leoheck/mangoh-red/datasheet/HTB1M6fvIVXXXXc2XXXXq6xXFXXXB.jpg

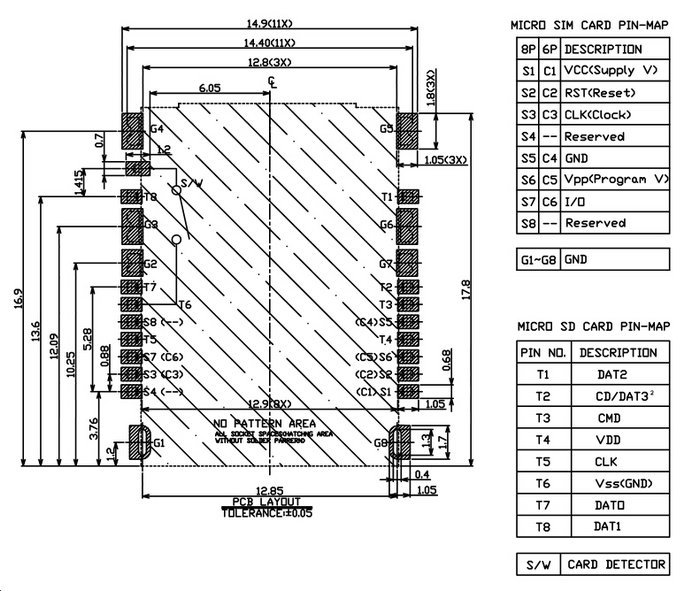
datasheet/HTB1M6fvIVXXXXc2XXXXq6xXFXXXB.jpg
