leoheck/mangoh-red/parts_with_price.csv

Ref | Arena Link | Category | Characteristics | Commodity Class | Created Date | Description | DXDB_LIBNAME | Effective Date | Footprint | Halogen Free | Manufacturer 1 | Manufacturer 1 PN | Manufacturer 2 | Manufacturer 2 PN | Manufacturer 3 | Manufacturer 3 PN | Manufacturer 4 | Manufacturer 4 PN | Manufacturer 5 | Manufacturer 5 PN | Owner | Part Height | Part Status | Rating | Requestor | Revision | RoHS Compliant | Temperature Range | Tolerance | Value | Variant Variable Text | Voltage | Price
ANT1000 | https://agiledev.sierrawireless.local/Agile/object/Parts/3015338 | Antenna |  | ANT - ANTENNAS | 2017-01-31T19:24:40Z | ANTENNA, BLUETOOTH/WLAN/WiFi, 2.4GHz, CERAMIC CHIP, 3.2x1.6x1.1mm | Antenna |  | ANT_3P_0320x0160_W3008C | N/A | TAOGLAS WLA.01 | WLA.01 |  |  |  |  |  |  |  |  |  | 1.1mm | Prototype |  | Ashish Syal | 1 | N/A | -40 +85C |  | WLA.01 |  |  | 0.0
C1000 | https://app.bom.com/a/N5O6P9S9SBU5DYQF?v=files.associations | Capacitor | X7R | PAS - Passives | 2008-08-21T16:59:08-08:00 | CAP, 100nF, 16V, 10%, X7R, CERAMIC, 0402 | Capacitor | 2012-02-01T15:49:25-08:00 | 0402C | N/A | NIC COMPONENTS NMC0402X7R104K16TRPF | NMC0402X7R104K16TRPF | MURATA GRM155R71C104KA88D | GRM155R71C104KA88D | VISHAY VJ0402V104ZXJCW1BC | VJ0402V104ZXJCW1BC |  |  |  |  | Morris Chau | 0.55mm | Production |  | Airlink | 2 | N/A | -55 +125C | 10% | 100nF |  | 16V | 0.0
C1001 | https://app.bom.com/a/VDWEXH0H0J2JWE3S?v=files.associations | Capacitor | X5R | PAS - Passives | 2006-01-26T19:30:31-08:00 | CAP, 470nF, 6.3V, 10%, X5R, CERAMIC, 0402 | Capacitor | 2015-09-02T00:10:34-08:00 | 0402C | N/A | MURATA GRM155R60J474KE19D | GRM155R60J474KE19D | TAIYO YUDEN RM JMK105BJ474KV-F | RM JMK105BJ474KV-F |  |  |  |  |  |  | Morris Chau | 0.55mm | Production |  | Vivutha Men | 1.1 | N/A | -55 +85C | 10% | 470nF |  | 6.3V | 0.0
C1002 | https://app.bom.com/a/N5O6P9S9SBUCLHCA?v=files.associations | Capacitor | C0G | PAS - Passives | 2004-12-21T10:56:53-08:00 | CAP, 10pF, 50V, 5%, C0G, CERAMIC, 0402 | Capacitor | 2012-03-16T13:58:58-08:00 | 0402C | N/A | MURATA GRM1555C1H100JA01D | GRM1555C1H100JA01D | TAIYO YUDEN UMK105CG100JV-F | UMK105CG100JV-F |  |  |  |  |  |  | Morris Chau | 0.55mm | Production |  | Kevin Dotzler | 2 | N/A | -55 +125C | 5% | 10pF | DNI | 50V | 0.0
C1003 | https://app.bom.com/a/N5O6P9S9SBU5DYQF?v=files.associations | Capacitor | X7R | PAS - Passives | 2008-08-21T16:59:08-08:00 | CAP, 100nF, 16V, 10%, X7R, CERAMIC, 0402 | Capacitor | 2012-02-01T15:49:25-08:00 | 0402C | N/A | NIC COMPONENTS NMC0402X7R104K16TRPF | NMC0402X7R104K16TRPF | MURATA GRM155R71C104KA88D | GRM155R71C104KA88D | VISHAY VJ0402V104ZXJCW1BC | VJ0402V104ZXJCW1BC |  |  |  |  | Morris Chau | 0.55mm | Production |  | Airlink | 2 | N/A | -55 +125C | 10% | 100nF |  | 16V | 0.0
C1004 | https://app.bom.com/a/VDWEXH0H0J2JWE3S?v=files.associations | Capacitor | X5R | PAS - Passives | 2006-01-26T19:30:31-08:00 | CAP, 470nF, 6.3V, 10%, X5R, CERAMIC, 0402 | Capacitor | 2015-09-02T00:10:34-08:00 | 0402C | N/A | MURATA GRM155R60J474KE19D | GRM155R60J474KE19D | TAIYO YUDEN RM JMK105BJ474KV-F | RM JMK105BJ474KV-F |  |  |  |  |  |  | Morris Chau | 0.55mm | Production |  | Vivutha Men | 1.1 | N/A | -55 +85C | 10% | 470nF |  | 6.3V | 0.0
C1005 | https://app.bom.com/a/6O7P8SBSBUUI7096?v=files.associations | Capacitor | X5R | PAS - Passives | 2014-03-26T03:32:53-08:00 | CAP, 10uF, 10V, 20%, X5R, CERAMIC, 0603 | Capacitor | 2014-03-26T03:37:12-08:00 | 0603C | N/A | MURATA GRM188R61A106ME69D | GRM188R61A106ME69D |  |  |  |  |  |  |  |  | Morris Chau | 0.95mm | Design |  | Mohamed Ammari | A | N/A | -55 +85C | 20% | 10uF |  | 6.3V | 0.0
C1006 | https://app.bom.com/a/J1K2L5O5O7OCQRFG?v=files.associations | Capacitor | C0G | PAS - Passives | 2011-05-10T11:01:38-08:00 | CAP, 100pF, 50V, 5%, C0G, CERAMIC, 0402 | Capacitor | 2014-04-28T09:22:48-08:00 | 0402C |  | MURATA GRM1555C1H101JA01D | GRM1555C1H101JA01D | TAIYO YUDEN UMK105CG101JV-F | UMK105CG101JV-F |  |  |  |  |  |  | Michael Sorensen | 0.55mm | Production |  | Michael Sorensen | 1 |  | -55 +125C | 5% | 100pF |  | 50V | 0.0
C1007 | https://app.bom.com/a/N5O6P9S9SBU5DYQF?v=files.associations | Capacitor | X7R | PAS - Passives | 2008-08-21T16:59:08-08:00 | CAP, 100nF, 16V, 10%, X7R, CERAMIC, 0402 | Capacitor | 2012-02-01T15:49:25-08:00 | 0402C | N/A | NIC COMPONENTS NMC0402X7R104K16TRPF | NMC0402X7R104K16TRPF | MURATA GRM155R71C104KA88D | GRM155R71C104KA88D | VISHAY VJ0402V104ZXJCW1BC | VJ0402V104ZXJCW1BC |  |  |  |  | Morris Chau | 0.55mm | Production |  | Airlink | 2 | N/A | -55 +125C | 10% | 100nF |  | 16V | 0.0
C1008 | https://app.bom.com/a/HZI0J3M3M55TNBEX?v=files.associations | Capacitor | X5R | PAS - Passives | 2014-03-16T19:32:12-08:00 | CAP, 4.7uF, 6.3V, 20%, X5R, CERAMIC, 0402 | Capacitor | 2014-06-06T08:29:17-08:00 | 0402C | N/A | MURATA GRM155R60J475ME87D | GRM155R60J475ME87D | TAIYO YUDEN JMK105BBJ475MV-F | JMK105BBJ475MV-F |  |  |  |  |  |  | Morris Chau | 0.65mm | Production |  | King Au Yeung | 1 | N/A | -55 +85C | 20% | 4.7uF |  | 6.3V | 0.0
C1009 | https://app.bom.com/a/HZI0J3M3M55TNBEX?v=files.associations | Capacitor | X5R | PAS - Passives | 2014-03-16T19:32:12-08:00 | CAP, 4.7uF, 6.3V, 20%, X5R, CERAMIC, 0402 | Capacitor | 2014-06-06T08:29:17-08:00 | 0402C | N/A | MURATA GRM155R60J475ME87D | GRM155R60J475ME87D | TAIYO YUDEN JMK105BBJ475MV-F | JMK105BBJ475MV-F |  |  |  |  |  |  | Morris Chau | 0.65mm | Production |  | King Au Yeung | 1 | N/A | -55 +85C | 20% | 4.7uF | DNI | 6.3V | 0.0
C1010 | https://app.bom.com/a/UCVDWGZGZI1IUB6T?v=files.associations | Capacitor | X5R | PAS - Passives | 2006-02-03T15:26:24-08:00 | CAP, 2.2uF, 6.3V, 10%, X5R, CERAMIC, 0603 | Capacitor | 2011-12-02T13:52:33-08:00 | 0603C | N/A | TAIYO YUDEN CE JMK107BJ225KA-T | CE JMK107BJ225KA-T | MURATA GRM188R60J225KE19D | GRM188R60J225KE19D |  |  |  |  |  |  | Morris Chau | 0.9mm | Production |  | Mack Tan | 2 | N/A | -55 +85C | 10% | 2.2uF |  | 6.3V | 0.0
C1011 | https://app.bom.com/a/6O7P8SBSBUDMZMOD?v=files.associations | Capacitor | X5R | PAS - Passives | 2009-03-11T13:25:27-08:00 | CAP, 1uF, 10V, 10%, X5R, CERAMIC, 0402 | Capacitor | 2014-03-12T04:39:29-08:00 | 0402C | N/A | MURATA GRM155R61A105KE15D | GRM155R61A105KE15D | TAIYO YUDEN LMK105BJ105KV-F | LMK105BJ105KV-F |  |  |  |  |  |  | Morris Chau | 0.55mm | Production |  | Kristi Eng | 2 | N/A | -55 +85C | 10% | 1uF |  | 10V | 0.0
C1012 | https://app.bom.com/a/N5O6P9S9SBU5DYQF?v=files.associations | Capacitor | X7R | PAS - Passives | 2008-08-21T16:59:08-08:00 | CAP, 100nF, 16V, 10%, X7R, CERAMIC, 0402 | Capacitor | 2012-02-01T15:49:25-08:00 | 0402C | N/A | NIC COMPONENTS NMC0402X7R104K16TRPF | NMC0402X7R104K16TRPF | MURATA GRM155R71C104KA88D | GRM155R71C104KA88D | VISHAY VJ0402V104ZXJCW1BC | VJ0402V104ZXJCW1BC |  |  |  |  | Morris Chau | 0.55mm | Production |  | Airlink | 2 | N/A | -55 +125C | 10% | 100nF |  | 16V | 0.0
C1013 | https://app.bom.com/a/6O7P8SBSBUUI7096?v=files.associations | Capacitor | X5R | PAS - Passives | 2014-03-26T03:32:53-08:00 | CAP, 10uF, 10V, 20%, X5R, CERAMIC, 0603 | Capacitor | 2014-03-26T03:37:12-08:00 | 0603C | N/A | MURATA GRM188R61A106ME69D | GRM188R61A106ME69D |  |  |  |  |  |  |  |  | Morris Chau | 0.95mm | Design |  | Mohamed Ammari | A | N/A | -55 +85C | 20% | 10uF |  | 6.3V | 0.0
C1014 | https://app.bom.com/a/N5O6P9S9SBU5DYQF?v=files.associations | Capacitor | X7R | PAS - Passives | 2008-08-21T16:59:08-08:00 | CAP, 100nF, 16V, 10%, X7R, CERAMIC, 0402 | Capacitor | 2012-02-01T15:49:25-08:00 | 0402C | N/A | NIC COMPONENTS NMC0402X7R104K16TRPF | NMC0402X7R104K16TRPF | MURATA GRM155R71C104KA88D | GRM155R71C104KA88D | VISHAY VJ0402V104ZXJCW1BC | VJ0402V104ZXJCW1BC |  |  |  |  | Morris Chau | 0.55mm | Production |  | Airlink | 2 | N/A | -55 +125C | 10% | 100nF |  | 16V | 0.0
C1015 | https://app.bom.com/a/DVEWFZIZI1I6KLAM?v=files.associations | Capacitor | X7R | PAS - Passives | 2011-05-10T11:00:32-08:00 | CAP, 470pF, 50V, 10%, X7R, CERAMIC, 0402 | Capacitor | 2015-06-16T18:03:21-08:00 | 0402C |  | MURATA GRM155R71H471KA01D | GRM155R71H471KA01D | TAIYO YUDEN UMK105BJ471KV-F | UMK105BJ471KV-F |  |  |  |  |  |  | Michael Sorensen | 0.55mm | Production |  | Michael Sorensen | 1 |  | -55 +125C | 10% | 470pF |  | 50V | 0.0
C1016 | https://app.bom.com/a/6O7P8SBSBUDMZMOD?v=files.associations | Capacitor | X5R | PAS - Passives | 2009-03-11T13:25:27-08:00 | CAP, 1uF, 10V, 10%, X5R, CERAMIC, 0402 | Capacitor | 2014-03-12T04:39:29-08:00 | 0402C | N/A | MURATA GRM155R61A105KE15D | GRM155R61A105KE15D | TAIYO YUDEN LMK105BJ105KV-F | LMK105BJ105KV-F |  |  |  |  |  |  | Morris Chau | 0.55mm | Production |  | Kristi Eng | 2 | N/A | -55 +85C | 10% | 1uF |  | 10V | 0.0
C1017 | https://app.bom.com/a/6O7P8SBSBUUI7096?v=files.associations | Capacitor | X5R | PAS - Passives | 2014-03-26T03:32:53-08:00 | CAP, 10uF, 10V, 20%, X5R, CERAMIC, 0603 | Capacitor | 2014-03-26T03:37:12-08:00 | 0603C | N/A | MURATA GRM188R61A106ME69D | GRM188R61A106ME69D |  |  |  |  |  |  |  |  | Morris Chau | 0.95mm | Design |  | Mohamed Ammari | A | N/A | -55 +85C | 20% | 10uF |  | 6.3V | 0.0
C1018 | https://app.bom.com/a/6O7P8SBSBUDMZMOD?v=files.associations | Capacitor | X5R | PAS - Passives | 2009-03-11T13:25:27-08:00 | CAP, 1uF, 10V, 10%, X5R, CERAMIC, 0402 | Capacitor | 2014-03-12T04:39:29-08:00 | 0402C | N/A | MURATA GRM155R61A105KE15D | GRM155R61A105KE15D | TAIYO YUDEN LMK105BJ105KV-F | LMK105BJ105KV-F |  |  |  |  |  |  | Morris Chau | 0.55mm | Production |  | Kristi Eng | 2 | N/A | -55 +85C | 10% | 1uF |  | 10V | 0.0
C1019 | https://app.bom.com/a/J1K2L5O5O7OCQRFG?v=files.associations | Capacitor | C0G | PAS - Passives | 2011-05-10T11:01:38-08:00 | CAP, 100pF, 50V, 5%, C0G, CERAMIC, 0402 | Capacitor | 2014-04-28T09:22:48-08:00 | 0402C |  | MURATA GRM1555C1H101JA01D | GRM1555C1H101JA01D | TAIYO YUDEN UMK105CG101JV-F | UMK105CG101JV-F |  |  |  |  |  |  | Michael Sorensen | 0.55mm | Production |  | Michael Sorensen | 1 |  | -55 +125C | 5% | 100pF |  | 50V | 0.0
C1020 | https://app.bom.com/a/N5O6P9S9SBU5DYQF?v=files.associations | Capacitor | X7R | PAS - Passives | 2008-08-21T16:59:08-08:00 | CAP, 100nF, 16V, 10%, X7R, CERAMIC, 0402 | Capacitor | 2012-02-01T15:49:25-08:00 | 0402C | N/A | NIC COMPONENTS NMC0402X7R104K16TRPF | NMC0402X7R104K16TRPF | MURATA GRM155R71C104KA88D | GRM155R71C104KA88D | VISHAY VJ0402V104ZXJCW1BC | VJ0402V104ZXJCW1BC |  |  |  |  | Morris Chau | 0.55mm | Production |  | Airlink | 2 | N/A | -55 +125C | 10% | 100nF |  | 16V | 0.0
C1021 | https://app.bom.com/a/6O7P8SBSBUDMZMOD?v=files.associations | Capacitor | X5R | PAS - Passives | 2009-03-11T13:25:27-08:00 | CAP, 1uF, 10V, 10%, X5R, CERAMIC, 0402 | Capacitor | 2014-03-12T04:39:29-08:00 | 0402C | N/A | MURATA GRM155R61A105KE15D | GRM155R61A105KE15D | TAIYO YUDEN LMK105BJ105KV-F | LMK105BJ105KV-F |  |  |  |  |  |  | Morris Chau | 0.55mm | Production |  | Kristi Eng | 2 | N/A | -55 +85C | 10% | 1uF |  | 10V | 0.0
C1022 | https://app.bom.com/a/UCVDWGZGZI1IUB6T?v=files.associations | Capacitor | X5R | PAS - Passives | 2006-02-03T15:26:24-08:00 | CAP, 2.2uF, 6.3V, 10%, X5R, CERAMIC, 0603 | Capacitor | 2011-12-02T13:52:33-08:00 | 0603C | N/A | TAIYO YUDEN CE JMK107BJ225KA-T | CE JMK107BJ225KA-T | MURATA GRM188R60J225KE19D | GRM188R60J225KE19D |  |  |  |  |  |  | Morris Chau | 0.9mm | Production |  | Mack Tan | 2 | N/A | -55 +85C | 10% | 2.2uF |  | 6.3V | 0.0
C1023 | https://app.bom.com/a/UCVDWGZGZI1IUB6T?v=files.associations | Capacitor | X5R | PAS - Passives | 2006-02-03T15:26:24-08:00 | CAP, 2.2uF, 6.3V, 10%, X5R, CERAMIC, 0603 | Capacitor | 2011-12-02T13:52:33-08:00 | 0603C | N/A | TAIYO YUDEN CE JMK107BJ225KA-T | CE JMK107BJ225KA-T | MURATA GRM188R60J225KE19D | GRM188R60J225KE19D |  |  |  |  |  |  | Morris Chau | 0.9mm | Production |  | Mack Tan | 2 | N/A | -55 +85C | 10% | 2.2uF |  | 6.3V | 0.0
C1024 | https://app.bom.com/a/UCVDWGZGZI1IUB6T?v=files.associations | Capacitor | X5R | PAS - Passives | 2006-02-03T15:26:24-08:00 | CAP, 2.2uF, 6.3V, 10%, X5R, CERAMIC, 0603 | Capacitor | 2011-12-02T13:52:33-08:00 | 0603C | N/A | TAIYO YUDEN CE JMK107BJ225KA-T | CE JMK107BJ225KA-T | MURATA GRM188R60J225KE19D | GRM188R60J225KE19D |  |  |  |  |  |  | Morris Chau | 0.9mm | Production |  | Mack Tan | 2 | N/A | -55 +85C | 10% | 2.2uF |  | 6.3V | 0.0
C1025 | https://app.bom.com/a/HZI0J3M3M55TNBEX?v=files.associations | Capacitor | X5R | PAS - Passives | 2014-03-16T19:32:12-08:00 | CAP, 4.7uF, 6.3V, 20%, X5R, CERAMIC, 0402 | Capacitor | 2014-06-06T08:29:17-08:00 | 0402C | N/A | MURATA GRM155R60J475ME87D | GRM155R60J475ME87D | TAIYO YUDEN JMK105BBJ475MV-F | JMK105BBJ475MV-F |  |  |  |  |  |  | Morris Chau | 0.65mm | Production |  | King Au Yeung | 1 | N/A | -55 +85C | 20% | 4.7uF |  | 6.3V | 0.0
C1026 | https://app.bom.com/a/J1K2L5O5O7OCQRFG?v=files.associations | Capacitor | C0G | PAS - Passives | 2011-05-10T11:01:38-08:00 | CAP, 100pF, 50V, 5%, C0G, CERAMIC, 0402 | Capacitor | 2014-04-28T09:22:48-08:00 | 0402C |  | MURATA GRM1555C1H101JA01D | GRM1555C1H101JA01D | TAIYO YUDEN UMK105CG101JV-F | UMK105CG101JV-F |  |  |  |  |  |  | Michael Sorensen | 0.55mm | Production |  | Michael Sorensen | 1 |  | -55 +125C | 5% | 100pF |  | 50V | 0.0
C1027 | https://app.bom.com/a/N5O6P9S9SBUCLHCA?v=files.associations | Capacitor | C0G | PAS - Passives | 2004-12-21T10:56:53-08:00 | CAP, 10pF, 50V, 5%, C0G, CERAMIC, 0402 | Capacitor | 2012-03-16T13:58:58-08:00 | 0402C | N/A | MURATA GRM1555C1H100JA01D | GRM1555C1H100JA01D | TAIYO YUDEN UMK105CG100JV-F | UMK105CG100JV-F |  |  |  |  |  |  | Morris Chau | 0.55mm | Production |  | Kevin Dotzler | 2 | N/A | -55 +125C | 5% | 10pF |  | 50V | 0.0
C1028 | https://app.bom.com/a/N5O6P9S9SBUCLHCA?v=files.associations | Capacitor | C0G | PAS - Passives | 2004-12-21T10:56:53-08:00 | CAP, 10pF, 50V, 5%, C0G, CERAMIC, 0402 | Capacitor | 2012-03-16T13:58:58-08:00 | 0402C | N/A | MURATA GRM1555C1H100JA01D | GRM1555C1H100JA01D | TAIYO YUDEN UMK105CG100JV-F | UMK105CG100JV-F |  |  |  |  |  |  | Morris Chau | 0.55mm | Production |  | Kevin Dotzler | 2 | N/A | -55 +125C | 5% | 10pF |  | 50V | 0.0
C1029 | https://app.bom.com/a/N5O6P9S9SBUCLHCA?v=files.associations | Capacitor | C0G | PAS - Passives | 2004-12-21T10:56:53-08:00 | CAP, 10pF, 50V, 5%, C0G, CERAMIC, 0402 | Capacitor | 2012-03-16T13:58:58-08:00 | 0402C | N/A | MURATA GRM1555C1H100JA01D | GRM1555C1H100JA01D | TAIYO YUDEN UMK105CG100JV-F | UMK105CG100JV-F |  |  |  |  |  |  | Morris Chau | 0.55mm | Production |  | Kevin Dotzler | 2 | N/A | -55 +125C | 5% | 10pF |  | 50V | 0.0
C1030 | https://app.bom.com/a/J1K2L5O5O7OCQRFG?v=files.associations | Capacitor | C0G | PAS - Passives | 2011-05-10T11:01:38-08:00 | CAP, 100pF, 50V, 5%, C0G, CERAMIC, 0402 | Capacitor | 2014-04-28T09:22:48-08:00 | 0402C |  | MURATA GRM1555C1H101JA01D | GRM1555C1H101JA01D | TAIYO YUDEN UMK105CG101JV-F | UMK105CG101JV-F |  |  |  |  |  |  | Michael Sorensen | 0.55mm | Production |  | Michael Sorensen | 1 |  | -55 +125C | 5% | 100pF |  | 50V | 0.0
C1031 | https://app.bom.com/a/N5O6P9S9SBUCLHCA?v=files.associations | Capacitor | C0G | PAS - Passives | 2004-12-21T10:56:53-08:00 | CAP, 10pF, 50V, 5%, C0G, CERAMIC, 0402 | Capacitor | 2012-03-16T13:58:58-08:00 | 0402C | N/A | MURATA GRM1555C1H100JA01D | GRM1555C1H100JA01D | TAIYO YUDEN UMK105CG100JV-F | UMK105CG100JV-F |  |  |  |  |  |  | Morris Chau | 0.55mm | Production |  | Kevin Dotzler | 2 | N/A | -55 +125C | 5% | 10pF |  | 50V | 0.0
C1032 | https://app.bom.com/a/6O7P8SBSBUDMZMOD?v=files.associations | Capacitor | X5R | PAS - Passives | 2009-03-11T13:25:27-08:00 | CAP, 1uF, 10V, 10%, X5R, CERAMIC, 0402 | Capacitor | 2014-03-12T04:39:29-08:00 | 0402C | N/A | MURATA GRM155R61A105KE15D | GRM155R61A105KE15D | TAIYO YUDEN LMK105BJ105KV-F | LMK105BJ105KV-F |  |  |  |  |  |  | Morris Chau | 0.55mm | Production |  | Kristi Eng | 2 | N/A | -55 +85C | 10% | 1uF |  | 10V | 0.0
C1033 | https://app.bom.com/a/J1K2L5O5O7OCQRFG?v=files.associations | Capacitor | C0G | PAS - Passives | 2011-05-10T11:01:38-08:00 | CAP, 100pF, 50V, 5%, C0G, CERAMIC, 0402 | Capacitor | 2014-04-28T09:22:48-08:00 | 0402C |  | MURATA GRM1555C1H101JA01D | GRM1555C1H101JA01D | TAIYO YUDEN UMK105CG101JV-F | UMK105CG101JV-F |  |  |  |  |  |  | Michael Sorensen | 0.55mm | Production |  | Michael Sorensen | 1 |  | -55 +125C | 5% | 100pF |  | 50V | 0.0
C1034 | https://app.bom.com/a/4M5N6Q9Q9SBSJE5I?v=files.associations | Capacitor | C0G | PAS - Passives | 2006-08-30T06:12:56-08:00 | CAP, 1pF, 25V, +/-0.25pF, C0G, CERAMIC, 0201 | Capacitor | 2014-07-24T08:53:06-08:00 | 0201C | N/A | MURATA GRM0335C1E1R0CA01D | GRM0335C1E1R0CA01D | MURATA GRM0335C1E1R0CD01D | GRM0335C1E1R0CD01D | TAIYO YUDEN TMK063CG010CT-F | TMK063CG010CT-F |  |  |  |  | Morris Chau | 0.33mm | Production | Murata & Taiyo Yuden Dual Source SWI P/N | Mark Van Hoorebeke | 3 | N/A | -55 +125C | 0.25pF | 1pF |  | 25V | 0.0
C1035 | https://app.bom.com/a/0I1J2M5M5O7JDY2V?v=files.associations | Capacitor | C0G | PAS - Passives | 2008-06-18T11:38:59-08:00 | CAP, 1.5pF, 25V, +/-0.25pF, C0G, HI-Q, LOW LOSS, 0201 | Capacitor | 2015-08-27T02:32:55-08:00 | 0201C | N/A | MURATA GJM0335C1E1R5CB01 | GJM0335C1E1R5CB01 |  |  |  |  |  |  |  |  | Morris Chau | 0.33mm | Production | HI-Q, LOW LOSS | Mark Van Hoorebeke | 2 | N/A | -55 +125C | 0.25pF | 1.5pF | DNI | 25V | 0.0
C1036 | https://app.bom.com/a/0I1J2M5M5O7JDY2V?v=files.associations | Capacitor | C0G | PAS - Passives | 2008-06-18T11:38:59-08:00 | CAP, 1.5pF, 25V, +/-0.25pF, C0G, HI-Q, LOW LOSS, 0201 | Capacitor | 2015-08-27T02:32:55-08:00 | 0201C | N/A | MURATA GJM0335C1E1R5CB01 | GJM0335C1E1R5CB01 |  |  |  |  |  |  |  |  | Morris Chau | 0.33mm | Production | HI-Q, LOW LOSS | Mark Van Hoorebeke | 2 | N/A | -55 +125C | 0.25pF | 1.5pF | DNI | 25V | 0.0
C1037 | https://app.bom.com/a/N5O6P9S9SBB6FXFJ?v=files.associations | Capacitor | C0G | PAS - Passives | 2012-05-14T17:38:41-08:00 | CAP, 1.8pF, 25V, +/-0.03pF, C0G, HI-Q, LOW LOSS, 0201 | Capacitor | 2013-04-11T14:58:16-08:00 | 0201C | N/A | MURATA GJM0335C1E1R8RB12 | GJM0335C1E1R8RB12 |  |  |  |  |  |  |  |  | Morris Chau | 0.33mm | Production | HI-Q, LOW LOSS, LOW TOLERANCE | Paul Nysen | 1 | N/A | -55 +125C | 0.03pF | 1.8pF | DNI | 25V | 0.0
C1038 | https://app.bom.com/a/N5O6P9S9SBB6FXFJ?v=files.associations | Capacitor | C0G | PAS - Passives | 2012-05-14T17:38:41-08:00 | CAP, 1.8pF, 25V, +/-0.03pF, C0G, HI-Q, LOW LOSS, 0201 | Capacitor | 2013-04-11T14:58:16-08:00 | 0201C | N/A | MURATA GJM0335C1E1R8RB12 | GJM0335C1E1R8RB12 |  |  |  |  |  |  |  |  | Morris Chau | 0.33mm | Production | HI-Q, LOW LOSS, LOW TOLERANCE | Paul Nysen | 1 | N/A | -55 +125C | 0.03pF | 1.8pF | DNI | 25V | 0.0
C1039 | https://app.bom.com/a/0I1J2M5M5O7JDY2V?v=files.associations | Capacitor | C0G | PAS - Passives | 2008-06-18T11:38:59-08:00 | CAP, 1.5pF, 25V, +/-0.25pF, C0G, HI-Q, LOW LOSS, 0201 | Capacitor | 2015-08-27T02:32:55-08:00 | 0201C | N/A | MURATA GJM0335C1E1R5CB01 | GJM0335C1E1R5CB01 |  |  |  |  |  |  |  |  | Morris Chau | 0.33mm | Production | HI-Q, LOW LOSS | Mark Van Hoorebeke | 2 | N/A | -55 +125C | 0.25pF | 1.5pF | DNI | 25V | 0.0
C1045 | https://agiledev.sierrawireless.local/Agile/object/Parts/3001406 | Capacitor | C0G | PAS - PASSIVES | 2006-08-30T13:12:59Z | CAP, 10pF, 5%, 25V, C0G, CERAMIC, 0201 | Capacitor |  | 0201C | Compliant | TAIYO YUDEN TMK063CG100DT-F | TMK063CG100DT-F | MURATA GRM0335C1E100JD01D | GRM0335C1E100JD01D | TAIYO YUDEN TMK063CG100JT-F | TMK063CG100JT-F | MURATA GRM0335C1E100JA01D | GRM0335C1E100JA01D |  |  |  | 0.33mm | Production |  | Terrence Yue | 3 | Compliant | -55 +125C | 5% | 10pF | DNI | 25V | 0.0
C1053 | https://app.bom.com/a/0I1J2M5M5O7JDY2V?v=files.associations | Capacitor | C0G | PAS - Passives | 2008-06-18T11:38:59-08:00 | CAP, 1.5pF, 25V, +/-0.25pF, C0G, HI-Q, LOW LOSS, 0201 | Capacitor | 2015-08-27T02:32:55-08:00 | 0201C | N/A | MURATA GJM0335C1E1R5CB01 | GJM0335C1E1R5CB01 |  |  |  |  |  |  |  |  | Morris Chau | 0.33mm | Production | HI-Q, LOW LOSS | Mark Van Hoorebeke | 2 | N/A | -55 +125C | 0.25pF | 1.5pF | DNI | 25V | 0.0
C1060 | https://app.bom.com/a/9RASBVEVEXGXOJ78?v=files.associations | Capacitor | C0G | PAS - Passives | 2006-08-30T06:13:02-08:00 | CAP, 2.7pF, 25V, +/-0.1pF, C0G, 0201 | Capacitor | 2013-02-25T16:20:36-08:00 | 0201C | N/A | MURATA GRM0335C1E2R7BD01D | GRM0335C1E2R7BD01D | MURATA GRM0335C1E2R7BA01D | GRM0335C1E2R7BA01D |  |  |  |  |  |  | Morris Chau | 0.33mm | Production |  |  | 4 | N/A | -55 +125C | 0.1pF | 2.7pF |  | 25V | 0.0
C1061 | https://app.bom.com/a/O6P7QATATCVC434K?v=files.associations | Capacitor | X7R | PAS - Passives | 2006-08-21T22:05:36-08:00 | CAP, 100pF, 25V, 10%, X7R, CERAMIC, 0201 | Capacitor | 2015-06-02T16:11:15-08:00 | 0201C | N/A | MURATA GRM033R71E101KA01D | GRM033R71E101KA01D | NIC COMPONENTS NMC0201X7R101K25TRPF | NMC0201X7R101K25TRPF | TAIYO YUDEN TMK063BJ101KP-F | TMK063BJ101KP-F |  |  |  |  | Morris Chau | 0.33mm | Production |  | Rachel Wong | 2 | N/A | -55 +125C | 10% | 100pF |  | 25V | 0.0
C1063 | https://app.bom.com/a/0I1J2M5M5O7JDY2V?v=files.associations | Capacitor | C0G | PAS - Passives | 2008-06-18T11:38:59-08:00 | CAP, 1.5pF, 25V, +/-0.25pF, C0G, HI-Q, LOW LOSS, 0201 | Capacitor | 2015-08-27T02:32:55-08:00 | 0201C | N/A | MURATA GJM0335C1E1R5CB01 | GJM0335C1E1R5CB01 |  |  |  |  |  |  |  |  | Morris Chau | 0.33mm | Production | HI-Q, LOW LOSS | Mark Van Hoorebeke | 2 | N/A | -55 +125C | 0.25pF | 1.5pF |  | 25V | 0.0
C1065 | https://app.bom.com/a/0I1J2M5M5O7JDY2V?v=files.associations | Capacitor | C0G | PAS - Passives | 2008-06-18T11:38:59-08:00 | CAP, 1.5pF, 25V, +/-0.25pF, C0G, HI-Q, LOW LOSS, 0201 | Capacitor | 2015-08-27T02:32:55-08:00 | 0201C | N/A | MURATA GJM0335C1E1R5CB01 | GJM0335C1E1R5CB01 |  |  |  |  |  |  |  |  | Morris Chau | 0.33mm | Production | HI-Q, LOW LOSS | Mark Van Hoorebeke | 2 | N/A | -55 +125C | 0.25pF | 1.5pF | DNI | 25V | 0.0
C1087 | https://app.bom.com/a/8Q9RAUDUDWFRL6AX?v=files.associations | Capacitor | C0G | PAS - Passives | 2008-06-18T11:39:03-08:00 | CAP, 2.2pF, 25V, +/-0.25pF, C0G, HI-Q, LOW LOSS, 0201 | Capacitor | 2012-03-01T12:03:00-08:00 | 0201C | N/A | MURATA GJM0335C1E2R2CB01D | GJM0335C1E2R2CB01D |  |  |  |  |  |  |  |  | Morris Chau | 0.33mm | Design | HI-Q, LOW LOSS | Mark Van Hoorebeke | B | N/A | -55 +125C | 0.25pF | 2.2pF |  | 25V | 0.0
C1088 | https://agiledev.sierrawireless.local/Agile/object/Parts/3001406 | Capacitor | C0G | PAS - PASSIVES | 2006-08-30T13:12:59Z | CAP, 10pF, 5%, 25V, C0G, CERAMIC, 0201 | Capacitor |  | 0201C | Compliant | TAIYO YUDEN TMK063CG100DT-F | TMK063CG100DT-F | MURATA GRM0335C1E100JD01D | GRM0335C1E100JD01D | TAIYO YUDEN TMK063CG100JT-F | TMK063CG100JT-F | MURATA GRM0335C1E100JA01D | GRM0335C1E100JA01D |  |  |  | 0.33mm | Production |  | Terrence Yue | 3 | Compliant | -55 +125C | 5% | 10pF |  | 25V | 0.0
C1098 | https://agiledev.sierrawireless.local/Agile/object/Parts/3001406 | Capacitor | C0G | PAS - PASSIVES | 2006-08-30T13:12:59Z | CAP, 10pF, 5%, 25V, C0G, CERAMIC, 0201 | Capacitor |  | 0201C | Compliant | TAIYO YUDEN TMK063CG100DT-F | TMK063CG100DT-F | MURATA GRM0335C1E100JD01D | GRM0335C1E100JD01D | TAIYO YUDEN TMK063CG100JT-F | TMK063CG100JT-F | MURATA GRM0335C1E100JA01D | GRM0335C1E100JA01D |  |  |  | 0.33mm | Production |  | Terrence Yue | 3 | Compliant | -55 +125C | 5% | 10pF | DNI | 25V | 0.0
C1099 | https://agiledev.sierrawireless.local/Agile/object/Parts/3001406 | Capacitor | C0G | PAS - PASSIVES | 2006-08-30T13:12:59Z | CAP, 10pF, 5%, 25V, C0G, CERAMIC, 0201 | Capacitor |  | 0201C | Compliant | TAIYO YUDEN TMK063CG100DT-F | TMK063CG100DT-F | MURATA GRM0335C1E100JD01D | GRM0335C1E100JD01D | TAIYO YUDEN TMK063CG100JT-F | TMK063CG100JT-F | MURATA GRM0335C1E100JA01D | GRM0335C1E100JA01D |  |  |  | 0.33mm | Production |  | Terrence Yue | 3 | Compliant | -55 +125C | 5% | 10pF | DNI | 25V | 0.0
C1100 | https://app.bom.com/a/M4N5O8R8RATAPPC5?v=files.associations | Capacitor | C0G | PAS - Passives | 2006-01-06T11:10:21-08:00 | CAP, 3.9pF, 50V, +/-0.25pF, C0G, CERAMIC, 0402 | Capacitor | 2013-06-12T11:21:27-08:00 | 0402C | N/A | MURATA GRM1555C1H3R9CA01D | GRM1555C1H3R9CA01D |  |  |  |  |  |  |  |  | Morris Chau | 0.55mm | Production |  | Joseph Gottfried | 3 | N/A | -55 +125C | 0.25pF | 3.9pF |  | 50V | 0.0
C203 | https://app.bom.com/a/0I1J2M5M5O7PYUOT?v=files.associations | Capacitor | C0G | PAS - Passives | 2004-12-21T10:56:54-08:00 | CAP, 22pF, 50V, 5%, C0G, CERAMIC, 0402 | Capacitor | 2015-11-04T10:59:46-08:00 | 0402C | N/A | MURATA GRM1555C1H220JA01D | GRM1555C1H220JA01D | TAIYO YUDEN UMK105CG220JV-F | UMK105CG220JV-F |  |  |  |  |  |  | Morris Chau | 0.55mm | Production |  | Kevin Dotzler | 1.2 | N/A | -55 +125C | 5% | 22pF |  | 50V | 0.0
C204 | https://app.bom.com/a/0I1J2M5M5O7PYUOT?v=files.associations | Capacitor | C0G | PAS - Passives | 2004-12-21T10:56:54-08:00 | CAP, 22pF, 50V, 5%, C0G, CERAMIC, 0402 | Capacitor | 2015-11-04T10:59:46-08:00 | 0402C | N/A | MURATA GRM1555C1H220JA01D | GRM1555C1H220JA01D | TAIYO YUDEN UMK105CG220JV-F | UMK105CG220JV-F |  |  |  |  |  |  | Morris Chau | 0.55mm | Production |  | Kevin Dotzler | 1.2 | N/A | -55 +125C | 5% | 22pF |  | 50V | 0.0
C205 | https://app.bom.com/a/0I1J2M5M5O7PYUOT?v=files.associations | Capacitor | C0G | PAS - Passives | 2004-12-21T10:56:54-08:00 | CAP, 22pF, 50V, 5%, C0G, CERAMIC, 0402 | Capacitor | 2015-11-04T10:59:46-08:00 | 0402C | N/A | MURATA GRM1555C1H220JA01D | GRM1555C1H220JA01D | TAIYO YUDEN UMK105CG220JV-F | UMK105CG220JV-F |  |  |  |  |  |  | Morris Chau | 0.55mm | Production |  | Kevin Dotzler | 1.2 | N/A | -55 +125C | 5% | 22pF |  | 50V | 0.0
C210 | https://app.bom.com/a/0I1J2M5M5O7PYUOT?v=files.associations | Capacitor | C0G | PAS - Passives | 2004-12-21T10:56:54-08:00 | CAP, 22pF, 50V, 5%, C0G, CERAMIC, 0402 | Capacitor | 2015-11-04T10:59:46-08:00 | 0402C | N/A | MURATA GRM1555C1H220JA01D | GRM1555C1H220JA01D | TAIYO YUDEN UMK105CG220JV-F | UMK105CG220JV-F |  |  |  |  |  |  | Morris Chau | 0.55mm | Production |  | Kevin Dotzler | 1.2 | N/A | -55 +125C | 5% | 22pF |  | 50V | 0.0
C211 | https://app.bom.com/a/0I1J2M5M5O7PYUOT?v=files.associations | Capacitor | C0G | PAS - Passives | 2004-12-21T10:56:54-08:00 | CAP, 22pF, 50V, 5%, C0G, CERAMIC, 0402 | Capacitor | 2015-11-04T10:59:46-08:00 | 0402C | N/A | MURATA GRM1555C1H220JA01D | GRM1555C1H220JA01D | TAIYO YUDEN UMK105CG220JV-F | UMK105CG220JV-F |  |  |  |  |  |  | Morris Chau | 0.55mm | Production |  | Kevin Dotzler | 1.2 | N/A | -55 +125C | 5% | 22pF |  | 50V | 0.0
C212 | https://app.bom.com/a/0I1J2M5M5O7PYUOT?v=files.associations | Capacitor | C0G | PAS - Passives | 2004-12-21T10:56:54-08:00 | CAP, 22pF, 50V, 5%, C0G, CERAMIC, 0402 | Capacitor | 2015-11-04T10:59:46-08:00 | 0402C | N/A | MURATA GRM1555C1H220JA01D | GRM1555C1H220JA01D | TAIYO YUDEN UMK105CG220JV-F | UMK105CG220JV-F |  |  |  |  |  |  | Morris Chau | 0.55mm | Production |  | Kevin Dotzler | 1.2 | N/A | -55 +125C | 5% | 22pF |  | 50V | 0.0
C213 | https://app.bom.com/a/0I1J2M5M5O7PYUOT?v=files.associations | Capacitor | C0G | PAS - Passives | 2004-12-21T10:56:54-08:00 | CAP, 22pF, 50V, 5%, C0G, CERAMIC, 0402 | Capacitor | 2015-11-04T10:59:46-08:00 | 0402C | N/A | MURATA GRM1555C1H220JA01D | GRM1555C1H220JA01D | TAIYO YUDEN UMK105CG220JV-F | UMK105CG220JV-F |  |  |  |  |  |  | Morris Chau | 0.55mm | Production |  | Kevin Dotzler | 1.2 | N/A | -55 +125C | 5% | 22pF |  | 50V | 0.0
C216 | https://app.bom.com/a/Q8R9SCVCVEXFOKFQ?v=files.associations | Capacitor | C0G | PAS - Passives | 2004-12-21T10:56:53-08:00 | CAP, 12pF, 50V, 5%, C0G, 0402 | Capacitor | 2014-04-16T04:17:45-08:00 | 0402C | N/A | MURATA GRM1555C1H120JA01D | GRM1555C1H120JA01D | PANASONIC ECJ0EC1H120J | ECJ0EC1H120J | ROHM MCH155A120JK | MCH155A120JK | TAIYO YUDEN UMK105CG120JV-F | UMK105CG120JV-F |  |  | Morris Chau | 0.55mm | Production |  | Kevin Dotzler | 2 | N/A | -55 +125C | 5% | 12pF |  | 50V | 0.0
C219 | https://app.bom.com/a/Q8R9SCVCVEXFOKFQ?v=files.associations | Capacitor | C0G | PAS - Passives | 2004-12-21T10:56:53-08:00 | CAP, 12pF, 50V, 5%, C0G, 0402 | Capacitor | 2014-04-16T04:17:45-08:00 | 0402C | N/A | MURATA GRM1555C1H120JA01D | GRM1555C1H120JA01D | PANASONIC ECJ0EC1H120J | ECJ0EC1H120J | ROHM MCH155A120JK | MCH155A120JK | TAIYO YUDEN UMK105CG120JV-F | UMK105CG120JV-F |  |  | Morris Chau | 0.55mm | Production |  | Kevin Dotzler | 2 | N/A | -55 +125C | 5% | 12pF |  | 50V | 0.0
C220 | https://app.bom.com/a/0I1J2M5M5O7PYUOT?v=files.associations | Capacitor | C0G | PAS - Passives | 2004-12-21T10:56:54-08:00 | CAP, 22pF, 50V, 5%, C0G, CERAMIC, 0402 | Capacitor | 2015-11-04T10:59:46-08:00 | 0402C | N/A | MURATA GRM1555C1H220JA01D | GRM1555C1H220JA01D | TAIYO YUDEN UMK105CG220JV-F | UMK105CG220JV-F |  |  |  |  |  |  | Morris Chau | 0.55mm | Production |  | Kevin Dotzler | 1.2 | N/A | -55 +125C | 5% | 22pF |  | 50V | 0.0
C221 | https://app.bom.com/a/0I1J2M5M5O7PYUOT?v=files.associations | Capacitor | C0G | PAS - Passives | 2004-12-21T10:56:54-08:00 | CAP, 22pF, 50V, 5%, C0G, CERAMIC, 0402 | Capacitor | 2015-11-04T10:59:46-08:00 | 0402C | N/A | MURATA GRM1555C1H220JA01D | GRM1555C1H220JA01D | TAIYO YUDEN UMK105CG220JV-F | UMK105CG220JV-F |  |  |  |  |  |  | Morris Chau | 0.55mm | Production |  | Kevin Dotzler | 1.2 | N/A | -55 +125C | 5% | 22pF |  | 50V | 0.0
C222 | https://app.bom.com/a/0I1J2M5M5O7PYUOT?v=files.associations | Capacitor | C0G | PAS - Passives | 2004-12-21T10:56:54-08:00 | CAP, 22pF, 50V, 5%, C0G, CERAMIC, 0402 | Capacitor | 2015-11-04T10:59:46-08:00 | 0402C | N/A | MURATA GRM1555C1H220JA01D | GRM1555C1H220JA01D | TAIYO YUDEN UMK105CG220JV-F | UMK105CG220JV-F |  |  |  |  |  |  | Morris Chau | 0.55mm | Production |  | Kevin Dotzler | 1.2 | N/A | -55 +125C | 5% | 22pF |  | 50V | 0.0
C223 | https://app.bom.com/a/0I1J2M5M5O7PYUOT?v=files.associations | Capacitor | C0G | PAS - Passives | 2004-12-21T10:56:54-08:00 | CAP, 22pF, 50V, 5%, C0G, CERAMIC, 0402 | Capacitor | 2015-11-04T10:59:46-08:00 | 0402C | N/A | MURATA GRM1555C1H220JA01D | GRM1555C1H220JA01D | TAIYO YUDEN UMK105CG220JV-F | UMK105CG220JV-F |  |  |  |  |  |  | Morris Chau | 0.55mm | Production |  | Kevin Dotzler | 1.2 | N/A | -55 +125C | 5% | 22pF |  | 50V | 0.0
C225 | https://app.bom.com/a/0I1J2M5M5O7PYUOT?v=files.associations | Capacitor | C0G | PAS - Passives | 2004-12-21T10:56:54-08:00 | CAP, 22pF, 50V, 5%, C0G, CERAMIC, 0402 | Capacitor | 2015-11-04T10:59:46-08:00 | 0402C | N/A | MURATA GRM1555C1H220JA01D | GRM1555C1H220JA01D | TAIYO YUDEN UMK105CG220JV-F | UMK105CG220JV-F |  |  |  |  |  |  | Morris Chau | 0.55mm | Production |  | Kevin Dotzler | 1.2 | N/A | -55 +125C | 5% | 22pF |  | 50V | 0.0
C226 | https://app.bom.com/a/0I1J2M5M5O7PYUOT?v=files.associations | Capacitor | C0G | PAS - Passives | 2004-12-21T10:56:54-08:00 | CAP, 22pF, 50V, 5%, C0G, CERAMIC, 0402 | Capacitor | 2015-11-04T10:59:46-08:00 | 0402C | N/A | MURATA GRM1555C1H220JA01D | GRM1555C1H220JA01D | TAIYO YUDEN UMK105CG220JV-F | UMK105CG220JV-F |  |  |  |  |  |  | Morris Chau | 0.55mm | Production |  | Kevin Dotzler | 1.2 | N/A | -55 +125C | 5% | 22pF |  | 50V | 0.0
C227 | https://app.bom.com/a/0I1J2M5M5O7PYUOT?v=files.associations | Capacitor | C0G | PAS - Passives | 2004-12-21T10:56:54-08:00 | CAP, 22pF, 50V, 5%, C0G, CERAMIC, 0402 | Capacitor | 2015-11-04T10:59:46-08:00 | 0402C | N/A | MURATA GRM1555C1H220JA01D | GRM1555C1H220JA01D | TAIYO YUDEN UMK105CG220JV-F | UMK105CG220JV-F |  |  |  |  |  |  | Morris Chau | 0.55mm | Production |  | Kevin Dotzler | 1.2 | N/A | -55 +125C | 5% | 22pF |  | 50V | 0.0
C228 | https://app.bom.com/a/0I1J2M5M5O7PYUOT?v=files.associations | Capacitor | C0G | PAS - Passives | 2004-12-21T10:56:54-08:00 | CAP, 22pF, 50V, 5%, C0G, CERAMIC, 0402 | Capacitor | 2015-11-04T10:59:46-08:00 | 0402C | N/A | MURATA GRM1555C1H220JA01D | GRM1555C1H220JA01D | TAIYO YUDEN UMK105CG220JV-F | UMK105CG220JV-F |  |  |  |  |  |  | Morris Chau | 0.55mm | Production |  | Kevin Dotzler | 1.2 | N/A | -55 +125C | 5% | 22pF |  | 50V | 0.0
C229 | https://app.bom.com/a/0I1J2M5M5O7PYUOT?v=files.associations | Capacitor | C0G | PAS - Passives | 2004-12-21T10:56:54-08:00 | CAP, 22pF, 50V, 5%, C0G, CERAMIC, 0402 | Capacitor | 2015-11-04T10:59:46-08:00 | 0402C | N/A | MURATA GRM1555C1H220JA01D | GRM1555C1H220JA01D | TAIYO YUDEN UMK105CG220JV-F | UMK105CG220JV-F |  |  |  |  |  |  | Morris Chau | 0.55mm | Production |  | Kevin Dotzler | 1.2 | N/A | -55 +125C | 5% | 22pF |  | 50V | 0.0
C230 | https://app.bom.com/a/0I1J2M5M5O7PYUOT?v=files.associations | Capacitor | C0G | PAS - Passives | 2004-12-21T10:56:54-08:00 | CAP, 22pF, 50V, 5%, C0G, CERAMIC, 0402 | Capacitor | 2015-11-04T10:59:46-08:00 | 0402C | N/A | MURATA GRM1555C1H220JA01D | GRM1555C1H220JA01D | TAIYO YUDEN UMK105CG220JV-F | UMK105CG220JV-F |  |  |  |  |  |  | Morris Chau | 0.55mm | Production |  | Kevin Dotzler | 1.2 | N/A | -55 +125C | 5% | 22pF |  | 50V | 0.0
C231 | https://app.bom.com/a/0I1J2M5M5O7PYUOT?v=files.associations | Capacitor | C0G | PAS - Passives | 2004-12-21T10:56:54-08:00 | CAP, 22pF, 50V, 5%, C0G, CERAMIC, 0402 | Capacitor | 2015-11-04T10:59:46-08:00 | 0402C | N/A | MURATA GRM1555C1H220JA01D | GRM1555C1H220JA01D | TAIYO YUDEN UMK105CG220JV-F | UMK105CG220JV-F |  |  |  |  |  |  | Morris Chau | 0.55mm | Production |  | Kevin Dotzler | 1.2 | N/A | -55 +125C | 5% | 22pF |  | 50V | 0.0
C250 | https://app.bom.com/a/SATBUEXEXGZHQMF9?v=files.associations | Capacitor | X7R | PAS - Passives | 2004-12-21T10:57:02-08:00 | CAP, 1nF, 50V, 10%, X7R, CERAMIC, 0402 | Capacitor | 2014-04-28T09:22:48-08:00 | 0402C | N/A | MURATA GRM155R71H102KA01D | GRM155R71H102KA01D | TAIYO YUDEN UMK105BJ102KV-F | UMK105BJ102KV-F |  |  |  |  |  |  | Morris Chau | 0.55mm | Production |  | Kevin Dotzler | 4 | N/A | -55 +125C | 10% | 1nF | DNI | 50V | 0.0
C288 | https://app.bom.com/a/N5O6P9S9SBU5DYQF?v=files.associations | Capacitor | X7R | PAS - Passives | 2008-08-21T16:59:08-08:00 | CAP, 100nF, 16V, 10%, X7R, CERAMIC, 0402 | Capacitor | 2012-02-01T15:49:25-08:00 | 0402C | N/A | NIC COMPONENTS NMC0402X7R104K16TRPF | NMC0402X7R104K16TRPF | MURATA GRM155R71C104KA88D | GRM155R71C104KA88D | VISHAY VJ0402V104ZXJCW1BC | VJ0402V104ZXJCW1BC |  |  |  |  | Morris Chau | 0.55mm | Production |  | Airlink | 2 | N/A | -55 +125C | 10% | 100nF |  | 16V | 0.0
C301 | https://app.bom.com/a/UCVDWGZGZI1JSOIV?v=files.associations | Capacitor | C0G | PAS - Passives | 2004-12-21T10:56:54-08:00 | CAP, 15pF, 50V, 5%, C0G, CERAMIC, 0402 | Capacitor | 2012-11-15T17:36:02-08:00 | 0402C | N/A | MURATA GRM1555C1H150JA01D | GRM1555C1H150JA01D | TAIYO YUDEN UMK105CG150JV-F | UMK105CG150JV-F |  |  |  |  |  |  | Morris Chau | 0.55mm | Production |  | Kevin Dotzler | 2 | N/A | -55 +125C | 5% | 15pF |  | 50V | 0.0
C302 | https://app.bom.com/a/4M5N6Q9Q9SSKOOFO?v=files.associations | Capacitor | X5R | PAS - Passives | 2013-02-27T02:12:35-08:00 | CAP, 47uF, 10V, 20%, X5R, CERAMIC, 1206 | Capacitor | 2013-03-04T23:56:40-08:00 | 1206C | N/A | MURATA GRM31CR61A476ME15L | GRM31CR61A476ME15L | TAIYO YUDEN LMK316BJ476ML-T | LMK316BJ476ML-T |  |  |  |  |  |  | Morris Chau | 1.8mm | Production |  | Derek Liu | 1 | N/A | -55 +85C | 20% | 47uF | DNI | 10V | 0.0
C304 | https://app.bom.com/a/6O7P8SBSBUUI7096?v=files.associations | Capacitor | X5R | PAS - Passives | 2014-03-26T03:32:53-08:00 | CAP, 10uF, 10V, 20%, X5R, CERAMIC, 0603 | Capacitor | 2014-03-26T03:37:12-08:00 | 0603C | N/A | MURATA GRM188R61A106ME69D | GRM188R61A106ME69D |  |  |  |  |  |  |  |  | Morris Chau | 0.95mm | Design |  | Mohamed Ammari | A | N/A | -55 +85C | 20% | 10uF |  | 6.3V | 0.0
C305 | https://app.bom.com/a/2K3L4O7O7Q7V9AYD?v=files.associations | Capacitor | X5R | PAS - Passives | 2011-05-10T11:01:11-08:00 | CAP, 100nF, 10V, 10%, X5R, CERAMIC, 0402 | Capacitor | 2013-11-26T22:59:31-08:00 | 0402C |  | MURATA GRM155R61A104KA01D | GRM155R61A104KA01D | TAIYO YUDEN LMK105BJ104KV-F | LMK105BJ104KV-F |  |  |  |  |  |  | Michael Sorensen | 0.55mm | Production |  | Michael Sorensen | 1 |  | -55 +85C | 10% | 100nF |  | 10V | 0.0
C306 | https://app.bom.com/a/HZI0J3M3M55TNBEX?v=files.associations | Capacitor | X5R | PAS - Passives | 2014-03-16T19:32:12-08:00 | CAP, 4.7uF, 6.3V, 20%, X5R, CERAMIC, 0402 | Capacitor | 2014-06-06T08:29:17-08:00 | 0402C | N/A | MURATA GRM155R60J475ME87D | GRM155R60J475ME87D | TAIYO YUDEN JMK105BBJ475MV-F | JMK105BBJ475MV-F |  |  |  |  |  |  | Morris Chau | 0.65mm | Production |  | King Au Yeung | 1 | N/A | -55 +85C | 20% | 4.7uF |  | 6.3V | 0.0
C307 | https://app.bom.com/a/2K3L4O7O7Q7V9AYD?v=files.associations | Capacitor | X5R | PAS - Passives | 2011-05-10T11:01:11-08:00 | CAP, 100nF, 10V, 10%, X5R, CERAMIC, 0402 | Capacitor | 2013-11-26T22:59:31-08:00 | 0402C |  | MURATA GRM155R61A104KA01D | GRM155R61A104KA01D | TAIYO YUDEN LMK105BJ104KV-F | LMK105BJ104KV-F |  |  |  |  |  |  | Michael Sorensen | 0.55mm | Production |  | Michael Sorensen | 1 |  | -55 +85C | 10% | 100nF |  | 10V | 0.0
C308 | https://app.bom.com/a/2K3L4O7O7Q9QNTDO?v=files.associations | Capacitor | X5R | PAS - Passives | 2006-06-23T05:25:15-08:00 | CAP, 4.7uF, 10V, 10%, X5R, CERAMIC, 0603 | Capacitor | 2014-04-29T00:34:09-08:00 | 0603C | N/A | MURATA GRM188R61A475KE15D | GRM188R61A475KE15D | NIC COMPONENTS NMC0603X5R475K10TRPF | NMC0603X5R475K10TRPF | SEMCO (Samsung Electro-Mechanics Co. Ltd) CL10A475KP8NNNC | CL10A475KP8NNNC | TAIYO YUDEN LMK107BJ475KA-T | LMK107BJ475KA-T |  |  | Morris Chau | 0.9mm | Production |  | Ryan Fallini | 3 | N/A | -55 +85C | 10% | 4.7uF |  | 10V | 0.0
C309 | https://app.bom.com/a/4M5N6Q9Q9SSKOOFO?v=files.associations | Capacitor | X5R | PAS - Passives | 2013-02-27T02:12:35-08:00 | CAP, 47uF, 10V, 20%, X5R, CERAMIC, 1206 | Capacitor | 2013-03-04T23:56:40-08:00 | 1206C | N/A | MURATA GRM31CR61A476ME15L | GRM31CR61A476ME15L | TAIYO YUDEN LMK316BJ476ML-T | LMK316BJ476ML-T |  |  |  |  |  |  | Morris Chau | 1.8mm | Production |  | Derek Liu | 1 | N/A | -55 +85C | 20% | 47uF |  | 10V | 0.0
C310 | https://app.bom.com/a/FXGYH1K1K3MXXVOO?v=files.associations | Capacitor | X5R | PAS - Passives | 2008-09-03T15:39:09-08:00 | CAP, 10uF, 6.3V, 20%, X5R, CERAMIC, 0603 | Capacitor | 2014-03-09T18:03:10-08:00 | 0603C | N/A | MURATA GRM188R60J106ME47D | GRM188R60J106ME47D | TAIYO YUDEN JMK107BJ106MA-T | JMK107BJ106MA-T |  |  |  |  |  |  | Morris Chau | 0.9mm | Production |  | Mark Van Hoorebeke | 2 | N/A | -55 +85C | 20% | 10uF |  | 6.3V | 0.0
C311 | https://app.bom.com/a/FXGYH1K1K3MXXVOO?v=files.associations | Capacitor | X5R | PAS - Passives | 2008-09-03T15:39:09-08:00 | CAP, 10uF, 6.3V, 20%, X5R, CERAMIC, 0603 | Capacitor | 2014-03-09T18:03:10-08:00 | 0603C | N/A | MURATA GRM188R60J106ME47D | GRM188R60J106ME47D | TAIYO YUDEN JMK107BJ106MA-T | JMK107BJ106MA-T |  |  |  |  |  |  | Morris Chau | 0.9mm | Production |  | Mark Van Hoorebeke | 2 | N/A | -55 +85C | 20% | 10uF |  | 6.3V | 0.0
C312 | https://app.bom.com/a/0I1J2M5M5O7PYUOT?v=files.associations | Capacitor | C0G | PAS - Passives | 2004-12-21T10:56:54-08:00 | CAP, 22pF, 50V, 5%, C0G, CERAMIC, 0402 | Capacitor | 2013-02-21T21:42:28-08:00 | 0402C | N/A | MURATA GRM1555C1H220JA01D | GRM1555C1H220JA01D | TAIYO YUDEN UMK105CG220JV-F | UMK105CG220JV-F |  |  |  |  |  |  | Morris Chau | 0.55mm | Production |  | Kevin Dotzler | 1.2 | N/A | -55 +125C | 5% | 22pF |  | 50V | 0.0
C318 | https://app.bom.com/a/6O7P8SBSBUUI7096?v=files.associations | Capacitor | X5R | PAS - Passives | 2014-03-26T03:32:53-08:00 | CAP, 10uF, 10V, 20%, X5R, CERAMIC, 0603 | Capacitor | 2014-03-26T03:37:12-08:00 | 0603C | N/A | MURATA GRM188R61A106ME69D | GRM188R61A106ME69D |  |  |  |  |  |  |  |  | Morris Chau | 0.95mm | Design |  | Mohamed Ammari | A | N/A | -55 +85C | 20% | 10uF |  | 6.3V | 0.0
C320 | https://app.bom.com/a/N5O6P9S9SBU5DYQF?v=files.associations | Capacitor | X7R | PAS - Passives | 2008-08-21T16:59:08-08:00 | CAP, 100nF, 16V, 10%, X7R, CERAMIC, 0402 | Capacitor | 2012-02-01T15:49:25-08:00 | 0402C | N/A | NIC COMPONENTS NMC0402X7R104K16TRPF | NMC0402X7R104K16TRPF | MURATA GRM155R71C104KA88D | GRM155R71C104KA88D | VISHAY VJ0402V104ZXJCW1BC | VJ0402V104ZXJCW1BC |  |  |  |  | Morris Chau | 0.55mm | Production |  | Airlink | 2 | N/A | -55 +125C | 10% | 100nF |  | 16V | 0.0
C321 | https://app.bom.com/a/N5O6P9S9SBU5DYQF?v=files.associations | Capacitor | X7R | PAS - Passives | 2008-08-21T16:59:08-08:00 | CAP, 100nF, 16V, 10%, X7R, CERAMIC, 0402 | Capacitor | 2012-02-01T15:49:25-08:00 | 0402C | N/A | NIC COMPONENTS NMC0402X7R104K16TRPF | NMC0402X7R104K16TRPF | MURATA GRM155R71C104KA88D | GRM155R71C104KA88D | VISHAY VJ0402V104ZXJCW1BC | VJ0402V104ZXJCW1BC |  |  |  |  | Morris Chau | 0.55mm | Production |  | Airlink | 2 | N/A | -55 +125C | 10% | 100nF |  | 16V | 0.0
C322 | https://app.bom.com/a/N5O6P9S9SBU5DYQF?v=files.associations | Capacitor | X7R | PAS - Passives | 2008-08-21T16:59:08-08:00 | CAP, 100nF, 16V, 10%, X7R, CERAMIC, 0402 | Capacitor | 2012-02-01T15:49:25-08:00 | 0402C | N/A | NIC COMPONENTS NMC0402X7R104K16TRPF | NMC0402X7R104K16TRPF | MURATA GRM155R71C104KA88D | GRM155R71C104KA88D | VISHAY VJ0402V104ZXJCW1BC | VJ0402V104ZXJCW1BC |  |  |  |  | Morris Chau | 0.55mm | Production |  | Airlink | 2 | N/A | -55 +125C | 10% | 100nF |  | 16V | 0.0
C330 | https://app.bom.com/a/CUDVEYHYH0J1A601?v=files.associations | Capacitor | C0G | PAS - Passives | 2004-12-21T10:56:56-08:00 | CAP, 47pF, 50V, 5%, C0G, CERAMIC, 0402 | Capacitor | 2013-02-21T21:42:28-08:00 | 0402C | N/A | MURATA GRM1555C1H470JA01D | GRM1555C1H470JA01D | TAIYO YUDEN UMK105CG470JV-F | UMK105CG470JV-F | ROHM MCH155A470JK | MCH155A470JK | PANASONIC ECJ0EC1H470J | ECJ0EC1H470J |  |  | Morris Chau | 0.55mm | Production |  | Kevin Dotzler | 1 | N/A | -55 +125C | 5% | 47pF |  | 50V | 0.0
C331 | https://app.bom.com/a/CUDVEYHYH0J1A601?v=files.associations | Capacitor | C0G | PAS - Passives | 2004-12-21T10:56:56-08:00 | CAP, 47pF, 50V, 5%, C0G, CERAMIC, 0402 | Capacitor | 2013-02-21T21:42:28-08:00 | 0402C | N/A | MURATA GRM1555C1H470JA01D | GRM1555C1H470JA01D | TAIYO YUDEN UMK105CG470JV-F | UMK105CG470JV-F | ROHM MCH155A470JK | MCH155A470JK | PANASONIC ECJ0EC1H470J | ECJ0EC1H470J |  |  | Morris Chau | 0.55mm | Production |  | Kevin Dotzler | 1 | N/A | -55 +125C | 5% | 47pF |  | 50V | 0.0
C355 | https://app.bom.com/a/N5O6P9S9SBU5DYQF?v=files.associations | Capacitor | X7R | PAS - Passives | 2008-08-21T16:59:08-08:00 | CAP, 100nF, 16V, 10%, X7R, CERAMIC, 0402 | Capacitor | 2012-02-01T15:49:25-08:00 | 0402C | N/A | NIC COMPONENTS NMC0402X7R104K16TRPF | NMC0402X7R104K16TRPF | MURATA GRM155R71C104KA88D | GRM155R71C104KA88D | VISHAY VJ0402V104ZXJCW1BC | VJ0402V104ZXJCW1BC |  |  |  |  | Morris Chau | 0.55mm | Production |  | Airlink | 2 | N/A | -55 +125C | 10% | 100nF |  | 16V | 0.0
C356 | https://app.bom.com/a/N5O6P9S9SBU5DYQF?v=files.associations | Capacitor | X7R | PAS - Passives | 2008-08-21T16:59:08-08:00 | CAP, 100nF, 16V, 10%, X7R, CERAMIC, 0402 | Capacitor | 2012-02-01T15:49:25-08:00 | 0402C | N/A | NIC COMPONENTS NMC0402X7R104K16TRPF | NMC0402X7R104K16TRPF | MURATA GRM155R71C104KA88D | GRM155R71C104KA88D | VISHAY VJ0402V104ZXJCW1BC | VJ0402V104ZXJCW1BC |  |  |  |  | Morris Chau | 0.55mm | Production |  | Airlink | 2 | N/A | -55 +125C | 10% | 100nF |  | 16V | 0.0
C360 | https://app.bom.com/a/N5O6P9S9SBU5DYQF?v=files.associations | Capacitor | X7R | PAS - Passives | 2008-08-21T16:59:08-08:00 | CAP, 100nF, 16V, 10%, X7R, CERAMIC, 0402 | Capacitor | 2012-02-01T15:49:25-08:00 | 0402C | N/A | NIC COMPONENTS NMC0402X7R104K16TRPF | NMC0402X7R104K16TRPF | MURATA GRM155R71C104KA88D | GRM155R71C104KA88D | VISHAY VJ0402V104ZXJCW1BC | VJ0402V104ZXJCW1BC |  |  |  |  | Morris Chau | 0.55mm | Production |  | Airlink | 2 | N/A | -55 +125C | 10% | 100nF |  | 16V | 0.0
C362 | https://app.bom.com/a/N5O6P9S9SBU5DYQF?v=files.associations | Capacitor | X7R | PAS - Passives | 2008-08-21T16:59:08-08:00 | CAP, 100nF, 16V, 10%, X7R, CERAMIC, 0402 | Capacitor | 2012-02-01T15:49:25-08:00 | 0402C | N/A | NIC COMPONENTS NMC0402X7R104K16TRPF | NMC0402X7R104K16TRPF | MURATA GRM155R71C104KA88D | GRM155R71C104KA88D | VISHAY VJ0402V104ZXJCW1BC | VJ0402V104ZXJCW1BC |  |  |  |  | Morris Chau | 0.55mm | Production |  | Airlink | 2 | N/A | -55 +125C | 10% | 100nF |  | 16V | 0.0
C400 | https://app.bom.com/a/N5O6P9S9SBU5DYQF?v=files.associations | Capacitor | X7R | PAS - Passives | 2008-08-21T16:59:08-08:00 | CAP, 100nF, 16V, 10%, X7R, CERAMIC, 0402 | Capacitor | 2012-02-01T15:49:25-08:00 | 0402C | N/A | NIC COMPONENTS NMC0402X7R104K16TRPF | NMC0402X7R104K16TRPF | MURATA GRM155R71C104KA88D | GRM155R71C104KA88D | VISHAY VJ0402V104ZXJCW1BC | VJ0402V104ZXJCW1BC |  |  |  |  | Morris Chau | 0.55mm | Production |  | Airlink | 2 | N/A | -55 +125C | 10% | 100nF |  | 16V | 0.0
C401 | https://app.bom.com/a/N5O6P9S9SBU5DYQF?v=files.associations | Capacitor | X7R | PAS - Passives | 2008-08-21T16:59:08-08:00 | CAP, 100nF, 16V, 10%, X7R, CERAMIC, 0402 | Capacitor | 2012-02-01T15:49:25-08:00 | 0402C | N/A | NIC COMPONENTS NMC0402X7R104K16TRPF | NMC0402X7R104K16TRPF | MURATA GRM155R71C104KA88D | GRM155R71C104KA88D | VISHAY VJ0402V104ZXJCW1BC | VJ0402V104ZXJCW1BC |  |  |  |  | Morris Chau | 0.55mm | Production |  | Airlink | 2 | N/A | -55 +125C | 10% | 100nF |  | 16V | 0.0
C402 | https://app.bom.com/a/N5O6P9S9SBU5DYQF?v=files.associations | Capacitor | X7R | PAS - Passives | 2008-08-21T16:59:08-08:00 | CAP, 100nF, 16V, 10%, X7R, CERAMIC, 0402 | Capacitor | 2012-02-01T15:49:25-08:00 | 0402C | N/A | NIC COMPONENTS NMC0402X7R104K16TRPF | NMC0402X7R104K16TRPF | MURATA GRM155R71C104KA88D | GRM155R71C104KA88D | VISHAY VJ0402V104ZXJCW1BC | VJ0402V104ZXJCW1BC |  |  |  |  | Morris Chau | 0.55mm | Production |  | Airlink | 2 | N/A | -55 +125C | 10% | 100nF |  | 16V | 0.0
C403 | https://app.bom.com/a/2K3L4O7O7Q7V9AYD?v=files.associations | Capacitor | X5R | PAS - Passives | 2011-05-10T11:01:11-08:00 | CAP, 100nF, 10V, 10%, X5R, CERAMIC, 0402 | Capacitor | 2013-11-26T22:59:31-08:00 | 0402C |  | MURATA GRM155R61A104KA01D | GRM155R61A104KA01D | TAIYO YUDEN LMK105BJ104KV-F | LMK105BJ104KV-F |  |  |  |  |  |  | Michael Sorensen | 0.55mm | Production |  | Michael Sorensen | 1 |  | -55 +85C | 10% | 100nF |  | 10V | 0.0
C404 | https://app.bom.com/a/2K3L4O7O7Q7V9AYD?v=files.associations | Capacitor | X5R | PAS - Passives | 2011-05-10T11:01:11-08:00 | CAP, 100nF, 10V, 10%, X5R, CERAMIC, 0402 | Capacitor | 2013-11-26T22:59:31-08:00 | 0402C |  | MURATA GRM155R61A104KA01D | GRM155R61A104KA01D | TAIYO YUDEN LMK105BJ104KV-F | LMK105BJ104KV-F |  |  |  |  |  |  | Michael Sorensen | 0.55mm | Production |  | Michael Sorensen | 1 |  | -55 +85C | 10% | 100nF |  | 10V | 0.0
C405 | https://app.bom.com/a/N5O6P9S9SBU5DYQF?v=files.associations | Capacitor | X7R | PAS - Passives | 2008-08-21T16:59:08-08:00 | CAP, 100nF, 16V, 10%, X7R, CERAMIC, 0402 | Capacitor | 2012-02-01T15:49:25-08:00 | 0402C | N/A | NIC COMPONENTS NMC0402X7R104K16TRPF | NMC0402X7R104K16TRPF | MURATA GRM155R71C104KA88D | GRM155R71C104KA88D | VISHAY VJ0402V104ZXJCW1BC | VJ0402V104ZXJCW1BC |  |  |  |  | Morris Chau | 0.55mm | Production |  | Airlink | 2 | N/A | -55 +125C | 10% | 100nF |  | 16V | 0.0
C406 | https://app.bom.com/a/N5O6P9S9SBU5DYQF?v=files.associations | Capacitor | X7R | PAS - Passives | 2008-08-21T16:59:08-08:00 | CAP, 100nF, 16V, 10%, X7R, CERAMIC, 0402 | Capacitor | 2012-02-01T15:49:25-08:00 | 0402C | N/A | NIC COMPONENTS NMC0402X7R104K16TRPF | NMC0402X7R104K16TRPF | MURATA GRM155R71C104KA88D | GRM155R71C104KA88D | VISHAY VJ0402V104ZXJCW1BC | VJ0402V104ZXJCW1BC |  |  |  |  | Morris Chau | 0.55mm | Production |  | Airlink | 2 | N/A | -55 +125C | 10% | 100nF |  | 16V | 0.0
C450 | https://app.bom.com/a/2K3L4O7O7Q7V9AYD?v=files.associations | Capacitor | X5R | PAS - Passives | 2011-05-10T11:01:11-08:00 | CAP, 100nF, 10V, 10%, X5R, CERAMIC, 0402 | Capacitor | 2013-11-26T22:59:31-08:00 | 0402C |  | MURATA GRM155R61A104KA01D | GRM155R61A104KA01D | TAIYO YUDEN LMK105BJ104KV-F | LMK105BJ104KV-F |  |  |  |  |  |  | Michael Sorensen | 0.55mm | Production |  | Michael Sorensen | 1 |  | -55 +85C | 10% | 100nF |  | 10V | 0.0
C500 | https://app.bom.com/a/J1K2L5O5O7OCQRFG?v=files.associations | Capacitor | C0G | PAS - Passives | 2011-05-10T11:01:38-08:00 | CAP, 100pF, 50V, 5%, C0G, CERAMIC, 0402 | Capacitor | 2014-04-28T09:22:48-08:00 | 0402C |  | MURATA GRM1555C1H101JA01D | GRM1555C1H101JA01D | TAIYO YUDEN UMK105CG101JV-F | UMK105CG101JV-F |  |  |  |  |  |  | Michael Sorensen | 0.55mm | Production |  | Michael Sorensen | 1 |  | -55 +125C | 5% | 100pF |  | 50V | 0.0
C501 | https://app.bom.com/a/J1K2L5O5O7OCQRFG?v=files.associations | Capacitor | C0G | PAS - Passives | 2011-05-10T11:01:38-08:00 | CAP, 100pF, 50V, 5%, C0G, CERAMIC, 0402 | Capacitor | 2014-04-28T09:22:48-08:00 | 0402C |  | MURATA GRM1555C1H101JA01D | GRM1555C1H101JA01D | TAIYO YUDEN UMK105CG101JV-F | UMK105CG101JV-F |  |  |  |  |  |  | Michael Sorensen | 0.55mm | Production |  | Michael Sorensen | 1 |  | -55 +125C | 5% | 100pF |  | 50V | 0.0
C502 | https://app.bom.com/a/J1K2L5O5O7OCQRFG?v=files.associations | Capacitor | C0G | PAS - Passives | 2011-05-10T11:01:38-08:00 | CAP, 100pF, 50V, 5%, C0G, CERAMIC, 0402 | Capacitor | 2014-04-28T09:22:48-08:00 | 0402C |  | MURATA GRM1555C1H101JA01D | GRM1555C1H101JA01D | TAIYO YUDEN UMK105CG101JV-F | UMK105CG101JV-F |  |  |  |  |  |  | Michael Sorensen | 0.55mm | Production |  | Michael Sorensen | 1 |  | -55 +125C | 5% | 100pF |  | 50V | 0.0
C503 | https://app.bom.com/a/6O7P8SBSBUDMZMOD?v=files.associations | Capacitor | X5R | PAS - Passives | 2009-03-11T13:25:27-08:00 | CAP, 1uF, 10V, 10%, X5R, CERAMIC, 0402 | Capacitor | 2014-03-12T04:39:29-08:00 | 0402C | N/A | MURATA GRM155R61A105KE15D | GRM155R61A105KE15D | TAIYO YUDEN LMK105BJ105KV-F | LMK105BJ105KV-F |  |  |  |  |  |  | Morris Chau | 0.55mm | Production |  | Kristi Eng | 2 | N/A | -55 +85C | 10% | 1uF |  | 10V | 0.0
C504 | https://app.bom.com/a/6O7P8SBSBUDMZMOD?v=files.associations | Capacitor | X5R | PAS - Passives | 2009-03-11T13:25:27-08:00 | CAP, 1uF, 10V, 10%, X5R, CERAMIC, 0402 | Capacitor | 2014-03-12T04:39:29-08:00 | 0402C | N/A | MURATA GRM155R61A105KE15D | GRM155R61A105KE15D | TAIYO YUDEN LMK105BJ105KV-F | LMK105BJ105KV-F |  |  |  |  |  |  | Morris Chau | 0.55mm | Production |  | Kristi Eng | 2 | N/A | -55 +85C | 10% | 1uF |  | 10V | 0.0
C505 | https://app.bom.com/a/J1K2L5O5O7OCQRFG?v=files.associations | Capacitor | C0G | PAS - Passives | 2011-05-10T11:01:38-08:00 | CAP, 100pF, 50V, 5%, C0G, CERAMIC, 0402 | Capacitor | 2014-04-28T09:22:48-08:00 | 0402C |  | MURATA GRM1555C1H101JA01D | GRM1555C1H101JA01D | TAIYO YUDEN UMK105CG101JV-F | UMK105CG101JV-F |  |  |  |  |  |  | Michael Sorensen | 0.55mm | Production |  | Michael Sorensen | 1 |  | -55 +125C | 5% | 100pF |  | 50V | 0.0
C506 | https://app.bom.com/a/J1K2L5O5O7OCQRFG?v=files.associations | Capacitor | C0G | PAS - Passives | 2011-05-10T11:01:38-08:00 | CAP, 100pF, 50V, 5%, C0G, CERAMIC, 0402 | Capacitor | 2014-04-28T09:22:48-08:00 | 0402C |  | MURATA GRM1555C1H101JA01D | GRM1555C1H101JA01D | TAIYO YUDEN UMK105CG101JV-F | UMK105CG101JV-F |  |  |  |  |  |  | Michael Sorensen | 0.55mm | Production |  | Michael Sorensen | 1 |  | -55 +125C | 5% | 100pF |  | 50V | 0.0
C507 | https://app.bom.com/a/0I1J2M5M5O7PYUOT?v=files.associations | Capacitor | C0G | PAS - Passives | 2004-12-21T10:56:54-08:00 | CAP, 22pF, 50V, 5%, C0G, CERAMIC, 0402 | Capacitor | 2013-02-21T21:42:28-08:00 | 0402C | N/A | MURATA GRM1555C1H220JA01D | GRM1555C1H220JA01D | TAIYO YUDEN UMK105CG220JV-F | UMK105CG220JV-F |  |  |  |  |  |  | Morris Chau | 0.55mm | Production |  | Kevin Dotzler | 1.2 | N/A | -55 +125C | 5% | 22pF |  | 50V | 0.0
C508 | https://app.bom.com/a/0I1J2M5M5O7PYUOT?v=files.associations | Capacitor | C0G | PAS - Passives | 2004-12-21T10:56:54-08:00 | CAP, 22pF, 50V, 5%, C0G, CERAMIC, 0402 | Capacitor | 2013-02-21T21:42:28-08:00 | 0402C | N/A | MURATA GRM1555C1H220JA01D | GRM1555C1H220JA01D | TAIYO YUDEN UMK105CG220JV-F | UMK105CG220JV-F |  |  |  |  |  |  | Morris Chau | 0.55mm | Production |  | Kevin Dotzler | 1.2 | N/A | -55 +125C | 5% | 22pF |  | 50V | 0.0
C509 | https://app.bom.com/a/8Q9RAUDUDWFO96UB?v=files.associations | Capacitor | X5R | PAS - Passives | 2009-11-13T15:52:55-08:00 | CAP, 4.7uF, 6.3V, 20%, X5R, 0402 | Capacitor | 2011-11-14T14:48:58-08:00 | 0402C | N/A | PANASONIC ECJ-0EB0J475M | ECJ-0EB0J475M | MURATA GRM155R60J475ME87D | GRM155R60J475ME87D | SAMSUNG CL05A475MQ5NRNC | CL05A475MQ5NRNC |  |  |  |  | Michael Sorensen | 0.65mm | Production |  | Ashish Syal | 2 | N/A | -55 +85C | 20% | 4.7uF |  | 6.3V | 0.0
C510 | https://app.bom.com/a/J1K2L5O5O7OCQRFG?v=files.associations | Capacitor | C0G | PAS - Passives | 2011-05-10T11:01:38-08:00 | CAP, 100pF, 50V, 5%, C0G, CERAMIC, 0402 | Capacitor | 2014-04-28T09:22:48-08:00 | 0402C |  | MURATA GRM1555C1H101JA01D | GRM1555C1H101JA01D | TAIYO YUDEN UMK105CG101JV-F | UMK105CG101JV-F |  |  |  |  |  |  | Michael Sorensen | 0.55mm | Production |  | Michael Sorensen | 1 |  | -55 +125C | 5% | 100pF |  | 50V | 0.0
C511 | https://app.bom.com/a/J1K2L5O5O7OCQRFG?v=files.associations | Capacitor | C0G | PAS - Passives | 2011-05-10T11:01:38-08:00 | CAP, 100pF, 50V, 5%, C0G, CERAMIC, 0402 | Capacitor | 2014-04-28T09:22:48-08:00 | 0402C |  | MURATA GRM1555C1H101JA01D | GRM1555C1H101JA01D | TAIYO YUDEN UMK105CG101JV-F | UMK105CG101JV-F |  |  |  |  |  |  | Michael Sorensen | 0.55mm | Production |  | Michael Sorensen | 1 |  | -55 +125C | 5% | 100pF | MIC_CTIA | 50V | 0.0
C512 | https://app.bom.com/a/8Q9RAUDUDWFO96UB?v=files.associations | Capacitor | X5R | PAS - Passives | 2009-11-13T15:52:55-08:00 | CAP, 4.7uF, 6.3V, 20%, X5R, 0402 | Capacitor | 2011-11-14T14:48:58-08:00 | 0402C | N/A | PANASONIC ECJ-0EB0J475M | ECJ-0EB0J475M | MURATA GRM155R60J475ME87D | GRM155R60J475ME87D | SAMSUNG CL05A475MQ5NRNC | CL05A475MQ5NRNC |  |  |  |  | Michael Sorensen | 0.65mm | Production |  | Ashish Syal | 2 | N/A | -55 +85C | 20% | 4.7uF |  | 6.3V | 0.0
C513 | https://app.bom.com/a/8Q9RAUDUDWFO96UB?v=files.associations | Capacitor | X5R | PAS - Passives | 2009-11-13T15:52:55-08:00 | CAP, 4.7uF, 6.3V, 20%, X5R, 0402 | Capacitor | 2011-11-14T14:48:58-08:00 | 0402C | N/A | PANASONIC ECJ-0EB0J475M | ECJ-0EB0J475M | MURATA GRM155R60J475ME87D | GRM155R60J475ME87D | SAMSUNG CL05A475MQ5NRNC | CL05A475MQ5NRNC |  |  |  |  | Michael Sorensen | 0.65mm | Production |  | Ashish Syal | 2 | N/A | -55 +85C | 20% | 4.7uF |  | 6.3V | 0.0
C514 | https://app.bom.com/a/8Q9RAUDUDWFO96UB?v=files.associations | Capacitor | X5R | PAS - Passives | 2009-11-13T15:52:55-08:00 | CAP, 4.7uF, 6.3V, 20%, X5R, 0402 | Capacitor | 2011-11-14T14:48:58-08:00 | 0402C | N/A | PANASONIC ECJ-0EB0J475M | ECJ-0EB0J475M | MURATA GRM155R60J475ME87D | GRM155R60J475ME87D | SAMSUNG CL05A475MQ5NRNC | CL05A475MQ5NRNC |  |  |  |  | Michael Sorensen | 0.65mm | Production |  | Ashish Syal | 2 | N/A | -55 +85C | 20% | 4.7uF |  | 6.3V | 0.0
C515 | https://app.bom.com/a/UCVDWGZGZI1IUB6T?v=files.associations | Capacitor | X5R | PAS - Passives | 2006-02-03T15:26:24-08:00 | CAP, 2.2uF, 6.3V, 10%, X5R, CERAMIC, 0603 | Capacitor | 2011-12-02T13:52:33-08:00 | 0603C | N/A | TAIYO YUDEN CE JMK107BJ225KA-T | CE JMK107BJ225KA-T | MURATA GRM188R60J225KE19D | GRM188R60J225KE19D |  |  |  |  |  |  | Morris Chau | 0.9mm | Production |  | Mack Tan | 2 | N/A | -55 +85C | 10% | 2.2uF |  | 6.3V | 0.0
C516 | https://app.bom.com/a/J1K2L5O5O7OCQRFG?v=files.associations | Capacitor | C0G | PAS - Passives | 2011-05-10T11:01:38-08:00 | CAP, 100pF, 50V, 5%, C0G, CERAMIC, 0402 | Capacitor | 2014-04-28T09:22:48-08:00 | 0402C |  | MURATA GRM1555C1H101JA01D | GRM1555C1H101JA01D | TAIYO YUDEN UMK105CG101JV-F | UMK105CG101JV-F |  |  |  |  |  |  | Michael Sorensen | 0.55mm | Production |  | Michael Sorensen | 1 |  | -55 +125C | 5% | 100pF | MIC_OMTP | 50V | 0.0
C517 | https://app.bom.com/a/N5O6P9S9SBU5DYQF?v=files.associations | Capacitor | X7R | PAS - Passives | 2008-08-21T16:59:08-08:00 | CAP, 100nF, 16V, 10%, X7R, CERAMIC, 0402 | Capacitor | 2012-02-01T15:49:25-08:00 | 0402C | N/A | NIC COMPONENTS NMC0402X7R104K16TRPF | NMC0402X7R104K16TRPF | MURATA GRM155R71C104KA88D | GRM155R71C104KA88D | VISHAY VJ0402V104ZXJCW1BC | VJ0402V104ZXJCW1BC |  |  |  |  | Morris Chau | 0.55mm | Production |  | Airlink | 2 | N/A | -55 +125C | 10% | 100nF |  | 16V | 0.0
C518 | https://app.bom.com/a/N5O6P9S9SBU5DYQF?v=files.associations | Capacitor | X7R | PAS - Passives | 2008-08-21T16:59:08-08:00 | CAP, 100nF, 16V, 10%, X7R, CERAMIC, 0402 | Capacitor | 2012-02-01T15:49:25-08:00 | 0402C | N/A | NIC COMPONENTS NMC0402X7R104K16TRPF | NMC0402X7R104K16TRPF | MURATA GRM155R71C104KA88D | GRM155R71C104KA88D | VISHAY VJ0402V104ZXJCW1BC | VJ0402V104ZXJCW1BC |  |  |  |  | Morris Chau | 0.55mm | Production |  | Airlink | 2 | N/A | -55 +125C | 10% | 100nF |  | 16V | 0.0
C519 | https://app.bom.com/a/8Q9RAUDUDWFO96UB?v=files.associations | Capacitor | X5R | PAS - Passives | 2009-11-13T15:52:55-08:00 | CAP, 4.7uF, 6.3V, 20%, X5R, 0402 | Capacitor | 2011-11-14T14:48:58-08:00 | 0402C | N/A | PANASONIC ECJ-0EB0J475M | ECJ-0EB0J475M | MURATA GRM155R60J475ME87D | GRM155R60J475ME87D | SAMSUNG CL05A475MQ5NRNC | CL05A475MQ5NRNC |  |  |  |  | Michael Sorensen | 0.65mm | Production |  | Ashish Syal | 2 | N/A | -55 +85C | 20% | 4.7uF |  | 6.3V | 0.0
C520 | https://app.bom.com/a/N5O6P9S9SBU5DYQF?v=files.associations | Capacitor | X7R | PAS - Passives | 2008-08-21T16:59:08-08:00 | CAP, 100nF, 16V, 10%, X7R, CERAMIC, 0402 | Capacitor | 2012-02-01T15:49:25-08:00 | 0402C | N/A | NIC COMPONENTS NMC0402X7R104K16TRPF | NMC0402X7R104K16TRPF | MURATA GRM155R71C104KA88D | GRM155R71C104KA88D | VISHAY VJ0402V104ZXJCW1BC | VJ0402V104ZXJCW1BC |  |  |  |  | Morris Chau | 0.55mm | Production |  | Airlink | 2 | N/A | -55 +125C | 10% | 100nF |  | 16V | 0.0
C600 | https://app.bom.com/a/6O7P8SBSBUDMZMOD?v=files.associations | Capacitor | X5R | PAS - Passives | 2009-03-11T13:25:27-08:00 | CAP, 1uF, 10V, 10%, X5R, CERAMIC, 0402 | Capacitor | 2014-03-12T04:39:29-08:00 | 0402C | N/A | MURATA GRM155R61A105KE15D | GRM155R61A105KE15D | TAIYO YUDEN LMK105BJ105KV-F | LMK105BJ105KV-F |  |  |  |  |  |  | Morris Chau | 0.55mm | Production |  | Kristi Eng | 2 | N/A | -55 +85C | 10% | 1uF |  | 10V | 0.0
C601 | https://app.bom.com/a/N5O6P9S9SBU5DYQF?v=files.associations | Capacitor | X7R | PAS - Passives | 2008-08-21T16:59:08-08:00 | CAP, 100nF, 16V, 10%, X7R, CERAMIC, 0402 | Capacitor | 2012-02-01T15:49:25-08:00 | 0402C | N/A | NIC COMPONENTS NMC0402X7R104K16TRPF | NMC0402X7R104K16TRPF | MURATA GRM155R71C104KA88D | GRM155R71C104KA88D | VISHAY VJ0402V104ZXJCW1BC | VJ0402V104ZXJCW1BC |  |  |  |  | Morris Chau | 0.55mm | Production |  | Airlink | 2 | N/A | -55 +125C | 10% | 100nF |  | 16V | 0.0
C602 | https://app.bom.com/a/6O7P8SBSBUDMZMOD?v=files.associations | Capacitor | X5R | PAS - Passives | 2009-03-11T13:25:27-08:00 | CAP, 1uF, 10V, 10%, X5R, CERAMIC, 0402 | Capacitor | 2014-03-12T04:39:29-08:00 | 0402C | N/A | MURATA GRM155R61A105KE15D | GRM155R61A105KE15D | TAIYO YUDEN LMK105BJ105KV-F | LMK105BJ105KV-F |  |  |  |  |  |  | Morris Chau | 0.55mm | Production |  | Kristi Eng | 2 | N/A | -55 +85C | 10% | 1uF |  | 10V | 0.0
C604 | https://app.bom.com/a/N5O6P9S9SBU5DYQF?v=files.associations | Capacitor | X7R | PAS - Passives | 2008-08-21T16:59:08-08:00 | CAP, 100nF, 16V, 10%, X7R, CERAMIC, 0402 | Capacitor | 2012-02-01T15:49:25-08:00 | 0402C | N/A | NIC COMPONENTS NMC0402X7R104K16TRPF | NMC0402X7R104K16TRPF | MURATA GRM155R71C104KA88D | GRM155R71C104KA88D | VISHAY VJ0402V104ZXJCW1BC | VJ0402V104ZXJCW1BC |  |  |  |  | Morris Chau | 0.55mm | Production |  | Airlink | 2 | N/A | -55 +125C | 10% | 100nF |  | 16V | 0.0
C605 | https://app.bom.com/a/2K3L4O7O7Q9QNTDO?v=files.associations | Capacitor | X5R | PAS - Passives | 2006-06-23T05:25:15-08:00 | CAP, 4.7uF, 10V, 10%, X5R, CERAMIC, 0603 | Capacitor | 2014-04-29T00:34:09-08:00 | 0603C | N/A | MURATA GRM188R61A475KE15D | GRM188R61A475KE15D | NIC COMPONENTS NMC0603X5R475K10TRPF | NMC0603X5R475K10TRPF | SEMCO (Samsung Electro-Mechanics Co. Ltd) CL10A475KP8NNNC | CL10A475KP8NNNC | TAIYO YUDEN LMK107BJ475KA-T | LMK107BJ475KA-T |  |  | Morris Chau | 0.9mm | Production |  | Ryan Fallini | 3 | N/A | -55 +85C | 10% | 4.7uF | DNI | 10V | 0.0
C606 | https://app.bom.com/a/SATBUEXEXGZHQMF9?v=files.associations | Capacitor | X7R | PAS - Passives | 2004-12-21T10:57:02-08:00 | CAP, 1nF, 50V, 10%, X7R, CERAMIC, 0402 | Capacitor | 2014-04-28T09:22:48-08:00 | 0402C | N/A | MURATA GRM155R71H102KA01D | GRM155R71H102KA01D | TAIYO YUDEN UMK105BJ102KV-F | UMK105BJ102KV-F |  |  |  |  |  |  | Morris Chau | 0.55mm | Production |  | Kevin Dotzler | 4 | N/A | -55 +125C | 10% | 1nF | DNI | 50V | 0.0
C610 | https://app.bom.com/a/N5O6P9S9SBU5DYQF?v=files.associations | Capacitor | X7R | PAS - Passives | 2008-08-21T16:59:08-08:00 | CAP, 100nF, 16V, 10%, X7R, CERAMIC, 0402 | Capacitor | 2012-02-01T15:49:25-08:00 | 0402C | N/A | NIC COMPONENTS NMC0402X7R104K16TRPF | NMC0402X7R104K16TRPF | MURATA GRM155R71C104KA88D | GRM155R71C104KA88D | VISHAY VJ0402V104ZXJCW1BC | VJ0402V104ZXJCW1BC |  |  |  |  | Morris Chau | 0.55mm | Production |  | Airlink | 2 | N/A | -55 +125C | 10% | 100nF |  | 16V | 0.0
C624 | https://app.bom.com/a/N5O6P9S9SBU5DYQF?v=files.associations | Capacitor | X7R | PAS - Passives | 2008-08-21T16:59:08-08:00 | CAP, 100nF, 16V, 10%, X7R, CERAMIC, 0402 | Capacitor | 2012-02-01T15:49:25-08:00 | 0402C | N/A | NIC COMPONENTS NMC0402X7R104K16TRPF | NMC0402X7R104K16TRPF | MURATA GRM155R71C104KA88D | GRM155R71C104KA88D | VISHAY VJ0402V104ZXJCW1BC | VJ0402V104ZXJCW1BC |  |  |  |  | Morris Chau | 0.55mm | Production |  | Airlink | 2 | N/A | -55 +125C | 10% | 100nF |  | 16V | 0.0
C700 | https://app.bom.com/a/N5O6P9S9SBU5DYQF?v=files.associations https://agiledev.sierrawireless.local/Agile/object/Parts/3800100 | Capacitor Oscillator | X7R | PAS - Passives C&O - Crystals & Oscillators | 2008-08-21T16:59:08-08:00 2016-03-17T08:14:52Z | CAP, 100nF, 16V, 10%, X7R, CERAMIC, 0402 OSC, 26MHz, 50ppm, CMOS, 15pF, 3.2x2.5x1mm | Capacitor Oscillator | 2012-02-01T15:49:25-08:00 | 0402C XTAL_4P_0320x0250 | N/A N/A | NIC COMPONENTS NMC0402X7R104K16TRPF NDK NZ3225SA-26MHz | NMC0402X7R104K16TRPF NZ3225SA-26MHz | MURATA GRM155R71C104KA88D | GRM155R71C104KA88D | VISHAY VJ0402V104ZXJCW1BC | VJ0402V104ZXJCW1BC |  |  |  |  | Morris Chau Davy Chan | 0.55mm 1mm | Production Prototype |  | Airlink Marco Tozzini | 2 1 | N/A N/A | -55 +125C -10 +60C | 10% 50ppm | 100nF 26MEGHz |  | 16V | 0.0
C701 | https://app.bom.com/a/N5O6P9S9SBU5DYQF?v=files.associations | Capacitor | X7R | PAS - Passives | 2008-08-21T16:59:08-08:00 | CAP, 100nF, 16V, 10%, X7R, CERAMIC, 0402 | Capacitor | 2012-02-01T15:49:25-08:00 | 0402C | N/A | NIC COMPONENTS NMC0402X7R104K16TRPF | NMC0402X7R104K16TRPF | MURATA GRM155R71C104KA88D | GRM155R71C104KA88D | VISHAY VJ0402V104ZXJCW1BC | VJ0402V104ZXJCW1BC |  |  |  |  | Morris Chau | 0.55mm | Production |  | Airlink | 2 | N/A | -55 +125C | 10% | 100nF |  | 16V | 0.0
C702 | https://app.bom.com/a/N5O6P9S9SBU5DYQF?v=files.associations | Capacitor | X7R | PAS - Passives | 2008-08-21T16:59:08-08:00 | CAP, 100nF, 16V, 10%, X7R, CERAMIC, 0402 | Capacitor | 2012-02-01T15:49:25-08:00 | 0402C | N/A | NIC COMPONENTS NMC0402X7R104K16TRPF | NMC0402X7R104K16TRPF | MURATA GRM155R71C104KA88D | GRM155R71C104KA88D | VISHAY VJ0402V104ZXJCW1BC | VJ0402V104ZXJCW1BC |  |  |  |  | Morris Chau | 0.55mm | Production |  | Airlink | 2 | N/A | -55 +125C | 10% | 100nF | DNI | 16V | 0.0
C703 | https://app.bom.com/a/1J2K3N6N6P6U89YK?v=files.associations | Capacitor | X5R | PAS - Passives | 2011-05-10T11:00:10-08:00 | CAP, 4.7uF, 6.3V, 20%, X5R, CERAMIC, 0402 | Capacitor | 2014-07-16T11:50:57-08:00 | 0402C |  | MURATA GRM155R60J475ME47D | GRM155R60J475ME47D | SEMCO (Samsung Electro-Mechanics Co. Ltd) CL05A475MQ5NRNC | CL05A475MQ5NRNC |  |  |  |  |  |  | Morris Chau | 0.55mm | Production |  | Michael Sorensen | 1 |  | -55 +85C | 20% | 4.7uF |  | 6.3V | 0.0
C704 | https://app.bom.com/a/N5O6P9S9SBU5DYQF?v=files.associations | Capacitor | X7R | PAS - Passives | 2008-08-21T16:59:08-08:00 | CAP, 100nF, 16V, 10%, X7R, CERAMIC, 0402 | Capacitor | 2012-02-01T15:49:25-08:00 | 0402C | N/A | NIC COMPONENTS NMC0402X7R104K16TRPF | NMC0402X7R104K16TRPF | MURATA GRM155R71C104KA88D | GRM155R71C104KA88D | VISHAY VJ0402V104ZXJCW1BC | VJ0402V104ZXJCW1BC |  |  |  |  | Morris Chau | 0.55mm | Production |  | Airlink | 2 | N/A | -55 +125C | 10% | 100nF |  | 16V | 0.0
C705 | https://app.bom.com/a/N5O6P9S9SBU5DYQF?v=files.associations | Capacitor | X7R | PAS - Passives | 2008-08-21T16:59:08-08:00 | CAP, 100nF, 16V, 10%, X7R, CERAMIC, 0402 | Capacitor | 2012-02-01T15:49:25-08:00 | 0402C | N/A | NIC COMPONENTS NMC0402X7R104K16TRPF | NMC0402X7R104K16TRPF | MURATA GRM155R71C104KA88D | GRM155R71C104KA88D | VISHAY VJ0402V104ZXJCW1BC | VJ0402V104ZXJCW1BC |  |  |  |  | Morris Chau | 0.55mm | Production |  | Airlink | 2 | N/A | -55 +125C | 10% | 100nF |  | 16V | 0.0
C706 | https://app.bom.com/a/1J2K3N6N6P6U89YK?v=files.associations | Capacitor | X5R | PAS - Passives | 2011-05-10T11:00:10-08:00 | CAP, 4.7uF, 6.3V, 20%, X5R, CERAMIC, 0402 | Capacitor | 2014-07-16T11:50:57-08:00 | 0402C |  | MURATA GRM155R60J475ME47D | GRM155R60J475ME47D | SEMCO (Samsung Electro-Mechanics Co. Ltd) CL05A475MQ5NRNC | CL05A475MQ5NRNC |  |  |  |  |  |  | Morris Chau | 0.55mm | Production |  | Michael Sorensen | 1 |  | -55 +85C | 20% | 4.7uF |  | 6.3V | 0.0
C707 | https://app.bom.com/a/1J2K3N6N6P6U89YK?v=files.associations | Capacitor | X5R | PAS - Passives | 2011-05-10T11:00:10-08:00 | CAP, 4.7uF, 6.3V, 20%, X5R, CERAMIC, 0402 | Capacitor | 2014-07-16T11:50:57-08:00 | 0402C |  | MURATA GRM155R60J475ME47D | GRM155R60J475ME47D | SEMCO (Samsung Electro-Mechanics Co. Ltd) CL05A475MQ5NRNC | CL05A475MQ5NRNC |  |  |  |  |  |  | Morris Chau | 0.55mm | Production |  | Michael Sorensen | 1 |  | -55 +85C | 20% | 4.7uF |  | 6.3V | 0.0
C708 | https://app.bom.com/a/1J2K3N6N6P6U89YK?v=files.associations | Capacitor | X5R | PAS - Passives | 2011-05-10T11:00:10-08:00 | CAP, 4.7uF, 6.3V, 20%, X5R, CERAMIC, 0402 | Capacitor | 2014-07-16T11:50:57-08:00 | 0402C |  | MURATA GRM155R60J475ME47D | GRM155R60J475ME47D | SEMCO (Samsung Electro-Mechanics Co. Ltd) CL05A475MQ5NRNC | CL05A475MQ5NRNC |  |  |  |  |  |  | Morris Chau | 0.55mm | Production |  | Michael Sorensen | 1 |  | -55 +85C | 20% | 4.7uF |  | 6.3V | 0.0
C709 | https://app.bom.com/a/N5O6P9S9SBU5DYQF?v=files.associations | Capacitor | X7R | PAS - Passives | 2008-08-21T16:59:08-08:00 | CAP, 100nF, 16V, 10%, X7R, CERAMIC, 0402 | Capacitor | 2012-02-01T15:49:25-08:00 | 0402C | N/A | NIC COMPONENTS NMC0402X7R104K16TRPF | NMC0402X7R104K16TRPF | MURATA GRM155R71C104KA88D | GRM155R71C104KA88D | VISHAY VJ0402V104ZXJCW1BC | VJ0402V104ZXJCW1BC |  |  |  |  | Morris Chau | 0.55mm | Production |  | Airlink | 2 | N/A | -55 +125C | 10% | 100nF |  | 16V | 0.0
C710 | https://app.bom.com/a/6O7P8SBSBUDMZMOD?v=files.associations | Capacitor | X5R | PAS - Passives | 2009-03-11T13:25:27-08:00 | CAP, 1uF, 10V, 10%, X5R, CERAMIC, 0402 | Capacitor | 2014-08-19T23:15:58-08:00 | 0402C | N/A | MURATA GRM155R61A105KE15D | GRM155R61A105KE15D | TAIYO YUDEN LMK105BJ105KV-F | LMK105BJ105KV-F |  |  |  |  |  |  | Morris Chau | 0.55mm | Production |  | Kristi Eng | 2 | N/A | -55 +85C | 10% | 1uF |  | 10V | 0.0
C715 | https://app.bom.com/a/2K3L4O7O7Q7V9AYD?v=files.associations | Capacitor | X5R | PAS - Passives | 2011-05-10T11:01:11-08:00 | CAP, 100nF, 10V, 10%, X5R, CERAMIC, 0402 | Capacitor | 2013-11-26T22:59:31-08:00 | 0402C |  | MURATA GRM155R61A104KA01D | GRM155R61A104KA01D | TAIYO YUDEN LMK105BJ104KV-F | LMK105BJ104KV-F |  |  |  |  |  |  | Michael Sorensen | 0.55mm | Production |  | Michael Sorensen | 1 |  | -55 +85C | 10% | 100nF |  | 10V | 0.0
C720 | https://app.bom.com/a/2K3L4O7O7Q7V9AYD?v=files.associations | Capacitor | X5R | PAS - Passives | 2011-05-10T11:01:11-08:00 | CAP, 100nF, 10V, 10%, X5R, CERAMIC, 0402 | Capacitor | 2013-11-26T22:59:31-08:00 | 0402C |  | MURATA GRM155R61A104KA01D | GRM155R61A104KA01D | TAIYO YUDEN LMK105BJ104KV-F | LMK105BJ104KV-F |  |  |  |  |  |  | Michael Sorensen | 0.55mm | Production |  | Michael Sorensen | 1 |  | -55 +85C | 10% | 100nF |  | 10V | 0.0
C721 | https://app.bom.com/a/2K3L4O7O7Q7V9AYD?v=files.associations | Capacitor | X5R | PAS - Passives | 2011-05-10T11:01:11-08:00 | CAP, 100nF, 10V, 10%, X5R, CERAMIC, 0402 | Capacitor | 2013-11-26T22:59:31-08:00 | 0402C |  | MURATA GRM155R61A104KA01D | GRM155R61A104KA01D | TAIYO YUDEN LMK105BJ104KV-F | LMK105BJ104KV-F |  |  |  |  |  |  | Michael Sorensen | 0.55mm | Production |  | Michael Sorensen | 1 |  | -55 +85C | 10% | 100nF | DNI | 10V | 0.0
C722 | https://app.bom.com/a/2K3L4O7O7Q7V9AYD?v=files.associations | Capacitor | X5R | PAS - Passives | 2011-05-10T11:01:11-08:00 | CAP, 100nF, 10V, 10%, X5R, CERAMIC, 0402 | Capacitor | 2013-11-26T22:59:31-08:00 | 0402C |  | MURATA GRM155R61A104KA01D | GRM155R61A104KA01D | TAIYO YUDEN LMK105BJ104KV-F | LMK105BJ104KV-F |  |  |  |  |  |  | Michael Sorensen | 0.55mm | Production |  | Michael Sorensen | 1 |  | -55 +85C | 10% | 100nF |  | 10V | 0.0
C723 | https://app.bom.com/a/2K3L4O7O7Q7V9AYD?v=files.associations | Capacitor | X5R | PAS - Passives | 2011-05-10T11:01:11-08:00 | CAP, 100nF, 10V, 10%, X5R, CERAMIC, 0402 | Capacitor | 2013-11-26T22:59:31-08:00 | 0402C |  | MURATA GRM155R61A104KA01D | GRM155R61A104KA01D | TAIYO YUDEN LMK105BJ104KV-F | LMK105BJ104KV-F |  |  |  |  |  |  | Michael Sorensen | 0.55mm | Production |  | Michael Sorensen | 1 |  | -55 +85C | 10% | 100nF | DNI | 10V | 0.0
C725 | https://app.bom.com/a/2K3L4O7O7Q7V9AYD?v=files.associations | Capacitor | X5R | PAS - Passives | 2011-05-10T11:01:11-08:00 | CAP, 100nF, 10V, 10%, X5R, CERAMIC, 0402 | Capacitor | 2013-11-26T22:59:31-08:00 | 0402C |  | MURATA GRM155R61A104KA01D | GRM155R61A104KA01D | TAIYO YUDEN LMK105BJ104KV-F | LMK105BJ104KV-F |  |  |  |  |  |  | Michael Sorensen | 0.55mm | Production |  | Michael Sorensen | 1 |  | -55 +85C | 10% | 100nF |  | 10V | 0.0
C788 | https://app.bom.com/a/1J2K3N6N6P6U89YK?v=files.associations | Capacitor | X5R | PAS - Passives | 2011-05-10T11:00:10-08:00 | CAP, 4.7uF, 6.3V, 20%, X5R, CERAMIC, 0402 | Capacitor | 2014-07-16T11:50:57-08:00 | 0402C |  | MURATA GRM155R60J475ME47D | GRM155R60J475ME47D | SEMCO (Samsung Electro-Mechanics Co. Ltd) CL05A475MQ5NRNC | CL05A475MQ5NRNC |  |  |  |  |  |  | Morris Chau | 0.55mm | Production |  | Michael Sorensen | 1 |  | -55 +85C | 20% | 4.7uF |  | 6.3V | 0.0
C800 | https://app.bom.com/a/YGZH0K3K3MMB0923?v=files.associations | Capacitor | X5R | PAS - Passives | 2014-01-20T23:04:39-08:00 | CAP, 22uF, 10V, 20%, X5R, CERAMIC, 0805 | Capacitor | 2015-06-01T09:44:04-08:00 | 0805C | N/A | MURATA GRM219R61A226MEA0D | GRM219R61A226MEA0D | TDK C2012X5R1A226MT0J0E | C2012X5R1A226MT0J0E |  |  |  |  |  |  | Morris Chau | 1mm | Production | 1A | Youngman Kim | 1 | N/A | -55 +85C | 20% | 22uF |  | 10V | 0.0
C801 | https://app.bom.com/a/EWFXG0J0J22ZOY4W?v=files.associations | Capacitor | X7R | PAS - Passives | 2012-03-06T15:42:48-08:00 | CAP, 220nF, 50V, 20%, X7R, CERAMIC, 0603 | Capacitor | 2012-03-06T15:47:11-08:00 | 0603C | N/A | MURATA GCM188R71H224MA64D | GCM188R71H224MA64D | TAIYO YUDEN UMK107B7224MA-TR | UMK107B7224MA-TR |  |  |  |  |  |  | Michael Sorensen | 0.8mm | Design |  | Robert Hardesty | A | N/A | -55 +125C | 20% | 220nF |  | 50V | 0.0
C802 | https://app.bom.com/a/6O7P8SBSBUDMZMOD?v=files.associations | Capacitor | X5R | PAS - Passives | 2009-03-11T13:25:27-08:00 | CAP, 1uF, 10V, 10%, X5R, CERAMIC, 0402 | Capacitor | 2014-03-12T04:39:29-08:00 | 0402C | N/A | MURATA GRM155R61A105KE15D | GRM155R61A105KE15D | TAIYO YUDEN LMK105BJ105KV-F | LMK105BJ105KV-F |  |  |  |  |  |  | Morris Chau | 0.55mm | Production |  | Kristi Eng | 2 | N/A | -55 +85C | 10% | 1uF |  | 10V | 0.0
C803 | https://app.bom.com/a/6O7P8SBSBUUI7096?v=files.associations | Capacitor | X5R | PAS - Passives | 2014-03-26T03:32:53-08:00 | CAP, 10uF, 10V, 20%, X5R, CERAMIC, 0603 | Capacitor | 2014-03-26T03:37:12-08:00 | 0603C | N/A | MURATA GRM188R61A106ME69D | GRM188R61A106ME69D |  |  |  |  |  |  |  |  | Morris Chau | 0.95mm | Design |  | Mohamed Ammari | A | N/A | -55 +85C | 20% | 10uF |  | 6.3V | 0.0
C804 | https://app.bom.com/a/6O7P8SBSBUDMZMOD?v=files.associations | Capacitor | X5R | PAS - Passives | 2009-03-11T13:25:27-08:00 | CAP, 1uF, 10V, 10%, X5R, CERAMIC, 0402 | Capacitor | 2014-03-12T04:39:29-08:00 | 0402C | N/A | MURATA GRM155R61A105KE15D | GRM155R61A105KE15D | TAIYO YUDEN LMK105BJ105KV-F | LMK105BJ105KV-F |  |  |  |  |  |  | Morris Chau | 0.55mm | Production |  | Kristi Eng | 2 | N/A | -55 +85C | 10% | 1uF |  | 10V | 0.0
C805 | https://app.bom.com/a/L3M4N7Q7Q9SBB34T?v=files.associations | Capacitor | X5R | PAS - Passives | 2003-10-24T15:32:31-08:00 | CAP, 10uF, 10V, 20%, X5R, CERAMIC, 0805 | Capacitor | 2012-01-13T16:18:46-08:00 | 0805C | N/A | TAIYO YUDEN LMK212C106MG | LMK212C106MG | MURATA GRM21BR61A106KE19L | GRM21BR61A106KE19L | TAIYO YUDEN LMK212BJ106KG-T | LMK212BJ106KG-T | TAIYO YUDEN LMK212BJ106KD-T | LMK212BJ106KD-T |  |  | Morris Chau | 1.35mm | Production |  | Michael Sorensen | 4 | N/A | -55 +85C | 20% | 10uF |  | 10V | 0.0
C806 | https://app.bom.com/a/P7Q8RBUBUDWENJB3?v=files.associations | Capacitor | X7R | PAS - Passives | 2004-12-21T10:57:06-08:00 | CAP, 47nF, 10V, 10%, X7R, CERAMIC, 0402 | Capacitor | 2011-12-02T13:52:33-08:00 | 0402C | N/A | MURATA GRM155R71A473KA01D | GRM155R71A473KA01D | TAIYO YUDEN LMK105BJ473KV-F | LMK105BJ473KV-F |  |  |  |  |  |  | Morris Chau | 0.55mm | Production |  | Kevin Dotzler | 2 | N/A | -55 +125C | 10% | 47nF |  | 10V | 0.0
C807 | https://app.bom.com/a/EWFXG0J0J22ZOY4W?v=files.associations | Capacitor | X7R | PAS - Passives | 2012-03-06T15:42:48-08:00 | CAP, 220nF, 50V, 20%, X7R, CERAMIC, 0603 | Capacitor | 2012-03-06T15:47:11-08:00 | 0603C | N/A | MURATA GCM188R71H224MA64D | GCM188R71H224MA64D | TAIYO YUDEN UMK107B7224MA-TR | UMK107B7224MA-TR |  |  |  |  |  |  | Michael Sorensen | 0.8mm | Design |  | Robert Hardesty | A | N/A | -55 +125C | 20% | 220nF |  | 50V | 0.0
C808 | https://app.bom.com/a/6O7P8SBSBUUI7096?v=files.associations | Capacitor | X5R | PAS - Passives | 2014-03-26T03:32:53-08:00 | CAP, 10uF, 10V, 20%, X5R, CERAMIC, 0603 | Capacitor | 2014-03-26T03:37:12-08:00 | 0603C | N/A | MURATA GRM188R61A106ME69D | GRM188R61A106ME69D |  |  |  |  |  |  |  |  | Morris Chau | 0.95mm | Design |  | Mohamed Ammari | A | N/A | -55 +85C | 20% | 10uF |  | 6.3V | 0.0
C809 | https://app.bom.com/a/EWFXG0J0J22ZOY4W?v=files.associations | Capacitor | X7R | PAS - Passives | 2012-03-06T15:42:48-08:00 | CAP, 220nF, 50V, 20%, X7R, CERAMIC, 0603 | Capacitor | 2012-03-06T15:47:11-08:00 | 0603C | N/A | MURATA GCM188R71H224MA64D | GCM188R71H224MA64D | TAIYO YUDEN UMK107B7224MA-TR | UMK107B7224MA-TR |  |  |  |  |  |  | Michael Sorensen | 0.8mm | Design |  | Robert Hardesty | A | N/A | -55 +125C | 20% | 220nF |  | 50V | 0.0
C810 | https://app.bom.com/a/2K3L4O7O7Q9QNTDO?v=files.associations | Capacitor | X5R | PAS - Passives | 2006-06-23T05:25:15-08:00 | CAP, 4.7uF, 10V, 10%, X5R, CERAMIC, 0603 | Capacitor | 2014-04-29T00:34:09-08:00 | 0603C | N/A | MURATA GRM188R61A475KE15D | GRM188R61A475KE15D | NIC COMPONENTS NMC0603X5R475K10TRPF | NMC0603X5R475K10TRPF | SEMCO (Samsung Electro-Mechanics Co. Ltd) CL10A475KP8NNNC | CL10A475KP8NNNC | TAIYO YUDEN LMK107BJ475KA-T | LMK107BJ475KA-T |  |  | Morris Chau | 0.9mm | Production |  | Ryan Fallini | 3 | N/A | -55 +85C | 10% | 4.7uF |  | 10V | 0.0
C811 | https://app.bom.com/a/N5O6P9S9SBU5DYQF?v=files.associations | Capacitor | X7R | PAS - Passives | 2008-08-21T16:59:08-08:00 | CAP, 100nF, 16V, 10%, X7R, CERAMIC, 0402 | Capacitor | 2012-02-01T15:49:25-08:00 | 0402C | N/A | NIC COMPONENTS NMC0402X7R104K16TRPF | NMC0402X7R104K16TRPF | MURATA GRM155R71C104KA88D | GRM155R71C104KA88D | VISHAY VJ0402V104ZXJCW1BC | VJ0402V104ZXJCW1BC |  |  |  |  | Morris Chau | 0.55mm | Production |  | Airlink | 2 | N/A | -55 +125C | 10% | 100nF |  | 16V | 0.0
C812 | https://app.bom.com/a/4M5N6Q9Q9SSKOOFO?v=files.associations | Capacitor | X5R | PAS - Passives | 2013-02-27T02:12:35-08:00 | CAP, 47uF, 10V, 20%, X5R, CERAMIC, 1206 | Capacitor | 2013-03-04T23:56:40-08:00 | 1206C | N/A | MURATA GRM31CR61A476ME15L | GRM31CR61A476ME15L | TAIYO YUDEN LMK316BJ476ML-T | LMK316BJ476ML-T |  |  |  |  |  |  | Morris Chau | 1.8mm | Production |  | Derek Liu | 1 | N/A | -55 +85C | 20% | 47uF |  | 10V | 0.0
C818 | https://app.bom.com/a/6O7P8SBSBUUI7096?v=files.associations | Capacitor | X5R | PAS - Passives | 2014-03-26T03:32:53-08:00 | CAP, 10uF, 10V, 20%, X5R, CERAMIC, 0603 | Capacitor | 2014-03-26T03:37:12-08:00 | 0603C | N/A | MURATA GRM188R61A106ME69D | GRM188R61A106ME69D |  |  |  |  |  |  |  |  | Morris Chau | 0.95mm | Design |  | Mohamed Ammari | A | N/A | -55 +85C | 20% | 10uF | DNI | 6.3V | 0.0
C900 | https://app.bom.com/a/N5O6P9S9SBU5DYQF?v=files.associations | Capacitor | X7R | PAS - Passives | 2008-08-21T16:59:08-08:00 | CAP, 100nF, 16V, 10%, X7R, CERAMIC, 0402 | Capacitor | 2012-02-01T15:49:25-08:00 | 0402C | N/A | NIC COMPONENTS NMC0402X7R104K16TRPF | NMC0402X7R104K16TRPF | MURATA GRM155R71C104KA88D | GRM155R71C104KA88D | VISHAY VJ0402V104ZXJCW1BC | VJ0402V104ZXJCW1BC |  |  |  |  | Morris Chau | 0.55mm | Production |  | Airlink | 2 | N/A | -55 +125C | 10% | 100nF |  | 16V | 0.0
C901 | https://app.bom.com/a/N5O6P9S9SBU5DYQF?v=files.associations | Capacitor | X7R | PAS - Passives | 2008-08-21T16:59:08-08:00 | CAP, 100nF, 16V, 10%, X7R, CERAMIC, 0402 | Capacitor | 2012-02-01T15:49:25-08:00 | 0402C | N/A | NIC COMPONENTS NMC0402X7R104K16TRPF | NMC0402X7R104K16TRPF | MURATA GRM155R71C104KA88D | GRM155R71C104KA88D | VISHAY VJ0402V104ZXJCW1BC | VJ0402V104ZXJCW1BC |  |  |  |  | Morris Chau | 0.55mm | Production |  | Airlink | 2 | N/A | -55 +125C | 10% | 100nF |  | 16V | 0.0
C902 | https://app.bom.com/a/N5O6P9S9SBU5DYQF?v=files.associations | Capacitor | X7R | PAS - Passives | 2008-08-21T16:59:08-08:00 | CAP, 100nF, 16V, 10%, X7R, CERAMIC, 0402 | Capacitor | 2012-02-01T15:49:25-08:00 | 0402C | N/A | NIC COMPONENTS NMC0402X7R104K16TRPF | NMC0402X7R104K16TRPF | MURATA GRM155R71C104KA88D | GRM155R71C104KA88D | VISHAY VJ0402V104ZXJCW1BC | VJ0402V104ZXJCW1BC |  |  |  |  | Morris Chau | 0.55mm | Production |  | Airlink | 2 | N/A | -55 +125C | 10% | 100nF |  | 16V | 0.0
C903 | https://app.bom.com/a/6O7P8SBSBUUI7096?v=files.associations | Capacitor | X5R | PAS - Passives | 2014-03-26T03:32:53-08:00 | CAP, 10uF, 10V, 20%, X5R, CERAMIC, 0603 | Capacitor | 2014-03-26T03:37:12-08:00 | 0603C | N/A | MURATA GRM188R61A106ME69D | GRM188R61A106ME69D |  |  |  |  |  |  |  |  | Morris Chau | 0.95mm | Design |  | Mohamed Ammari | A | N/A | -55 +85C | 20% | 10uF |  | 6.3V | 0.0
C904 | https://app.bom.com/a/N5O6P9S9SBU5DYQF?v=files.associations | Capacitor | X7R | PAS - Passives | 2008-08-21T16:59:08-08:00 | CAP, 100nF, 16V, 10%, X7R, CERAMIC, 0402 | Capacitor | 2012-02-01T15:49:25-08:00 | 0402C | N/A | NIC COMPONENTS NMC0402X7R104K16TRPF | NMC0402X7R104K16TRPF | MURATA GRM155R71C104KA88D | GRM155R71C104KA88D | VISHAY VJ0402V104ZXJCW1BC | VJ0402V104ZXJCW1BC |  |  |  |  | Morris Chau | 0.55mm | Production |  | Airlink | 2 | N/A | -55 +125C | 10% | 100nF |  | 16V | 0.0
C905 | https://app.bom.com/a/2K3L4O7O7Q7V9AYD?v=files.associations | Capacitor | X5R | PAS - Passives | 2011-05-10T11:01:11-08:00 | CAP, 100nF, 10V, 10%, X5R, CERAMIC, 0402 | Capacitor | 2013-11-26T22:59:31-08:00 | 0402C |  | MURATA GRM155R61A104KA01D | GRM155R61A104KA01D | TAIYO YUDEN LMK105BJ104KV-F | LMK105BJ104KV-F |  |  |  |  |  |  | Michael Sorensen | 0.55mm | Production |  | Michael Sorensen | 1 |  | -55 +85C | 10% | 100nF | DNI | 10V | 0.0
C906 | https://app.bom.com/a/M4N5O8R8RARFTUIV?v=files.associations | Capacitor | X5R | PAS - Passives | 2011-05-10T11:00:44-08:00 | CAP, 10uF, 10V, 10%, X5R, CERAMIC, 0805 | Capacitor | 2013-02-20T15:53:29-08:00 | 0805C |  | MURATA GRM21BR61A106KE19L | GRM21BR61A106KE19L | TAIYO YUDEN LMK212BJ106KG-T | LMK212BJ106KG-T |  |  |  |  |  |  | Michael Sorensen | 1.35mm | Production |  | Michael Sorensen | 1 |  | -55 +85C | 10% | 10uF |  | 10V | 0.0
C907 | https://app.bom.com/a/2K3L4O7O7Q7V9AYD?v=files.associations | Capacitor | X5R | PAS - Passives | 2011-05-10T11:01:11-08:00 | CAP, 100nF, 10V, 10%, X5R, CERAMIC, 0402 | Capacitor | 2013-11-26T22:59:31-08:00 | 0402C |  | MURATA GRM155R61A104KA01D | GRM155R61A104KA01D | TAIYO YUDEN LMK105BJ104KV-F | LMK105BJ104KV-F |  |  |  |  |  |  | Michael Sorensen | 0.55mm | Production |  | Michael Sorensen | 1 |  | -55 +85C | 10% | 100nF | DNI | 10V | 0.0
C908 | https://app.bom.com/a/4M5N6Q9Q9SSKOOFO?v=files.associations | Capacitor | X5R | PAS - Passives | 2013-02-27T02:12:35-08:00 | CAP, 47uF, 10V, 20%, X5R, CERAMIC, 1206 | Capacitor | 2013-03-04T23:56:40-08:00 | 1206C | N/A | MURATA GRM31CR61A476ME15L | GRM31CR61A476ME15L | TAIYO YUDEN LMK316BJ476ML-T | LMK316BJ476ML-T |  |  |  |  |  |  | Morris Chau | 1.8mm | Production |  | Derek Liu | 1 | N/A | -55 +85C | 20% | 47uF |  | 10V | 0.0
C909 | https://app.bom.com/a/P7Q8RBUBUDWENJB3?v=files.associations | Capacitor | X7R | PAS - Passives | 2004-12-21T10:57:06-08:00 | CAP, 47nF, 10V, 10%, X7R, CERAMIC, 0402 | Capacitor | 2011-12-02T13:52:33-08:00 | 0402C | N/A | MURATA GRM155R71A473KA01D | GRM155R71A473KA01D | TAIYO YUDEN LMK105BJ473KV-F | LMK105BJ473KV-F |  |  |  |  |  |  | Morris Chau | 0.55mm | Production |  | Kevin Dotzler | 2 | N/A | -55 +125C | 10% | 47nF | DNI | 10V | 0.0
C910 | https://app.bom.com/a/2K3L4O7O7Q7V9AYD?v=files.associations | Capacitor | X5R | PAS - Passives | 2011-05-10T11:01:11-08:00 | CAP, 100nF, 10V, 10%, X5R, CERAMIC, 0402 | Capacitor | 2013-11-26T22:59:31-08:00 | 0402C |  | MURATA GRM155R61A104KA01D | GRM155R61A104KA01D | TAIYO YUDEN LMK105BJ104KV-F | LMK105BJ104KV-F |  |  |  |  |  |  | Michael Sorensen | 0.55mm | Production |  | Michael Sorensen | 1 |  | -55 +85C | 10% | 100nF |  | 10V | 0.0
C911 | https://app.bom.com/a/FXGYH1K1K3K8MNBT?v=files.associations | Capacitor | X7R | PAS - Passives | 2011-05-10T11:01:33-08:00 | CAP, 10nF, 25V, 10%, X7R, CERAMIC, 0402 | Capacitor | 2013-12-09T20:53:11-08:00 | 0402C |  | MURATA GRM155R71E103KA01D | GRM155R71E103KA01D | TAIYO YUDEN TMK105BJ103KV-F | TMK105BJ103KV-F |  |  |  |  |  |  | Michael Sorensen | 0.55mm | Production |  | Michael Sorensen | 1 |  | -55 +125C | 10% | 10nF | DNI | 25V | 0.0
C912 | https://app.bom.com/a/4M5N6Q9Q9SSKOOFO?v=files.associations | Capacitor | X5R | PAS - Passives | 2013-02-27T02:12:35-08:00 | CAP, 47uF, 10V, 20%, X5R, CERAMIC, 1206 | Capacitor | 2013-03-04T23:56:40-08:00 | 1206C | N/A | MURATA GRM31CR61A476ME15L | GRM31CR61A476ME15L | TAIYO YUDEN LMK316BJ476ML-T | LMK316BJ476ML-T |  |  |  |  |  |  | Morris Chau | 1.8mm | Production |  | Derek Liu | 1 | N/A | -55 +85C | 20% | 47uF |  | 10V | 0.0
C913 | https://app.bom.com/a/2K3L4O7O7Q7V9AYD?v=files.associations | Capacitor | X5R | PAS - Passives | 2011-05-10T11:01:11-08:00 | CAP, 100nF, 10V, 10%, X5R, CERAMIC, 0402 | Capacitor | 2013-11-26T22:59:31-08:00 | 0402C |  | MURATA GRM155R61A104KA01D | GRM155R61A104KA01D | TAIYO YUDEN LMK105BJ104KV-F | LMK105BJ104KV-F |  |  |  |  |  |  | Michael Sorensen | 0.55mm | Production |  | Michael Sorensen | 1 |  | -55 +85C | 10% | 100nF |  | 10V | 0.0
C914 | https://app.bom.com/a/2K3L4O7O7Q7V9AYD?v=files.associations | Capacitor | X5R | PAS - Passives | 2011-05-10T11:01:11-08:00 | CAP, 100nF, 10V, 10%, X5R, CERAMIC, 0402 | Capacitor | 2013-11-26T22:59:31-08:00 | 0402C |  | MURATA GRM155R61A104KA01D | GRM155R61A104KA01D | TAIYO YUDEN LMK105BJ104KV-F | LMK105BJ104KV-F |  |  |  |  |  |  | Michael Sorensen | 0.55mm | Production |  | Michael Sorensen | 1 |  | -55 +85C | 10% | 100nF |  | 10V | 0.0
C915 | https://app.bom.com/a/2K3L4O7O7Q7V9AYD?v=files.associations | Capacitor | X5R | PAS - Passives | 2011-05-10T11:01:11-08:00 | CAP, 100nF, 10V, 10%, X5R, CERAMIC, 0402 | Capacitor | 2013-11-26T22:59:31-08:00 | 0402C |  | MURATA GRM155R61A104KA01D | GRM155R61A104KA01D | TAIYO YUDEN LMK105BJ104KV-F | LMK105BJ104KV-F |  |  |  |  |  |  | Michael Sorensen | 0.55mm | Production |  | Michael Sorensen | 1 |  | -55 +85C | 10% | 100nF | DNI | 10V | 0.0
C916 | https://app.bom.com/a/2K3L4O7O7Q7V9AYD?v=files.associations | Capacitor | X5R | PAS - Passives | 2011-05-10T11:01:11-08:00 | CAP, 100nF, 10V, 10%, X5R, CERAMIC, 0402 | Capacitor | 2013-11-26T22:59:31-08:00 | 0402C |  | MURATA GRM155R61A104KA01D | GRM155R61A104KA01D | TAIYO YUDEN LMK105BJ104KV-F | LMK105BJ104KV-F |  |  |  |  |  |  | Michael Sorensen | 0.55mm | Production |  | Michael Sorensen | 1 |  | -55 +85C | 10% | 100nF | DNI | 10V | 0.0
C917 | https://app.bom.com/a/2K3L4O7O7Q7V9AYD?v=files.associations | Capacitor | X5R | PAS - Passives | 2011-05-10T11:01:11-08:00 | CAP, 100nF, 10V, 10%, X5R, CERAMIC, 0402 | Capacitor | 2013-11-26T22:59:31-08:00 | 0402C |  | MURATA GRM155R61A104KA01D | GRM155R61A104KA01D | TAIYO YUDEN LMK105BJ104KV-F | LMK105BJ104KV-F |  |  |  |  |  |  | Michael Sorensen | 0.55mm | Production |  | Michael Sorensen | 1 |  | -55 +85C | 10% | 100nF | DNI | 10V | 0.0
C918 | https://app.bom.com/a/2K3L4O7O7Q7V9AYD?v=files.associations | Capacitor | X5R | PAS - Passives | 2011-05-10T11:01:11-08:00 | CAP, 100nF, 10V, 10%, X5R, CERAMIC, 0402 | Capacitor | 2013-11-26T22:59:31-08:00 | 0402C |  | MURATA GRM155R61A104KA01D | GRM155R61A104KA01D | TAIYO YUDEN LMK105BJ104KV-F | LMK105BJ104KV-F |  |  |  |  |  |  | Michael Sorensen | 0.55mm | Production |  | Michael Sorensen | 1 |  | -55 +85C | 10% | 100nF | DNI | 10V | 0.0
C919 | https://app.bom.com/a/2K3L4O7O7Q7V9AYD?v=files.associations | Capacitor | X5R | PAS - Passives | 2011-05-10T11:01:11-08:00 | CAP, 100nF, 10V, 10%, X5R, CERAMIC, 0402 | Capacitor | 2013-11-26T22:59:31-08:00 | 0402C |  | MURATA GRM155R61A104KA01D | GRM155R61A104KA01D | TAIYO YUDEN LMK105BJ104KV-F | LMK105BJ104KV-F |  |  |  |  |  |  | Michael Sorensen | 0.55mm | Production |  | Michael Sorensen | 1 |  | -55 +85C | 10% | 100nF | DNI | 10V | 0.0
C920 | https://app.bom.com/a/4M5N6Q9Q9SSKOOFO?v=files.associations | Capacitor | X5R | PAS - Passives | 2013-02-27T02:12:35-08:00 | CAP, 47uF, 10V, 20%, X5R, CERAMIC, 1206 | Capacitor | 2013-03-04T23:56:40-08:00 | 1206C | N/A | MURATA GRM31CR61A476ME15L | GRM31CR61A476ME15L | TAIYO YUDEN LMK316BJ476ML-T | LMK316BJ476ML-T |  |  |  |  |  |  | Morris Chau | 1.8mm | Production |  | Derek Liu | 1 | N/A | -55 +85C | 20% | 47uF |  | 10V | 0.0
C921 | https://app.bom.com/a/2K3L4O7O7Q7V9AYD?v=files.associations | Capacitor | X5R | PAS - Passives | 2011-05-10T11:01:11-08:00 | CAP, 100nF, 10V, 10%, X5R, CERAMIC, 0402 | Capacitor | 2013-11-26T22:59:31-08:00 | 0402C |  | MURATA GRM155R61A104KA01D | GRM155R61A104KA01D | TAIYO YUDEN LMK105BJ104KV-F | LMK105BJ104KV-F |  |  |  |  |  |  | Michael Sorensen | 0.55mm | Production |  | Michael Sorensen | 1 |  | -55 +85C | 10% | 100nF |  | 10V | 0.0
C922 | https://app.bom.com/a/CUDVEYHYH00WWKIT?v=files.associations | Capacitor | TANTALUM | PAS - Passives | 2012-03-22T12:32:16-08:00 | CAP, 1.5mF, 6.3V, 20%, TANTALUM, 7.2x6.3x2mm | Capacitor | 2013-04-17T08:27:49-08:00 | CAP_2P_0720x0630_POL_NIB | N/A | VISHAY 592D158X06R3R2T20H | 592D158X06R3R2T20H | AVX (KYOCERA) F720J158MMC | F720J158MMC |  |  |  |  |  |  | Morris Chau | 2mm | Production |  | Edison Li | 2 | N/A | -55 +85C | 20% | 1.5mF |  | 6.3V | 0.0
C924 | https://app.bom.com/a/R9SATDWDWFPQ5RBU?v=files.associations | Capacitor | X5R | PAS - Passives | 2011-10-31T17:27:40-08:00 | CAP, 22uF, 6.3V, 20%, X5R, CERAMIC, 0603 | Capacitor | 2012-11-19T09:07:33-08:00 | 0603C_WIDE_BODY | N/A | MURATA GRM188R60J226MEA0D | GRM188R60J226MEA0D | TDK C1608X5R0J226MT | C1608X5R0J226MT |  |  |  |  |  |  | Chris Ivanciuc | 1mm | Production |  | Markus Myers | 2 | N/A | -55 +85C | 20% | 22uF |  | 6.3V | 0.0
C925 | https://app.bom.com/a/FXGYH1K1K3M4D93C?v=files.associations | Capacitor | C0G | PAS - Passives | 2004-12-21T10:56:56-08:00 | CAP, 56pF, 50V, 5%, C0G, CERAMIC, 0402 | Capacitor | 2014-07-03T08:45:38-08:00 | 0402C | N/A | MURATA GRM1555C1H560JA01D | GRM1555C1H560JA01D | TAIYO YUDEN UMK105CG560JV-F | UMK105CG560JV-F |  |  |  |  |  |  | Morris Chau | 0.55mm | Production |  | Kevin Dotzler | 1.1 | N/A | -55 +125C | 5% | 56pF |  | 50V | 0.0
C926 | https://app.bom.com/a/R9SATDWDWFPQ5RBU?v=files.associations | Capacitor | X5R | PAS - Passives | 2011-10-31T17:27:40-08:00 | CAP, 22uF, 6.3V, 20%, X5R, CERAMIC, 0603 | Capacitor | 2012-11-19T09:07:33-08:00 | 0603C_WIDE_BODY | N/A | MURATA GRM188R60J226MEA0D | GRM188R60J226MEA0D | TDK C1608X5R0J226MT | C1608X5R0J226MT |  |  |  |  |  |  | Chris Ivanciuc | 1mm | Production |  | Markus Myers | 2 | N/A | -55 +85C | 20% | 22uF |  | 6.3V | 0.0
C927 | https://app.bom.com/a/R9SATDWDWFPQ5RBU?v=files.associations | Capacitor | X5R | PAS - Passives | 2011-10-31T17:27:40-08:00 | CAP, 22uF, 6.3V, 20%, X5R, CERAMIC, 0603 | Capacitor | 2012-11-19T09:07:33-08:00 | 0603C_WIDE_BODY | N/A | MURATA GRM188R60J226MEA0D | GRM188R60J226MEA0D | TDK C1608X5R0J226MT | C1608X5R0J226MT |  |  |  |  |  |  | Chris Ivanciuc | 1mm | Production |  | Markus Myers | 2 | N/A | -55 +85C | 20% | 22uF |  | 6.3V | 0.0
C928 | https://app.bom.com/a/R9SATDWDWFPQ5RBU?v=files.associations | Capacitor | X5R | PAS - Passives | 2011-10-31T17:27:40-08:00 | CAP, 22uF, 6.3V, 20%, X5R, CERAMIC, 0603 | Capacitor | 2012-11-19T09:07:33-08:00 | 0603C_WIDE_BODY | N/A | MURATA GRM188R60J226MEA0D | GRM188R60J226MEA0D | TDK C1608X5R0J226MT | C1608X5R0J226MT |  |  |  |  |  |  | Chris Ivanciuc | 1mm | Production |  | Markus Myers | 2 | N/A | -55 +85C | 20% | 22uF |  | 6.3V | 0.0
C929 | https://app.bom.com/a/2K3L4O7O7Q7V9AYD?v=files.associations | Capacitor | X5R | PAS - Passives | 2011-05-10T11:01:11-08:00 | CAP, 100nF, 10V, 10%, X5R, CERAMIC, 0402 | Capacitor | 2013-11-26T22:59:31-08:00 | 0402C |  | MURATA GRM155R61A104KA01D | GRM155R61A104KA01D | TAIYO YUDEN LMK105BJ104KV-F | LMK105BJ104KV-F |  |  |  |  |  |  | Michael Sorensen | 0.55mm | Production |  | Michael Sorensen | 1 |  | -55 +85C | 10% | 100nF |  | 10V | 0.0
C930 | https://app.bom.com/a/2K3L4O7O7Q7V9AYD?v=files.associations | Capacitor | X5R | PAS - Passives | 2011-05-10T11:01:11-08:00 | CAP, 100nF, 10V, 10%, X5R, CERAMIC, 0402 | Capacitor | 2013-11-26T22:59:31-08:00 | 0402C |  | MURATA GRM155R61A104KA01D | GRM155R61A104KA01D | TAIYO YUDEN LMK105BJ104KV-F | LMK105BJ104KV-F |  |  |  |  |  |  | Michael Sorensen | 0.55mm | Production |  | Michael Sorensen | 1 |  | -55 +85C | 10% | 100nF |  | 10V | 0.0
C931 | https://app.bom.com/a/2K3L4O7O7Q7V9AYD?v=files.associations | Capacitor | X5R | PAS - Passives | 2011-05-10T11:01:11-08:00 | CAP, 100nF, 10V, 10%, X5R, CERAMIC, 0402 | Capacitor | 2013-11-26T22:59:31-08:00 | 0402C |  | MURATA GRM155R61A104KA01D | GRM155R61A104KA01D | TAIYO YUDEN LMK105BJ104KV-F | LMK105BJ104KV-F |  |  |  |  |  |  | Michael Sorensen | 0.55mm | Production |  | Michael Sorensen | 1 |  | -55 +85C | 10% | 100nF |  | 10V | 0.0
C932 | https://app.bom.com/a/2K3L4O7O7Q7V9AYD?v=files.associations | Capacitor | X5R | PAS - Passives | 2011-05-10T11:01:11-08:00 | CAP, 100nF, 10V, 10%, X5R, CERAMIC, 0402 | Capacitor | 2013-11-26T22:59:31-08:00 | 0402C |  | MURATA GRM155R61A104KA01D | GRM155R61A104KA01D | TAIYO YUDEN LMK105BJ104KV-F | LMK105BJ104KV-F |  |  |  |  |  |  | Michael Sorensen | 0.55mm | Production |  | Michael Sorensen | 1 |  | -55 +85C | 10% | 100nF |  | 10V | 0.0
C933 | https://app.bom.com/a/2K3L4O7O7Q7V9AYD?v=files.associations | Capacitor | X5R | PAS - Passives | 2011-05-10T11:01:11-08:00 | CAP, 100nF, 10V, 10%, X5R, CERAMIC, 0402 | Capacitor | 2013-11-26T22:59:31-08:00 | 0402C |  | MURATA GRM155R61A104KA01D | GRM155R61A104KA01D | TAIYO YUDEN LMK105BJ104KV-F | LMK105BJ104KV-F |  |  |  |  |  |  | Michael Sorensen | 0.55mm | Production |  | Michael Sorensen | 1 |  | -55 +85C | 10% | 100nF |  | 10V | 0.0
C940 | https://app.bom.com/a/N5O6P9S9SBU5DYQF?v=files.associations | Capacitor | X7R | PAS - Passives | 2008-08-21T16:59:08-08:00 | CAP, 100nF, 16V, 10%, X7R, CERAMIC, 0402 | Capacitor | 2012-02-01T15:49:25-08:00 | 0402C | N/A | NIC COMPONENTS NMC0402X7R104K16TRPF | NMC0402X7R104K16TRPF | MURATA GRM155R71C104KA88D | GRM155R71C104KA88D | VISHAY VJ0402V104ZXJCW1BC | VJ0402V104ZXJCW1BC |  |  |  |  | Morris Chau | 0.55mm | Production |  | Airlink | 2 | N/A | -55 +125C | 10% | 100nF |  | 16V | 0.0
C941 | https://app.bom.com/a/N5O6P9S9SBU5DYQF?v=files.associations | Capacitor | X7R | PAS - Passives | 2008-08-21T16:59:08-08:00 | CAP, 100nF, 16V, 10%, X7R, CERAMIC, 0402 | Capacitor | 2012-02-01T15:49:25-08:00 | 0402C | N/A | NIC COMPONENTS NMC0402X7R104K16TRPF | NMC0402X7R104K16TRPF | MURATA GRM155R71C104KA88D | GRM155R71C104KA88D | VISHAY VJ0402V104ZXJCW1BC | VJ0402V104ZXJCW1BC |  |  |  |  | Morris Chau | 0.55mm | Production |  | Airlink | 2 | N/A | -55 +125C | 10% | 100nF |  | 16V | 0.0
C943 | https://app.bom.com/a/6O7P8SBSBUDMZMOD?v=files.associations | Capacitor | X5R | PAS - Passives | 2009-03-11T13:25:27-08:00 | CAP, 1uF, 10V, 10%, X5R, CERAMIC, 0402 | Capacitor | 2014-03-12T04:39:29-08:00 | 0402C | N/A | MURATA GRM155R61A105KE15D | GRM155R61A105KE15D | TAIYO YUDEN LMK105BJ105KV-F | LMK105BJ105KV-F |  |  |  |  |  |  | Morris Chau | 0.55mm | Production |  | Kristi Eng | 2 | N/A | -55 +85C | 10% | 1uF |  | 10V | 0.0
C945 | https://app.bom.com/a/6O7P8SBSBUDMZMOD?v=files.associations | Capacitor | X5R | PAS - Passives | 2009-03-11T13:25:27-08:00 | CAP, 1uF, 10V, 10%, X5R, CERAMIC, 0402 | Capacitor | 2014-03-12T04:39:29-08:00 | 0402C | N/A | MURATA GRM155R61A105KE15D | GRM155R61A105KE15D | TAIYO YUDEN LMK105BJ105KV-F | LMK105BJ105KV-F |  |  |  |  |  |  | Morris Chau | 0.55mm | Production |  | Kristi Eng | 2 | N/A | -55 +85C | 10% | 1uF |  | 10V | 0.0
C950 | https://app.bom.com/a/N5O6P9S9SBU5DYQF?v=files.associations | Capacitor | X7R | PAS - Passives | 2008-08-21T16:59:08-08:00 | CAP, 100nF, 16V, 10%, X7R, CERAMIC, 0402 | Capacitor | 2012-02-01T15:49:25-08:00 | 0402C | N/A | NIC COMPONENTS NMC0402X7R104K16TRPF | NMC0402X7R104K16TRPF | MURATA GRM155R71C104KA88D | GRM155R71C104KA88D | VISHAY VJ0402V104ZXJCW1BC | VJ0402V104ZXJCW1BC |  |  |  |  | Morris Chau | 0.55mm | Production |  | Airlink | 2 | N/A | -55 +125C | 10% | 100nF |  | 16V | 0.0
C951 | https://app.bom.com/a/N5O6P9S9SBU5DYQF?v=files.associations | Capacitor | X7R | PAS - Passives | 2008-08-21T16:59:08-08:00 | CAP, 100nF, 16V, 10%, X7R, CERAMIC, 0402 | Capacitor | 2012-02-01T15:49:25-08:00 | 0402C | N/A | NIC COMPONENTS NMC0402X7R104K16TRPF | NMC0402X7R104K16TRPF | MURATA GRM155R71C104KA88D | GRM155R71C104KA88D | VISHAY VJ0402V104ZXJCW1BC | VJ0402V104ZXJCW1BC |  |  |  |  | Morris Chau | 0.55mm | Production |  | Airlink | 2 | N/A | -55 +125C | 10% | 100nF |  | 16V | 0.0
C952 | https://app.bom.com/a/M4N5O8R8RARFTUIV?v=files.associations | Capacitor | X5R | PAS - Passives | 2011-05-10T11:00:44-08:00 | CAP, 10uF, 10V, 10%, X5R, CERAMIC, 0805 | Capacitor | 2013-02-20T15:53:29-08:00 | 0805C |  | MURATA GRM21BR61A106KE19L | GRM21BR61A106KE19L | TAIYO YUDEN LMK212BJ106KG-T | LMK212BJ106KG-T |  |  |  |  |  |  | Michael Sorensen | 1.35mm | Production |  | Michael Sorensen | 1 |  | -55 +85C | 10% | 10uF |  | 10V | 0.0
C953 | https://app.bom.com/a/N5O6P9S9SBU5DYQF?v=files.associations | Capacitor | X7R | PAS - Passives | 2008-08-21T16:59:08-08:00 | CAP, 100nF, 16V, 10%, X7R, CERAMIC, 0402 | Capacitor | 2012-02-01T15:49:25-08:00 | 0402C | N/A | NIC COMPONENTS NMC0402X7R104K16TRPF | NMC0402X7R104K16TRPF | MURATA GRM155R71C104KA88D | GRM155R71C104KA88D | VISHAY VJ0402V104ZXJCW1BC | VJ0402V104ZXJCW1BC |  |  |  |  | Morris Chau | 0.55mm | Production |  | Airlink | 2 | N/A | -55 +125C | 10% | 100nF |  | 16V | 0.0
C954 | https://app.bom.com/a/N5O6P9S9SBU5DYQF?v=files.associations | Capacitor | X7R | PAS - Passives | 2008-08-21T16:59:08-08:00 | CAP, 100nF, 16V, 10%, X7R, CERAMIC, 0402 | Capacitor | 2012-02-01T15:49:25-08:00 | 0402C | N/A | NIC COMPONENTS NMC0402X7R104K16TRPF | NMC0402X7R104K16TRPF | MURATA GRM155R71C104KA88D | GRM155R71C104KA88D | VISHAY VJ0402V104ZXJCW1BC | VJ0402V104ZXJCW1BC |  |  |  |  | Morris Chau | 0.55mm | Production |  | Airlink | 2 | N/A | -55 +125C | 10% | 100nF |  | 16V | 0.0
C955 | https://app.bom.com/a/M4N5O8R8RARFTUIV?v=files.associations | Capacitor | X5R | PAS - Passives | 2011-05-10T11:00:44-08:00 | CAP, 10uF, 10V, 10%, X5R, CERAMIC, 0805 | Capacitor | 2013-02-20T15:53:29-08:00 | 0805C |  | MURATA GRM21BR61A106KE19L | GRM21BR61A106KE19L | TAIYO YUDEN LMK212BJ106KG-T | LMK212BJ106KG-T |  |  |  |  |  |  | Michael Sorensen | 1.35mm | Production |  | Michael Sorensen | 1 |  | -55 +85C | 10% | 10uF |  | 10V | 0.0
CN1000 | https://app.bom.com/a/WEXFYI1I1K3L04ON?v=files.associations | Connector |  | EM - Electro Mechanical | 2004-09-20T20:05:36-08:00 | CONN, 3 PIN, RF, ULTRA MINIATURE, STRAIGHT, 0-6GHz, U.FL, 3x3.1x1.45mm | Connector | 2014-04-28T09:22:48-08:00 | CONN_3P_0300x0310_RF_HIROSE | N/A | HIROSE U.FL-R-SMT(10) | U.FL-R-SMT(10) | HIROSE U.FL-R-SMT-1(80) | U.FL-R-SMT-1(80) | HIROSE U.FL-R-SMT-1(10) | U.FL-R-SMT-1(10) | IPEX 20279-001E-03 | 20279-001E-03 | IPEX 20279-001E-01 | 20279-001E-01 | Rex Lee | 1.45mm | Production |  | Patrik Lilja | 4 | N/A | -40 +90C |  |  |  |  | 0.0
CN301 | https://app.bom.com/a/WEXFYI1I1K3L04ON?v=files.associations | Connector |  | EM - Electro Mechanical | 2004-09-20T20:05:36-08:00 | CONN, 3 PIN, RF, ULTRA MINIATURE, STRAIGHT, 0-6GHz, U.FL, 3x3.1x1.45mm | Connector | 2014-04-28T09:22:48-08:00 | CONN_3P_0300x0310_RF_HIROSE | N/A | HIROSE U.FL-R-SMT(10) | U.FL-R-SMT(10) | HIROSE U.FL-R-SMT-1(80) | U.FL-R-SMT-1(80) | HIROSE U.FL-R-SMT-1(10) | U.FL-R-SMT-1(10) | IPEX 20279-001E-03 | 20279-001E-03 | IPEX 20279-001E-01 | 20279-001E-01 | Rex Lee | 1.45mm | Production |  | Patrik Lilja | 4 | N/A | -40 +90C |  |  |  |  | 0.0
CN302 | https://app.bom.com/a/WEXFYI1I1K3L04ON?v=files.associations | Connector |  | EM - Electro Mechanical | 2004-09-20T20:05:36-08:00 | CONN, 3 PIN, RF, ULTRA MINIATURE, STRAIGHT, 0-6GHz, U.FL, 3x3.1x1.45mm | Connector | 2014-04-28T09:22:48-08:00 | CONN_3P_0300x0310_RF_HIROSE | N/A | HIROSE U.FL-R-SMT(10) | U.FL-R-SMT(10) | HIROSE U.FL-R-SMT-1(80) | U.FL-R-SMT-1(80) | HIROSE U.FL-R-SMT-1(10) | U.FL-R-SMT-1(10) | IPEX 20279-001E-03 | 20279-001E-03 | IPEX 20279-001E-01 | 20279-001E-01 | Rex Lee | 1.45mm | Production |  | Patrik Lilja | 4 | N/A | -40 +90C |  |  |  |  | 0.0
CN303 | https://app.bom.com/a/WEXFYI1I1K3L04ON?v=files.associations | Connector |  | EM - Electro Mechanical | 2004-09-20T20:05:36-08:00 | CONN, 3 PIN, RF, ULTRA MINIATURE, STRAIGHT, 0-6GHz, U.FL, 3x3.1x1.45mm | Connector | 2014-04-28T09:22:48-08:00 | CONN_3P_0300x0310_RF_HIROSE | N/A | HIROSE U.FL-R-SMT(10) | U.FL-R-SMT(10) | HIROSE U.FL-R-SMT-1(80) | U.FL-R-SMT-1(80) | HIROSE U.FL-R-SMT-1(10) | U.FL-R-SMT-1(10) | IPEX 20279-001E-03 | 20279-001E-03 | IPEX 20279-001E-01 | 20279-001E-01 | Rex Lee | 1.45mm | Production |  | Patrik Lilja | 4 | N/A | -40 +90C |  |  |  |  | 0.0
CN304 | https://app.bom.com/a/TBUCVFYFYH0FAY4V?v=files.associations | Connector |  | EM - Electro Mechanical | 2007-08-16T11:34:49-08:00 | CONN, USB, TYPE A, RECEPTACLE, RIGHT ANGLE, THRU, 14.5x14x7.7mm | Connector | 2015-07-14T23:32:01-08:00 | CONN_4P_1450x1400_USB_2GND_RA_THRU | N/A | FCI 87520-5012BPSLF | 87520-5012BPSLF |  |  |  |  |  |  |  |  | Michael Sorensen | 7.25mm | Production |  | Kristi Eng | 1.0 | N/A |  |  |  |  |  | 0.0
CN305 | https://app.bom.com/a/O6P7QATATCV3LACA?v=files.associations | Connector | TYPE A/B | EM - Electro Mechanical | 2010-01-04T16:06:20-08:00 | CONN, USB, MICRO, TYPE A/B, RECEPTACLE, RIGHT ANGLE, REVERSE (TOP MOUNT), THRU/SMT, 7.5x5.6x2.8mm | Connector | 2013-01-21T17:27:08-08:00 | CONN_5P_0750x0560_USB_5GND_HRS_ZX62RD | N/A | HIROSE ZX62RD-AB-5P8 | ZX62RD-AB-5P8 |  |  |  |  |  |  |  |  | Rex Lee | 2.8mm | Production |  | Warren Chen | 1 | N/A | -30 +85C |  |  |  |  | 0.0
CN306 | https://agiledev.sierrawireless.local/Agile/object/Parts/3015145 | Connector |  | EMC - CABLE / CONNECTOR / SWITCH | 2016-12-20T18:35:03Z | CONN, 38 PIN, EVERCLEAR ENHANCED, HIGH SPEED, SMT-RA, 18.2x11.5x5.48mm | Connector |  | CONN_38P_1820x1150_0080CC_EVERCLEAR | N/A | AMPHENOL FS1-R38-20A2-00 | FS1-R38-20A2-00 |  |  |  |  |  |  |  |  |  | 5.48mm | Prototype |  | Marco Tozzini | 1 | N/A | -55 +105C |  | FS1-R38-20A2-00 |  | 120VAC | 0.0
CN307 | https://agiledev.sierrawireless.local/Agile/object/Parts/3015034 | Connector |  | EM - Electro Mechanical | 2016-09-14T00:37:38Z | CONN, 26 PIN, HEADER, DUAL ROW, MALE, THRU, 2.54MM PITCH, 33x4.83x11.56mm | Connector |  | CONN_26P_3300x0483_0254CC_HEADER_THRU | N/A | AMPHENOL 67997-226HLF | 67997-226HLF |  |  |  |  |  |  |  |  |  | 11.56mm | Prototype |  | Marco Tozzini | 1 | N/A | -65 +125C |  | 67997-226HLF |  | 1500V | 0.0
CN310 | https://app.bom.com/a/WEXFYI1I1KJ2B058?v=files.associations | Connector |  | EM - Electro Mechanical | 2015-03-24T09:07:45-08:00 | CONN, 6 PIN, HEADER, DUAL ROW, MALE, THRU, 2.54mm PITCH, 7.62x5.08x8.38mm | Connector | 2015-10-23T11:09:21-08:00 | CONN_6P_0760x0510_HEADER_THRU_0254CC | N/A | SAMTEC TSW-103-07-G-D | TSW-103-07-G-D |  |  |  |  |  |  |  |  | Carson Turnbull | 8.38mm | Production | 4.3A | Marco Tozzini | 1 | N/A | -55 +125C |  | TSW-103-07-G-D |  | 400V | 0.0
CN312 | https://app.bom.com/a/WEXFYI1I1KJ2B058?v=files.associations | Connector |  | EM - Electro Mechanical | 2015-03-24T09:07:45-08:00 | CONN, 6 PIN, HEADER, DUAL ROW, MALE, THRU, 2.54mm PITCH, 7.62x5.08x8.38mm | Connector | 2015-10-23T11:09:21-08:00 | CONN_6P_0760x0510_HEADER_THRU_0254CC | N/A | SAMTEC TSW-103-07-G-D | TSW-103-07-G-D |  |  |  |  |  |  |  |  | Carson Turnbull | 8.38mm | Production | 4.3A | Marco Tozzini | 1 | N/A | -55 +125C |  | TSW-103-07-G-D |  | 400V | 0.0
CN400 | https://app.bom.com/a/K2L3M6P6P88TKRKK?v=files.associations | Connector |  | EM - Electro Mechanical | 2014-12-23T09:08:01-08:00 | CONN, 10-PIN, HEADER, DUAL ROW, FEMALE, SMT, 1.27mm PITCH, 6.73x3.05x4.57mm | Connector | 2014-12-24T11:35:01-08:00 | CONN_10P_0673x0305_0127CC_SMT | N/A | SAMTEC SFMC-105-02-L-D-TR | SFMC-105-02-L-D-TR |  |  |  |  |  |  |  |  | Carson Turnbull | 4.57mm | Design | 2.9A | Marco Tozzini | 1 | N/A | -55 +125C |  | SFMC-105-02-L-D-TR | DNI |  | 0.0
CN401 | https://app.bom.com/a/K2L3M6P6P88TKRKK?v=files.associations | Connector |  | EM - Electro Mechanical | 2014-12-23T09:08:01-08:00 | CONN, 10-PIN, HEADER, DUAL ROW, FEMALE, SMT, 1.27mm PITCH, 6.73x3.05x4.57mm | Connector | 2014-12-24T11:35:01-08:00 | CONN_10P_0673x0305_0127CC_SMT | N/A | SAMTEC SFMC-105-02-L-D-TR | SFMC-105-02-L-D-TR |  |  |  |  |  |  |  |  | Carson Turnbull | 4.57mm | Design | 2.9A | Marco Tozzini | 1 | N/A | -55 +125C |  | SFMC-105-02-L-D-TR | DNI |  | 0.0
CN500 | https://app.bom.com/a/UCVDWGZGZII7SP5S?v=files.associations | Connector | 3.5MM | EM - Electro Mechanical | 2014-01-29T18:38:14-08:00 | CONN, 6 PIN, 3.5MM AUDIO JACK, SWITCH, RIGHT ANGLE, SMT/THRU HOLE, 14.8x6.4x4.35mm | Connector | 2014-08-15T09:07:57-08:00 | CONN_6P_1480x0640_AUDIO_JACK_DUAL | N/A | ACON AJR2Q-6K2011 | AJR2Q-6K2011 |  |  |  |  |  |  |  |  | Kenny Wong | 4.35mm | Production | 1A | Youngman Kim | 1 | N/A | -25 +70C |  | 3.5MM AUDIO JACK |  |  | 0.0
CN600 | https://app.bom.com/a/5N6O7RARATTF48A3?v=files.associations | Connector |  | EM - Electro Mechanical | 2014-10-06T09:19:56-08:00 | CONN, 25-PIN, MICROSD/SIM COMBO, SWITCH, 17.8x12.9x1.28mm | Connector | 2014-10-06T17:17:57-08:00 | CONN_25P_1780x1290_0088CC_MICROSDSIM | N/A | MOLEX 104168-1620 | 104168-1620 |  |  |  |  |  |  |  |  | Carson Turnbull | 1.28mm | Design | 0.5A | Marco Tozzini | 1 | N/A | -40 +85C |  |  |  | 10V | 0.0
CN801 | https://app.bom.com/a/O6P7QATATCV3LACA?v=files.associations | Connector | TYPE A/B | EM - Electro Mechanical | 2010-01-04T16:06:20-08:00 | CONN, USB, MICRO, TYPE A/B, RECEPTACLE, RIGHT ANGLE, REVERSE (TOP MOUNT), THRU/SMT, 7.5x5.6x2.8mm | Connector | 2013-01-21T17:27:08-08:00 | CONN_5P_0750x0560_USB_5GND_HRS_ZX62RD | N/A | HIROSE ZX62RD-AB-5P8 | ZX62RD-AB-5P8 |  |  |  |  |  |  |  |  | Rex Lee | 2.8mm | Production |  | Warren Chen | 1 | N/A | -30 +85C |  |  |  |  | 0.0
CN802 | https://app.bom.com/a/M4N5O8R8RA9SYJWV?v=files.associations | Connector |  | EM - Electro Mechanical | 2015-03-31T13:14:57-08:00 | CONN, 2 PIN, HEADER, SHROUDED, MALE, THRU, 2mm PITCH, 5.9x4.5x6mm | Connector | 2015-03-31T13:42:24-08:00 | CONN_2P_0590x0450_0200CC_THRU_HEADER | N/A | JST B2B-PH-K-S | B2B-PH-K-S |  |  |  |  |  |  |  |  | Carson Turnbull | 6mm | Design | 2A | Marco Tozzini | 1 | N/A | -25 +85C |  | B2B-PH-K-S |  | 100V | 0.0
CN804 | https://app.bom.com/a/9RASBVEVEXGZZSSE?v=files.associations | Connector | 2.54MM PITCH | EM - Electro Mechanical | 2003-10-24T15:30:07-08:00 | CONN, 3 PIN, VERTICAL HEADER, POST TERMINAL STRIP, SINGLE ROW, 2.54MM PITCH, THRU, 7.62x2.54x10.7mm | Connector | 2012-02-08T11:33:45-08:00 | CONN_3P_0762x0254_VERTICAL_HEADER_SINGLE_ROW_THRU_SAMTEC_TSW | N/A | SAMTEC TSW-103-14-T-S | TSW-103-14-T-S |  |  |  |  |  |  |  |  | Rex Lee | 10.7mm | Production |  | Honda Ng | 2 | N/A | -65 +125C |  | POST TERMINAL STRIP |  |  | 0.0
D200 | https://app.bom.com/a/I0J1K4N4N66W3SE5?v=files.associations | Diode | GREEN | DIS - Discretes | 2013-06-06T02:29:42-08:00 | LED, GREEN, RIGHT ANGLE, SMT, 2V, 25mA, 3x2x1mm | Diode | 2014-05-06T18:58:39-08:00 | LED_3P_0300x0200_RA | N/A | EVERLIGHT ELECTRONICS 12-21SYGC/S530-E2/TR8 | 12-21SYGC/S530-E2/TR8 |  |  |  |  |  |  |  |  | Brian Ng | 1mm | Production | 25mA | Tony Li | 1 | N/A | -40 +85C |  | LED GREEN |  | 2V | 0.0
D301 | https://app.bom.com/a/DVEWFZIZI1KSUFSD?v=files.associations | Diode | ESD | PAS - Passives | 2010-02-23T11:56:19-08:00 | DIO, ESD SUPPRESSOR, POLYMER, 30V, 0.05pF, LOW CAPACITANCE, 0402 | Diode | 2014-03-12T09:04:32-08:00 | 0402E | N/A | COOPER BUSSMANN 0402ESDA-MLP1 | 0402ESDA-MLP1 |  |  |  |  |  |  |  |  | Morris Chau | 0.45mm | Production | 15kV | Patrik Lilja | 2 | N/A | -55 +125C |  | 0.05pF | DNI | 30V | 0.0
D302 | https://app.bom.com/a/DVEWFZIZI1KSUFSD?v=files.associations | Diode | ESD | PAS - Passives | 2010-02-23T11:56:19-08:00 | DIO, ESD SUPPRESSOR, POLYMER, 30V, 0.05pF, LOW CAPACITANCE, 0402 | Diode | 2014-03-12T09:04:32-08:00 | 0402E | N/A | COOPER BUSSMANN 0402ESDA-MLP1 | 0402ESDA-MLP1 |  |  |  |  |  |  |  |  | Morris Chau | 0.45mm | Production | 15kV | Patrik Lilja | 2 | N/A | -55 +125C |  | 0.05pF | DNI | 30V | 0.0
D303 | https://app.bom.com/a/DVEWFZIZI1KSUFSD?v=files.associations | Diode | ESD | PAS - Passives | 2010-02-23T11:56:19-08:00 | DIO, ESD SUPPRESSOR, POLYMER, 30V, 0.05pF, LOW CAPACITANCE, 0402 | Diode | 2014-03-12T09:04:32-08:00 | 0402E | N/A | COOPER BUSSMANN 0402ESDA-MLP1 | 0402ESDA-MLP1 |  |  |  |  |  |  |  |  | Morris Chau | 0.45mm | Production | 15kV | Patrik Lilja | 2 | N/A | -55 +125C |  | 0.05pF | DNI | 30V | 0.0
D305 | https://app.bom.com/a/BTCUDXGXGZZUMI6K?v=files.associations | Diode |  | DIS - Discretes | 2012-07-11T15:11:40-08:00 | DIO, ESD PROTECTION, 4-LINES, USB-HS/USB OTG, DFN-6, 1.45x1x0.6mm | Diode | 2013-11-26T22:59:31-08:00 | DFN_6P_0145x0100_0050CC | N/A | TEXAS INSTRUMENTS TPD4S012DRYR | TPD4S012DRYR |  |  |  |  |  |  |  |  | Morris Chau | 0.6mm | Production |  | Franck Delcroix | 1 | N/A | -40 +85C |  |  |  |  | 0.0
D400 | https://app.bom.com/a/DVEWFZIZI1KSUFSD?v=files.associations | Diode | ESD | PAS - Passives | 2010-02-23T11:56:19-08:00 | DIO, ESD SUPPRESSOR, POLYMER, 30V, 0.05pF, LOW CAPACITANCE, 0402 | Diode | 2014-03-12T09:04:32-08:00 | 0402E | N/A | COOPER BUSSMANN 0402ESDA-MLP1 | 0402ESDA-MLP1 |  |  |  |  |  |  |  |  | Morris Chau | 0.45mm | Production | 15kV | Patrik Lilja | 2 | N/A | -55 +125C |  | 0.05pF | DNI | 30V | 0.0
D401 | https://app.bom.com/a/I0J1K4N4N66W3SE5?v=files.associations | Diode | GREEN | DIS - Discretes | 2013-06-06T02:29:42-08:00 | LED, GREEN, RIGHT ANGLE, SMT, 2V, 25mA, 3x2x1mm | Diode | 2014-05-06T18:58:39-08:00 | LED_3P_0300x0200_RA | N/A | EVERLIGHT ELECTRONICS 12-21SYGC/S530-E2/TR8 | 12-21SYGC/S530-E2/TR8 |  |  |  |  |  |  |  |  | Brian Ng | 1mm | Production | 25mA | Tony Li | 1 | N/A | -40 +85C |  | LED GREEN |  | 2V | 0.0
D402 | https://app.bom.com/a/I0J1K4N4N66W3SE5?v=files.associations | Diode | GREEN | DIS - Discretes | 2013-06-06T02:29:42-08:00 | LED, GREEN, RIGHT ANGLE, SMT, 2V, 25mA, 3x2x1mm | Diode | 2014-05-06T18:58:39-08:00 | LED_3P_0300x0200_RA | N/A | EVERLIGHT ELECTRONICS 12-21SYGC/S530-E2/TR8 | 12-21SYGC/S530-E2/TR8 |  |  |  |  |  |  |  |  | Brian Ng | 1mm | Production | 25mA | Tony Li | 1 | N/A | -40 +85C |  | LED GREEN |  | 2V | 0.0
D410 | https://app.bom.com/a/FXGYH1K1K3M446W1?v=files.associations | Diode | GREEN | DIS - Discretes | 2005-04-12T13:10:32-08:00 | LED, GREEN, TOP FIRE, SMT, 2.2V, 20mA, 0603 | Diode | 2013-11-27T08:58:20-08:00 | 0603D | N/A | ROHM SML-310MTT86 | SML-310MTT86 |  |  |  |  |  |  |  |  | Brian Ng | 0.9mm | Production | 20mA | Ryan Fallini | 4 | N/A | -30 +85C |  | LED GREEN |  | 2.2V | 0.0
D600 | https://app.bom.com/a/5N6O7RARATCOBWLT?v=files.associations | Diode | ESD | PAS - Passives | 2008-07-22T14:27:20-08:00 | DIO, ESD PROTECTION, 3 LINES, 8/15kV, 0.5pF, DFN-6, 1.45x1x0.65mm | Diode | 2014-04-28T09:22:48-08:00 | DFN_6P_0145x0100_0050CC | N/A | SEMTECH RClamp0503N.TCT | RClamp0503N.TCT |  |  |  |  |  |  |  |  | Morris Chau | 0.65mm | Production |  | Vivutha Men | 5 | N/A | -55 +125C |  | 0.5pF |  | 15kV | 0.0
D601 | https://app.bom.com/a/CUDVEYHYH00VNJ7H?v=files.associations | Diode | ESD | DIS - Discretes | 2012-07-11T15:11:41-08:00 | DIO, ESD PROTECTION, 6 LINES, HIGH-SPEED DATA INTERFACES, QFN-8, 1.5x1.5x0.6mm | Diode | 2013-11-28T00:48:02-08:00 | QFN_8P_0150x0150_0050CC | N/A | TEXAS INSTRUMENTS TPD6E004RSER | TPD6E004RSER |  |  |  |  |  |  |  |  | Morris Chau | 0.6mm | Production |  | Franck Delcroix | 1 | N/A | -40 +85C |  | 1.6pF |  |  | 0.0
D800 | https://app.bom.com/a/BTCUDXGXGZZUMI6K?v=files.associations | Diode |  | DIS - Discretes | 2012-07-11T15:11:40-08:00 | DIO, ESD PROTECTION, 4-LINES, USB-HS/USB OTG, DFN-6, 1.45x1x0.6mm | Diode | 2013-11-26T22:59:31-08:00 | DFN_6P_0145x0100_0050CC | N/A | TEXAS INSTRUMENTS TPD4S012DRYR | TPD4S012DRYR |  |  |  |  |  |  |  |  | Morris Chau | 0.6mm | Production |  | Franck Delcroix | 1 | N/A | -40 +85C |  |  |  |  | 0.0
D801 | https://app.bom.com/a/FXGYH1K1K3M446W1?v=files.associations | Diode | GREEN | DIS - Discretes | 2005-04-12T13:10:32-08:00 | LED, GREEN, TOP FIRE, SMT, 2.2V, 20mA, 0603 | Diode | 2013-11-27T08:58:20-08:00 | 0603D | N/A | ROHM SML-310MTT86 | SML-310MTT86 |  |  |  |  |  |  |  |  | Brian Ng | 0.9mm | Production | 20mA | Ryan Fallini | 4 | N/A | -30 +85C |  | LED GREEN | DNI | 2.2V | 0.0
D803 | https://agiledev.sierrawireless.local/Agile/object/Parts/3600208 | Diode |  | DIS - Discretes | 2016-04-14T22:30:33Z | DIO, LED, GREEN, DIFFUSED, 0603, 1.7x0.8x0.68mm | Diode |  | 0603D | N/A | OSRAM LG L29K-F2J1-24-Z | LG L29K-F2J1-24-Z |  |  |  |  |  |  |  |  |  | 0.68mm | Prototype |  | Raymond Li | 1 | N/A | -40 +100C |  | LG L29K-F2J1-24-Z |  | 12V | 0.0
FIL1000 |  | RF Filter |  | RFS - SWITCH / FILTER / ISOLATOR / DUPLEXER |  | FILTER, BALUN, CHIP, 2450MHz, +/-50MHz, 2W, 50 UNBALANCED/50 BALANCED, 1.6x0.8x0.7mm | RF_Filter |  | FIL_6P_0160x0080_0050CC_MURATA | N/A | ADVANCED CERAMIC X CORP BL1608-05A2450TB | BL1608-05A2450TB | WALSIN TECHNOLOGY RFBLN1608050AM8T62 | RFBLN1608050AM8T62 |  |  |  |  |  |  | Carson Turnbull | 0.7mm | Prototype |  | Ashish Syal | 1 | N/A | -40 +85C | 50MHz | 2450MHz |  |  | 0.0
J301 | https://app.bom.com/a/0I1J2M5M5O7JVHSE?v=files.associations | Misc Electrical |  | EM - Electro Mechanical | 2008-05-21T15:18:41-08:00 | CONN, 1 PIN, SPRING CLIP, 4.95x1.1x4mm | Misc_Electrical | 2015-04-09T13:44:05-08:00 | CONN_1P_0490x0110_SPRING_CLIP | N/A | ITT INTERCONNECT SOLUTIONS CU-120220-0206 | CU-120220-0206 | MCR01MZPJ301 | MCR01MZPJ301 |  |  |  |  |  |  | Michael Sorensen | 4mm | Production |  | Kent Crandall | 2 | N/A |  |  |  | DNI |  | 0.0
J302 | https://app.bom.com/a/0I1J2M5M5O7JVHSE?v=files.associations | Misc Electrical |  | EM - Electro Mechanical | 2008-05-21T15:18:41-08:00 | CONN, 1 PIN, SPRING CLIP, 4.95x1.1x4mm | Misc_Electrical | 2015-04-09T13:44:05-08:00 | CONN_1P_0490x0110_SPRING_CLIP | N/A | ITT INTERCONNECT SOLUTIONS CU-120220-0206 | CU-120220-0206 |  |  |  |  |  |  |  |  | Michael Sorensen | 4mm | Production |  | Kent Crandall | 2 | N/A |  |  |  | DNI |  | 0.0
L1000 | https://app.bom.com/a/1J2K3N6N6PV2KWR8?v=files.associations | RF Filter Inductor |  | RFS - SWITCH / FILTER / ISOLATOR / DUPLEXER PAS - Passives | 2012-01-30T17:37:21-08:00 | FILTER, BALUN, CHIP, 2450MHz, +/-50MHz, 2W, 50 UNBALANCED/50 BALANCED, 1.6x0.8x0.7mm IND, 2.2uH, 30%, 1.1A, DCR=0.11 OHM, MULTILAYER, 2.5x2x1mm | RF_Filter Inductor | 2012-09-13T10:31:14-08:00 | FIL_6P_0160x0080_0050CC_MURATA IND_2P_0250x0200_0190CC_GENERIC | N/A N/A | ADVANCED CERAMIC X CORP BL1608-05A2450TB FDK MIPSZ2520D2R2 | BL1608-05A2450TB MIPSZ2520D2R2 | WALSIN TECHNOLOGY RFBLN1608050AM8T62 | RFBLN1608050AM8T62 |  |  |  |  |  |  | Carson Turnbull Chris Ivanciuc | 0.7mm 1mm | Prototype Production | 1.1A | Ashish Syal Sajeev Alakkatt | 1 1 | N/A N/A | -40 +85C -40 +85C | 50MHz 30% | 2450MHz 2.2uH |  |  | 0.0
L1001 | https://agiledev.sierrawireless.local/Agile/object/Parts/3300143 | Inductor |  | PAS - Passives | 2012-01-04T01:15:16Z | IND, 1.2nH, +/-0.1nH, 280mA, 0201 | Inductor | 2012-08-03T15:32:37-08:00 | 0201L | N/A | MURATA LQP03TN1N2B02D | LQP03TN1N2B02D | MURATA LQP03TN1N2B00D | LQP03TN1N2B00D |  |  |  |  |  |  | Morris Chau | 0.35mm | Production | 280mA | Edison Li | 2 | N/A | -40 +85C | 0.1nH | 1.2nH |  |  | 0.0
L1002 | https://agiledev.sierrawireless.local/Agile/object/Parts/3300143 | Inductor |  | PAS - Passives | 2012-01-04T01:15:16Z | IND, 1.2nH, +/-0.1nH, 280mA, 0201 | Inductor | 2012-08-03T15:32:37-08:00 | 0201L | N/A | MURATA LQP03TN1N2B02D | LQP03TN1N2B02D | MURATA LQP03TN1N2B00D | LQP03TN1N2B00D |  |  |  |  |  |  | Morris Chau | 0.35mm | Production | 280mA | Edison Li | 2 | N/A | -40 +85C | 0.1nH | 1.2nH |  |  | 0.0
L1026 | https://agiledev.sierrawireless.local/Agile/object/Parts/3016096 | Inductor | Murata & TDK Dual Source SWI P/N | PAS - PASSIVES | 2017-03-15T07:01:12Z | IND, 1.2nH, +/-0.1nH, 280mA, 0201 | Inductor |  | 0201L | N/A | MURATA LQP03TN1N2B02D | LQP03TN1N2B02D | MURATA LQP03TN1N2B00D | LQP03TN1N2B00D | TDK MLG0603P1N2BT000 | MLG0603P1N2BT000 |  |  |  |  |  | 0.35mm | Prototype |  | Grant Chen | 1 | N/A | -40 +85C | 0.1nH | 1.2nH |  |  | 0.0
L1087 | https://app.bom.com/a/0I1J2M5M5OOJ4LJO?v=files.associations | Inductor | Murata Single Source SWI P/N | PAS - Passives | 2012-08-10T13:43:59-08:00 | IND, 2.4nH, +/-0.2nH, 440mA, 0201 | Inductor | 2015-03-17T09:10:18-08:00 | 0201L | N/A | MURATA LQP03TN2N4C02D | LQP03TN2N4C02D |  |  |  |  |  |  |  |  | Morris Chau | 0.35mm | Production | 440mA | Mark Van Hoorebeke | 1 | N/A | -40 +85C | 0.2nH | 2.4nH |  |  | 0.0
L300 | https://app.bom.com/a/L3M4N7Q7Q9SAPWCH?v=files.associations | Inductor |  | PAS - Passives | 2004-09-16T15:57:35-08:00 | IND, 47nH, 5%, 200mA, 0402 | Inductor | 2013-05-16T08:55:35-08:00 | 0402L | N/A | MURATA LQG15HN47NJ02D | LQG15HN47NJ02D | TAIYO YUDEN LG HK 1005 47NJ-T | LG HK 1005 47NJ-T |  |  |  |  |  |  | Morris Chau | 0.55mm | Production | 200mA | Paul Li | 1.0 | N/A | -55 +125C | 5% | 47nH |  |  | 0.0
L500 | https://app.bom.com/a/ASBTCWFWFYH2NE81?v=files.associations | Inductor | 600 OHM | PAS - Passives | 2010-12-09T11:25:14-08:00 | FERRITE BEAD, 600 OHM@100MHz, 25%, 420mA, DCR=0.34 OHM, 0402 | Inductor | 2013-10-29T02:27:03-08:00 | 0402L |  | MURATA |  | TAIYO YUDEN BK1005HS601-T | BK1005HS601-T |  |  |  |  |  |  | Morris Chau | 0.55mm | Production | 420mA | Franck Delcroix | 1 |  | -55 +125C | 25% | 0H |  |  | 0.0
L501 | https://app.bom.com/a/ASBTCWFWFYH2NE81?v=files.associations | Inductor | 600 OHM | PAS - Passives | 2010-12-09T11:25:14-08:00 | FERRITE BEAD, 600 OHM@100MHz, 25%, 420mA, DCR=0.34 OHM, 0402 | Inductor | 2013-10-29T02:27:03-08:00 | 0402L |  | MURATA |  | TAIYO YUDEN BK1005HS601-T | BK1005HS601-T |  |  |  |  |  |  | Morris Chau | 0.55mm | Production | 420mA | Franck Delcroix | 1 |  | -55 +125C | 25% | 0H |  |  | 0.0
L502 | https://app.bom.com/a/FXGYH1K1K3M4JQ6H?v=files.associations | Inductor |  | PAS - Passives | 2004-09-16T15:57:32-08:00 | IND, 22nH, 5%, 200mA, 0402 | Inductor | 2011-12-02T13:52:33-08:00 | 0402L | N/A | TAIYO YUDEN LG HK 1005 22NJ-T | LG HK 1005 22NJ-T | MURATA LQG15HN22NJ02D | LQG15HN22NJ02D |  |  |  |  |  |  | Morris Chau | 0.55mm | Production | 200mA | Vivutha Men | 2 | N/A | -55 +125C | 5% | 22nH |  |  | 0.0
L503 | https://app.bom.com/a/FXGYH1K1K3M4JQ6H?v=files.associations | Inductor |  | PAS - Passives | 2004-09-16T15:57:32-08:00 | IND, 22nH, 5%, 200mA, 0402 | Inductor | 2011-12-02T13:52:33-08:00 | 0402L | N/A | TAIYO YUDEN LG HK 1005 22NJ-T | LG HK 1005 22NJ-T | MURATA LQG15HN22NJ02D | LQG15HN22NJ02D |  |  |  |  |  |  | Morris Chau | 0.55mm | Production | 200mA | Vivutha Men | 2 | N/A | -55 +125C | 5% | 22nH |  |  | 0.0
L504 | https://app.bom.com/a/ASBTCWFWFYH2NE81?v=files.associations | Inductor | 600 OHM | PAS - Passives | 2010-12-09T11:25:14-08:00 | FERRITE BEAD, 600 OHM@100MHz, 25%, 420mA, DCR=0.34 OHM, 0402 | Inductor | 2013-10-29T02:27:03-08:00 | 0402L |  | MURATA |  | TAIYO YUDEN BK1005HS601-T | BK1005HS601-T |  |  |  |  |  |  | Morris Chau | 0.55mm | Production | 420mA | Franck Delcroix | 1 |  | -55 +125C | 25% | 0H | MIC_OMTP |  | 0.0
L505 | https://app.bom.com/a/ASBTCWFWFYH2NE81?v=files.associations | Inductor | 600 OHM | PAS - Passives | 2010-12-09T11:25:14-08:00 | FERRITE BEAD, 600 OHM@100MHz, 25%, 420mA, DCR=0.34 OHM, 0402 | Inductor | 2013-10-29T02:27:03-08:00 | 0402L |  | MURATA |  | TAIYO YUDEN BK1005HS601-T | BK1005HS601-T |  |  |  |  |  |  | Morris Chau | 0.55mm | Production | 420mA | Franck Delcroix | 1 |  | -55 +125C | 25% | 0H | MIC_CTIA |  | 0.0
L506 | https://app.bom.com/a/ASBTCWFWFYH2NE81?v=files.associations | Inductor | 600 OHM | PAS - Passives | 2010-12-09T11:25:14-08:00 | FERRITE BEAD, 600 OHM@100MHz, 25%, 420mA, DCR=0.34 OHM, 0402 | Inductor | 2013-10-29T02:27:03-08:00 | 0402L |  | MURATA |  | TAIYO YUDEN BK1005HS601-T | BK1005HS601-T |  |  |  |  |  |  | Morris Chau | 0.55mm | Production | 420mA | Franck Delcroix | 1 |  | -55 +125C | 25% | 0H | MIC_OMTP |  | 0.0
L507 | https://app.bom.com/a/ASBTCWFWFYH2NE81?v=files.associations | Inductor | 600 OHM | PAS - Passives | 2010-12-09T11:25:14-08:00 | FERRITE BEAD, 600 OHM@100MHz, 25%, 420mA, DCR=0.34 OHM, 0402 | Inductor | 2013-10-29T02:27:03-08:00 | 0402L |  | MURATA |  | TAIYO YUDEN BK1005HS601-T | BK1005HS601-T |  |  |  |  |  |  | Morris Chau | 0.55mm | Production | 420mA | Franck Delcroix | 1 |  | -55 +125C | 25% | 0H | MIC_CTIA |  | 0.0
L508 | https://app.bom.com/a/2K3L4O7O7Q9R1EM6?v=files.associations | Inductor | 220 OHM | PAS - Passives | 2004-11-23T12:09:02-08:00 | FERRITE BEAD, 220 OHM@100MHz, 2A, DCR=0.05 OHM, 0603 | Inductor | 2011-12-02T13:52:33-08:00 | 0603L | N/A | TDK MPZ1608S221AT | MPZ1608S221AT |  |  |  |  |  |  |  |  | Morris Chau | 0.95mm | Production | 2A | Marcellin Akpa | 2 | N/A | -55 +125C |  | 0H |  |  | 0.0
L800 | https://app.bom.com/a/6O7P8SBSBUDURJP5?v=files.associations | Inductor | 90 OHM | PAS - Passives | 2006-06-29T13:08:11-08:00 | CHOKE, COMMON MODE, 90 OHM@100MHz, 25%, 100mA, 1x1.25x0.67mm | Inductor | 2014-03-03T23:43:52-08:00 | IND_4P_0100x0125_0055CC | N/A | PANASONIC EXC24CG900U | EXC24CG900U | TDK MCZ1210AH900T | MCZ1210AH900T | TDK TCM1210G-900-2P-T200 | TCM1210G-900-2P-T200 | TDK TCM1210-900-2P-T000 | TCM1210-900-2P-T000 |  |  | Morris Chau | 0.67mm | Production | 100mA | Ryan Fallini | 2 | N/A | -20 +85C | 25% | 0H |  |  | 0.0
L801 | https://app.bom.com/a/R9SATDWDWFF0IEHF?v=files.associations | Inductor |  | PAS - Passives | 2014-10-20T13:49:59-08:00 | IND, 3.3 uH, 20%, 6.6A, DCR=26mOHM, 4x4x3.1mm | Inductor | 2014-10-20T15:50:31-08:00 | IND_2P_0400x0400_0237CC_COILCRAFT | N/A | COILCRAFT XAL4030-332MEB | XAL4030-332MEB |  |  |  |  |  |  |  |  | Carson Turnbull | 3.1mm | Design | 6.6A | Marco Tozzini | 1 | N/A | -40 +125C | 20% | 3.3uH |  |  | 0.0
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
