leoheck/mangoh-red/mangoh-red.csv

Source: | /home/lheck/OLD_FILES/lheck/Downloads/mangoh-red-new/mangoh-red.sch
Date: | sáb 18 mai 2019 20:58:08 -03
Tool: | Eeschema 5.1.2-f72e74a~84~ubuntu19.04.1
Generator: | /usr/share/kicad/plugins/bom_csv_grouped_by_value.py
Component Count: | 561
Individual Components:
Item | Qty | Reference(s) | Value | LibPart | Footprint | Datasheet | DNI | I_LIM_MAX | MPN | Price | Tolerance | URL
 |  | ANT1000 | WLA.01 | MangOH-Red-Extra:WLA.01 | MangOH-Red:WLA.01 |  |  |  | WLA.01 | 13.35 |  | https://www.digikey.com/product-detail/en/taoglas-limited/WLA.01/931-1077-1-ND/2332742
 |  | C203 | 22p | Device:C | Capacitor_SMD:C_0402_1005Metric | ~ |  |  | GRM1555C1H220JA01D | 0.1 |  | https://www.digikey.com/product-detail/en/murata-electronics-north-america/GRM1555C1H220JA01D/490-5868-1-ND/3175200
 |  | C204 | 22p | Device:C | Capacitor_SMD:C_0402_1005Metric | ~ |  |  | GRM1555C1H220JA01D | 0.1 |  | https://www.digikey.com/product-detail/en/murata-electronics-north-america/GRM1555C1H220JA01D/490-5868-1-ND/3175200
 |  | C205 | 22p | Device:C | Capacitor_SMD:C_0402_1005Metric | ~ |  |  | GRM1555C1H220JA01D | 0.1 |  | https://www.digikey.com/product-detail/en/murata-electronics-north-america/GRM1555C1H220JA01D/490-5868-1-ND/3175200
 |  | C210 | 22p | Device:C | Capacitor_SMD:C_0402_1005Metric | ~ |  |  | GRM1555C1H220JA01D | 0.1 |  | https://www.digikey.com/product-detail/en/murata-electronics-north-america/GRM1555C1H220JA01D/490-5868-1-ND/3175200
 |  | C211 | 22p | Device:C | Capacitor_SMD:C_0402_1005Metric | ~ |  |  | GRM1555C1H220JA01D | 0.1 |  | https://www.digikey.com/product-detail/en/murata-electronics-north-america/GRM1555C1H220JA01D/490-5868-1-ND/3175200
 |  | C212 | 22p | Device:C | Capacitor_SMD:C_0402_1005Metric | ~ |  |  | GRM1555C1H220JA01D | 0.1 |  | https://www.digikey.com/product-detail/en/murata-electronics-north-america/GRM1555C1H220JA01D/490-5868-1-ND/3175200
 |  | C213 | 22p | Device:C | Capacitor_SMD:C_0402_1005Metric | ~ |  |  | GRM1555C1H220JA01D | 0.1 |  | https://www.digikey.com/product-detail/en/murata-electronics-north-america/GRM1555C1H220JA01D/490-5868-1-ND/3175200
 |  | C216 | 12p | Device:C | Capacitor_SMD:C_0402_1005Metric | ~ |  |  | GRM1555C1H120JA01D | 0.1 |  | https://www.digikey.com/product-detail/en/murata-electronics-north-america/GRM1555C1H120JA01D/490-5924-1-ND/3721281
 |  | C219 | 12p | Device:C | Capacitor_SMD:C_0402_1005Metric | ~ |  |  | GRM1555C1H120JA01D | 0.1 |  | https://www.digikey.com/product-detail/en/murata-electronics-north-america/GRM1555C1H120JA01D/490-5924-1-ND/3721281
 |  | C220 | 22p | Device:C | Capacitor_SMD:C_0402_1005Metric | ~ |  |  | GRM1555C1H220JA01D | 0.1 |  | https://www.digikey.com/product-detail/en/murata-electronics-north-america/GRM1555C1H220JA01D/490-5868-1-ND/3175200
 |  | C221 | 22p | Device:C | Capacitor_SMD:C_0402_1005Metric | ~ |  |  | GRM1555C1H220JA01D | 0.1 |  | https://www.digikey.com/product-detail/en/murata-electronics-north-america/GRM1555C1H220JA01D/490-5868-1-ND/3175200
 |  | C222 | 22p | Device:C | Capacitor_SMD:C_0402_1005Metric | ~ |  |  | GRM1555C1H220JA01D | 0.1 |  | https://www.digikey.com/product-detail/en/murata-electronics-north-america/GRM1555C1H220JA01D/490-5868-1-ND/3175200
 |  | C223 | 22p | Device:C | Capacitor_SMD:C_0402_1005Metric | ~ |  |  | GRM1555C1H220JA01D | 0.1 |  | https://www.digikey.com/product-detail/en/murata-electronics-north-america/GRM1555C1H220JA01D/490-5868-1-ND/3175200
 |  | C225 | 22p | Device:C | Capacitor_SMD:C_0402_1005Metric | ~ |  |  | GRM1555C1H220JA01D | 0.1 |  | https://www.digikey.com/product-detail/en/murata-electronics-north-america/GRM1555C1H220JA01D/490-5868-1-ND/3175200
 |  | C226 | 22p | Device:C | Capacitor_SMD:C_0402_1005Metric | ~ |  |  | GRM1555C1H220JA01D | 0.1 |  | https://www.digikey.com/product-detail/en/murata-electronics-north-america/GRM1555C1H220JA01D/490-5868-1-ND/3175200
 |  | C227 | 22p | Device:C | Capacitor_SMD:C_0402_1005Metric | ~ |  |  | GRM1555C1H220JA01D | 0.1 |  | https://www.digikey.com/product-detail/en/murata-electronics-north-america/GRM1555C1H220JA01D/490-5868-1-ND/3175200
 |  | C228 | 22p | Device:C | Capacitor_SMD:C_0402_1005Metric | ~ |  |  | GRM1555C1H220JA01D | 0.1 |  | https://www.digikey.com/product-detail/en/murata-electronics-north-america/GRM1555C1H220JA01D/490-5868-1-ND/3175200
 |  | C229 | 22p | Device:C | Capacitor_SMD:C_0402_1005Metric | ~ |  |  | GRM1555C1H220JA01D | 0.1 |  | https://www.digikey.com/product-detail/en/murata-electronics-north-america/GRM1555C1H220JA01D/490-5868-1-ND/3175200
 |  | C230 | 22p | Device:C | Capacitor_SMD:C_0402_1005Metric | ~ |  |  | GRM1555C1H220JA01D | 0.1 |  | https://www.digikey.com/product-detail/en/murata-electronics-north-america/GRM1555C1H220JA01D/490-5868-1-ND/3175200
 |  | C231 | 22p | Device:C | Capacitor_SMD:C_0402_1005Metric | ~ |  |  | GRM1555C1H220JA01D | 0.1 |  | https://www.digikey.com/product-detail/en/murata-electronics-north-america/GRM1555C1H220JA01D/490-5868-1-ND/3175200
 |  | C250 | 1n | Device:C | Capacitor_SMD:C_0402_1005Metric | ~ |  |  | GRM155R71H102KA01D | 0.1 |  | https://www.digikey.com/product-detail/en/murata-electronics-north-america/GRM155R71H102KA01D/490-1303-1-ND/587936
 |  | C288 | 100n | Device:C | Capacitor_SMD:C_0402_1005Metric | ~ |  |  | NMC0402X7R104K16TRPF | 0.1 |  | https://www.digikey.com/product-detail/en/murata-electronics-north-america/GRM155R71C104KA88D/490-3261-1-ND/702802
 |  | C301 | 15p | Device:C | Capacitor_SMD:C_0402_1005Metric | ~ |  |  | GRM1555C1H150JA01D | 0.1 |  | https://www.digikey.com/product-detail/en/murata-electronics-north-america/GRM1555C1H150JA01D/490-5888-1-ND/3315234
 |  | C302 | 47u | Device:C | Capacitor_SMD:C_1206_3216Metric | ~ | DNI |  | GRM31CR61A476ME15L | 0.84 |  | https://www.digikey.com/product-detail/en/murata-electronics-north-america/GRM31CR61A476ME15L/490-5528-1-ND/2334924
 |  | C304 | 1u | Device:C | Capacitor_SMD:C_0603_1608Metric | ~ |  |  | GRM188R61A106ME69D | 0.21 |  | https://www.digikey.com/product-detail/en/murata-electronics-north-america/GRM188R61A106ME69D/490-10475-1-ND/5026393
 |  | C305 | 100n | Device:C | Capacitor_SMD:C_0402_1005Metric | ~ |  |  | GRM155R61A104KA01D | 0.1 |  | https://www.digikey.com/product-detail/en/murata-electronics-north-america/GRM155R61A104KA01D/490-1318-1-ND/587923
 |  | C306 | 4.7u | Device:C | Capacitor_SMD:C_0402_1005Metric | ~ |  |  | GRM155R60J475ME87D | 0.15 |  | https://www.digikey.com/product-detail/en/murata-electronics-north-america/GRM155R60J475ME87D/490-5408-1-ND/2175215
 |  | C307 | 100n | Device:C | Capacitor_SMD:C_0402_1005Metric | ~ |  |  | GRM155R61A104KA01D | 0.1 |  | https://www.digikey.com/product-detail/en/murata-electronics-north-america/GRM155R61A104KA01D/490-1318-1-ND/587923
 |  | C308 | 4.7u | Device:C | Capacitor_SMD:C_0603_1608Metric | ~ |  |  | GRM188R61A475KE15D | 0.16 |  | https://www.digikey.com/product-detail/en/murata-electronics-north-america/GRM188R61A475KE15D/490-10477-1-ND/5026395
 |  | C309 | 47u | Device:C | Capacitor_SMD:C_1206_3216Metric | ~ |  |  | GRM31CR61A476ME15L | 0.84 |  | https://www.digikey.com/product-detail/en/murata-electronics-north-america/GRM31CR61A476ME15L/490-5528-1-ND/2334924
 |  | C310 | 10u | Device:C | Capacitor_SMD:C_0603_1608Metric | ~ |  |  | GRM188R60J106ME47D | 0.38 |  | https://www.digikey.com/product-detail/en/murata-electronics-north-america/GRM188R60J106ME47D/490-3896-1-ND/965938
 |  | C311 | 10u | Device:C | Capacitor_SMD:C_0603_1608Metric | ~ |  |  | GRM188R60J106ME47D | 0.38 |  | https://www.digikey.com/product-detail/en/murata-electronics-north-america/GRM188R60J106ME47D/490-3896-1-ND/965938
 |  | C312 | 22p | Device:C | Capacitor_SMD:C_0402_1005Metric | ~ |  |  | GRM1555C1H220JA01D | 0.1 |  | https://www.digikey.com/product-detail/en/murata-electronics-north-america/GRM1555C1H220JA01D/490-5868-1-ND/3175200
 |  | C318 | 10u | Device:C | Capacitor_SMD:C_0603_1608Metric | ~ |  |  | GRM188R61A106ME69D | 0.21 |  | https://www.digikey.com/product-detail/en/murata-electronics-north-america/GRM188R61A106ME69D/490-10475-1-ND/5026393
 |  | C320 | 100n | Device:C | Capacitor_SMD:C_0402_1005Metric | ~ |  |  | NMC0402X7R104K16TRPF | 0.1 |  | https://www.digikey.com/product-detail/en/murata-electronics-north-america/GRM155R71C104KA88D/490-3261-1-ND/702802
 |  | C321 | 100n | Device:C | Capacitor_SMD:C_0402_1005Metric | ~ |  |  | NMC0402X7R104K16TRPF | 0.1 |  | https://www.digikey.com/product-detail/en/murata-electronics-north-america/GRM155R71C104KA88D/490-3261-1-ND/702802
 |  | C322 | 100n | Device:C | Capacitor_SMD:C_0402_1005Metric | ~ |  |  | NMC0402X7R104K16TRPF | 0.1 |  | https://www.digikey.com/product-detail/en/murata-electronics-north-america/GRM155R71C104KA88D/490-3261-1-ND/702802
 |  | C330 | 47p | Device:C | Capacitor_SMD:C_0402_1005Metric | ~ |  |  | GRM1555C1H470JA01D | 0.1 |  | https://www.digikey.com/product-detail/en/murata-electronics-north-america/GRM1555C1H470JA01D/490-5942-1-ND/3721299
 |  | C331 | 47p | Device:C | Capacitor_SMD:C_0402_1005Metric | ~ |  |  | GRM1555C1H470JA01D | 0.1 |  | https://www.digikey.com/product-detail/en/murata-electronics-north-america/GRM1555C1H470JA01D/490-5942-1-ND/3721299
 |  | C355 | 100n | Device:C | Capacitor_SMD:C_0402_1005Metric | ~ |  |  | NMC0402X7R104K16TRPF | 0.1 |  | https://www.digikey.com/product-detail/en/murata-electronics-north-america/GRM155R71C104KA88D/490-3261-1-ND/702802
 |  | C356 | 100n | Device:C | Capacitor_SMD:C_0402_1005Metric | ~ |  |  | NMC0402X7R104K16TRPF | 0.1 |  | https://www.digikey.com/product-detail/en/murata-electronics-north-america/GRM155R71C104KA88D/490-3261-1-ND/702802
 |  | C360 | 100n | Device:C | Capacitor_SMD:C_0402_1005Metric | ~ |  |  | NMC0402X7R104K16TRPF | 0.1 |  | https://www.digikey.com/product-detail/en/murata-electronics-north-america/GRM155R71C104KA88D/490-3261-1-ND/702802
 |  | C362 | 100n | Device:C | Capacitor_SMD:C_0402_1005Metric | ~ |  |  | NMC0402X7R104K16TRPF | 0.1 |  | https://www.digikey.com/product-detail/en/murata-electronics-north-america/GRM155R71C104KA88D/490-3261-1-ND/702802
 |  | C400 | 100n | Device:C | Capacitor_SMD:C_0402_1005Metric | ~ |  |  | NMC0402X7R104K16TRPF | 0.1 |  | https://www.digikey.com/product-detail/en/murata-electronics-north-america/GRM155R71C104KA88D/490-3261-1-ND/702802
 |  | C401 | 100n | Device:C | Capacitor_SMD:C_0402_1005Metric | ~ |  |  | NMC0402X7R104K16TRPF | 0.1 |  | https://www.digikey.com/product-detail/en/murata-electronics-north-america/GRM155R71C104KA88D/490-3261-1-ND/702802
 |  | C402 | 100n | Device:C | Capacitor_SMD:C_0402_1005Metric | ~ |  |  | NMC0402X7R104K16TRPF | 0.1 |  | https://www.digikey.com/product-detail/en/murata-electronics-north-america/GRM155R71C104KA88D/490-3261-1-ND/702802
 |  | C403 | 100n | Device:C | Capacitor_SMD:C_0402_1005Metric | ~ |  |  | GRM155R61A104KA01D | 0.1 |  | https://www.digikey.com/product-detail/en/murata-electronics-north-america/GRM155R61A104KA01D/490-1318-1-ND/587923
 |  | C404 | 100n | Device:C | Capacitor_SMD:C_0402_1005Metric | ~ |  |  | GRM155R61A104KA01D | 0.1 |  | https://www.digikey.com/product-detail/en/murata-electronics-north-america/GRM155R61A104KA01D/490-1318-1-ND/587923
 |  | C405 | 100n | Device:C | Capacitor_SMD:C_0402_1005Metric | ~ |  |  | NMC0402X7R104K16TRPF | 0.1 |  | https://www.digikey.com/product-detail/en/murata-electronics-north-america/GRM155R71C104KA88D/490-3261-1-ND/702802
 |  | C406 | 100n | Device:C | Capacitor_SMD:C_0402_1005Metric | ~ |  |  | NMC0402X7R104K16TRPF | 0.1 |  | https://www.digikey.com/product-detail/en/murata-electronics-north-america/GRM155R71C104KA88D/490-3261-1-ND/702802
 |  | C450 | 100n | Device:C | Capacitor_SMD:C_0402_1005Metric | ~ |  |  | GRM155R61A104KA01D | 0.1 |  | https://www.digikey.com/product-detail/en/murata-electronics-north-america/GRM155R61A104KA01D/490-1318-1-ND/587923
 |  | C500 | 100p | Device:C | Capacitor_SMD:C_0402_1005Metric | ~ |  |  | GRM1555C1H101JA01D | 0.1 |  | https://www.digikey.com/product-detail/en/murata-electronics-north-america/GRM1555C1H101JA01D/490-5922-1-ND/3721279
 |  | C501 | 100p | Device:C | Capacitor_SMD:C_0402_1005Metric | ~ |  |  | GRM1555C1H101JA01D | 0.1 |  | https://www.digikey.com/product-detail/en/murata-electronics-north-america/GRM1555C1H101JA01D/490-5922-1-ND/3721279
 |  | C502 | 100p | Device:C | Capacitor_SMD:C_0402_1005Metric | ~ |  |  | GRM1555C1H101JA01D | 0.1 |  | https://www.digikey.com/product-detail/en/murata-electronics-north-america/GRM1555C1H101JA01D/490-5922-1-ND/3721279
 |  | C503 | 1u | Device:C | Capacitor_SMD:C_0402_1005Metric | ~ |  |  | GRM155R61A105KE15D | 0.11 |  | https://www.digikey.com/product-detail/en/murata-electronics-north-america/GRM155R61A105KE15D/490-3890-1-ND/965932
 |  | C504 | 1u | Device:C | Capacitor_SMD:C_0402_1005Metric | ~ |  |  | GRM155R61A105KE15D | 0.11 |  | https://www.digikey.com/product-detail/en/murata-electronics-north-america/GRM155R61A105KE15D/490-3890-1-ND/965932
 |  | C505 | 100p | Device:C | Capacitor_SMD:C_0402_1005Metric | ~ |  |  | GRM1555C1H101JA01D | 0.1 |  | https://www.digikey.com/product-detail/en/murata-electronics-north-america/GRM1555C1H101JA01D/490-5922-1-ND/3721279
 |  | C506 | 100p | Device:C | Capacitor_SMD:C_0402_1005Metric | ~ |  |  | GRM1555C1H101JA01D | 0.1 |  | https://www.digikey.com/product-detail/en/murata-electronics-north-america/GRM1555C1H101JA01D/490-5922-1-ND/3721279
 |  | C507 | 22p | Device:C | Capacitor_SMD:C_0402_1005Metric | ~ |  |  | GRM1555C1H220JA01D | 0.1 |  | https://www.digikey.com/product-detail/en/murata-electronics-north-america/GRM1555C1H220JA01D/490-5868-1-ND/3175200
 |  | C508 | 22p | Device:C | Capacitor_SMD:C_0402_1005Metric | ~ |  |  | GRM1555C1H220JA01D | 0.1 |  | https://www.digikey.com/product-detail/en/murata-electronics-north-america/GRM1555C1H220JA01D/490-5868-1-ND/3175200
 |  | C509 | 4.7u | Device:C | Capacitor_SMD:C_0402_1005Metric | ~ |  |  | ECJ-0EB0J475M | 0.26 |  | https://www.digikey.com/product-detail/en/panasonic-electronic-components/ECJ-0EB0J475M/PCC2475CT-ND/1833127
 |  | C510 | 100p | Device:C | Capacitor_SMD:C_0402_1005Metric | ~ |  |  | GRM1555C1H101JA01D | 0.1 |  | https://www.digikey.com/product-detail/en/murata-electronics-north-america/GRM1555C1H101JA01D/490-5922-1-ND/3721279
 |  | C511 | 100p | Device:C | Capacitor_SMD:C_0402_1005Metric | ~ |  |  | GRM1555C1H101JA01D | 0.1 |  | https://www.digikey.com/product-detail/en/murata-electronics-north-america/GRM1555C1H101JA01D/490-5922-1-ND/3721279
 |  | C512 | 4.7u | Device:C | Capacitor_SMD:C_0402_1005Metric | ~ |  |  | ECJ-0EB0J475M | 0.26 |  | https://www.digikey.com/product-detail/en/panasonic-electronic-components/ECJ-0EB0J475M/PCC2475CT-ND/1833127
 |  | C513 | 4.7u | Device:C | Capacitor_SMD:C_0402_1005Metric | ~ |  |  | ECJ-0EB0J475M | 0.26 |  | https://www.digikey.com/product-detail/en/panasonic-electronic-components/ECJ-0EB0J475M/PCC2475CT-ND/1833127
 |  | C514 | 4.7u | Device:C | Capacitor_SMD:C_0402_1005Metric | ~ |  |  | ECJ-0EB0J475M | 0.26 |  | https://www.digikey.com/product-detail/en/panasonic-electronic-components/ECJ-0EB0J475M/PCC2475CT-ND/1833127
 |  | C515 | 2.2u | Device:C | Capacitor_SMD:C_0603_1608Metric | ~ |  |  | CE JMK107BJ225KA-T | 0.14 |  | https://www.digikey.com/product-detail/en/taiyo-yuden/JMK107BJ225KA-T/587-1254-1-ND/931031
 |  | C516 | 100p | Device:C | Capacitor_SMD:C_0402_1005Metric | ~ |  |  | GRM1555C1H101JA01D | 0.1 |  | https://www.digikey.com/product-detail/en/murata-electronics-north-america/GRM1555C1H101JA01D/490-5922-1-ND/3721279
 |  | C517 | 100n | Device:C | Capacitor_SMD:C_0402_1005Metric | ~ |  |  | NMC0402X7R104K16TRPF | 0.1 |  | https://www.digikey.com/product-detail/en/murata-electronics-north-america/GRM155R71C104KA88D/490-3261-1-ND/702802
 |  | C518 | 100n | Device:C | Capacitor_SMD:C_0402_1005Metric | ~ |  |  | NMC0402X7R104K16TRPF | 0.1 |  | https://www.digikey.com/product-detail/en/murata-electronics-north-america/GRM155R71C104KA88D/490-3261-1-ND/702802
 |  | C519 | 4.7u | Device:C | Capacitor_SMD:C_0402_1005Metric | ~ |  |  | ECJ-0EB0J475M | 0.26 |  | https://www.digikey.com/product-detail/en/panasonic-electronic-components/ECJ-0EB0J475M/PCC2475CT-ND/1833127
 |  | C520 | 100n | Device:C | Capacitor_SMD:C_0402_1005Metric | ~ |  |  | NMC0402X7R104K16TRPF | 0.1 |  | https://www.digikey.com/product-detail/en/murata-electronics-north-america/GRM155R71C104KA88D/490-3261-1-ND/702802
 |  | C600 | 1u | Device:C | Capacitor_SMD:C_0402_1005Metric | ~ |  |  | GRM155R61A105KE15D | 0.11 |  | https://www.digikey.com/product-detail/en/murata-electronics-north-america/GRM155R61A105KE15D/490-3890-1-ND/965932
 |  | C601 | 1u | Device:C | Capacitor_SMD:C_0402_1005Metric | ~ |  |  | NMC0402X7R104K16TRPF | 0.1 |  | https://www.digikey.com/product-detail/en/murata-electronics-north-america/GRM155R71C104KA88D/490-3261-1-ND/702802
 |  | C602 | 1u | Device:C | Capacitor_SMD:C_0402_1005Metric | ~ |  |  | GRM155R61A105KE15D | 0.11 |  | https://www.digikey.com/product-detail/en/murata-electronics-north-america/GRM155R61A105KE15D/490-3890-1-ND/965932
 |  | C604 | 100n | Device:C | Capacitor_SMD:C_0402_1005Metric | ~ |  |  | NMC0402X7R104K16TRPF | 0.1 |  | https://www.digikey.com/product-detail/en/murata-electronics-north-america/GRM155R71C104KA88D/490-3261-1-ND/702802
 |  | C605 | 4.7u | Device:C | Capacitor_SMD:C_0603_1608Metric | ~ |  |  | GRM188R61A475KE15D | 0.16 |  | https://www.digikey.com/product-detail/en/murata-electronics-north-america/GRM188R61A475KE15D/490-10477-1-ND/5026395
 |  | C606 | 1n | Device:C | Capacitor_SMD:C_0402_1005Metric | ~ |  |  | GRM155R71H102KA01D | 0.1 |  | https://www.digikey.com/product-detail/en/murata-electronics-north-america/GRM155R71H102KA01D/490-1303-1-ND/587936
 |  | C610 | 100n | Device:C | Capacitor_SMD:C_0402_1005Metric | ~ |  |  | NMC0402X7R104K16TRPF | 0.1 |  | https://www.digikey.com/product-detail/en/murata-electronics-north-america/GRM155R71C104KA88D/490-3261-1-ND/702802
 |  | C624 | 100n | Device:C | Capacitor_SMD:C_0402_1005Metric | ~ |  |  | NMC0402X7R104K16TRPF | 0.1 |  | https://www.digikey.com/product-detail/en/murata-electronics-north-america/GRM155R71C104KA88D/490-3261-1-ND/702802
 |  | C700 | 100n | Device:C | Capacitor_SMD:C_0402_1005Metric | ~ |  |  | NMC0402X7R104K16TRPF | 0.1 |  | https://www.digikey.com/product-detail/en/murata-electronics-north-america/GRM155R71C104KA88D/490-3261-1-ND/702802
 |  | C701 | 100n | Device:C | Capacitor_SMD:C_0402_1005Metric | ~ |  |  | NMC0402X7R104K16TRPF | 0.1 |  | https://www.digikey.com/product-detail/en/murata-electronics-north-america/GRM155R71C104KA88D/490-3261-1-ND/702802
 |  | C702 | 100n | Device:C | Capacitor_SMD:C_0402_1005Metric | ~ | DNI |  | NMC0402X7R104K16TRPF | 0.1 |  | https://www.digikey.com/product-detail/en/murata-electronics-north-america/GRM155R71C104KA88D/490-3261-1-ND/702802
 |  | C703 | 4.7u | Device:C | Capacitor_SMD:C_0402_1005Metric | ~ |  |  | GRM155R60J475ME47D | 0.15 |  | https://www.digikey.com/product-detail/en/murata-electronics-north-america/GRM155R60J475ME47D/490-5915-1-ND/3719860
 |  | C704 | 100n | Device:C | Capacitor_SMD:C_0402_1005Metric | ~ |  |  | NMC0402X7R104K16TRPF | 0.1 |  | https://www.digikey.com/product-detail/en/murata-electronics-north-america/GRM155R71C104KA88D/490-3261-1-ND/702802
 |  | C705 | 100n | Device:C | Capacitor_SMD:C_0402_1005Metric | ~ |  |  | NMC0402X7R104K16TRPF | 0.1 |  | https://www.digikey.com/product-detail/en/murata-electronics-north-america/GRM155R71C104KA88D/490-3261-1-ND/702802
 |  | C706 | 4.7u | Device:C | Capacitor_SMD:C_0402_1005Metric | ~ |  |  | GRM155R60J475ME47D | 0.15 |  | https://www.digikey.com/product-detail/en/murata-electronics-north-america/GRM155R60J475ME47D/490-5915-1-ND/3719860
 |  | C707 | 4.7u | Device:C | Capacitor_SMD:C_0402_1005Metric | ~ |  |  | GRM155R60J475ME47D | 0.15 |  | https://www.digikey.com/product-detail/en/murata-electronics-north-america/GRM155R60J475ME47D/490-5915-1-ND/3719860
 |  | C708 | 4.7u | Device:C | Capacitor_SMD:C_0402_1005Metric | ~ |  |  | GRM155R60J475ME47D | 0.15 |  | https://www.digikey.com/product-detail/en/murata-electronics-north-america/GRM155R60J475ME47D/490-5915-1-ND/3719860
 |  | C709 | 4.7u | Device:C | Capacitor_SMD:C_0402_1005Metric | ~ |  |  | NMC0402X7R104K16TRPF | 0.1 |  | https://www.digikey.com/product-detail/en/murata-electronics-north-america/GRM155R71C104KA88D/490-3261-1-ND/702802
 |  | C710 | 1u | Device:C | Capacitor_SMD:C_0402_1005Metric | ~ |  |  | GRM155R61A105KE15D | 0.11 |  | https://www.digikey.com/product-detail/en/murata-electronics-north-america/GRM155R61A105KE15D/490-3890-1-ND/965932
 |  | C715 | 100n | Device:C | Capacitor_SMD:C_0402_1005Metric | ~ |  |  | GRM155R61A104KA01D | 0.1 |  | https://www.digikey.com/product-detail/en/murata-electronics-north-america/GRM155R61A104KA01D/490-1318-1-ND/587923
 |  | C720 | 100n | Device:C | Capacitor_SMD:C_0402_1005Metric | ~ | DNI |  | GRM155R61A104KA01D | 0.1 |  | https://www.digikey.com/product-detail/en/murata-electronics-north-america/GRM155R61A104KA01D/490-1318-1-ND/587923
 |  | C721 | 100n | Device:C | Capacitor_SMD:C_0402_1005Metric | ~ | DNI |  | GRM155R61A104KA01D | 0.1 |  | https://www.digikey.com/product-detail/en/murata-electronics-north-america/GRM155R61A104KA01D/490-1318-1-ND/587923
 |  | C722 | 100n | Device:C | Capacitor_SMD:C_0402_1005Metric | ~ |  |  | GRM155R61A104KA01D | 0.1 |  | https://www.digikey.com/product-detail/en/murata-electronics-north-america/GRM155R61A104KA01D/490-1318-1-ND/587923
 |  | C723 | 100n | Device:C | Capacitor_SMD:C_0402_1005Metric | ~ | DNI |  | GRM155R61A104KA01D | 0.1 |  | https://www.digikey.com/product-detail/en/murata-electronics-north-america/GRM155R61A104KA01D/490-1318-1-ND/587923
 |  | C725 | 100n | Device:C | Capacitor_SMD:C_0402_1005Metric | ~ |  |  | GRM155R61A104KA01D | 0.1 |  | https://www.digikey.com/product-detail/en/murata-electronics-north-america/GRM155R61A104KA01D/490-1318-1-ND/587923
 |  | C788 | 4.7u | Device:C | Capacitor_SMD:C_0402_1005Metric | ~ |  |  | GRM155R60J475ME47D | 0.15 |  | https://www.digikey.com/product-detail/en/murata-electronics-north-america/GRM155R60J475ME47D/490-5915-1-ND/3719860
 |  | C800 | 22u | Device:C | Capacitor_SMD:C_0805_2012Metric | ~ |  |  | GRM219R61A226MEA0D | 0.42 |  | https://www.digikey.com/product-detail/en/murata-electronics-north-america/GRM219R61A226MEA0D/490-9951-1-ND/5026414
 |  | C801 | 220n | Device:C | Capacitor_SMD:C_0603_1608Metric | ~ |  |  | GCM188R71H224MA64D | 0.23 |  | https://www.mouser.com/ProductDetail/Murata-Electronics/GCM188R71H224MA64D
 |  | C802 | 1u | Device:C | Capacitor_SMD:C_0402_1005Metric | ~ |  |  | GRM155R61A105KE15D | 0.11 |  | https://www.digikey.com/product-detail/en/murata-electronics-north-america/GRM155R61A105KE15D/490-3890-1-ND/965932
 |  | C803 | 10u | Device:C | Capacitor_SMD:C_0603_1608Metric | ~ |  |  | GRM188R61A106ME69D | 0.21 |  | https://www.digikey.com/product-detail/en/murata-electronics-north-america/GRM188R61A106ME69D/490-10475-1-ND/5026393
 |  | C804 | 1u | Device:C | Capacitor_SMD:C_0402_1005Metric | ~ |  |  | GRM155R61A105KE15D | 0.11 |  | https://www.digikey.com/product-detail/en/murata-electronics-north-america/GRM155R61A105KE15D/490-3890-1-ND/965932
 |  | C805 | 10u | Device:C | Capacitor_SMD:C_0805_2012Metric | ~ |  |  | LMK212C106MG | 0.044 |  | https://www.digikey.com/products/en?keywords=LMK212C106MG
 |  | C806 | 47n | Device:C | Capacitor_SMD:C_0402_1005Metric | ~ |  |  | GRM155R71A473KA01D | 0.10 |  | https://www.digikey.com/product-detail/en/murata-electronics-north-america/GRM155R71A473KA01D/490-1316-1-ND/587933
 |  | C807 | 220n | Device:C | Capacitor_SMD:C_0603_1608Metric | ~ |  |  | GCM188R71H224MA64D | 0.23 |  | https://www.mouser.com/ProductDetail/Murata-Electronics/GCM188R71H224MA64D
 |  | C808 | 10u | Device:C | Capacitor_SMD:C_0603_1608Metric | ~ |  |  | GRM188R61A106ME69D | 0.21 |  | https://www.digikey.com/product-detail/en/murata-electronics-north-america/GRM188R61A106ME69D/490-10475-1-ND/5026393
 |  | C809 | 220n | Device:C | Capacitor_SMD:C_0603_1608Metric | ~ |  |  | GCM188R71H224MA64D | 0.23 |  | https://www.mouser.com/ProductDetail/Murata-Electronics/GCM188R71H224MA64D
 |  | C810 | 4.7u | Device:C | Capacitor_SMD:C_0603_1608Metric | ~ |  |  | GRM188R61A475KE15D | 0.16 |  | https://www.digikey.com/product-detail/en/murata-electronics-north-america/GRM188R61A475KE15D/490-10477-1-ND/5026395
 |  | C811 | 10u | Device:C | Capacitor_SMD:C_0402_1005Metric | ~ |  |  | NMC0402X7R104K16TRPF | 0.1 |  | https://www.digikey.com/product-detail/en/murata-electronics-north-america/GRM155R71C104KA88D/490-3261-1-ND/702802
 |  | C812 | 10u | Device:C | Capacitor_SMD:C_1206_3216Metric | ~ | DNI |  | GRM31CR61A476ME15L | 0.84 |  | https://www.digikey.com/product-detail/en/murata-electronics-north-america/GRM31CR61A476ME15L/490-5528-1-ND/2334924
 |  | C818 | 10u | Device:C | Capacitor_SMD:C_0603_1608Metric | ~ | DNI |  | GRM188R61A106ME69D | 0.21 |  | https://www.digikey.com/product-detail/en/murata-electronics-north-america/GRM188R61A106ME69D/490-10475-1-ND/5026393
 |  | C900 | 100n | Device:C | Capacitor_SMD:C_0402_1005Metric | ~ |  |  | NMC0402X7R104K16TRPF | 0.1 |  | https://www.digikey.com/product-detail/en/murata-electronics-north-america/GRM155R71C104KA88D/490-3261-1-ND/702802
 |  | C901 | 100n | Device:C | Capacitor_SMD:C_0402_1005Metric | ~ |  |  | NMC0402X7R104K16TRPF | 0.1 |  | https://www.digikey.com/product-detail/en/murata-electronics-north-america/GRM155R71C104KA88D/490-3261-1-ND/702802
 |  | C902 | 100n | Device:C | Capacitor_SMD:C_0402_1005Metric | ~ |  |  | NMC0402X7R104K16TRPF | 0.1 |  | https://www.digikey.com/product-detail/en/murata-electronics-north-america/GRM155R71C104KA88D/490-3261-1-ND/702802
 |  | C903 | 10u | Device:C | Capacitor_SMD:C_0603_1608Metric | ~ |  |  | GRM188R61A106ME69D | 0.21 |  | https://www.digikey.com/product-detail/en/murata-electronics-north-america/GRM188R61A106ME69D/490-10475-1-ND/5026393
 |  | C904 | 100n | Device:C | Capacitor_SMD:C_0402_1005Metric | ~ |  |  | NMC0402X7R104K16TRPF | 0.1 |  | https://www.digikey.com/product-detail/en/murata-electronics-north-america/GRM155R71C104KA88D/490-3261-1-ND/702802
 |  | C905 | 100n | Device:C | Capacitor_SMD:C_0402_1005Metric | ~ | DNI |  | GRM155R61A104KA01D | 0.1 |  | https://www.digikey.com/product-detail/en/murata-electronics-north-america/GRM155R61A104KA01D/490-1318-1-ND/587923
 |  | C906 | 10u | Device:C | Capacitor_SMD:C_0805_2012Metric | ~ |  |  | GRM21BR61A106KE19L | 0.27 |  | https://www.digikey.com/product-detail/en/murata-electronics-north-america/GRM21BR61A106KE19L/490-1709-1-ND/587432
 |  | C907 | 100n | Device:C | Capacitor_SMD:C_0402_1005Metric | ~ | DNI |  | GRM155R61A104KA01D | 0.1 |  | https://www.digikey.com/product-detail/en/murata-electronics-north-america/GRM155R61A104KA01D/490-1318-1-ND/587923
 |  | C908 | 47u | Device:C | Capacitor_SMD:C_1206_3216Metric | ~ |  |  | GRM31CR61A476ME15L | 0.84 |  | https://www.digikey.com/product-detail/en/murata-electronics-north-america/GRM31CR61A476ME15L/490-5528-1-ND/2334924
 |  | C909 | 47n | Device:C | Capacitor_SMD:C_0402_1005Metric | ~ |  |  | GRM155R71A473KA01D | 0.10 |  | https://www.digikey.com/product-detail/en/murata-electronics-north-america/GRM155R71A473KA01D/490-1316-1-ND/587933
 |  | C910 | 100n | Device:C | Capacitor_SMD:C_0402_1005Metric | ~ |  |  | GRM155R61A104KA01D | 0.1 |  | https://www.digikey.com/product-detail/en/murata-electronics-north-america/GRM155R61A104KA01D/490-1318-1-ND/587923
 |  | C911 | 10n | Device:C | Capacitor_SMD:C_0402_1005Metric | ~ | DNI |  | GRM155R71E103KA01D | 0.10 |  | https://www.digikey.com/product-detail/en/murata-electronics-north-america/GRM155R71E103KA01D/490-1312-1-ND/587934
 |  | C912 | 47u | Device:C | Capacitor_SMD:C_1206_3216Metric | ~ |  |  | GRM31CR61A476ME15L | 0.84 |  | https://www.digikey.com/product-detail/en/murata-electronics-north-america/GRM31CR61A476ME15L/490-5528-1-ND/2334924
 |  | C913 | 100n | Device:C | Capacitor_SMD:C_0402_1005Metric | ~ |  |  | GRM155R61A104KA01D | 0.1 |  | https://www.digikey.com/product-detail/en/murata-electronics-north-america/GRM155R61A104KA01D/490-1318-1-ND/587923
 |  | C914 | 100n | Device:C | Capacitor_SMD:C_0402_1005Metric | ~ |  |  | GRM155R61A104KA01D | 0.1 |  | https://www.digikey.com/product-detail/en/murata-electronics-north-america/GRM155R61A104KA01D/490-1318-1-ND/587923
 |  | C915 | 100n | Device:C | Capacitor_SMD:C_0402_1005Metric | ~ | DNI |  | GRM155R61A104KA01D | 0.1 |  | https://www.digikey.com/product-detail/en/murata-electronics-north-america/GRM155R61A104KA01D/490-1318-1-ND/587923
 |  | C916 | 100n | Device:C | Capacitor_SMD:C_0402_1005Metric | ~ | DNI |  | GRM155R61A104KA01D | 0.1 |  | https://www.digikey.com/product-detail/en/murata-electronics-north-america/GRM155R61A104KA01D/490-1318-1-ND/587923
 |  | C917 | 100n | Device:C | Capacitor_SMD:C_0402_1005Metric | ~ | DNI |  | GRM155R61A104KA01D | 0.1 |  | https://www.digikey.com/product-detail/en/murata-electronics-north-america/GRM155R61A104KA01D/490-1318-1-ND/587923
 |  | C918 | 100n | Device:C | Capacitor_SMD:C_0402_1005Metric | ~ | DNI |  | GRM155R61A104KA01D | 0.1 |  | https://www.digikey.com/product-detail/en/murata-electronics-north-america/GRM155R61A104KA01D/490-1318-1-ND/587923
 |  | C919 | 100n | Device:C | Capacitor_SMD:C_0402_1005Metric | ~ | DNI |  | GRM155R61A104KA01D | 0.1 |  | https://www.digikey.com/product-detail/en/murata-electronics-north-america/GRM155R61A104KA01D/490-1318-1-ND/587923
 |  | C920 | 47u | Device:C | Capacitor_SMD:C_1206_3216Metric | ~ |  |  | GRM31CR61A476ME15L | 0.84 |  | https://www.digikey.com/product-detail/en/murata-electronics-north-america/GRM31CR61A476ME15L/490-5528-1-ND/2334924
 |  | C921 | 100n | Device:C | Capacitor_SMD:C_0402_1005Metric | ~ |  |  | GRM155R61A104KA01D | 0.1 |  | https://www.digikey.com/product-detail/en/murata-electronics-north-america/GRM155R61A104KA01D/490-1318-1-ND/587923
 |  | C922 | 1.5m | Device:C | MangOH-Red:CAP_2P_0720x0630_POL_NIB | ~ |  |  | 592D158X06R3R2T20H | 5.92 |  | https://www.digikey.com/product-detail/en/vishay-sprague/592D158X06R3R2T20H/718-1386-1-ND/1788618
 |  | C924 | 22u | Device:C | Capacitor_SMD:C_0603_1608Metric | ~ |  |  | GRM188R60J226MEA0D | 0.26 |  | https://www.digikey.com/product-detail/en/murata-electronics-north-america/GRM188R60J226MEA0D/490-7611-1-ND/4280544
 |  | C925 | 56p | Device:C | Capacitor_SMD:C_0402_1005Metric | ~ |  |  | GRM1555C1H560JA01D | 0.10 |  | https://www.digikey.com/product-detail/en/murata-electronics-north-america/GRM1555C1H560JA01D/490-1288-1-ND/587890
 |  | C926 | 22u | Device:C | Capacitor_SMD:C_0603_1608Metric | ~ |  |  | GRM188R60J226MEA0D | 0.26 |  | https://www.digikey.com/product-detail/en/murata-electronics-north-america/GRM188R60J226MEA0D/490-7611-1-ND/4280544
 |  | C927 | 22u | Device:C | Capacitor_SMD:C_0603_1608Metric | ~ |  |  | GRM188R60J226MEA0D | 0.26 |  | https://www.digikey.com/product-detail/en/murata-electronics-north-america/GRM188R60J226MEA0D/490-7611-1-ND/4280544
 |  | C928 | 22u | Device:C | Capacitor_SMD:C_0603_1608Metric | ~ |  |  | GRM188R60J226MEA0D | 0.26 |  | https://www.digikey.com/product-detail/en/murata-electronics-north-america/GRM188R60J226MEA0D/490-7611-1-ND/4280544
 |  | C929 | 100n | Device:C | Capacitor_SMD:C_0402_1005Metric | ~ |  |  | GRM155R61A104KA01D | 0.1 |  | https://www.digikey.com/product-detail/en/murata-electronics-north-america/GRM155R61A104KA01D/490-1318-1-ND/587923
 |  | C930 | 100n | Device:C | Capacitor_SMD:C_0402_1005Metric | ~ |  |  | GRM155R61A104KA01D | 0.1 |  | https://www.digikey.com/product-detail/en/murata-electronics-north-america/GRM155R61A104KA01D/490-1318-1-ND/587923
 |  | C931 | 100n | Device:C | Capacitor_SMD:C_0402_1005Metric | ~ |  |  | GRM155R61A104KA01D | 0.1 |  | https://www.digikey.com/product-detail/en/murata-electronics-north-america/GRM155R61A104KA01D/490-1318-1-ND/587923
 |  | C932 | 100n | Device:C | Capacitor_SMD:C_0402_1005Metric | ~ |  |  | GRM155R61A104KA01D | 0.1 |  | https://www.digikey.com/product-detail/en/murata-electronics-north-america/GRM155R61A104KA01D/490-1318-1-ND/587923
 |  | C933 | 100n | Device:C | Capacitor_SMD:C_0402_1005Metric | ~ |  |  | GRM155R61A104KA01D | 0.1 |  | https://www.digikey.com/product-detail/en/murata-electronics-north-america/GRM155R61A104KA01D/490-1318-1-ND/587923
 |  | C940 | 100n | Device:C | Capacitor_SMD:C_0402_1005Metric | ~ |  |  | NMC0402X7R104K16TRPF | 0.1 |  | https://www.digikey.com/product-detail/en/murata-electronics-north-america/GRM155R71C104KA88D/490-3261-1-ND/702802
 |  | C941 | 100n | Device:C | Capacitor_SMD:C_0402_1005Metric | ~ |  |  | NMC0402X7R104K16TRPF | 0.1 |  | https://www.digikey.com/product-detail/en/murata-electronics-north-america/GRM155R71C104KA88D/490-3261-1-ND/702802
 |  | C943 | 1u | Device:C | Capacitor_SMD:C_0402_1005Metric | ~ |  |  | GRM155R61A105KE15D | 0.11 |  | https://www.digikey.com/product-detail/en/murata-electronics-north-america/GRM155R61A105KE15D/490-3890-1-ND/965932
 |  | C945 | 1u | Device:C | Capacitor_SMD:C_0402_1005Metric | ~ |  |  | GRM155R61A105KE15D | 0.11 |  | https://www.digikey.com/product-detail/en/murata-electronics-north-america/GRM155R61A105KE15D/490-3890-1-ND/965932
 |  | C950 | 100n | Device:C | Capacitor_SMD:C_0402_1005Metric | ~ |  |  | NMC0402X7R104K16TRPF | 0.1 |  | https://www.digikey.com/product-detail/en/murata-electronics-north-america/GRM155R71C104KA88D/490-3261-1-ND/702802
 |  | C951 | 100n | Device:C | Capacitor_SMD:C_0402_1005Metric | ~ |  |  | NMC0402X7R104K16TRPF | 0.1 |  | https://www.digikey.com/product-detail/en/murata-electronics-north-america/GRM155R71C104KA88D/490-3261-1-ND/702802
 |  | C952 | 10u | Device:C | Capacitor_SMD:C_0805_2012Metric | ~ |  |  | GRM21BR61A106KE19L | 0.27 |  | https://www.digikey.com/product-detail/en/murata-electronics-north-america/GRM21BR61A106KE19L/490-1709-1-ND/587432
 |  | C953 | 100n | Device:C | Capacitor_SMD:C_0402_1005Metric | ~ |  |  | NMC0402X7R104K16TRPF | 0.1 |  | https://www.digikey.com/product-detail/en/murata-electronics-north-america/GRM155R71C104KA88D/490-3261-1-ND/702802
 |  | C954 | 100n | Device:C | Capacitor_SMD:C_0402_1005Metric | ~ |  |  | NMC0402X7R104K16TRPF | 0.1 |  | https://www.digikey.com/product-detail/en/murata-electronics-north-america/GRM155R71C104KA88D/490-3261-1-ND/702802
 |  | C955 | 10u | Device:C | Capacitor_SMD:C_0805_2012Metric | ~ |  |  | GRM21BR61A106KE19L | 0.27 |  | https://www.digikey.com/product-detail/en/murata-electronics-north-america/GRM21BR61A106KE19L/490-1709-1-ND/587432
 |  | C1000 | 100n | Device:C | Capacitor_SMD:C_0402_1005Metric | ~ |  |  | NMC0402X7R104K16TRPF | 0.1 |  | https://www.digikey.com/product-detail/en/murata-electronics-north-america/GRM155R71C104KA88D/490-3261-1-ND/702802
 |  | C1001 | 470n | Device:C | Capacitor_SMD:C_0402_1005Metric | ~ |  |  | GRM155R60J474KE19D | 0.13 |  | https://www.digikey.com/product-detail/en/murata-electronics-north-america/GRM155R60J474KE19D/490-3266-1-ND/702807
 |  | C1002 | 10p | Device:C | Capacitor_SMD:C_0402_1005Metric | ~ | DNI |  | GRM1555C1H100JA01D | 0.1 |  | https://www.digikey.com/product-detail/en/murata-electronics-north-america/GRM1555C1H100JA01D/490-5921-1-ND/3721278
 |  | C1003 | 100n | Device:C | Capacitor_SMD:C_0402_1005Metric | ~ |  |  | NMC0402X7R104K16TRPF | 0.1 |  | https://www.digikey.com/product-detail/en/murata-electronics-north-america/GRM155R71C104KA88D/490-3261-1-ND/702802
 |  | C1004 | 470n | Device:C | Capacitor_SMD:C_0402_1005Metric | ~ |  |  | GRM155R60J474KE19D | 0.13 |  | https://www.digikey.com/product-detail/en/murata-electronics-north-america/GRM155R60J474KE19D/490-3266-1-ND/702807
 |  | C1005 | 10u | Device:C | Capacitor_SMD:C_0603_1608Metric | ~ |  |  | GRM188R61A106ME69D | 0.21 |  | https://www.digikey.com/product-detail/en/murata-electronics-north-america/GRM188R61A106ME69D/490-10475-1-ND/5026393
 |  | C1006 | 100p | Device:C | Capacitor_SMD:C_0402_1005Metric | ~ |  |  | GRM1555C1H101JA01D | 0.1 |  | https://www.digikey.com/product-detail/en/murata-electronics-north-america/GRM1555C1H101JA01D/490-5922-1-ND/3721279
 |  | C1007 | 100n | Device:C | Capacitor_SMD:C_0402_1005Metric | ~ |  |  | NMC0402X7R104K16TRPF | 0.1 |  | https://www.digikey.com/product-detail/en/murata-electronics-north-america/GRM155R71C104KA88D/490-3261-1-ND/702802
 |  | C1008 | 4.7u | Device:C | Capacitor_SMD:C_0402_1005Metric | ~ |  |  | GRM155R60J475ME87D | 0.15 |  | https://www.digikey.com/product-detail/en/murata-electronics-north-america/GRM155R60J475ME87D/490-5408-1-ND/2175215
 |  | C1009 | 4.7u | Device:C | Capacitor_SMD:C_0402_1005Metric | ~ |  |  | GRM155R60J475ME87D | 0.15 |  | https://www.digikey.com/product-detail/en/murata-electronics-north-america/GRM155R60J475ME87D/490-5408-1-ND/2175215
 |  | C1010 | 2.2u | Device:C | Capacitor_SMD:C_0603_1608Metric | ~ |  |  | CE JMK107BJ225KA-T | 0.14 |  | https://www.digikey.com/product-detail/en/taiyo-yuden/JMK107BJ225KA-T/587-1254-1-ND/931031
 |  | C1011 | 1u | Device:C | Capacitor_SMD:C_0402_1005Metric | ~ |  |  | GRM155R61A105KE15D | 0.11 |  | https://www.digikey.com/product-detail/en/murata-electronics-north-america/GRM155R61A105KE15D/490-3890-1-ND/965932
 |  | C1012 | 100n | Device:C | Capacitor_SMD:C_0402_1005Metric | ~ |  |  | NMC0402X7R104K16TRPF | 0.1 |  | https://www.digikey.com/product-detail/en/murata-electronics-north-america/GRM155R71C104KA88D/490-3261-1-ND/702802
 |  | C1013 | 10u | Device:C | Capacitor_SMD:C_0603_1608Metric | ~ |  |  | GRM188R61A106ME69D | 0.21 |  | https://www.digikey.com/product-detail/en/murata-electronics-north-america/GRM188R61A106ME69D/490-10475-1-ND/5026393
 |  | C1014 | 100n | Device:C | Capacitor_SMD:C_0402_1005Metric | ~ |  |  | NMC0402X7R104K16TRPF | 0.1 |  | https://www.digikey.com/product-detail/en/murata-electronics-north-america/GRM155R71C104KA88D/490-3261-1-ND/702802
 |  | C1015 | 470p | Device:C | Capacitor_SMD:C_0402_1005Metric | ~ |  |  | GRM155R71H471KA01D | 0.1 |  | https://www.digikey.com/product-detail/en/murata-electronics-north-america/GRM155R71H471KA01D/490-1300-1-ND/587942
 |  | C1016 | 1u | Device:C | Capacitor_SMD:C_0402_1005Metric | ~ |  |  | GRM155R61A105KE15D | 0.11 |  | https://www.digikey.com/product-detail/en/murata-electronics-north-america/GRM155R61A105KE15D/490-3890-1-ND/965932
 |  | C1017 | 10u | Device:C | Capacitor_SMD:C_0603_1608Metric | ~ |  |  | GRM188R61A106ME69D | 0.21 |  | https://www.digikey.com/product-detail/en/murata-electronics-north-america/GRM188R61A106ME69D/490-10475-1-ND/5026393
 |  | C1018 | 1u | Device:C | Capacitor_SMD:C_0402_1005Metric | ~ |  |  | GRM155R61A105KE15D | 0.11 |  | https://www.digikey.com/product-detail/en/murata-electronics-north-america/GRM155R61A105KE15D/490-3890-1-ND/965932
 |  | C1019 | 100p | Device:C | Capacitor_SMD:C_0402_1005Metric | ~ |  |  | GRM1555C1H101JA01D | 0.1 |  | https://www.digikey.com/product-detail/en/murata-electronics-north-america/GRM1555C1H101JA01D/490-5922-1-ND/3721279
 |  | C1020 | 100n | Device:C | Capacitor_SMD:C_0402_1005Metric | ~ |  |  | NMC0402X7R104K16TRPF | 0.1 |  | https://www.digikey.com/product-detail/en/murata-electronics-north-america/GRM155R71C104KA88D/490-3261-1-ND/702802
 |  | C1021 | 1u | Device:C | Capacitor_SMD:C_0402_1005Metric | ~ |  |  | GRM155R61A105KE15D | 0.11 |  | https://www.digikey.com/product-detail/en/murata-electronics-north-america/GRM155R61A105KE15D/490-3890-1-ND/965932
 |  | C1022 | 2.2u | Device:C | Capacitor_SMD:C_0603_1608Metric | ~ |  |  | CE JMK107BJ225KA-T | 0.14 |  | https://www.digikey.com/product-detail/en/taiyo-yuden/JMK107BJ225KA-T/587-1254-1-ND/931031
 |  | C1023 | 2.2u | Device:C | Capacitor_SMD:C_0603_1608Metric | ~ |  |  | CE JMK107BJ225KA-T | 0.14 |  | https://www.digikey.com/product-detail/en/taiyo-yuden/JMK107BJ225KA-T/587-1254-1-ND/931031
 |  | C1024 | 2.2u | Device:C | Capacitor_SMD:C_0603_1608Metric | ~ |  |  | CE JMK107BJ225KA-T | 0.14 |  | https://www.digikey.com/product-detail/en/taiyo-yuden/JMK107BJ225KA-T/587-1254-1-ND/931031
 |  | C1025 | 4.7u | Device:C | Capacitor_SMD:C_0402_1005Metric | ~ |  |  | GRM155R60J475ME87D | 0.15 |  | https://www.digikey.com/product-detail/en/murata-electronics-north-america/GRM155R60J475ME87D/490-5408-1-ND/2175215
 |  | C1026 | 100p | Device:C | Capacitor_SMD:C_0402_1005Metric | ~ |  |  | GRM1555C1H101JA01D | 0.1 |  | https://www.digikey.com/product-detail/en/murata-electronics-north-america/GRM1555C1H101JA01D/490-5922-1-ND/3721279
 |  | C1027 | 10p | Device:C | Capacitor_SMD:C_0402_1005Metric | ~ |  |  | GRM1555C1H100JA01D | 0.1 |  | https://www.digikey.com/product-detail/en/murata-electronics-north-america/GRM1555C1H100JA01D/490-5921-1-ND/3721278
 |  | C1028 | 10p | Device:C | Capacitor_SMD:C_0402_1005Metric | ~ |  |  | GRM1555C1H100JA01D | 0.1 |  | https://www.digikey.com/product-detail/en/murata-electronics-north-america/GRM1555C1H100JA01D/490-5921-1-ND/3721278
 |  | C1029 | 10p | Device:C | Capacitor_SMD:C_0402_1005Metric | ~ |  |  | GRM1555C1H100JA01D | 0.1 |  | https://www.digikey.com/product-detail/en/murata-electronics-north-america/GRM1555C1H100JA01D/490-5921-1-ND/3721278
 |  | C1030 | 100p | Device:C | Capacitor_SMD:C_0402_1005Metric | ~ |  |  | GRM1555C1H101JA01D | 0.1 |  | https://www.digikey.com/product-detail/en/murata-electronics-north-america/GRM1555C1H101JA01D/490-5922-1-ND/3721279
 |  | C1031 | 10p | Device:C | Capacitor_SMD:C_0402_1005Metric | ~ |  |  | GRM1555C1H100JA01D | 0.1 |  | https://www.digikey.com/product-detail/en/murata-electronics-north-america/GRM1555C1H100JA01D/490-5921-1-ND/3721278
 |  | C1032 | 1u | Device:C | Capacitor_SMD:C_0402_1005Metric | ~ |  |  | GRM155R61A105KE15D | 0.11 |  | https://www.digikey.com/product-detail/en/murata-electronics-north-america/GRM155R61A105KE15D/490-3890-1-ND/965932
 |  | C1033 | 100p | Device:C | Capacitor_SMD:C_0402_1005Metric | ~ |  |  | GRM1555C1H101JA01D | 0.1 |  | https://www.digikey.com/product-detail/en/murata-electronics-north-america/GRM1555C1H101JA01D/490-5922-1-ND/3721279
 |  | C1034 | 1p | Device:C | Capacitor_SMD:C_0201_0603Metric | ~ |  |  | GRM0335C1E1R0CA01D | 0.1 |  | https://www.digikey.com/product-detail/en/murata-electronics-north-america/GRM0335C1E1R0CA01D/490-7749-1-ND/4357964
 |  | C1035 | 1.5p | Device:C | Capacitor_SMD:C_0201_0603Metric | ~ |  |  | GJM0335C1E1R5CB01 | 0.1 |  | https://www.digikey.com/product-detail/en/murata-electronics-north-america/GJM0335C1E1R5CB01D/490-3057-1-ND/702323
 |  | C1036 | 1.5p | Device:C | Capacitor_SMD:C_0201_0603Metric | ~ |  |  | GJM0335C1E1R5CB01 | 0.1 |  | https://www.digikey.com/product-detail/en/murata-electronics-north-america/GJM0335C1E1R5CB01D/490-3057-1-ND/702323
 |  | C1037 | 1.8p | Device:C | Capacitor_SMD:C_0201_0603Metric | ~ |  |  | GJM0335C1E1R8RB12
 |  | C1038 | 1.8p | Device:C | Capacitor_SMD:C_0201_0603Metric | ~ |  |  | GJM0335C1E1R8RB12
 |  | C1039 | 1.5p | Device:C | Capacitor_SMD:C_0201_0603Metric | ~ |  |  | GJM0335C1E1R5CB01 | 0.1 |  | https://www.digikey.com/product-detail/en/murata-electronics-north-america/GJM0335C1E1R5CB01D/490-3057-1-ND/702323
 |  | C1045 | 10p | Device:C | Capacitor_SMD:C_0201_0603Metric | ~ | DNI |  | TMK063CG100DT-F | 0.1 |  | https://www.digikey.com/product-detail/en/taiyo-yuden/TMK063CG100DT-F/587-2302-1-ND/2118270
 |  | C1053 | 1.5p | Device:C | Capacitor_SMD:C_0201_0603Metric | ~ | DNI |  | GJM0335C1E1R5CB01 | 0.1 |  | https://www.digikey.com/product-detail/en/murata-electronics-north-america/GJM0335C1E1R5CB01D/490-3057-1-ND/702323
 |  | C1060 | 2.7p | Device:C | Capacitor_SMD:C_0201_0603Metric | ~ | DNI |  | GRM0335C1E2R7BD01D | - |  | https://www.mouser.com/ProductDetail/Murata-Electronics/GRM0335C1E2R7BD01D
 |  | C1061 | 100p | Device:C | Capacitor_SMD:C_0201_0603Metric | ~ |  |  | GRM033R71E101KA01D | 0.1 |  | https://www.digikey.com/product-detail/en/murata-electronics-north-america/GRM033R71E101KA01D/490-3172-1-ND/702713
 |  | C1063 | 10p | Device:C | Capacitor_SMD:C_0201_0603Metric | ~ |  |  | GJM0335C1E1R5CB01 | 0.1 |  | https://www.digikey.com/product-detail/en/murata-electronics-north-america/GJM0335C1E1R5CB01D/490-3057-1-ND/702323
 |  | C1065 | 1.5p | Device:C | Capacitor_SMD:C_0201_0603Metric | ~ | DNI |  | GJM0335C1E1R5CB01 | 0.1 |  | https://www.digikey.com/product-detail/en/murata-electronics-north-america/GJM0335C1E1R5CB01D/490-3057-1-ND/702323
 |  | C1087 | 2.2p | Device:C | Capacitor_SMD:C_0201_0603Metric | ~ |  |  | GJM0335C1E2R2CB01D | 0.1 |  | https://www.digikey.com/product-detail/en/murata-electronics-north-america/GJM0335C1E2R2CB01D/490-3061-1-ND/702327
 |  | C1088 | 10k | Device:R | Resistor_SMD:R_0402_1005Metric | ~ |  |  | TMK063CG100DT-F | 0.1 | 0% | https://www.digikey.com/product-detail/en/taiyo-yuden/TMK063CG100DT-F/587-2302-1-ND/2118270
 |  | C1098 | 10p | Device:C | Capacitor_SMD:C_0201_0603Metric | ~ |  |  | TMK063CG100DT-F | 0.1 |  | https://www.digikey.com/product-detail/en/taiyo-yuden/TMK063CG100DT-F/587-2302-1-ND/2118270
 |  | C1099 | 10p | Device:C | Capacitor_SMD:C_0201_0603Metric | ~ | DNI |  | TMK063CG100DT-F | 0.1 |  | https://www.digikey.com/product-detail/en/taiyo-yuden/TMK063CG100DT-F/587-2302-1-ND/2118270
 |  | C1100 | 10p | Device:C | Capacitor_SMD:C_0402_1005Metric | ~ |  |  | GRM1555C1H3R9CA01D | 0.1 |  | https://www.digikey.com/product-detail/en/murata-electronics-north-america/GRM1555C1H3R9CA01D/490-5940-1-ND/3721297
 |  | CN301 | uFL | MangOH-Red-Extra:uFL | Connector_Coaxial:U.FL_Hirose_U.FL-R-SMT-1_Vertical |  |  |  | U.FL-R-SMT(10) | 1.31 |  | https://www.digikey.com/product-detail/en/hirose-electric-co-ltd/U.FL-R-SMT-10/H9161CT-ND/2135256
 |  | CN302 | uFL | MangOH-Red-Extra:uFL | Connector_Coaxial:U.FL_Hirose_U.FL-R-SMT-1_Vertical |  |  |  | U.FL-R-SMT(10) | 1.31 |  | https://www.digikey.com/product-detail/en/hirose-electric-co-ltd/U.FL-R-SMT-10/H9161CT-ND/2135256
 |  | CN303 | uFL | MangOH-Red-Extra:uFL | Connector_Coaxial:U.FL_Hirose_U.FL-R-SMT-1_Vertical |  |  |  | U.FL-R-SMT(10) | 1.31 |  | https://www.digikey.com/product-detail/en/hirose-electric-co-ltd/U.FL-R-SMT-10/H9161CT-ND/2135256
 |  | CN304 | USB_A | Connector:USB_A | MangOH-Red:CONN_4P_1450x1400_USB_2GND_RA_THRU | ~ |  |  | 87520-5012BPSLF | - |  | https://www.mouser.com/ProductDetail/Amphenol-FCI/87520-5012BPSLF
 |  | CN305 | USB_B_Micro | Connector:USB_B_Micro | MangOH-Red:CONN_5P_0750x0560_USB_5GND_HRS_ZX62RD | ~ |  |  | ZX62RD-AB-5P8 | 1.02 |  | https://www.digikey.com/product-detail/en/hirose-electric-co-ltd/ZX62RD-AB-5P8-30/H125777CT-ND/8594856
 |  | CN306 | Conn_02x19_Counter_Clockwise | Connector_Generic:Conn_02x19_Counter_Clockwise | MangOH-Red:CONN_38P_1820x1150_0080CC_EVERCLEAR | ~ |  |  | FS1-R38-20A2-00 | 3.0 |  | https://www.digikey.com/product-detail/en/amphenol-icc-commercial-products/FS1-R38-20A2-00/FS1-R38-20A2-00CT-ND/2380307
 |  | CN307 | Conn_02x13_Odd_Even | Connector_Generic:Conn_02x13_Odd_Even | MangOH-Red:CONN_26P_3300x0483_0254CC_HEADER_THRU | ~ |  |  | 67997-226HLF | 1.02 |  | https://www.digikey.com/products/en?keywords=67997-226HLF
 |  | CN310 | Conn_02x03_Odd_Even | Connector_Generic:Conn_02x03_Odd_Even | MangOH-Red:CONN_6P_0760x0510_HEADER_THRU_0254CC | ~ |  |  | TSW-103-07-G-D | 0.65 |  | https://www.digikey.com/product-detail/en/samtec-inc/TSW-103-07-G-D/SAM1028-03-ND/1101274
 |  | CN312 | Conn_02x03_Odd_Even | Connector_Generic:Conn_02x03_Odd_Even | MangOH-Red:CONN_6P_0760x0510_HEADER_THRU_0254CC | ~ |  |  | TSW-103-07-G-D | 0.65 |  | https://www.digikey.com/product-detail/en/samtec-inc/TSW-103-07-G-D/SAM1028-03-ND/1101274
 |  | CN400 | Conn_02x05_Odd_Even | Connector_Generic:Conn_02x05_Odd_Even | MangOH-Red:CONN_10P_0673x0305_0127CC_SMT | ~ | DNI |  | SFMC-105-02-L-D-TR | 1.73 |  | https://www.digikey.com/products/en?keywords=SFMC-105-02-L-D-TR
 |  | CN401 | Conn_02x05_Odd_Even | Connector_Generic:Conn_02x05_Odd_Even | MangOH-Red:CONN_10P_0673x0305_0127CC_SMT | ~ | DNI |  | SFMC-105-02-L-D-TR | 1.73 |  | https://www.digikey.com/products/en?keywords=SFMC-105-02-L-D-TR
 |  | CN500 | JP036-RT3B4AB | MangOH-Red:JP036-RT3B4AB | Connector_Audio:Jack_3.5mm_PJ311_Horizontal |  |  |  | AJR2Q-6K2011
 |  | CN600 | CN600 | MangOH-Red:CN600 | MangOH-Red:CONN_25P_1780x1290_0088CC_MICROSDSIM |  |  |  | 104168-1620 | 3.07 |  | https://www.digikey.com/product-detail/en/molex/1041681620/WM12820CT-ND/5823214
 |  | CN801 | USB_B_Micro | Connector:USB_B_Micro | MangOH-Red:CONN_5P_0750x0560_USB_5GND_HRS_ZX62RD | ~ |  |  | ZX62RD-AB-5P8 | 1.02 |  | https://www.digikey.com/product-detail/en/hirose-electric-co-ltd/ZX62RD-AB-5P8-30/H125777CT-ND/8594856
 |  | CN802 | Conn_01x02 | Connector_Generic:Conn_01x02 | MangOH-Red:CONN_2P_0590x0450_0200CC_THRU_HEADER | ~ |  |  | B2B-PH-K-S | 0.17 |  | https://www.digikey.com/product-detail/en/jst-sales-america-inc/B2B-PH-K-S-LF-SN/455-1704-ND/926611
 |  | CN804 | Conn_01x03 | Connector_Generic:Conn_01x03 | MangOH-Red:CONN_3P_0762x0254_VERTICAL_HEADER_SINGLE_ROW_THRU_SAMTEC_TSW | ~ |  |  | TSW-103-14-T-S | 0.23 |  | https://www.digikey.com/product-detail/en/samtec-inc/TSW-103-14-T-S/SAM1059-03-ND/1102821
 |  | CN1000 | uFL | MangOH-Red-Extra:uFL | Connector_Coaxial:U.FL_Hirose_U.FL-R-SMT-1_Vertical |  |  |  | U.FL-R-SMT(10) | 1.31 |  | https://www.digikey.com/product-detail/en/hirose-electric-co-ltd/U.FL-R-SMT-10/H9161CT-ND/2135256
 |  | D200 | LED_PAD | Device:LED_PAD | MangOH-Red:12-21SYGC_S530-E2_TR8 | ~ |  |  | 12-21SYGC/S530-E2/TR8 | 0.32 |  | https://www.digikey.com/product-detail/en/everlight-electronics-co-ltd/12-21SYGC-S530-E2-TR8/1080-1451-1-ND/5308153
 |  | D301 | 0.05p | Device:D_TVS | LED_SMD:LED_0402_1005Metric | ~ |  |  | 0402ESDA-MLP1 | 0.42 |  | https://www.digikey.com/product-detail/en/eaton-electronics-division/0402ESDA-MLP1/283-2964-1-ND/2138900
 |  | D302 | 0.05p | Device:D_TVS | LED_SMD:LED_0402_1005Metric | ~ |  |  | 0402ESDA-MLP1 | 0.42 |  | https://www.digikey.com/product-detail/en/eaton-electronics-division/0402ESDA-MLP1/283-2964-1-ND/2138900
 |  | D303 | 0.05p | Device:D_TVS | LED_SMD:LED_0402_1005Metric | ~ |  |  | 0402ESDA-MLP1 | 0.42 |  | https://www.digikey.com/product-detail/en/eaton-electronics-division/0402ESDA-MLP1/283-2964-1-ND/2138900
 |  | D305 | TPD4S012DRYR | MangOH-Red:TPD4S012DRYR | MangOH-Red:DFN_6P_0145x0100_0050CC |  |  |  | TPD4S012DRYR | 0.72 |  | https://www.digikey.com/product-detail/en/texas-instruments/TPD4S012DRYR/296-24244-1-ND/2037535
 |  | D400 | D_TVS | Device:D_TVS | LED_SMD:LED_0402_1005Metric | ~ |  |  | 0402ESDA-MLP1 | 0.42 |  | https://www.digikey.com/product-detail/en/eaton-electronics-division/0402ESDA-MLP1/283-2964-1-ND/2138900
 |  | D401 | LED_PAD | Device:LED_PAD | MangOH-Red:12-21SYGC_S530-E2_TR8 | ~ |  |  | 12-21SYGC/S530-E2/TR8 | 0.32 |  | https://www.digikey.com/product-detail/en/everlight-electronics-co-ltd/12-21SYGC-S530-E2-TR8/1080-1451-1-ND/5308153
 |  | D402 | LED_PAD | Device:LED_PAD | MangOH-Red:12-21SYGC_S530-E2_TR8 | ~ |  |  | 12-21SYGC/S530-E2/TR8 | 0.32 |  | https://www.digikey.com/product-detail/en/everlight-electronics-co-ltd/12-21SYGC-S530-E2-TR8/1080-1451-1-ND/5308153
 |  | D410 | LED | Device:LED | LED_SMD:LED_0603_1608Metric | ~ |  |  | SML-310MTT86 | 0.39 |  | https://www.digikey.com/product-detail/en/rohm-semiconductor/SML-310MTT86/511-1299-1-ND/637112
 |  | D600 | RCLAMP0503N | MangOH-Red:RCLAMP0503N | MangOH-Red:DFN_6P_0145x0100_0050CC |  |  |  | RClamp0503N.TCT | 0.95 |  | https://www.digikey.com/product-detail/en/semtech-corporation/RCLAMP0503N.TCT/RCLAMP0503N.TCTCT-ND/5113715
 |  | D601 | TPD6E004RSER | MangOH-Red:TPD6E004RSER | MangOH-Red:QFN_8P_0150x0150_0050CC |  |  |  | TPD6E004RSER | 0.63 |  | https://www.digikey.com/product-detail/en/texas-instruments/TPD6E004RSER/296-23619-1-ND/1913507
 |  | D800 | TPD4S012DRYR | MangOH-Red:TPD4S012DRYR | MangOH-Red:DFN_6P_0145x0100_0050CC |  |  |  | TPD4S012DRYR | 0.72 |  | https://www.digikey.com/product-detail/en/texas-instruments/TPD4S012DRYR/296-24244-1-ND/2037535
 |  | D801 | LED | Device:LED | LED_SMD:LED_0603_1608Metric | ~ | DNI |  | SML-310MTT86 | 0.39 |  | https://www.digikey.com/product-detail/en/rohm-semiconductor/SML-310MTT86/511-1299-1-ND/637112
 |  | D803 | LED | Device:LED | LED_SMD:LED_0603_1608Metric | ~ |  |  | LG L29K-F2J1-24-Z | 0.51 |  | https://www.digikey.com/product-detail/en/osram-opto-semiconductors-inc/LG-L29K-F2J1-24-Z/475-3118-1-ND/4899549
 |  | FIL1000 | BL1608-05A2450TB | MangOH-Red:BL1608-05A2450TB | MangOH-Red:FIL_6P_0160x0080_0050CC_MURATA |  |  | BL1608-05A2450TB | BL1608-05A2450TB | 0.27 |  | https://www.mouser.com/ProductDetail/Walsin/RFBLN1608050AM8T62
 |  | J200 | CF3-Socket | MangOH-Red:CF3-Socket | MangOH-Red:SIERRA_WP_SNAP-IN_BASE |  |  |  | https://www.digikey.com/product-detail/en/sierra-wireless/HL-SNAP-IN-BASE_6000595/1645-1008-1-ND/5843827 | 9.91 |  | https://www.digikey.com/product-detail/en/sierra-wireless/HL-SNAP-IN-BASE_6000595/1645-1008-1-ND/5843827
 |  | J301 | Spring_Clip | Connector:TestPoint |  | ./datasheet/Universal_Contact_4.0mm.pdf | DNI |  | CU-120220-0206
 |  | J302 | Spring_Clip | Connector:TestPoint |  | ./datasheet/Universal_Contact_4.0mm.pdf | DNI |  | CU-120220-0206
 |  | L300 | 47n | Device:L | Inductor_SMD:L_0402_1005Metric | ~ |  |  | LQG15HN47NJ02D | 0.1 |  | https://www.digikey.com/product-detail/en/murata-electronics-north-america/LQG15HN47NJ02D/490-1093-1-ND/584539
 |  | L500 | 0 | Device:L | Inductor_SMD:L_0402_1005Metric | ~ |  |  | BK1005HS601-T | 0.1 |  | https://www.digikey.com/product-detail/en/taiyo-yuden/BK1005HS601-T/587-1846-1-ND/1465316
 |  | L501 | 0 | Device:L | Inductor_SMD:L_0402_1005Metric | ~ |  |  | BK1005HS601-T | 0.1 |  | https://www.digikey.com/product-detail/en/taiyo-yuden/BK1005HS601-T/587-1846-1-ND/1465316
 |  | L502 | 22n | Device:L | Inductor_SMD:L_0402_1005Metric | ~ |  |  | LG HK 1005 22NJ-T | 0.01 |  | https://www.digikey.com/product-detail/en/taiyo-yuden/HK100522NJ-TV/587-3999-2-ND/5034978
 |  | L503 | 22n | Device:L | Inductor_SMD:L_0402_1005Metric | ~ |  |  | LG HK 1005 22NJ-T | 0.01 |  | https://www.digikey.com/product-detail/en/taiyo-yuden/HK100522NJ-TV/587-3999-2-ND/5034978
 |  | L504 | 0 | Device:L | Inductor_SMD:L_0402_1005Metric | ~ |  |  | BK1005HS601-T | 0.1 |  | https://www.digikey.com/product-detail/en/taiyo-yuden/BK1005HS601-T/587-1846-1-ND/1465316
 |  | L505 | 0 | Device:L | Inductor_SMD:L_0402_1005Metric | ~ |  |  | BK1005HS601-T | 0.1 |  | https://www.digikey.com/product-detail/en/taiyo-yuden/BK1005HS601-T/587-1846-1-ND/1465316
 |  | L506 | 0 | Device:L | Inductor_SMD:L_0402_1005Metric | ~ |  |  | BK1005HS601-T | 0.1 |  | https://www.digikey.com/product-detail/en/taiyo-yuden/BK1005HS601-T/587-1846-1-ND/1465316
 |  | L507 | 0 | Device:L | Inductor_SMD:L_0402_1005Metric | ~ |  |  | BK1005HS601-T | 0.1 |  | https://www.digikey.com/product-detail/en/taiyo-yuden/BK1005HS601-T/587-1846-1-ND/1465316
 |  | L508 | 0 | Device:L | Inductor_SMD:L_0603_1608Metric | ~ |  |  | MPZ1608S221AT | 0.1 |  | https://www.digikey.com/product-detail/en/tdk-corporation/MPZ1608S221ATA00/445-1565-1-ND/571895
 |  | L800 | TCM1210-900-2P-T000 | MangOH-Red:TCM1210-900-2P-T000 | MangOH-Red:EXC24C |  |  |  | EXC24CG900U | 0.91 |  | https://www.digikey.com/product-detail/en/panasonic-electronic-components/EXC-24CG900U/P13570CT-ND/1137238
 |  | L801 | 3.3u | Device:L | MangOH-Red:IND_2P_0400x0400_0237CC_COILCRAFT | ~ |  |  | XAL4030-332MEB | 2.01 |  | https://www.mouser.com/ProductDetail/Coilcraft/XAL4030-332MEB
 |  | L802 | 0 | Device:L | Inductor_SMD:L_1812_4532Metric | ~ |  |  | 74279252 | 0.28 |  | https://www.digikey.com/product-detail/en/wurth-electronics-inc/74279252/732-13782-1-ND/10059012
 |  | L900 | 0 | Device:L | Inductor_SMD:L_0603_1608Metric | ~ |  |  | BKP1608HS121-T | 0.1 |  | https://www.digikey.com/product-detail/en/taiyo-yuden/BKP1608HS121-T/587-1923-1-ND/1465393
 |  | L901 | 0 | Device:L | Inductor_SMD:L_0603_1608Metric | ~ |  |  | MPZ1608S221AT | 0.1 |  | https://www.digikey.com/product-detail/en/tdk-corporation/MPZ1608S221ATA00/445-1565-1-ND/571895
 |  | L902 | 0 | Device:L | Inductor_SMD:L_0603_1608Metric | ~ |  |  | BKP1608HS121-T | 0.1 |  | https://www.digikey.com/product-detail/en/taiyo-yuden/BKP1608HS121-T/587-1923-1-ND/1465393
 |  | L903 | 0 | Device:L | Inductor_SMD:L_0603_1608Metric | ~ |  |  | BKP1608HS121-T | 0.1 |  | https://www.digikey.com/product-detail/en/taiyo-yuden/BKP1608HS121-T/587-1923-1-ND/1465393
 |  | L904 | 2.2u | Device:L | Inductor_SMD:L_1812_4532Metric | ~ |  |  | MIPF2016D2R2
 |  | L905 | 2.2u | Device:L | Inductor_SMD:L_1812_4532Metric | ~ |  |  | MIPF2016D2R2
 |  | L906 | 0 | Device:L | Inductor_SMD:L_0603_1608Metric | ~ |  |  | MPZ1608S221AT | 0.1 |  | https://www.digikey.com/product-detail/en/tdk-corporation/MPZ1608S221ATA00/445-1565-1-ND/571895
 |  | L907 | 0 | Device:L | Inductor_SMD:L_0603_1608Metric | ~ |  |  | MPZ1608S221AT | 0.1 |  | https://www.digikey.com/product-detail/en/tdk-corporation/MPZ1608S221ATA00/445-1565-1-ND/571895
 |  | L910 | 0 | Device:L | Inductor_SMD:L_0603_1608Metric | ~ |  |  | MPZ1608S221AT | 0.1 |  | https://www.digikey.com/product-detail/en/tdk-corporation/MPZ1608S221ATA00/445-1565-1-ND/571895
 |  | L911 | 0 | Device:L | Inductor_SMD:L_0805_2012Metric | ~ |  |  | DFE201210S-1R0M=P2 | 0.55 |  | https://www.digikey.com/product-detail/en/murata-electronics-north-america/DFE201210S-1R0M=P2/490-16678-1-ND/7595594
 |  | L912 | 0 | Device:L | Inductor_SMD:L_0603_1608Metric | ~ |  |  | BKP1608HS121-T | 0.1 |  | https://www.digikey.com/product-detail/en/taiyo-yuden/BKP1608HS121-T/587-1923-1-ND/1465393
 |  | L1000 | 2.2u | Device:L | Inductor_SMD:L_0603_1608Metric_Pad1.05x0.95mm_HandSolder | ~ |  |  | MIPSZ2520D2R2
 |  | L1001 | 1.2n | Device:L | Inductor_SMD:L_0201_0603Metric | ~ |  |  | LQP03TN1N2B02D | 0.1 |  | https://www.digikey.com/product-detail/en/murata-electronics-north-america/LQP03TN1N2B02D/490-6716-1-ND/5802364
 |  | L1002 | 1.2n | Device:L | Inductor_SMD:L_0201_0603Metric | ~ |  |  | LQP03TN1N2B02D | 0.1 |  | https://www.digikey.com/product-detail/en/murata-electronics-north-america/LQP03TN1N2B02D/490-6716-1-ND/5802364
 |  | L1026 | 2.2n | Device:L | Inductor_SMD:L_0201_0603Metric | ~ |  |  | LQP03TN1N2B02D | 0.1 |  | https://www.digikey.com/product-detail/en/murata-electronics-north-america/LQP03TN1N2B02D/490-6716-1-ND/5802364
 |  | L1087 | 2.4n | Device:L | Inductor_SMD:L_0201_0603Metric | ~ |  |  | LQP03TN2N4C02D | 0.17 |  | https://www.digikey.com/product-detail/en/murata-electronics-north-america/LQP03TN2N4C02D/490-5555-1-ND/2357654
 |  | MT300 | Round_Standoff_M2 | Connector:TestPoint | MangOH-Red:STANDOFF_0530_0300H_THRU | ~ |  |  | 9774030243 | 0.95 |  | https://www.digikey.com/product-detail/en/wurth-electronics-inc/9774030243R/732-7085-1-ND/5320690
 |  | MT301 | Round_Standoff_M2 | Connector:TestPoint | MangOH-Red:STANDOFF_0530_0300H_THRU | ~ |  |  | 9774030243 | 0.95 |  | https://www.digikey.com/product-detail/en/wurth-electronics-inc/9774030243R/732-7085-1-ND/5320690
 |  | OSC700 | ENE3687A | MangOH-Red:ENE3687A | Crystal:Crystal_SMD_SeikoEpson_FA238V-4Pin_3.2x2.5mm |  |  |  | NZ3225SA-26MHz
 |  | Q312 | NSBC114YDP6T5G | MangOH-Red:NSBC114YDP6T5G | MangOH-Red:SOT963_6P_0100x0080_0035CC |  |  |  | NSBC114YDP6T5G | 0.38 |  | https://www.digikey.com/product-detail/en/on-semiconductor/NSBC114YDP6T5G/NSBC114YDP6T5GOSCT-ND/9087466
 |  | Q400 | NSBC114YDP6T5G | MangOH-Red:NSBC114YDP6T5G | MangOH-Red:SOT963_6P_0100x0080_0035CC |  |  |  | NSBC114YDP6T5G | 0.38 |  | https://www.digikey.com/product-detail/en/on-semiconductor/NSBC114YDP6T5G/NSBC114YDP6T5GOSCT-ND/9087466
 |  | Q405 | NSBC114YDP6T5G | MangOH-Red:NSBC114YDP6T5G | MangOH-Red:SOT963_6P_0100x0080_0035CC |  |  |  | NSBC114YDP6T5G | 0.38 |  | https://www.digikey.com/product-detail/en/on-semiconductor/NSBC114YDP6T5G/NSBC114YDP6T5GOSCT-ND/9087466
 |  | Q600 | PDTC115EM | MangOH-Red:PDTC115EM | MangOH-Red:DFN_3P_0060x0100_0035CC | ./datasheet/PDTC115EM.pdf |  |  | PDTC115EM | 0.033 |  | https://www.digikey.com/product-detail/en/nexperia-usa-inc/PDTC115EM315/1727-3031-1-ND/893342
 |  | R216 | 0 | Device:R | Resistor_SMD:R_0402_1005Metric | ~ |  |  | RK73Z1ETTP | 0.1 |  | https://www.digikey.com/product-detail/en/koa-speer-electronics-inc/RK73Z1ETTP/2019-RK73Z1ETTPCT-ND/9846740
 |  | R217 | 0 | Device:R | Resistor_SMD:R_0402_1005Metric | ~ |  |  | RK73Z1ETTP | 0.1 |  | https://www.digikey.com/product-detail/en/koa-speer-electronics-inc/RK73Z1ETTP/2019-RK73Z1ETTPCT-ND/9846740
 |  | R222 | 280 | Device:R | Resistor_SMD:R_0402_1005Metric | ~ |  |  | RK73B1ETTP821J | 0.1 |  | https://www.digikey.com/product-detail/en/koa-speer-electronics-inc/RK73B1ETTP821J/2019-RK73B1ETTP821JCT-ND/9846073
 |  | R223 | 0 | Device:R | Resistor_SMD:R_0402_1005Metric | ~ |  |  | RK73Z1ETTP | 0.1 |  | https://www.digikey.com/product-detail/en/koa-speer-electronics-inc/RK73Z1ETTP/2019-RK73Z1ETTPCT-ND/9846740
 |  | R224 | 0 | Device:R | Resistor_SMD:R_0402_1005Metric | ~ |  |  | RK73Z1ETTP | 0.1 |  | https://www.digikey.com/product-detail/en/koa-speer-electronics-inc/RK73Z1ETTP/2019-RK73Z1ETTPCT-ND/9846740
 |  | R230 | 0 | Device:R | Resistor_SMD:R_0402_1005Metric | ~ |  |  | RK73Z1ETTP | 0.1 |  | https://www.digikey.com/product-detail/en/koa-speer-electronics-inc/RK73Z1ETTP/2019-RK73Z1ETTPCT-ND/9846740
 |  | R238 | 0 | Device:R | Resistor_SMD:R_0402_1005Metric | ~ |  |  | RK73Z1ETTP | 0.1 |  | https://www.digikey.com/product-detail/en/koa-speer-electronics-inc/RK73Z1ETTP/2019-RK73Z1ETTPCT-ND/9846740
 |  | R251 | 100k | Device:R | Resistor_SMD:R_0402_1005Metric | ~ | DNI |  | MCR01MZPF1003 | 0.1 | 1% | https://www.digikey.com/product-detail/en/rohm-semiconductor/MCR01MZPF1003/RHM100KLCT-ND/628066
 |  | R252 | 0 | Device:R | Resistor_SMD:R_0402_1005Metric | ~ |  |  | RK73Z1ETTP | 0.1 |  | https://www.digikey.com/product-detail/en/koa-speer-electronics-inc/RK73Z1ETTP/2019-RK73Z1ETTPCT-ND/9846740
 |  | R255 | 0 | Device:R | Resistor_SMD:R_0402_1005Metric | ~ | DNI |  | RK73Z1ETTP | 0.1 |  | https://www.digikey.com/product-detail/en/koa-speer-electronics-inc/RK73Z1ETTP/2019-RK73Z1ETTPCT-ND/9846740
 |  | R260 | 0 | Device:R | Resistor_SMD:R_0402_1005Metric | ~ |  |  | RK73Z1ETTP | 0.1 |  | https://www.digikey.com/product-detail/en/koa-speer-electronics-inc/RK73Z1ETTP/2019-RK73Z1ETTPCT-ND/9846740
 |  | R267 | 0 | Device:R | Resistor_SMD:R_0402_1005Metric | ~ |  |  | RK73Z1ETTP | 0.1 |  | https://www.digikey.com/product-detail/en/koa-speer-electronics-inc/RK73Z1ETTP/2019-RK73Z1ETTPCT-ND/9846740
 |  | R278 | 0 | Device:R | Resistor_SMD:R_0402_1005Metric | ~ |  |  | RK73Z1ETTP | 0.1 |  | https://www.digikey.com/product-detail/en/koa-speer-electronics-inc/RK73Z1ETTP/2019-RK73Z1ETTPCT-ND/9846740
 |  | R279 | 0 | Device:R | Resistor_SMD:R_0402_1005Metric | ~ | DNI |  | RK73Z1ETTP | 0.1 |  | https://www.digikey.com/product-detail/en/koa-speer-electronics-inc/RK73Z1ETTP/2019-RK73Z1ETTPCT-ND/9846740
 |  | R286 | 10k | Device:R | Resistor_SMD:R_0402_1005Metric | ~ |  |  | MCR01MZPF1002 | 0.1 | 1% | https://www.digikey.com/product-detail/en/rohm-semiconductor/MCR01MZPF1002/RHM10.0KLCT-ND/628065
 |  | R287 | 100 | Device:R | Resistor_SMD:R_0402_1005Metric | ~ |  |  | RK73B1ETTP101J | 0.1 | 5% | https://www.digikey.com/product-detail/en/koa-speer-electronics-inc/RK73B1ETTP101J/2019-RK73B1ETTP101JCT-ND/9846008
 |  | R291 | 100k | Device:R | Resistor_SMD:R_0402_1005Metric | ~ | DNI |  | MCR01MZPF1003 | 0.1 | 1% | https://www.digikey.com/product-detail/en/rohm-semiconductor/MCR01MZPF1003/RHM100KLCT-ND/628066
 |  | R301 | 10k | Device:R | Resistor_SMD:R_0402_1005Metric | ~ |  |  | MCR01MZPF1002 | 0.1 |  | https://www.digikey.com/product-detail/en/rohm-semiconductor/MCR01MZPF1002/RHM10.0KLCT-ND/628065
 |  | R306 | 10k | Device:R | Resistor_SMD:R_0402_1005Metric | ~ | DNI |  | MCR01MZPF1002 | 0.1 | 1% | https://www.digikey.com/product-detail/en/rohm-semiconductor/MCR01MZPF1002/RHM10.0KLCT-ND/628065
 |  | R307 | 220 | Device:R | Resistor_SMD:R_0402_1005Metric | ~ | DNI |  | RK73H1ETTP2200F | 0.1 | 1% | https://www.digikey.com/product-detail/en/koa-speer-electronics-inc/RK73H1ETTP2200F/2019-RK73H1ETTP2200FCT-ND/9846151
 |  | R309 | 0 | Device:R | Resistor_SMD:R_0402_1005Metric | ~ |  |  | RK73Z1ETTP | 0.1 |  | https://www.digikey.com/product-detail/en/koa-speer-electronics-inc/RK73Z1ETTP/2019-RK73Z1ETTPCT-ND/9846740
 |  | R310 | 22 | Device:R | Resistor_SMD:R_0402_1005Metric | ~ |  |  | RK73H1ETTP22R0F | 0.1 |  | https://www.digikey.com/product-detail/en/koa-speer-electronics-inc/RK73H1ETTP22R0F/2019-RK73H1ETTP22R0FCT-ND/9846216
 |  | R311 | 22 | Device:R | Resistor_SMD:R_0402_1005Metric | ~ |  |  | RK73H1ETTP22R0F | 0.1 |  | https://www.digikey.com/product-detail/en/koa-speer-electronics-inc/RK73H1ETTP22R0F/2019-RK73H1ETTP22R0FCT-ND/9846216
 |  | R312 | 10k | Device:R | Resistor_SMD:R_0402_1005Metric | ~ |  |  | MCR01MZPF1002 | 0.1 |  | https://www.digikey.com/product-detail/en/rohm-semiconductor/MCR01MZPF1002/RHM10.0KLCT-ND/628065
 |  | R313 | 10k | Device:R | Resistor_SMD:R_0402_1005Metric | ~ | DNI |  | MCR01MZPF1002 | 0.1 | 1% | https://www.digikey.com/product-detail/en/rohm-semiconductor/MCR01MZPF1002/RHM10.0KLCT-ND/628065
 |  | R314 | 47k | Device:R | Resistor_SMD:R_0402_1005Metric | ~ |  |  | MCR01MZPJ473 | 0.1 |  | https://www.digikey.com/product-detail/en/rohm-semiconductor/MCR01MZPJ473/RHM47KJCT-ND/628298
 |  | R330 | 27 | Device:R | Resistor_SMD:R_0402_1005Metric | ~ |  |  | RK73H1ETTP27R0F | 0.1 |  | https://www.digikey.com/product-detail/en/koa-speer-electronics-inc/RK73H1ETTP27R0F/2019-RK73H1ETTP27R0FCT-ND/9846577
 |  | R331 | 27 | Device:R | Resistor_SMD:R_0402_1005Metric | ~ |  |  | RK73H1ETTP27R0F | 0.1 |  | https://www.digikey.com/product-detail/en/koa-speer-electronics-inc/RK73H1ETTP27R0F/2019-RK73H1ETTP27R0FCT-ND/9846577
 |  | R340 | 0 | Device:R | Resistor_SMD:R_0402_1005Metric | ~ |  |  | RK73Z1ETTP | 0.1 | 1% | https://www.digikey.com/product-detail/en/koa-speer-electronics-inc/RK73Z1ETTP/2019-RK73Z1ETTPCT-ND/9846740
 |  | R341 | 0 | Device:R | Resistor_SMD:R_0402_1005Metric | ~ | DNI |  | RK73Z1ETTP | 0.1 | 1% | https://www.digikey.com/product-detail/en/koa-speer-electronics-inc/RK73Z1ETTP/2019-RK73Z1ETTPCT-ND/9846740
 |  | R343 | 0 | Device:R | Resistor_SMD:R_0402_1005Metric | ~ |  |  | RK73Z1ETTP | 0.1 |  | https://www.digikey.com/product-detail/en/koa-speer-electronics-inc/RK73Z1ETTP/2019-RK73Z1ETTPCT-ND/9846740
 |  | R344 | 0 | Device:R | Resistor_SMD:R_0402_1005Metric | ~ | DNI |  | RK73Z1ETTP | 0.1 |  | https://www.digikey.com/product-detail/en/koa-speer-electronics-inc/RK73Z1ETTP/2019-RK73Z1ETTPCT-ND/9846740
 |  | R345 | 0 | Device:R | Resistor_SMD:R_0402_1005Metric | ~ |  |  | LG L29K-F2J1-24-Z | 0.51 |  | https://www.digikey.com/product-detail/en/osram-opto-semiconductors-inc/LG-L29K-F2J1-24-Z/475-3118-1-ND/4899549
 |  | R346 | 0 | Device:R | Resistor_SMD:R_0402_1005Metric | ~ |  |  | RK73Z1ETTP | 0.1 |  | https://www.digikey.com/product-detail/en/koa-speer-electronics-inc/RK73Z1ETTP/2019-RK73Z1ETTPCT-ND/9846740
 |  | R347 | 0 | Device:R | Resistor_SMD:R_0402_1005Metric | ~ |  |  | RK73Z1ETTP | 0.1 |  | https://www.digikey.com/product-detail/en/koa-speer-electronics-inc/RK73Z1ETTP/2019-RK73Z1ETTPCT-ND/9846740
 |  | R348 | 0 | Device:R | Resistor_SMD:R_0402_1005Metric | ~ |  |  | RK73Z1ETTP | 0.1 |  | https://www.digikey.com/product-detail/en/koa-speer-electronics-inc/RK73Z1ETTP/2019-RK73Z1ETTPCT-ND/9846740
 |  | R349 | 820k | Device:R | Resistor_SMD:R_0402_1005Metric | ~ |  |  | RK73H1ETTP8203F | 0.1 |  | https://www.digikey.com/product-detail/en/koa-speer-electronics-inc/RK73H1ETTP8203F/2019-RK73H1ETTP8203FCT-ND/9846495
 |  | R350 | 0 | Device:R | Resistor_SMD:R_0402_1005Metric | ~ |  |  | RK73Z1ETTP | 0.1 |  | https://www.digikey.com/product-detail/en/koa-speer-electronics-inc/RK73Z1ETTP/2019-RK73Z1ETTPCT-ND/9846740
 |  | R361 | 820k | Device:R | Resistor_SMD:R_0402_1005Metric | ~ |  |  | RK73H1ETTP8203F | 0.1 |  | https://www.digikey.com/product-detail/en/koa-speer-electronics-inc/RK73H1ETTP8203F/2019-RK73H1ETTP8203FCT-ND/9846495
 |  | R363 | 0 | Device:R | Resistor_SMD:R_0402_1005Metric | ~ |  |  | RK73Z1ETTP | 0.1 |  | https://www.digikey.com/product-detail/en/koa-speer-electronics-inc/RK73Z1ETTP/2019-RK73Z1ETTPCT-ND/9846740
 |  | R365 | 0 | Device:R | Resistor_SMD:R_0402_1005Metric | ~ |  |  | RK73Z1ETTP | 0.1 |  | https://www.digikey.com/product-detail/en/koa-speer-electronics-inc/RK73Z1ETTP/2019-RK73Z1ETTPCT-ND/9846740
 |  | R366 | 0 | Device:R | Resistor_SMD:R_0402_1005Metric | ~ |  |  | RK73Z1ETTP | 0.1 |  | https://www.digikey.com/product-detail/en/koa-speer-electronics-inc/RK73Z1ETTP/2019-RK73Z1ETTPCT-ND/9846740
 |  | R367 | 0 | Device:R | Resistor_SMD:R_0402_1005Metric | ~ | DNI |  | RK73Z1ETTP | 0.1 |  | https://www.digikey.com/product-detail/en/koa-speer-electronics-inc/RK73Z1ETTP/2019-RK73Z1ETTPCT-ND/9846740
 |  | R368 | 0 | Device:R | Resistor_SMD:R_0402_1005Metric | ~ | DNI |  | RK73Z1ETTP | 0.1 |  | https://www.digikey.com/product-detail/en/koa-speer-electronics-inc/RK73Z1ETTP/2019-RK73Z1ETTPCT-ND/9846740
 |  | R369 | 0 | Device:R | Resistor_SMD:R_0402_1005Metric | ~ | DNI |  | RK73Z1ETTP | 0.1 |  | https://www.digikey.com/product-detail/en/koa-speer-electronics-inc/RK73Z1ETTP/2019-RK73Z1ETTPCT-ND/9846740
 |  | R370 | 0 | Device:R | Resistor_SMD:R_0402_1005Metric | ~ |  |  | RK73Z1ETTP | 0.1 |  | https://www.digikey.com/product-detail/en/koa-speer-electronics-inc/RK73Z1ETTP/2019-RK73Z1ETTPCT-ND/9846740
 |  | R371 | 0 | Device:R | Resistor_SMD:R_0402_1005Metric | ~ |  |  | RK73Z1ETTP | 0.1 |  | https://www.digikey.com/product-detail/en/koa-speer-electronics-inc/RK73Z1ETTP/2019-RK73Z1ETTPCT-ND/9846740
 |  | R372 | 10k | Device:R | Resistor_SMD:R_0402_1005Metric | ~ |  |  | MCR01MZPF1002 | 0.1 |  | https://www.digikey.com/product-detail/en/rohm-semiconductor/MCR01MZPF1002/RHM10.0KLCT-ND/628065
 |  | R373 | 0 | Device:R | Resistor_SMD:R_0402_1005Metric | ~ |  |  | RK73Z1ETTP | 0.1 |  | https://www.digikey.com/product-detail/en/koa-speer-electronics-inc/RK73Z1ETTP/2019-RK73Z1ETTPCT-ND/9846740
 |  | R374 | 0 | Device:R | Resistor_SMD:R_0402_1005Metric | ~ |  |  | RK73Z1ETTP | 0.1 |  | https://www.digikey.com/product-detail/en/koa-speer-electronics-inc/RK73Z1ETTP/2019-RK73Z1ETTPCT-ND/9846740
 |  | R375 | 0 | Device:R | Resistor_SMD:R_0402_1005Metric | ~ |  |  | RK73Z1ETTP | 0.1 |  | https://www.digikey.com/product-detail/en/koa-speer-electronics-inc/RK73Z1ETTP/2019-RK73Z1ETTPCT-ND/9846740
 |  | R376 | 10k | Device:R | Resistor_SMD:R_0402_1005Metric | ~ |  |  | MCR01MZPF1002 | 0.1 |  | https://www.digikey.com/product-detail/en/rohm-semiconductor/MCR01MZPF1002/RHM10.0KLCT-ND/628065
 |  | R377 | 10k | Device:R | Resistor_SMD:R_0402_1005Metric | ~ |  |  | MCR01MZPF1002 | 0.1 |  | https://www.digikey.com/product-detail/en/rohm-semiconductor/MCR01MZPF1002/RHM10.0KLCT-ND/628065
 |  | R378 | 820k | Device:R | Resistor_SMD:R_0402_1005Metric | ~ |  |  | RK73H1ETTP8203F | 0.1 | 1% | https://www.digikey.com/product-detail/en/koa-speer-electronics-inc/RK73H1ETTP8203F/2019-RK73H1ETTP8203FCT-ND/9846495
 |  | R379 | 10k | Device:R | Resistor_SMD:R_0402_1005Metric | ~ | DNI |  | MCR01MZPF1002 | 0.1 |  | https://www.digikey.com/product-detail/en/rohm-semiconductor/MCR01MZPF1002/RHM10.0KLCT-ND/628065
 |  | R382 | 0 | Device:R | Resistor_SMD:R_0402_1005Metric | ~ | DNI |  | RK73Z1ETTP | 0.1 |  | https://www.digikey.com/product-detail/en/koa-speer-electronics-inc/RK73Z1ETTP/2019-RK73Z1ETTPCT-ND/9846740
 |  | R388 | 10k | Device:R | Resistor_SMD:R_0402_1005Metric | ~ | DNI |  | MCR01MZPF1002 | 0.1 |  | https://www.digikey.com/product-detail/en/rohm-semiconductor/MCR01MZPF1002/RHM10.0KLCT-ND/628065
 |  | R392 | 0 | Device:R | Resistor_SMD:R_0402_1005Metric | ~ | DNI |  | RK73Z1ETTP | 0.1 |  | https://www.digikey.com/product-detail/en/koa-speer-electronics-inc/RK73Z1ETTP/2019-RK73Z1ETTPCT-ND/9846740
 |  | R400 | 0 | Device:R | Resistor_SMD:R_0402_1005Metric | ~ |  |  | RK73Z1ETTP | 0.1 |  | https://www.digikey.com/product-detail/en/koa-speer-electronics-inc/RK73Z1ETTP/2019-RK73Z1ETTPCT-ND/9846740
 |  | R401 | 47k | Device:R | Resistor_SMD:R_0402_1005Metric | ~ |  |  | MCR01MZPJ473 | 0.1 |  | https://www.digikey.com/product-detail/en/rohm-semiconductor/MCR01MZPJ473/RHM47KJCT-ND/628298
 |  | R402 | 100k | Device:R | Resistor_SMD:R_0402_1005Metric | ~ | DNI |  | RK73B1ETTP104J | 0.1 |  | https://www.digikey.com/product-detail/en/koa-speer-electronics-inc/RK73B1ETTP104J/2019-RK73B1ETTP104JCT-ND/9846007
 |  | R403 | 47k | Device:R | Resistor_SMD:R_0402_1005Metric | ~ | DNI |  | MCR01MZPJ473 | 0.1 |  | https://www.digikey.com/product-detail/en/rohm-semiconductor/MCR01MZPJ473/RHM47KJCT-ND/628298
 |  | R404 | 10k | Device:R | Resistor_SMD:R_0402_1005Metric | ~ |  |  | MCR01MZPF1002 | 0.1 | 1% | https://www.digikey.com/product-detail/en/rohm-semiconductor/MCR01MZPF1002/RHM10.0KLCT-ND/628065
 |  | R405 | 820 | Device:R | Resistor_SMD:R_0402_1005Metric | ~ |  |  | RK73Z1ETTP | 0.1 |  | https://www.digikey.com/product-detail/en/koa-speer-electronics-inc/RK73Z1ETTP/2019-RK73Z1ETTPCT-ND/9846740
 |  | R409 | 330 | Device:R | Resistor_SMD:R_0402_1005Metric | ~ |  |  | RK73H1ETTP3300F | 0.1 | 1% | https://www.digikey.com/product-detail/en/koa-speer-electronics-inc/RK73H1ETTP3300F/2019-RK73H1ETTP3300FCT-ND/9846140
 |  | R410 | 100 | Device:R | Resistor_SMD:R_0402_1005Metric | ~ |  |  | RK73B1ETTP101J | 0.1 |  | https://www.digikey.com/product-detail/en/koa-speer-electronics-inc/RK73B1ETTP101J/2019-RK73B1ETTP101JCT-ND/9846008
 |  | R411 | 10k | Device:R | Resistor_SMD:R_0402_1005Metric | ~ | DNI |  | MCR01MZPF1002 | 0.1 | 1% | https://www.digikey.com/product-detail/en/rohm-semiconductor/MCR01MZPF1002/RHM10.0KLCT-ND/628065
 |  | R413 | 820 | Device:R | Resistor_SMD:R_0402_1005Metric | ~ |  |  | RK73B1ETTP821J | 0.1 |  | https://www.digikey.com/product-detail/en/koa-speer-electronics-inc/RK73B1ETTP821J/2019-RK73B1ETTP821JCT-ND/9846073
 |  | R416 | 0 | Device:R | Resistor_SMD:R_0402_1005Metric | ~ |  |  | RK73Z1ETTP | 0.1 |  | https://www.digikey.com/product-detail/en/koa-speer-electronics-inc/RK73Z1ETTP/2019-RK73Z1ETTPCT-ND/9846740
 |  | R417 | 0 | Device:R | Resistor_SMD:R_0402_1005Metric | ~ |  |  | RK73Z1ETTP | 0.1 |  | https://www.digikey.com/product-detail/en/koa-speer-electronics-inc/RK73Z1ETTP/2019-RK73Z1ETTPCT-ND/9846740
 |  | R418 | 0 | Device:R | Resistor_SMD:R_0402_1005Metric | ~ |  |  | RK73Z1ETTP | 0.1 |  | https://www.digikey.com/product-detail/en/koa-speer-electronics-inc/RK73Z1ETTP/2019-RK73Z1ETTPCT-ND/9846740
 |  | R419 | 4.7k | Device:R | Resistor_SMD:R_0402_1005Metric | ~ |  |  | MCR01MZPF4701 | 0.1 |  | https://www.digikey.com/product-detail/en/yageo/RC0402FR-07330RL/311-330LRCT-ND/729541
 |  | R420 | 4.7k | Device:R | Resistor_SMD:R_0402_1005Metric | ~ |  |  | MCR01MZPF4701 | 0.1 |  | https://www.digikey.com/product-detail/en/yageo/RC0402FR-07330RL/311-330LRCT-ND/729541
 |  | R421 | 4.7k | Device:R | Resistor_SMD:R_0402_1005Metric | ~ |  |  | MCR01MZPF4701 | 0.1 |  | https://www.digikey.com/product-detail/en/yageo/RC0402FR-07330RL/311-330LRCT-ND/729541
 |  | R422 | 10k | Device:R | Resistor_SMD:R_0402_1005Metric | ~ | DNI |  | MCR01MZPJ103 | 0.1 |  | https://www.digikey.com/product-detail/en/rohm-semiconductor/MCR01MZPJ103/RHM10KJCT-ND/628226
 |  | R423 | 4.7k | Device:R | Resistor_SMD:R_0402_1005Metric | ~ |  |  | MCR01MZPF4701 | 0.1 |  | https://www.digikey.com/product-detail/en/yageo/RC0402FR-07330RL/311-330LRCT-ND/729541
 |  | R425 | 10k | Device:R | Resistor_SMD:R_0402_1005Metric | ~ |  |  | MCR01MZPJ103 | 0.1 | 5% | https://www.digikey.com/product-detail/en/rohm-semiconductor/MCR01MZPJ103/RHM10KJCT-ND/628226
 |  | R426 | 0 | Device:R | Resistor_SMD:R_0402_1005Metric | ~ |  |  | RK73Z1ETTP | 0.1 |  | https://www.digikey.com/product-detail/en/koa-speer-electronics-inc/RK73Z1ETTP/2019-RK73Z1ETTPCT-ND/9846740
 |  | R427 | 0 | Device:R | Resistor_SMD:R_0402_1005Metric | ~ |  |  | RK73Z1ETTP | 0.1 |  | https://www.digikey.com/product-detail/en/koa-speer-electronics-inc/RK73Z1ETTP/2019-RK73Z1ETTPCT-ND/9846740
 |  | R428 | 4.7k | Device:R | Resistor_SMD:R_0402_1005Metric | ~ |  |  | MCR01MZPF4701 | 0.1 |  | https://www.digikey.com/product-detail/en/yageo/RC0402FR-07330RL/311-330LRCT-ND/729541
 |  | R429 | 4.7k | Device:R | Resistor_SMD:R_0402_1005Metric | ~ |  |  | MCR01MZPF4701 | 0.1 |  | https://www.digikey.com/product-detail/en/yageo/RC0402FR-07330RL/311-330LRCT-ND/729541
 |  | R430 | 4.7k | Device:R | Resistor_SMD:R_0402_1005Metric | ~ |  |  | MCR01MZPF4701 | 0.1 |  | https://www.digikey.com/product-detail/en/yageo/RC0402FR-07330RL/311-330LRCT-ND/729541
 |  | R431 | 4.7k | Device:R | Resistor_SMD:R_0402_1005Metric | ~ |  |  | MCR01MZPF4701 | 0.1 |  | https://www.digikey.com/product-detail/en/yageo/RC0402FR-07330RL/311-330LRCT-ND/729541
 |  | R432 | 100k | Device:R | Resistor_SMD:R_0402_1005Metric | ~ |  |  | RK73B1ETTP104J | 0.1 |  | https://www.digikey.com/product-detail/en/koa-speer-electronics-inc/RK73B1ETTP104J/2019-RK73B1ETTP104JCT-ND/9846007
 |  | R433 | 10k | Device:R | Resistor_SMD:R_0402_1005Metric | ~ |  |  | MCR01MZPF1002 | 0.1 | 1% | https://www.digikey.com/product-detail/en/rohm-semiconductor/MCR01MZPF1002/RHM10.0KLCT-ND/628065
 |  | R435 | 820 | Device:R | Resistor_SMD:R_0402_1005Metric | ~ |  |  | RK73B1ETTP821J | 0.1 |  | https://www.digikey.com/product-detail/en/koa-speer-electronics-inc/RK73B1ETTP821J/2019-RK73B1ETTP821JCT-ND/9846073
 |  | R436 | 10k | Device:R | Resistor_SMD:R_0402_1005Metric | ~ |  |  | MCR01MZPJ103 | 0.1 |  | https://www.digikey.com/product-detail/en/rohm-semiconductor/MCR01MZPJ103/RHM10KJCT-ND/628226
 |  | R439 | 0 | Device:R | Resistor_SMD:R_0402_1005Metric | ~ | DNI |  | RK73Z1ETTP | 0.1 |  | https://www.digikey.com/product-detail/en/koa-speer-electronics-inc/RK73Z1ETTP/2019-RK73Z1ETTPCT-ND/9846740
 |  | R440 | 0 | Device:R | Resistor_SMD:R_0402_1005Metric | ~ | DNI |  | RK73Z1ETTP | 0.1 |  | https://www.digikey.com/product-detail/en/koa-speer-electronics-inc/RK73Z1ETTP/2019-RK73Z1ETTPCT-ND/9846740
 |  | R441 | 0 | Device:R | Resistor_SMD:R_0402_1005Metric | ~ |  |  | RK73Z1ETTP | 0.1 |  | https://www.digikey.com/product-detail/en/koa-speer-electronics-inc/RK73Z1ETTP/2019-RK73Z1ETTPCT-ND/9846740
 |  | R442 | 0 | Device:R | Resistor_SMD:R_0402_1005Metric | ~ |  |  | RK73Z1ETTP | 0.1 |  | https://www.digikey.com/product-detail/en/koa-speer-electronics-inc/RK73Z1ETTP/2019-RK73Z1ETTPCT-ND/9846740
 |  | R445 | 100 | Device:R | Resistor_SMD:R_0402_1005Metric | ~ | DNI |  | RK73B1ETTP101J | 0.1 | 5% | https://www.digikey.com/product-detail/en/koa-speer-electronics-inc/RK73B1ETTP101J/2019-RK73B1ETTP101JCT-ND/9846008
 |  | R450 | 10k | Device:R | Resistor_SMD:R_0402_1005Metric | ~ |  |  | MCR01MZPJ103 | 0.1 |  | https://www.digikey.com/product-detail/en/rohm-semiconductor/MCR01MZPJ103/RHM10KJCT-ND/628226
 |  | R451 | 10k | Device:R | Resistor_SMD:R_0402_1005Metric | ~ |  |  | MCR01MZPJ103 | 0.1 |  | https://www.digikey.com/product-detail/en/rohm-semiconductor/MCR01MZPJ103/RHM10KJCT-ND/628226
 |  | R455 | 47k | Device:R | Resistor_SMD:R_0402_1005Metric | ~ |  |  | MCR01MZPJ473 | 0.1 |  | https://www.digikey.com/product-detail/en/rohm-semiconductor/MCR01MZPJ473/RHM47KJCT-ND/628298
 |  | R456 | 47k | Device:R | Resistor_SMD:R_0402_1005Metric | ~ | DNI |  | MCR01MZPJ473 | 0.1 |  | https://www.digikey.com/product-detail/en/rohm-semiconductor/MCR01MZPJ473/RHM47KJCT-ND/628298
 |  | R457 | 47k | Device:R | Resistor_SMD:R_0402_1005Metric | ~ |  |  | MCR01MZPJ473 | 0.1 |  | https://www.digikey.com/product-detail/en/rohm-semiconductor/MCR01MZPJ473/RHM47KJCT-ND/628298
 |  | R458 | 330 | Device:R | Resistor_SMD:R_0402_1005Metric | ~ |  |  | RK73H1ETTP3300F | 0.1 | 1% | https://www.digikey.com/product-detail/en/koa-speer-electronics-inc/RK73H1ETTP3300F/2019-RK73H1ETTP3300FCT-ND/9846140
 |  | R459 | 100 | Device:R | Resistor_SMD:R_0402_1005Metric | ~ |  |  | RK73B1ETTP101J | 0.1 | 5% | https://www.digikey.com/product-detail/en/koa-speer-electronics-inc/RK73B1ETTP101J/2019-RK73B1ETTP101JCT-ND/9846008
 |  | R460 | 0 | Device:R | Resistor_SMD:R_0402_1005Metric | ~ | DNI |  | RK73Z1ETTP | 0.1 |  | https://www.digikey.com/product-detail/en/koa-speer-electronics-inc/RK73Z1ETTP/2019-RK73Z1ETTPCT-ND/9846740
 |  | R461 | 0 | Device:R | Resistor_SMD:R_0402_1005Metric | ~ | DNI |  | RK73Z1ETTP | 0.1 |  | https://www.digikey.com/product-detail/en/koa-speer-electronics-inc/RK73Z1ETTP/2019-RK73Z1ETTPCT-ND/9846740
 |  | R462 | 10k | Device:R | Resistor_SMD:R_0402_1005Metric | ~ |  |  | MCR01MZPJ103 | 0.1 |  | https://www.digikey.com/product-detail/en/rohm-semiconductor/MCR01MZPJ103/RHM10KJCT-ND/628226
 |  | R463 | 10k | Device:R | Resistor_SMD:R_0402_1005Metric | ~ |  |  | MCR01MZPJ103 | 0.1 |  | https://www.digikey.com/product-detail/en/rohm-semiconductor/MCR01MZPJ103/RHM10KJCT-ND/628226
 |  | R464 | 0 | Device:R | Resistor_SMD:R_0402_1005Metric | ~ |  |  | RK73Z1ETTP | 0.1 |  | https://www.digikey.com/product-detail/en/koa-speer-electronics-inc/RK73Z1ETTP/2019-RK73Z1ETTPCT-ND/9846740
 |  | R465 | 0 | Device:R | Resistor_SMD:R_0402_1005Metric | ~ |  |  | RK73Z1ETTP | 0.1 |  | https://www.digikey.com/product-detail/en/koa-speer-electronics-inc/RK73Z1ETTP/2019-RK73Z1ETTPCT-ND/9846740
 |  | R466 | 4.7k | Device:R | Resistor_SMD:R_0402_1005Metric | ~ | DNI |  | MCR01MZPF4701 | 0.1 |  | https://www.digikey.com/product-detail/en/yageo/RC0402FR-07330RL/311-330LRCT-ND/729541
 |  | R467 | 0 | Device:R | Resistor_SMD:R_0402_1005Metric | ~ |  |  | RK73Z1ETTP | 0.1 |  | https://www.digikey.com/product-detail/en/koa-speer-electronics-inc/RK73Z1ETTP/2019-RK73Z1ETTPCT-ND/9846740
 |  | R475 | 0 | Device:R | Resistor_SMD:R_0402_1005Metric | ~ | DNI |  | RK73Z1ETTP | 0.1 |  | https://www.digikey.com/product-detail/en/koa-speer-electronics-inc/RK73Z1ETTP/2019-RK73Z1ETTPCT-ND/9846740
 |  | R476 | 47k | Device:R | Resistor_SMD:R_0402_1005Metric | ~ | DNI |  | MCR01MZPJ473 | 0.1 |  | https://www.digikey.com/product-detail/en/rohm-semiconductor/MCR01MZPJ473/RHM47KJCT-ND/628298
 |  | R477 | 820 | Device:R | Resistor_SMD:R_0402_1005Metric | ~ |  |  | RK73B1ETTP821J | 0.1 |  | https://www.digikey.com/product-detail/en/koa-speer-electronics-inc/RK73B1ETTP821J/2019-RK73B1ETTP821JCT-ND/9846073
 |  | R495 | 0 | Device:R | Resistor_SMD:R_0402_1005Metric | ~ |  |  | RK73Z1ETTP | 0.1 |  | https://www.digikey.com/product-detail/en/koa-speer-electronics-inc/RK73Z1ETTP/2019-RK73Z1ETTPCT-ND/9846740
 |  | R500 | 2.2k | Device:R | Resistor_SMD:R_0402_1005Metric | ~ |  |  | RK73H1ETTP2201F | 0.1 | 1% | https://www.digikey.com/product-detail/en/koa-speer-electronics-inc/RK73H1ETTP2201F/2019-RK73H1ETTP2201FCT-ND/9846130
 |  | R501 | 2.2k | Device:R | Resistor_SMD:R_0402_1005Metric | ~ |  |  | RK73Z1ETTP | 0.1 | 1% | https://www.digikey.com/product-detail/en/koa-speer-electronics-inc/RK73Z1ETTP/2019-RK73Z1ETTPCT-ND/9846740
 |  | R504 | 20K | Device:R | Resistor_SMD:R_0402_1005Metric | ~ |  |  | RK73H1ETTP2002F | 0.1 | 1% | https://www.digikey.com/product-detail/en/koa-speer-electronics-inc/RK73H1ETTP2002F/2019-RK73H1ETTP2002FCT-ND/9846206
 |  | R505 | 0 | Device:R | Resistor_SMD:R_0402_1005Metric | ~ |  |  | RK73Z1ETTP | 0.1 |  | https://www.digikey.com/product-detail/en/koa-speer-electronics-inc/RK73Z1ETTP/2019-RK73Z1ETTPCT-ND/9846740
 |  | R506 | 0 | Device:R | Resistor_SMD:R_0402_1005Metric | ~ |  |  | RK73Z1ETTP | 0.1 |  | https://www.digikey.com/product-detail/en/koa-speer-electronics-inc/RK73Z1ETTP/2019-RK73Z1ETTPCT-ND/9846740
 |  | R507 | 0 | Device:R | Resistor_SMD:R_0402_1005Metric | ~ |  |  | RK73Z1ETTP | 0.1 | 5% | https://www.digikey.com/product-detail/en/koa-speer-electronics-inc/RK73Z1ETTP/2019-RK73Z1ETTPCT-ND/9846740
 |  | R508 | 10k | Device:R | Resistor_SMD:R_0402_1005Metric | ~ |  |  | MCR01MZPJ103 | 0.1 |  | https://www.digikey.com/product-detail/en/rohm-semiconductor/MCR01MZPJ103/RHM10KJCT-ND/628226
 |  | R509 | 10k | Device:R | Resistor_SMD:R_0402_1005Metric | ~ |  |  | MCR01MZPJ103 | 0.1 |  | https://www.digikey.com/product-detail/en/rohm-semiconductor/MCR01MZPJ103/RHM10KJCT-ND/628226
 |  | R515 | 0 | Device:R | Resistor_SMD:R_0402_1005Metric | ~ |  |  | RK73Z1ETTP | 0.1 |  | https://www.digikey.com/product-detail/en/koa-speer-electronics-inc/RK73Z1ETTP/2019-RK73Z1ETTPCT-ND/9846740
 |  | R516 | 0 | Device:R | Resistor_SMD:R_0402_1005Metric | ~ |  |  | RK73Z1ETTP | 0.1 |  | https://www.digikey.com/product-detail/en/koa-speer-electronics-inc/RK73Z1ETTP/2019-RK73Z1ETTPCT-ND/9846740
 |  | R520 | 10k | Device:R | Resistor_SMD:R_0402_1005Metric | ~ | DNI |  | MCR01MZPJ103 | 0.1 |  | https://www.digikey.com/product-detail/en/rohm-semiconductor/MCR01MZPJ103/RHM10KJCT-ND/628226
 |  | R600 | 33 | Device:R | Resistor_SMD:R_0402_1005Metric | ~ |  |  | RK73B1ETTP330J | 0.1 | 5% | https://www.digikey.com/product-detail/en/koa-speer-electronics-inc/RK73B1ETTP330J/2019-RK73B1ETTP330JCT-ND/9846009
 |  | R601 | 47k | Device:R | Resistor_SMD:R_0402_1005Metric | ~ |  |  | MCR01MZPJ473 | 0.1 |  | https://www.digikey.com/product-detail/en/rohm-semiconductor/MCR01MZPJ473/RHM47KJCT-ND/628298
 |  | R602 | 47k | Device:R | Resistor_SMD:R_0402_1005Metric | ~ |  |  | MCR01MZPJ473 | 0.1 |  | https://www.digikey.com/product-detail/en/rohm-semiconductor/MCR01MZPJ473/RHM47KJCT-ND/628298
 |  | R603 | 47k | Device:R | Resistor_SMD:R_0402_1005Metric | ~ |  |  | MCR01MZPJ473 | 0.1 |  | https://www.digikey.com/product-detail/en/rohm-semiconductor/MCR01MZPJ473/RHM47KJCT-ND/628298
 |  | R604 | 15k | Device:R | Resistor_SMD:R_0402_1005Metric | ~ |  |  | RK73B1ETTP153J | 0.1 |  | https://www.digikey.com/product-detail/en/koa-speer-electronics-inc/RK73B1ETTP153J/2019-RK73B1ETTP153JCT-ND/9846037
 |  | R606 | 47k | Device:R | Resistor_SMD:R_0402_1005Metric | ~ |  |  | MCR01MZPJ473 | 0.1 |  | https://www.digikey.com/product-detail/en/rohm-semiconductor/MCR01MZPJ473/RHM47KJCT-ND/628298
 |  | R607 | 47k | Device:R | Resistor_SMD:R_0402_1005Metric | ~ |  |  | MCR01MZPJ473 | 0.1 |  | https://www.digikey.com/product-detail/en/rohm-semiconductor/MCR01MZPJ473/RHM47KJCT-ND/628298
 |  | R610 | 0 | Device:R | Resistor_SMD:R_0402_1005Metric | ~ | DNI |  | RK73Z1ETTP | 0.1 |  | https://www.digikey.com/product-detail/en/koa-speer-electronics-inc/RK73Z1ETTP/2019-RK73Z1ETTPCT-ND/9846740
 |  | R611 | 0 | Device:R | Resistor_SMD:R_0402_1005Metric | ~ |  |  | RK73Z1ETTP | 0.1 |  | https://www.digikey.com/product-detail/en/koa-speer-electronics-inc/RK73Z1ETTP/2019-RK73Z1ETTPCT-ND/9846740
 |  | R612 | 0 | Device:R | Resistor_SMD:R_0402_1005Metric | ~ |  |  | RK73Z1ETTP | 0.1 |  | https://www.digikey.com/product-detail/en/koa-speer-electronics-inc/RK73Z1ETTP/2019-RK73Z1ETTPCT-ND/9846740
 |  | R632 | 100k | Device:R | Resistor_SMD:R_0402_1005Metric | ~ |  |  | MCR01MZPF1003 | 0.1 | 1% | https://www.digikey.com/product-detail/en/rohm-semiconductor/MCR01MZPF1003/RHM100KLCT-ND/628066
 |  | R645 | 0 | Device:R | Resistor_SMD:R_0402_1005Metric | ~ |  |  | RK73Z1ETTP | 0.1 |  | https://www.digikey.com/product-detail/en/koa-speer-electronics-inc/RK73Z1ETTP/2019-RK73Z1ETTPCT-ND/9846740
 |  | R671 | 10k | Device:R | Resistor_SMD:R_0402_1005Metric | ~ | DNI |  | MCR01MZPJ103 | 0.1 | 5% | https://www.digikey.com/product-detail/en/rohm-semiconductor/MCR01MZPJ103/RHM10KJCT-ND/628226
 |  | R672 | 10k | Device:R | Resistor_SMD:R_0402_1005Metric | ~ |  |  | MCR01MZPJ103 | 0.1 | 5% | https://www.digikey.com/product-detail/en/rohm-semiconductor/MCR01MZPJ103/RHM10KJCT-ND/628226
 |  | R692 | 10k | Device:R | Resistor_SMD:R_0402_1005Metric | ~ |  |  | MCR01MZPJ103 | 0.1 | 5% | https://www.digikey.com/product-detail/en/rohm-semiconductor/MCR01MZPJ103/RHM10KJCT-ND/628226
 |  | R700 | 10k | Device:R | Resistor_SMD:R_0402_1005Metric | ~ |  |  | MCR01MZPF1002 | 0.1 | 1% | https://www.digikey.com/product-detail/en/rohm-semiconductor/MCR01MZPF1002/RHM10.0KLCT-ND/628065
 |  | R701 | 10k | Device:R | Resistor_SMD:R_0402_1005Metric | ~ |  |  | MCR01MZPF1002 | 0.1 | 1% | https://www.digikey.com/product-detail/en/rohm-semiconductor/MCR01MZPF1002/RHM10.0KLCT-ND/628065
 |  | R702 | 10k | Device:R | Resistor_SMD:R_0402_1005Metric | ~ |  |  | MCR01MZPF1002 | 0.1 | 1% | https://www.digikey.com/product-detail/en/rohm-semiconductor/MCR01MZPF1002/RHM10.0KLCT-ND/628065
 |  | R703 | 10k | Device:R | Resistor_SMD:R_0402_1005Metric | ~ | DNI |  | MCR01MZPF1002 | 0.1 | 1% | https://www.digikey.com/product-detail/en/rohm-semiconductor/MCR01MZPF1002/RHM10.0KLCT-ND/628065
 |  | R704 | 10k | Device:R | Resistor_SMD:R_0402_1005Metric | ~ | DNI |  | MCR01MZPF1002 | 0.1 | 1% | https://www.digikey.com/product-detail/en/rohm-semiconductor/MCR01MZPF1002/RHM10.0KLCT-ND/628065
 |  | R705 | 10k | Device:R | Resistor_SMD:R_0402_1005Metric | ~ |  |  | MCR01MZPF1002 | 0.1 | 1% | https://www.digikey.com/product-detail/en/rohm-semiconductor/MCR01MZPF1002/RHM10.0KLCT-ND/628065
 |  | R706 | 10k | Device:R | Resistor_SMD:R_0402_1005Metric | ~ |  |  | MCR01MZPF1002 | 0.1 | 1% | https://www.digikey.com/product-detail/en/rohm-semiconductor/MCR01MZPF1002/RHM10.0KLCT-ND/628065
 |  | R708 | 10k | Device:R | Resistor_SMD:R_0402_1005Metric | ~ |  |  | MCR01MZPF1002 | 0.1 | 1% | https://www.digikey.com/product-detail/en/rohm-semiconductor/MCR01MZPF1002/RHM10.0KLCT-ND/628065
 |  | R710 | 12k | Device:R | Resistor_SMD:R_0402_1005Metric | ~ |  |  | RK73H1ETTP1202F | 0.1 | 1% | https://www.digikey.com/product-detail/en/koa-speer-electronics-inc/RK73H1ETTP1202F/2019-RK73H1ETTP1202FCT-ND/9846150
 |  | R712 | 10k | Device:R | Resistor_SMD:R_0402_1005Metric | ~ | DNI |  | MCR01MZPF1002 | 0.1 | 1% | https://www.digikey.com/product-detail/en/rohm-semiconductor/MCR01MZPF1002/RHM10.0KLCT-ND/628065
 |  | R713 | 10k | Device:R | Resistor_SMD:R_0402_1005Metric | ~ | DNI |  | MCR01MZPF1002 | 0.1 | 1% | https://www.digikey.com/product-detail/en/rohm-semiconductor/MCR01MZPF1002/RHM10.0KLCT-ND/628065
 |  | R714 | 10k | Device:R | Resistor_SMD:R_0402_1005Metric | ~ |  |  | MCR01MZPF1002 | 0.1 | 1% | https://www.digikey.com/product-detail/en/rohm-semiconductor/MCR01MZPF1002/RHM10.0KLCT-ND/628065
 |  | R715 | 10k | Device:R | Resistor_SMD:R_0402_1005Metric | ~ | DNI |  | MCR01MZPF1002 | 0.1 | 1% | https://www.digikey.com/product-detail/en/rohm-semiconductor/MCR01MZPF1002/RHM10.0KLCT-ND/628065
 |  | R716 | 10k | Device:R | Resistor_SMD:R_0402_1005Metric | ~ |  |  | MCR01MZPF1002 | 0.1 | 1% | https://www.digikey.com/product-detail/en/rohm-semiconductor/MCR01MZPF1002/RHM10.0KLCT-ND/628065
 |  | R717 | 10k | Device:R | Resistor_SMD:R_0402_1005Metric | ~ |  |  | MCR01MZPF1002 | 0.1 | 1% | https://www.digikey.com/product-detail/en/rohm-semiconductor/MCR01MZPF1002/RHM10.0KLCT-ND/628065
 |  | R718 | 10k | Device:R | Resistor_SMD:R_0402_1005Metric | ~ | DNI |  | MCR01MZPF1002 | 0.1 | 1% | https://www.digikey.com/product-detail/en/rohm-semiconductor/MCR01MZPF1002/RHM10.0KLCT-ND/628065
 |  | R722 | 10k | Device:R | Resistor_SMD:R_0402_1005Metric | ~ | DNI |  | MCR01MZPF1002 | 0.1 | 1% | https://www.digikey.com/product-detail/en/rohm-semiconductor/MCR01MZPF1002/RHM10.0KLCT-ND/628065
 |  | R723 | 10K | Device:R | Resistor_SMD:R_0402_1005Metric | ~ |  |  | MCR01MZPF1002 | 0.1 | 1% | https://www.digikey.com/product-detail/en/rohm-semiconductor/MCR01MZPF1002/RHM10.0KLCT-ND/628065
 |  | R724 | 10k | Device:R | Resistor_SMD:R_0402_1005Metric | ~ |  |  | MCR01MZPF1002 | 0.1 |  | https://www.digikey.com/product-detail/en/rohm-semiconductor/MCR01MZPF1002/RHM10.0KLCT-ND/628065
 |  | R725 | 0 | Device:R | Resistor_SMD:R_0402_1005Metric | ~ |  |  | RK73Z1ETTP | 0.1 |  | https://www.digikey.com/product-detail/en/koa-speer-electronics-inc/RK73Z1ETTP/2019-RK73Z1ETTPCT-ND/9846740
 |  | R726 | 10k | Device:R | Resistor_SMD:R_0402_1005Metric | ~ | DNI |  | MCR01MZPF1002 | 0.1 |  | https://www.digikey.com/product-detail/en/rohm-semiconductor/MCR01MZPF1002/RHM10.0KLCT-ND/628065
 |  | R727 | 10k | Device:R | Resistor_SMD:R_0402_1005Metric | ~ | DNI |  | MCR01MZPF1002 | 0.1 |  | https://www.digikey.com/product-detail/en/rohm-semiconductor/MCR01MZPF1002/RHM10.0KLCT-ND/628065
 |  | R731 | 10k | Device:R | Resistor_SMD:R_0402_1005Metric | ~ | DNI |  | MCR01MZPF1002 | 0.1 |  | https://www.digikey.com/product-detail/en/rohm-semiconductor/MCR01MZPF1002/RHM10.0KLCT-ND/628065
 |  | R732 | 0 | Device:R_Small | Resistor_SMD:R_0402_1005Metric | ~ |  |  | RK73Z1ETTP | 0.1 |  | https://www.digikey.com/product-detail/en/koa-speer-electronics-inc/RK73Z1ETTP/2019-RK73Z1ETTPCT-ND/9846740
 |  | R733 | 0 | Device:R_Small | Resistor_SMD:R_0402_1005Metric | ~ |  |  | RK73Z1ETTP | 0.1 |  | https://www.digikey.com/product-detail/en/koa-speer-electronics-inc/RK73Z1ETTP/2019-RK73Z1ETTPCT-ND/9846740
 |  | R735 | 10K | Device:R | Resistor_SMD:R_0402_1005Metric | ~ |  |  | MCR01MZPF1002 | 0.1 |  | https://www.digikey.com/product-detail/en/rohm-semiconductor/MCR01MZPF1002/RHM10.0KLCT-ND/628065
 |  | R736 | 0 | Device:R_Small | Resistor_SMD:R_0402_1005Metric | ~ |  |  | RK73Z1ETTP | 0.1 |  | https://www.digikey.com/product-detail/en/koa-speer-electronics-inc/RK73Z1ETTP/2019-RK73Z1ETTPCT-ND/9846740
 |  | R737 | 0 | Device:R_Small | Resistor_SMD:R_0402_1005Metric | ~ |  |  | RK73Z1ETTP | 0.1 |  | https://www.digikey.com/product-detail/en/koa-speer-electronics-inc/RK73Z1ETTP/2019-RK73Z1ETTPCT-ND/9846740
 |  | R739 | 0 | Device:R | Resistor_SMD:R_0402_1005Metric | ~ |  |  | RK73Z1ETTP | 0.1 |  | https://www.digikey.com/product-detail/en/koa-speer-electronics-inc/RK73Z1ETTP/2019-RK73Z1ETTPCT-ND/9846740
 |  | R740 | 10k | Device:R | Resistor_SMD:R_0402_1005Metric | ~ | DNI |  | RK73Z1ETTP | 0.1 |  | https://www.digikey.com/product-detail/en/koa-speer-electronics-inc/RK73Z1ETTP/2019-RK73Z1ETTPCT-ND/9846740
 |  | R744 | 10k | Device:R | Resistor_SMD:R_0402_1005Metric | ~ | DNI |  | MCR01MZPF1002 | 0.1 | 1% | https://www.digikey.com/product-detail/en/rohm-semiconductor/MCR01MZPF1002/RHM10.0KLCT-ND/628065
 |  | R753 | 0 | Device:R | Resistor_SMD:R_0402_1005Metric | ~ |  |  | RK73Z1ETTP | 0.1 | 1% | https://www.digikey.com/product-detail/en/koa-speer-electronics-inc/RK73Z1ETTP/2019-RK73Z1ETTPCT-ND/9846740
 |  | R754 | 0 | Device:R | Resistor_SMD:R_0402_1005Metric | ~ | DNI |  | RK73Z1ETTP | 0.1 | 1% | https://www.digikey.com/product-detail/en/koa-speer-electronics-inc/RK73Z1ETTP/2019-RK73Z1ETTPCT-ND/9846740
 |  | R755 | 0 | Device:R | Resistor_SMD:R_0402_1005Metric | ~ |  |  | RK73Z1ETTP | 0.1 | 1% | https://www.digikey.com/product-detail/en/koa-speer-electronics-inc/RK73Z1ETTP/2019-RK73Z1ETTPCT-ND/9846740
 |  | R777 | 10k | Device:R | Resistor_SMD:R_0402_1005Metric | ~ | DNI |  | ERA-2AEB103X | 0.45 | 1% | https://www.digikey.com/product-detail/en/panasonic-electronic-components/ERA-2AEB103X/P10KDCCT-ND/1706207
 |  | R778 | 0 | Device:R | Resistor_SMD:R_0402_1005Metric | ~ |  |  | RK73Z1ETTP | 0.1 |  | https://www.digikey.com/product-detail/en/koa-speer-electronics-inc/RK73Z1ETTP/2019-RK73Z1ETTPCT-ND/9846740
 |  | R781 | 10k | Device:R | Resistor_SMD:R_0402_1005Metric | ~ | DNI |  | MCR01MZPF1002 | 0.1 |  | https://www.digikey.com/product-detail/en/rohm-semiconductor/MCR01MZPF1002/RHM10.0KLCT-ND/628065
 |  | R782 | 0 | Device:R | Resistor_SMD:R_0402_1005Metric | ~ | DNI |  | RK73Z1ETTP | 0.1 |  | https://www.digikey.com/product-detail/en/koa-speer-electronics-inc/RK73Z1ETTP/2019-RK73Z1ETTPCT-ND/9846740
 |  | R785 | 0 | Device:R | Resistor_SMD:R_0402_1005Metric | ~ |  |  | RK73Z1ETTP | 0.1 | 1% | https://www.digikey.com/product-detail/en/koa-speer-electronics-inc/RK73Z1ETTP/2019-RK73Z1ETTPCT-ND/9846740
 |  | R786 | 0 | Device:R | Resistor_SMD:R_0402_1005Metric | ~ |  |  | RK73Z1ETTP | 0.1 | 1% | https://www.digikey.com/product-detail/en/koa-speer-electronics-inc/RK73Z1ETTP/2019-RK73Z1ETTPCT-ND/9846740
 |  | R793 | 0 | Device:R_Small | Resistor_SMD:R_0402_1005Metric | ~ |  |  | RK73Z1ETTP | 0.1 |  | https://www.digikey.com/product-detail/en/koa-speer-electronics-inc/RK73Z1ETTP/2019-RK73Z1ETTPCT-ND/9846740
 |  | R794 | 0 | Device:R_Small | Resistor_SMD:R_0402_1005Metric | ~ |  |  | RK73Z1ETTP | 0.1 |  | https://www.digikey.com/product-detail/en/koa-speer-electronics-inc/RK73Z1ETTP/2019-RK73Z1ETTPCT-ND/9846740
 |  | R795 | 0 | Device:R_Small | Resistor_SMD:R_0402_1005Metric | ~ |  |  | RK73Z1ETTP | 0.1 |  | https://www.digikey.com/product-detail/en/koa-speer-electronics-inc/RK73Z1ETTP/2019-RK73Z1ETTPCT-ND/9846740
 |  | R796 | 0 | Device:R_Small | Resistor_SMD:R_0402_1005Metric | ~ |  |  | RK73Z1ETTP | 0.1 |  | https://www.digikey.com/product-detail/en/koa-speer-electronics-inc/RK73Z1ETTP/2019-RK73Z1ETTPCT-ND/9846740
 |  | R798 | 0 | Device:R | Resistor_SMD:R_0402_1005Metric | ~ | DNI |  | RK73Z1ETTP | 0.1 |  | https://www.digikey.com/product-detail/en/koa-speer-electronics-inc/RK73Z1ETTP/2019-RK73Z1ETTPCT-ND/9846740
 |  | R802 | 10k | Device:R | Resistor_SMD:R_0402_1005Metric | ~ |  |  | MCR01MZPF1002 | 0.1 | 1% | https://www.digikey.com/product-detail/en/rohm-semiconductor/MCR01MZPF1002/RHM10.0KLCT-ND/628065
 |  | R803 | 10k | Device:R | Resistor_SMD:R_0402_1005Metric | ~ |  |  | MCR01MZPF1002 | 0.1 | 1% | https://www.digikey.com/product-detail/en/rohm-semiconductor/MCR01MZPF1002/RHM10.0KLCT-ND/628065
 |  | R804 | 10k | Device:R | Resistor_SMD:R_0402_1005Metric | ~ | DNI |  | MCR01MZPF1002 | 0.1 | 1% | https://www.digikey.com/product-detail/en/rohm-semiconductor/MCR01MZPF1002/RHM10.0KLCT-ND/628065
 |  | R805 | 10k | Device:R | Resistor_SMD:R_0402_1005Metric | ~ | DNI |  | MCR01MZPF1002 | 0.1 | 1% | https://www.digikey.com/product-detail/en/rohm-semiconductor/MCR01MZPF1002/RHM10.0KLCT-ND/628065
 |  | R806 | 10k | Device:R | Resistor_SMD:R_0402_1005Metric | ~ |  |  | MCR01MZPF1002 | 0.1 |  | https://www.digikey.com/product-detail/en/rohm-semiconductor/MCR01MZPF1002/RHM10.0KLCT-ND/628065
 |  | R807 | 10k | Device:R | Resistor_SMD:R_0402_1005Metric | ~ | DNI |  | MCR01MZPF1002 | 0.1 | 1% | https://www.digikey.com/product-detail/en/rohm-semiconductor/MCR01MZPF1002/RHM10.0KLCT-ND/628065
 |  | R808 | 10k | Device:R | Resistor_SMD:R_0402_1005Metric | ~ | DNI |  | MCR01MZPF1002 | 0.1 | 1% | https://www.digikey.com/product-detail/en/rohm-semiconductor/MCR01MZPF1002/RHM10.0KLCT-ND/628065
 |  | R809 | 10k | Device:R | Resistor_SMD:R_0402_1005Metric | ~ | DNI |  | MCR01MZPF1002 | 0.1 | 1% | https://www.digikey.com/product-detail/en/rohm-semiconductor/MCR01MZPF1002/RHM10.0KLCT-ND/628065
 |  | R810 | 10k | Device:R | Resistor_SMD:R_0402_1005Metric | ~ | DNI |  | RK73B1ETTP301J | 0.1 | 1% | https://www.digikey.com/product-detail/en/koa-speer-electronics-inc/RK73B1ETTP301J/2019-RK73B1ETTP301JCT-ND/9846047
 |  | R811 | 10k | Device:R | Resistor_SMD:R_0402_1005Metric | ~ | DNI |  | MCR01MZPJ473 | 0.1 | 1% | https://www.digikey.com/product-detail/en/rohm-semiconductor/MCR01MZPJ473/RHM47KJCT-ND/628298
 |  | R812 | 10k | Device:R | Resistor_SMD:R_0402_1005Metric | ~ | DNI |  | MCR01MZPF1002 | 0.1 | 1% | https://www.digikey.com/product-detail/en/rohm-semiconductor/MCR01MZPF1002/RHM10.0KLCT-ND/628065
 |  | R813 | 15k | Device:R | Resistor_SMD:R_0402_1005Metric | ~ | DNI |  | RK73H1ETTP1502F | 0.1 |  | https://www.digikey.com/product-detail/en/koa-speer-electronics-inc/RK73H1ETTP1502F/2019-RK73H1ETTP1502FCT-ND/9846208
 |  | R814 | 150 | Device:R | Resistor_SMD:R_0402_1005Metric | ~ |  | 3.5A | RK73H1ETTP1500F | 0.1 | 1% | https://www.digikey.com/product-detail/en/koa-speer-electronics-inc/RK73H1ETTP1500F/2019-RK73H1ETTP1500FCT-ND/9846134
 |  | R815 | 30.1k | Device:R | Resistor_SMD:R_0402_1005Metric | ~ |  |  | MCR01MZPF3012 | 0.1 | 1% | https://www.digikey.com/product-detail/en/rohm-semiconductor/MCR01MZPF3012/RHM30.1KLCT-ND/628134
 |  | R816 | 5.23k | Device:R | Resistor_SMD:R_0402_1005Metric | ~ |  |  | RK73H1ETTP5231F | 0.1 | 1% | https://www.digikey.com/product-detail/en/koa-speer-electronics-inc/RK73H1ETTP5231F/2019-RK73H1ETTP5231FCT-ND/9846467
 |  | R820 | 0 | Device:R | Resistor_SMD:R_0603_1608Metric | ~ |  |  | MCR03EZPJ000 | 0.1 |  | https://www.digikey.com/product-detail/en/koa-speer-electronics-inc/RK73Z1JTTD/2019-RK73Z1JTTDCT-ND/9847522
 |  | R822 | R | Device:R | Resistor_SMD:R_0402_1005Metric | ~ |  |  | RK73B1ETTP821J | 0.1 |  | https://www.digikey.com/product-detail/en/koa-speer-electronics-inc/RK73B1ETTP821J/2019-RK73B1ETTP821JCT-ND/9846073
 |  | R825 | 0 | Device:R | Resistor_SMD:R_0402_1005Metric | ~ | DNI |  | RK73Z1ETTP | 0.1 |  | https://www.digikey.com/product-detail/en/koa-speer-electronics-inc/RK73Z1ETTP/2019-RK73Z1ETTPCT-ND/9846740
 |  | R826 | 0 | Device:R | Resistor_SMD:R_0603_1608Metric | ~ | DNI |  | MCR03EZPJ000 | 0.1 |  | https://www.digikey.com/product-detail/en/koa-speer-electronics-inc/RK73Z1JTTD/2019-RK73Z1JTTDCT-ND/9847522
 |  | R827 | 0 | Device:R | Resistor_SMD:R_0603_1608Metric | ~ |  |  | MCR03EZPJ000 | 0.1 | 0% | https://www.digikey.com/product-detail/en/koa-speer-electronics-inc/RK73Z1JTTD/2019-RK73Z1JTTDCT-ND/9847522
 |  | R828 | 68m | Device:R | Resistor_SMD:R_0805_2012Metric | ~ |  |  | MCR10EZHFSR068 | 0.71 | 1% | https://www.digikey.com/product-detail/en/rohm-semiconductor/MCR10EZHFSR068/RHM.068NCT-ND/1853062
 |  | R900 | 33k | Device:R | Resistor_SMD:R_0402_1005Metric | ~ |  |  | RK73H1ETTP3302F | 0.1 | 1% | https://www.digikey.com/product-detail/en/koa-speer-electronics-inc/RK73H1ETTP3302F/2019-RK73H1ETTP3302FCT-ND/9846158
 |  | R901 | R | Device:R | Resistor_SMD:R_0402_1005Metric | ~ | DNI |  | MCR01MZPJ513 | 0.1 | 1% | https://www.digikey.com/product-detail/en/koa-speer-electronics-inc/RK73B1ETTP513J/2019-RK73B1ETTP513JCT-ND/9846043
 |  | R902 | 0 | Device:R | Resistor_SMD:R_0402_1005Metric | ~ |  |  | RK73Z1ETTP | 0.1 | 0% | https://www.digikey.com/product-detail/en/koa-speer-electronics-inc/RK73Z1ETTP/2019-RK73Z1ETTPCT-ND/9846740
 |  | R903 | 0 | Device:R | Resistor_SMD:R_0402_1005Metric | ~ |  |  | RK73Z1ETTP | 0.1 | 0% | https://www.digikey.com/product-detail/en/koa-speer-electronics-inc/RK73Z1ETTP/2019-RK73Z1ETTPCT-ND/9846740
 |  | R904 | 10k | Device:R | Resistor_SMD:R_0402_1005Metric | ~ |  |  | MCR01MZPJ103 | 0.1 | 5% | https://www.digikey.com/product-detail/en/rohm-semiconductor/MCR01MZPJ103/RHM10KJCT-ND/628226
 |  | R905 | 220k | Device:R | Resistor_SMD:R_0402_1005Metric | ~ |  |  | RK73H1ETTP2203F | 0.1 | 1% | https://www.digikey.com/product-detail/en/koa-speer-electronics-inc/RK73H1ETTP2203F/2019-RK73H1ETTP2203FCT-ND/9846279
 |  | R906 | 33k | Device:R | Resistor_SMD:R_0402_1005Metric | ~ |  |  | RK73H1ETTP3302F | 0.1 | 1% | https://www.digikey.com/product-detail/en/koa-speer-electronics-inc/RK73H1ETTP3302F/2019-RK73H1ETTP3302FCT-ND/9846158
 |  | R910 | 820k | Device:R | Resistor_SMD:R_0402_1005Metric | ~ |  |  | RK73H1ETTP8203F | 0.1 | 1% | https://www.digikey.com/product-detail/en/koa-speer-electronics-inc/RK73H1ETTP8203F/2019-RK73H1ETTP8203FCT-ND/9846495
 |  | R911 | 360k | Device:R | Resistor_SMD:R_0402_1005Metric | ~ |  |  | RK73H1ETTP3603F | 0.1 | 1% | https://www.digikey.com/product-detail/en/koa-speer-electronics-inc/RK73H1ETTP3603F/2019-RK73H1ETTP3603FCT-ND/9846560
 |  | R912 | 180k | Device:R | Resistor_SMD:R_0402_1005Metric | ~ |  |  | MCR01MZPF1803 | 0.02 | 1% | https://www.digikey.com/products/en?keywords=MCR01MZPF1803
 |  | R913 | 180k | Device:R | Resistor_SMD:R_0402_1005Metric | ~ |  |  | MCR01MZPF1803 | 0.02 | 1% | https://www.digikey.com/products/en?keywords=MCR01MZPF1803
 |  | R940 | 0 | Device:R | Resistor_SMD:R_0402_1005Metric | ~ | DNI |  | RK73Z1ETTP | 0.1 |  | https://www.digikey.com/product-detail/en/koa-speer-electronics-inc/RK73Z1ETTP/2019-RK73Z1ETTPCT-ND/9846740
 |  | R970 | 0 | Device:R | Resistor_SMD:R_0402_1005Metric | ~ | DNI |  | RK73Z1ETTP | 0.1 |  | https://www.digikey.com/product-detail/en/koa-speer-electronics-inc/RK73Z1ETTP/2019-RK73Z1ETTPCT-ND/9846740
 |  | R1000 | 10k | Device:R | Resistor_SMD:R_0402_1005Metric | ~ | DNI |  | MCR01MZPJ103 | 0.1 | 5% | https://www.digikey.com/product-detail/en/rohm-semiconductor/MCR01MZPJ103/RHM10KJCT-ND/628226
 |  | R1001 | 10k | Device:R | Resistor_SMD:R_0402_1005Metric | ~ | DNI |  | MCR01MZPJ103 | 0.1 | 5% | https://www.digikey.com/product-detail/en/rohm-semiconductor/MCR01MZPJ103/RHM10KJCT-ND/628226
 |  | R1002 | 10k | Device:R | Resistor_SMD:R_0402_1005Metric | ~ |  |  | MCR01MZPJ103 | 0.1 | 5% | https://www.digikey.com/product-detail/en/rohm-semiconductor/MCR01MZPJ103/RHM10KJCT-ND/628226
 |  | R1003 | 10k | Device:R | Resistor_SMD:R_0402_1005Metric | ~ |  |  | MCR01MZPJ103 | 0.1 | 5% | https://www.digikey.com/product-detail/en/rohm-semiconductor/MCR01MZPJ103/RHM10KJCT-ND/628226
 |  | R1004 | 10k | Device:R | Resistor_SMD:R_0402_1005Metric | ~ |  |  | MCR01MZPJ103 | 0.1 | 5% | https://www.digikey.com/product-detail/en/rohm-semiconductor/MCR01MZPJ103/RHM10KJCT-ND/628226
 |  | R1005 | 10k | Device:R | Resistor_SMD:R_0402_1005Metric | ~ |  |  | MCR01MZPJ103 | 0.1 | 5% | https://www.digikey.com/product-detail/en/rohm-semiconductor/MCR01MZPJ103/RHM10KJCT-ND/628226
 |  | R1006 | 0 | Device:R | Resistor_SMD:R_0603_1608Metric | ~ |  |  | RK73Z1JTTD | 0.10 |  | https://www.digikey.com/product-detail/en/koa-speer-electronics-inc/RK73Z1JTTD/2019-RK73Z1JTTDCT-ND/9847522
 |  | R1007 | 36 | Device:R | Resistor_SMD:R_0402_1005Metric | ~ |  |  | RK73H1ETTP36R0F | 0.1 | 1% | https://www.digikey.com/product-detail/en/koa-speer-electronics-inc/RK73H1ETTP36R0F/2019-RK73H1ETTP36R0FCT-ND/9846584
 |  | R1030 | 10K | Device:R | Resistor_SMD:R_0402_1005Metric | ~ |  |  | MCR01MZPJ103 | 0.1 | 5% | https://www.digikey.com/product-detail/en/rohm-semiconductor/MCR01MZPJ103/RHM10KJCT-ND/628226
 |  | R1031 | 10K | Device:R | Resistor_SMD:R_0402_1005Metric | ~ |  |  | MCR01MZPJ103 | 0.1 | 1% | https://www.digikey.com/product-detail/en/rohm-semiconductor/MCR01MZPJ103/RHM10KJCT-ND/628226
 |  | R1032 | 10K | Device:R | Resistor_SMD:R_0402_1005Metric | ~ |  |  | MCR01MZPJ103 | 0.1 | 5% | https://www.digikey.com/product-detail/en/rohm-semiconductor/MCR01MZPJ103/RHM10KJCT-ND/628226
 |  | R1033 | 47k | Device:R | Resistor_SMD:R_0402_1005Metric | ~ |  |  | MCR01MZPJ473 | 0.1 |  | https://www.digikey.com/product-detail/en/rohm-semiconductor/MCR01MZPJ473/RHM47KJCT-ND/628298
 |  | R1034 | 47k | Device:R | Resistor_SMD:R_0402_1005Metric | ~ |  |  | MCR01MZPJ473 | 0.1 |  | https://www.digikey.com/product-detail/en/rohm-semiconductor/MCR01MZPJ473/RHM47KJCT-ND/628298
 |  | R1035 | 33 | Device:R | Resistor_SMD:R_0402_1005Metric | ~ |  |  | RK73B1ETTP330J | 0.1 |  | https://www.digikey.com/product-detail/en/koa-speer-electronics-inc/RK73B1ETTP330J/2019-RK73B1ETTP330JCT-ND/9846009
 |  | R1036 | 33 | Device:R | Resistor_SMD:R_0402_1005Metric | ~ |  |  | RK73B1ETTP330J | 0.1 |  | https://www.digikey.com/product-detail/en/koa-speer-electronics-inc/RK73B1ETTP330J/2019-RK73B1ETTP330JCT-ND/9846009
 |  | R1051 | 10k | Device:R | Resistor_SMD:R_0402_1005Metric | ~ |  |  | MCR01MZPJ103 | 0.1 | 5% | https://www.digikey.com/product-detail/en/rohm-semiconductor/MCR01MZPJ103/RHM10KJCT-ND/628226
 |  | R1068 | 0 | Device:R | Resistor_SMD:R_0402_1005Metric | ~ | DNI |  | RK73Z1ETTP | 0.1 |  | https://www.digikey.com/product-detail/en/koa-speer-electronics-inc/RK73Z1ETTP/2019-RK73Z1ETTPCT-ND/9846740
 |  | R1069 | 10K | Device:R | Resistor_SMD:R_0402_1005Metric | ~ | DNI |  | MCR01MZPJ103 | 0.1 | 5% | https://www.digikey.com/product-detail/en/rohm-semiconductor/MCR01MZPJ103/RHM10KJCT-ND/628226
 |  | R1071 | 10k | Device:R | Resistor_SMD:R_0201_0603Metric | ~ |  |  | RK73Z1HTTC | 0.1 | 0% | https://www.digikey.com/product-detail/en/koa-speer-electronics-inc/RK73Z1HTTC/2019-RK73Z1HTTCCT-ND/9845726
 |  | R1077 | 10k | Device:R | Resistor_SMD:R_0402_1005Metric | ~ |  |  | MCR01MZPJ103 | 0.1 | 5% | https://www.digikey.com/product-detail/en/rohm-semiconductor/MCR01MZPJ103/RHM10KJCT-ND/628226
 |  | R1078 | 0 | Device:R | Resistor_SMD:R_0402_1005Metric | ~ | DNI |  | RK73Z1ETTP | 0.1 |  | https://www.digikey.com/product-detail/en/koa-speer-electronics-inc/RK73Z1ETTP/2019-RK73Z1ETTPCT-ND/9846740
 |  | R1079 | 10k | Device:R | Resistor_SMD:R_0402_1005Metric | ~ |  |  | MCR01MZPJ103 | 0.1 | 5% | https://www.digikey.com/product-detail/en/rohm-semiconductor/MCR01MZPJ103/RHM10KJCT-ND/628226
 |  | R1087 | 10k | Device:R | Resistor_SMD:R_0201_0603Metric | ~ |  |  | RK73Z1HTTC | 0.1 | 0% | https://www.digikey.com/product-detail/en/koa-speer-electronics-inc/RK73Z1HTTC/2019-RK73Z1HTTCCT-ND/9845726
 |  | R1091 | 0 | Device:R | Resistor_SMD:R_0402_1005Metric | ~ |  |  | RK73Z1ETTP | 0.1 |  | https://www.digikey.com/product-detail/en/koa-speer-electronics-inc/RK73Z1ETTP/2019-RK73Z1ETTPCT-ND/9846740
 |  | R1092 | 0 | Device:R | Resistor_SMD:R_0402_1005Metric | ~ | DNI |  | RK73Z1ETTP | 0.1 |  | https://www.digikey.com/product-detail/en/koa-speer-electronics-inc/RK73Z1ETTP/2019-RK73Z1ETTPCT-ND/9846740
 |  | R1098 | 2.7p | Device:C | Resistor_SMD:R_0201_0603Metric | ~ |  |  | RK73Z1HTTC | 0.1 |  | https://www.digikey.com/product-detail/en/koa-speer-electronics-inc/RK73Z1HTTC/2019-RK73Z1HTTCCT-ND/9845726
 |  | SW200 | PTS810 | MangOH-Red:PTS810 | Button_Switch_SMD:SW_SPST_PTS810 |  |  |  | PTS810 SJK 250 SMTR LFS | 0.31 |  | https://www.digikey.com/product-detail/en/c-k/PTS810-SJK-250-SMTR-LFS/CKN10503CT-ND/4176675
 |  | SW400 | SKTDLDE010 | MangOH-Red-Extra:SKTDLDE010 | Button_Switch_SMD:SW_SPST_EVQP7A |  |  |  | SKTDLDE010 | 0.44 |  | https://www.mouser.com/ProductDetail/ALPS/SKTDLDE010
 |  | SW401 | Conn_02x08_Counter_Clockwise | Connector_Generic:Conn_02x08_Counter_Clockwise | MangOH-Red:SW_16P_1128x0620_0127CC_DIP_SPST | ~ |  |  | 1-1571983-1 | 2.33 |  | https://www.digikey.com/product-detail/en/te-connectivity-alcoswitch-switches/1-1571983-1/450-1761-1-ND/1202093
 |  | SW402 | SKTDLDE010 | MangOH-Red-Extra:SKTDLDE010 | Button_Switch_SMD:SW_SPST_EVQP7A |  |  |  | SKTDLDE010 | 0.44 |  | https://www.mouser.com/ProductDetail/ALPS/SKTDLDE010
 |  | U1 | WP_SNAP_IN_SOCKET_COVER | MangOH-Red:WP_SNAP_IN_SOCKET_COVER |  |  |  |  | WP SNAP-IN COVER_6000637 | 1.57 |  | https://www.digikey.com/product-detail/en/sierra-wireless/WP-SNAP-IN-COVER_6000637/1645-1027-ND/6565780
 |  | U2 | WP_SNAP_IN_IC | MangOH-Red:WP_SNAP_IN_IC |  |  |  |  | WP7702-G_1103530 | 47.07 |  | https://www.digikey.com/product-detail/en/sierra-wireless/WP7702-G_1103530/1645-1091-1-ND/8572923
 |  | U301 | FT230XQ-R | MangOH-Red:FT230XQ-R | MangOH-Red:QFN_16P_0400x0400_SLUG_0210x0210_0065CC |  |  |  | FT230XQ-R | 2.04 |  | https://www.digikey.com/product-detail/en/ftdi-future-technology-devices-international-ltd/FT230XQ-R/768-1130-1-ND/3029158
 |  | U302 | TS3A5018RSVR | MangOH-Red:TS3A5018RSVR | MangOH-Red:QFN_16P_0260x0180_0040CC | ./datasheet/TS3A5018RSVR.pdf |  |  | TS3A5018RSVR | 0.81 |  | https://www.digikey.com/product-detail/en/texas-instruments/TS3A5018RSVR/296-27552-1-ND/2331611
 |  | U304 | 74LVC2G126HD4-7 | MangOH-Red:74LVC2G126HD4-7 | MangOH-Red:DFN_8P_0200x0100_0050CC | ./datasheet/74LVC2G126HD4-7.pdf |  |  | 74LVC2G126HD4-7 | 0.47 |  | https://www.digikey.com/product-detail/en/diodes-incorporated/74LVC2G126HD4-7/74LVC2G126HD4-7DICT-ND/6136347
 |  | U306 | FXMA108BQX | MangOH-Red:FXMA108BQX | MangOH-Red:QFN_20P_0250x0450_SLUG_0115x0315_0050CC |  |  |  | FXMA108BQX | 1.43 |  | https://www.digikey.com/product-detail/en/on-semiconductor/FXMA108BQX/FXMA108BQXFSCT-ND/2287325
 |  | U307 | FXMA108BQX | MangOH-Red:FXMA108BQX | MangOH-Red:QFN_20P_0250x0450_SLUG_0115x0315_0050CC | ./datasheet/FXMA108BQX.pdf |  |  | FXMA108BQX | 1.43 |  | https://www.digikey.com/product-detail/en/on-semiconductor/FXMA108BQX/FXMA108BQXFSCT-ND/2287325
 |  | U337 | FXMA108BQX | MangOH-Red:FXMA108BQX | MangOH-Red:QFN_20P_0250x0450_SLUG_0115x0315_0050CC |  |  |  | FXMA108BQX | 1.43 |  | https://www.digikey.com/product-detail/en/on-semiconductor/FXMA108BQX/FXMA108BQXFSCT-ND/2287325
 |  | U400 | NCP303LSN30T1G | MangOH-Red:NCP303LSN30T1G | MangOH-Red:SOT23_5P_0300x0160_0095CC |  |  |  | NCP303LSN30T1G | 0.6 |  | https://www.digikey.com/product-detail/en/on-semiconductor/NCP303LSN30T1G/NCP303LSN30T1GOSCT-ND/1139958
 |  | U401 | 74AUP1G08GM | MangOH-Red:74AUP1G08GM | MangOH-Red:DFN_6P_0145x0100_0050CC |  |  |  | 74AUP1G08GM | 0.41 |  | https://www.digikey.com/product-detail/en/nexperia-usa-inc/74AUP1G08GM115/1727-3179-1-ND/1023342
 |  | U402 | 74AUP1G08GM | MangOH-Red:74AUP1G08GM | MangOH-Red:DFN_6P_0145x0100_0050CC |  |  |  | 74AUP1G08GM | 0.41 |  | https://www.digikey.com/product-detail/en/nexperia-usa-inc/74AUP1G08GM115/1727-3179-1-ND/1023342
 |  | U404 | TCA9546APWR | MangOH-Red:TCA9546APWR | MangOH-Red:TSSOP_16P_0500x0440_0065CC |  |  |  | TCA9546A | 1.38 |  | https://www.digikey.com/product-detail/en/texas-instruments/TCA9546APWR/296-40578-1-ND/5178455
 |  | U405 | 74AUP1G08GM | MangOH-Red:74AUP1G08GM | MangOH-Red:DFN_6P_0145x0100_0050CC |  |  |  | 74AUP1G08GM | 0.41 |  | https://www.digikey.com/product-detail/en/nexperia-usa-inc/74AUP1G08GM115/1727-3179-1-ND/1023342
 |  | U500 | WM8944BECS_R | MangOH-Red:WM8944BECS_R | MangOH-Red:BGA_25P_0241x0241_0050CC_0030PD | ./datasheet/WM8944BECS-R.pdf
 |  | U501 | TS3A5018RSVR | MangOH-Red:TS3A5018RSVR | MangOH-Red:QFN_16P_0260x0180_0040CC | ./datasheet/TS3A5018RSVR.pdf |  |  | TS3A5018RSVR | 0.81 |  | https://www.digikey.com/product-detail/en/texas-instruments/TS3A5018RSVR/296-27552-1-ND/2331611
 |  | U600 | XC6223H29B9R-G | MangOH-Red:XC6223H29B9R-G | MangOH-Red:DFN_4P_0100x0100_SLUG_ROTATED_45DEG_0042x0042_0065CC |  |  |  | XC6223H29B9R-G | 0.61 |  | https://www.mouser.com/ProductDetail/Torex-Semiconductor/XC6223H29B9R-G
 |  | U603 | ESIM | MangOH-Red:ESIM | MangOH-Red:DFN_8P_0500x0600_SLUG_0420x0340_0127CC_ESIM_MODULE_MFF2 | ./datasheet/ | DNI |  | G091909
 |  | U610 | TXS02612ZQSR | MangOH-Red:TXS02612ZQSR | MangOH-Red:BGA_24P_0300x0300_0050CC_0030PD |  |  |  | TXS02612ZQSR | 1.41 |  | https://www.digikey.com/product-detail/en/texas-instruments/TXS02612ZQSR/296-24808-1-ND/2092630
 |  | U701 | USB3503A-1-GL-TR | MangOH-Red:USB3503A-1-GL-TR | MangOH-Red:BGA_25P_0200x0200_0040CC_0030PD | ./datasheet/USB3503A-1-GL-TR.pdf |  |  | USB3503A-1-GL-TR | 2.55 |  | https://www.digikey.com/product-detail/en/microchip-technology/USB3503A-1-GL-TR/USB3503A-1-GL-TRCT-ND/4162523
 |  | U702 | MIC2026-1YM | MangOH-Red:MIC2026-1YM | MangOH-Red:SOIC_8P_0490x0390_0127CC |  |  |  | MIC2026-1YM | 1.03 |  | https://www.digikey.com/product-detail/en/microchip-technology/MIC2026-1YM/576-2137-ND/1027887
 |  | U704 | BMI160 | MangOH-Red:BMI160 | MangOH-Red:QFN_14P_0250x0300_0050CC |  |  |  | BMI160 | 5.39 |  | https://www.digikey.com/product-detail/en/bosch-sensortec/BMI160/828-1057-1-ND/6136308
 |  | U705 | BMP280 | MangOH-Red:BMP280 | MangOH-Red:DFN_8P_0250x0200_0065CC |  |  |  | BMP280 | 3.48 |  | https://www.digikey.com/product-detail/en/bosch-sensortec/BMP280/828-1064-1-ND/6136315
 |  | U706 | PNJ4K01F | MangOH-Red:PNJ4K01F | MangOH-Red:DFN_6P_0155x0150_0050CC |  |  |  | PNJ4K01F | - |  | https://www.mouser.com/ProductDetail/Panasonic/PNJ4K01F
 |  | U800 | BQ24296RGER | MangOH-Red:BQ24296RGER | MangOH-Red:QFN_24P_0400x0400_SLUG_0270x0270_0050CC |  |  |  | BQ24296RGER | 2.45 |  | https://www.digikey.com/product-detail/en/texas-instruments/BQ24296RGER/296-44468-1-ND/6110752
 |  | U801 | LTC2942IDCB_TRMPBF | MangOH-Red:LTC2942IDCB_TRMPBF | MangOH-Red:DFN_6P_0200x0300_SLUG_0135x0165_0050CC |  |  |  | LTC2942IDCB#TRMPBF | 4.62 |  | https://www.digikey.com/product-detail/en/linear-technology-analog-devices/LTC2942IDCB-TRMPBF/LTC2942IDCB-TRMPBFCT-ND/2424941
 |  | U900 | TPS7A7300 | MangOH-Red:TPS7A7300 | MangOH-Red:QFN_20P_0500x0500_SLUG_0320x0320_0065CC | ./datasheet/TPS7A7300.pdf | DNI |  | TPS7A7300 | 3.32 |  | https://www.mouser.com/ProductDetail/Texas-Instruments/TPS7A7300RGWR?qs=sGAEpiMZZMvBcbRQpVp%2FsMX%2F7LZkDUec
 |  | U901 | TPS62420DRC | MangOH-Red:TPS62420DRC | MangOH-Red:DFN_10P_0300x0300_SLUG_0240x0165_0050CC_TI_POWERPAD | ./datasheet/TPS62420DRC.pdf |  |  | TPS62420DRC | 1.82 |  | https://www.digikey.com/product-detail/en/texas-instruments/TPS62420DRCR/296-25650-1-ND/2203742
 |  | U903 | XC6221A182MR | MangOH-Red:XC6221A182MR | MangOH-Red:SOT23_5P_0300x0160_0095CC | ./datasheet/XC6221A182MR.pdf |  |  | XC6221A182MR | 0.61 |  | https://www.digikey.com/product-detail/en/torex-semiconductor-ltd/XC6221A182MR-G/893-1089-1-ND/2138280
 |  | U1000 | MT7697 | MangOH-Red:MT7697 | MangOH-Red:QFN_68P_0800x0800_SLUG_0550x0550_0040CC | ./datasheet/MT7697.pdf |  |  | MT7697
 |  | U1001 | MX25L3233FM1I-08G_TR | MangOH-Red:MX25L3233FM1I-08G_TR | MangOH-Red:SOIC_8P_0490x0390_0127CC |  |  |  | MX25L3233FM1I-08G TR
 |  | U1004 | SX1509BIULTRT | MangOH-Red:SX1509BIULTRT | MangOH-Red:QFN_28P_0400x0400_SLUG_0265x0265_0040CC | ./datasheet/SX1509BIULTRT.pdf |  |  | SX1509BIULTRT | 2.55 |  | https://www.digikey.com/product-detail/en/semtech-corporation/SX1509BIULTRT/SX1509BIULCT-ND/2295548
 |  | U1005 | TPS61253YFFR | MangOH-Red:TPS61253YFFR | MangOH-Red:BGA_9P_0130x0120_0040CC_0023PD |  |  |  | TPS61253YFFR | 1.43 |  | https://www.digikey.com/product-detail/en/texas-instruments/TPS61253YFFR/296-36818-1-ND/4341493
 |  | U1006 | CP2130-F01-GM | MangOH-Red:CP2130-F01-GM | MangOH-Red:QFN_24P_0400x0400_SLUG_0270x0270_0050CC |  |  |  | CP2130-F01-GM | 1.81 |  | https://www.digikey.com/product-detail/en/silicon-labs/CP2130-F01-GM/336-2585-ND/4477252
 |  | U1007 | 24AA32AF-I-MNY | MangOH-Red:24AA32AF-I-MNY | MangOH-Red:DFN_8P_0200x0300_SLUG_0140x0140_0050CC |  |  |  | 24AA32AF-I/MNY | - |  | https://www.mouser.com/ProductDetail/Microchip-Technology/24AA32AF-I-MNY
 |  | U1010 | 74LVC2G126HD4-7 | MangOH-Red:74LVC2G126HD4-7 | MangOH-Red:DFN_8P_0200x0100_0050CC |  |  |  | 74LVC2G126HD4-7 | 0.47 |  | https://www.digikey.com/product-detail/en/diodes-incorporated/74LVC2G126HD4-7/74LVC2G126HD4-7DICT-ND/6136347
 |  | U1020 | 74LVC2G126HD4-7 | MangOH-Red:74LVC2G126HD4-7 | MangOH-Red:DFN_8P_0200x0100_0050CC |  |  |  | 74LVC2G126HD4-7 | 0.47 |  | https://www.digikey.com/product-detail/en/diodes-incorporated/74LVC2G126HD4-7/74LVC2G126HD4-7DICT-ND/6136347
 |  | Y1000 | CT2520DB26000C0FZZA1 | MangOH-Red-Extra:CT2520DB26000C0FZZA1 | Crystal:Crystal_SMD_2520-4Pin_2.5x2.0mm |  |  |  | CT2520DB26000C0FZZA1 | 1.0 |  | https://www.digikey.com/product-detail/en/kyocera-international-inc-electronic-components/CT2520DB26000C0FZZA1/1253-1387-1-ND/5181911
Collated Components:
Item | Qty | Reference(s) | Value | LibPart | Footprint | Datasheet | DNI | I_LIM_MAX | MPN | Price | Tolerance | URL
1 | 1 | ANT1000 | WLA.01 | MangOH-Red-Extra:WLA.01 | MangOH-Red:WLA.01 |  |  |  | WLA.01 | 13.35 |  | https://www.digikey.com/product-detail/en/taoglas-limited/WLA.01/931-1077-1-ND/2332742
2 | 21 | C203, C204, C205, C210, C211, C212, C213, C220, C221, C222, C223, C225, C226, C227, C228, C229, C230, C231, C312, C507, C508 | 22p | Device:C | Capacitor_SMD:C_0402_1005Metric | ~ |  |  | GRM1555C1H220JA01D | 0.1 |  | https://www.digikey.com/product-detail/en/murata-electronics-north-america/GRM1555C1H220JA01D/490-5868-1-ND/3175200
3 | 2 | C216, C219 | 12p | Device:C | Capacitor_SMD:C_0402_1005Metric | ~ |  |  | GRM1555C1H120JA01D | 0.1 |  | https://www.digikey.com/product-detail/en/murata-electronics-north-america/GRM1555C1H120JA01D/490-5924-1-ND/3721281
4 | 2 | C250, C606 | 1n | Device:C | Capacitor_SMD:C_0402_1005Metric | ~ |  |  | GRM155R71H102KA01D | 0.1 |  | https://www.digikey.com/product-detail/en/murata-electronics-north-america/GRM155R71H102KA01D/490-1303-1-ND/587936
5 | 67 | C288, C305, C307, C320, C321, C322, C355, C356, C360, C362, C400, C401, C402, C403, C404, C405, C406, C450, C517, C518, C520, C604, C610, C624, C700, C701, C702, C704, C705, C715, C720, C721, C722, C723, C725, C900, C901, C902, C904, C905, C907, C910, C913, C914, C915, C916, C917, C918, C919, C921, C929, C930, C931, C932, C933, C940, C941, C950, C951, C953, C954, C1000, C1003, C1007, C1012, C1014, C1020 | 100n | Device:C | Capacitor_SMD:C_0402_1005Metric | ~ | DNI |  | NMC0402X7R104K16TRPF | 0.1 |  | https://www.digikey.com/product-detail/en/murata-electronics-north-america/GRM155R71C104KA88D/490-3261-1-ND/702802
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
