leoheck/mangoh-red/mangoh-red-parts-placement.txt

ANT1000 62.2 5.95 270.0 @top
C203 17.3 13.75 90.0 @bottom
C204 18.3 15.6 270.0 @bottom
C205 18.3 13.75 90.0 @bottom
C210 13.3 13.75 270.0 @bottom
C211 15.3 13.75 270.0 @bottom
C212 14.3 13.75 270.0 @bottom
C213 16.3 13.75 270.0 @bottom
C216 5.2 23.375 180.0 @bottom
C219 7.0 25.9 0.0 @bottom
C220 8.25 13.75 270.0 @bottom
C221 10.25 13.75 270.0 @bottom
C222 9.25 13.75 270.0 @bottom
C223 7.25 13.75 270.0 @bottom
C225 23.075 15.425 90.0 @bottom
C226 19.3 13.75 90.0 @bottom
C227 30.65 17.625 180.0 @top
C228 38.325 5.2 90.0 @top
C229 5.875 20.425 90.0 @bottom
C230 30.65 18.675 180.0 @top
C231 30.65 16.575 180.0 @top
C250 21.6 33.3 180.0 @bottom
C288 56.675 25.05 270.0 @top
C301 10.475 6.55 180.0 @top
C302 8.175 28.3 0.0 @bottom
C304 58.525 41.975 270.0 @top
C305 58.825 40.2 180.0 @top
C306 58.825 39.2 180.0 @top
C307 57.4 36.2 90.0 @top
C308 52.5 13.2 180.0 @top
C309 53.35 14.875 180.0 @top
C310 40.7 4.9 90.0 @top
C311 39.45 4.9 270.0 @top
C312 6.975 6.425 180.0 @bottom
C318 43.05 46.55 0.0 @bottom
C320 41.925 8.3 270.0 @bottom
C321 41.925 10.15 270.0 @bottom
C322 41.875 17.6 90.0 @bottom
C330 56.45 29.65 90.0 @top
C331 56.45 31.5 270.0 @top
C355 28.4 8.0 90.0 @bottom
C356 27.975 4.575 0.0 @bottom
C360 44.75 4.475 180.0 @bottom      
C362 46.6 4.475 0.0 @bottom
C400 9.7 52.125 180.0 @bottom
C401 6.975 52.125 0.0 @bottom
C402 12.4 48.975 0.0 @bottom
C403 39.925 41.5 270.0 @bottom
C404 40.925 41.5 270.0 @bottom
C405 41.35 12.95 0.0 @bottom
C406 38.7 29.525 0.0 @bottom
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
U1000 51.15 24.1 180.0 @bottom
U1001 43.6 32.7 0.0 @bottom
U1004 14.1 24.625 270.0 @bottom
U1005 55.875 47.525 270.0 @top
U1006 38.05 23.025 270.0 @bottom
U1007 38.775 43.675 270.0 @bottom
U1010 46.05 16.0 180.0 @bottom
U1020 43.6 16.0 180.0 @bottom
Y1000 43.55 23.3 0.0 @bottom
