leoheck/mangoh-red/(threads)

Thread 1 (2018-12-30):

Footprint association

leoheck, 2018-12-30:
Finish footprint association
- Recreate missing footprints
- Map know footprints
