leoheck/mangoh-red/mangoh-red.kicad_pcb

## KiCad design mangoh-red.kicad_pcb (2019-05-20)

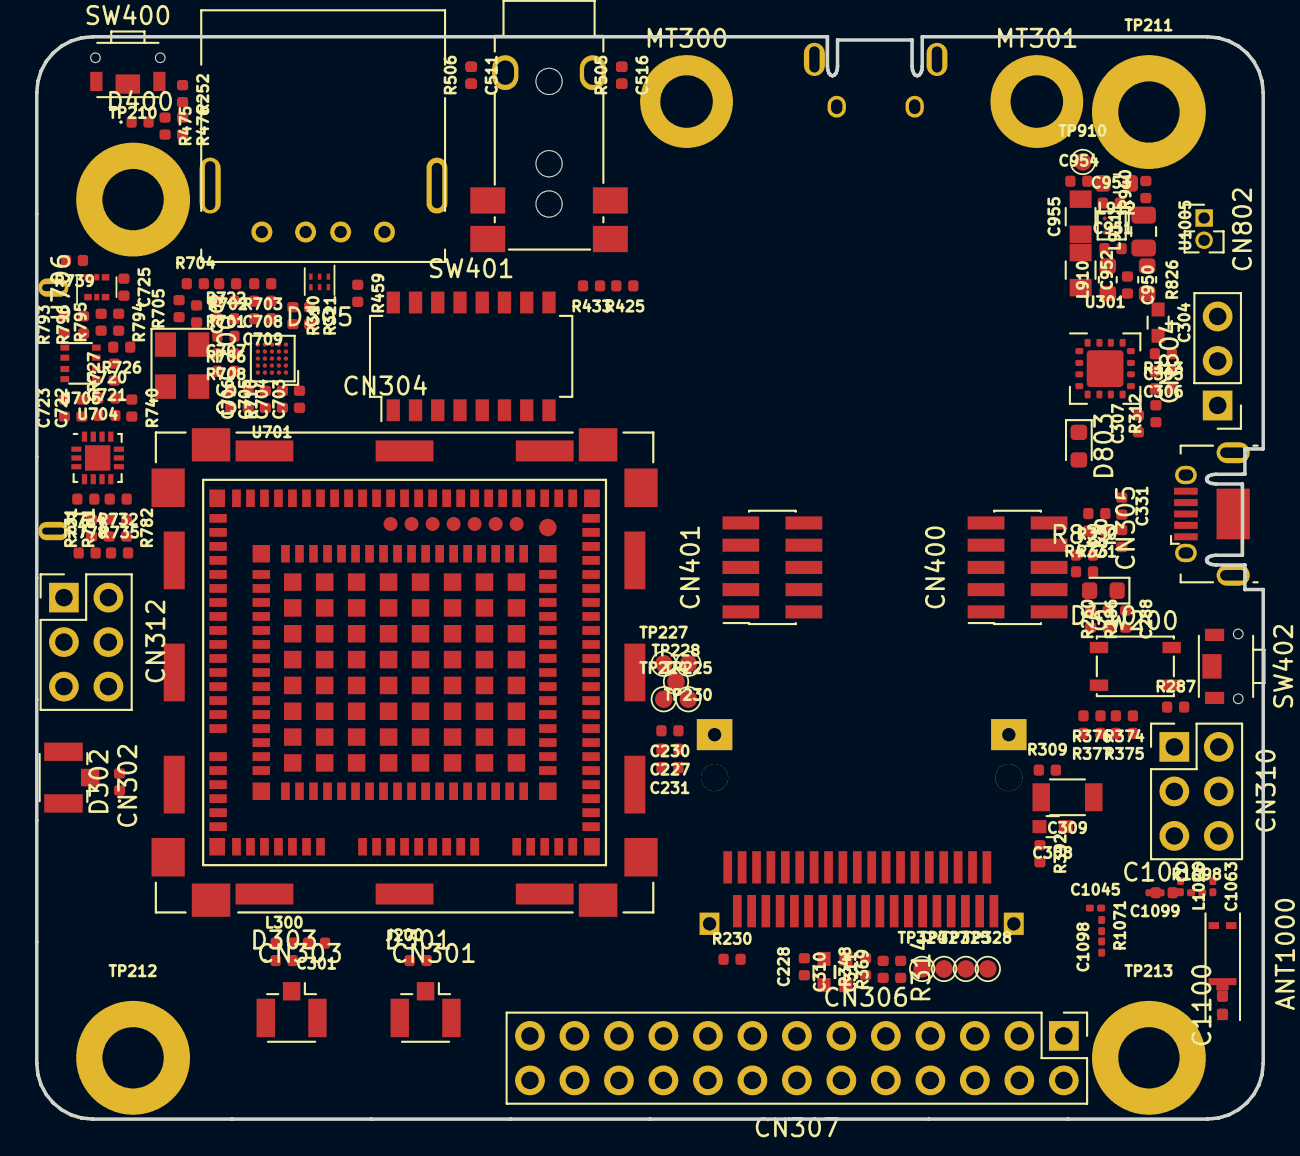
[picture p14: board mangoh-red.kicad_pcb from above]

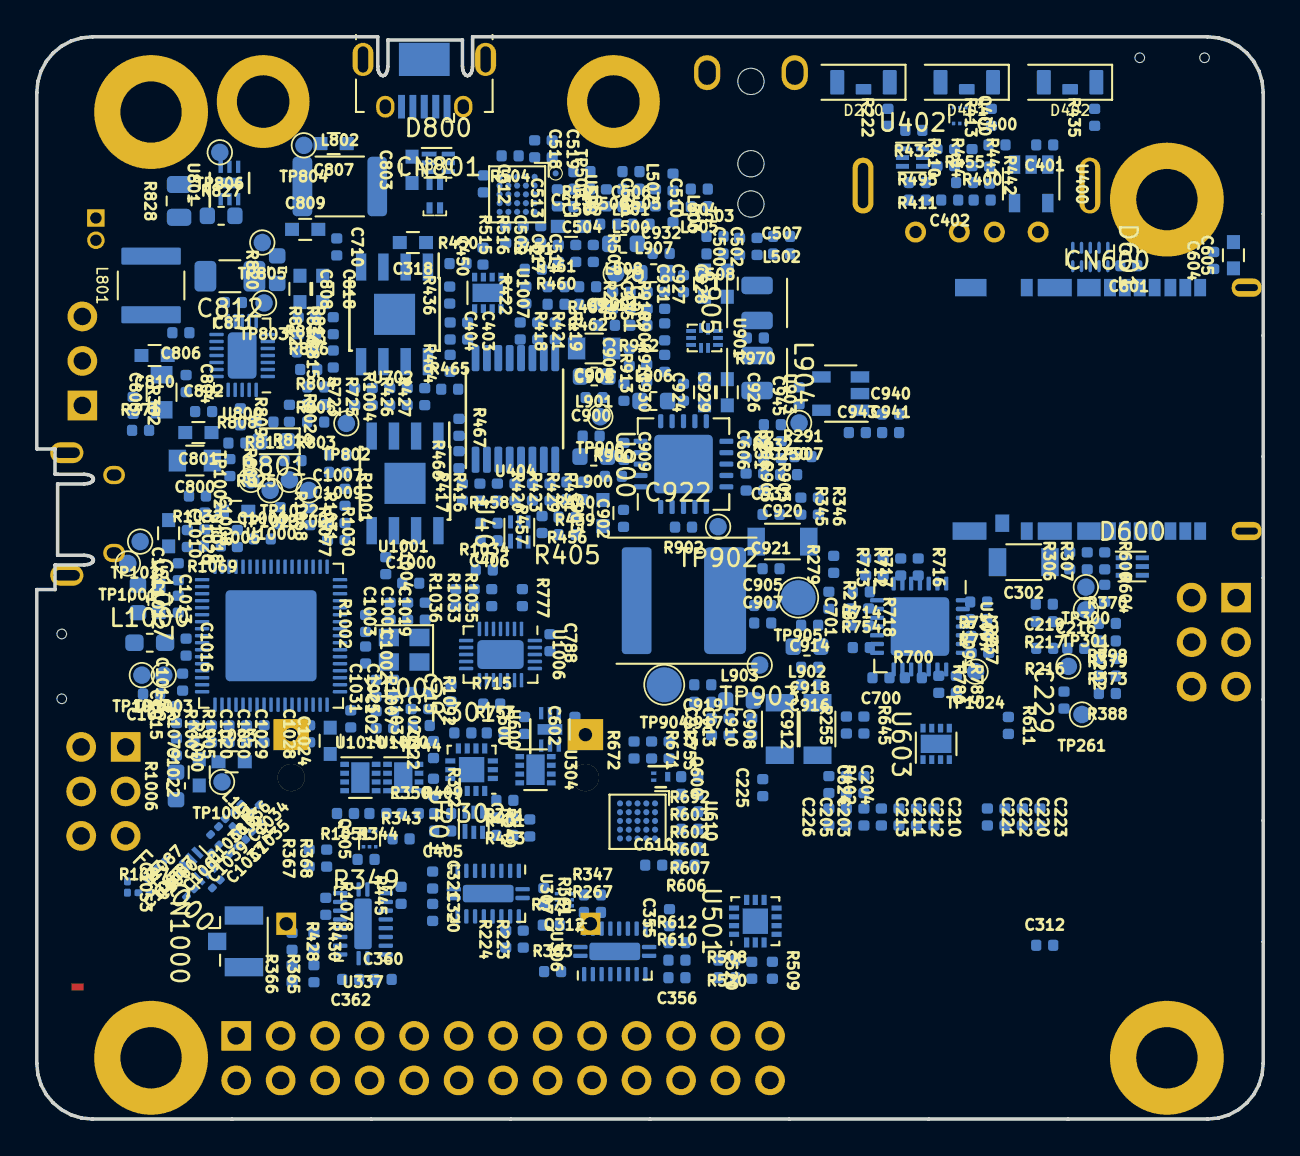
[picture p15: board mangoh-red.kicad_pcb from below]

Board: 6 copper layers, 70.0 x 61.8 mm, 598 parts (443 on the bottom side), 364 nets, no tracks yet.

Parts:
ANT1000: WLA.01
C203, C204, C205, C210, C211, C212, C213, C220, C221, C222, C223, C225, C226, C227, C228, C229, C230, C231, C312, C507, C508: 22p; C_0402_1005Metric
C216, C219: 12p; C_0402_1005Metric
C250, C606: 1n; C_0402_1005Metric
C288, C305, C307, C320, C321, C322, C355, C356, C360, C362, C400, C401, C402, C403, C404, C405, C406, C450, C517, C518, C520, C604, C610, C624, C700, C701, C702, C704, C705, C715, C720, C721, C722, C723, C725, C900, C901, C902, C904, C905, C907, C910, C913, C914, C915, C916, C917, C918, C919, C921, C929, C930, C931, C932, C933, C940, C941, C950, C951, C953, C954, C1000, C1003, C1007, C1012, C1014, C1020: 100n; C_0402_1005Metric
C301: 15p; C_0402_1005Metric
C302, C309, C908, C912, C920: 47u; C_1206_3216Metric
C304: 1u; C_0603_1608Metric
C306, C509, C512, C513, C514, C519, C703, C706, C707, C708, C709, C788, C1008, C1009, C1025: 4.7u; C_0402_1005Metric
C308, C605, C810: 4.7u; C_0603_1608Metric
C310, C311, C318, C803, C808, C818, C903, C1005, C1013, C1017: 10u; C_0603_1608Metric
C330, C331: 47p; C_0402_1005Metric
C500, C501, C502, C505, C506, C510, C511, C516, C1006, C1019, C1026, C1030, C1033: 100p; C_0402_1005Metric
C503, C504, C600, C601, C602, C710, C802, C804, C943, C945, C1011, C1016, C1018, C1021, C1032: 1u; C_0402_1005Metric
C515, C1010, C1022, C1023, C1024: 2.2u; C_0603_1608Metric
C800: 22u; C_0805_2012Metric
C801, C807, C809: 220n; C_0603_1608Metric
C805, C906, C952, C955: 10u; C_0805_2012Metric
C806, C909: 47n; C_0402_1005Metric
C811: 10u; C_0402_1005Metric
C812: 10u; C_1206_3216Metric
C911: 10n; C_0402_1005Metric
C922: 1.5m; CAP_2P_0720x0630_POL_NIB
C924, C926, C927, C928: 22u; C_0603_1608Metric
C925: 56p; C_0402_1005Metric
C1001, C1004: 470n; C_0402_1005Metric
C1002, C1027, C1028, C1029, C1031, C1100: 10p; C_0402_1005Metric
C1015: 470p; C_0402_1005Metric
C1034: 1p; C_0201_0603Metric
C1035, C1036, C1039, C1053, C1065: 1.5p; C_0201_0603Metric
C1037, C1038: 1.8p; C_0201_0603Metric
C1045, C1063, C1098, C1099: 10p; C_0201_0603Metric
C1060: 2.7p; C_0201_0603Metric
C1061: 100p; C_0201_0603Metric
C1087: 2.2p; C_0201_0603Metric
C1088: 10k; R_0402_1005Metric
CN301, CN302, CN303, CN1000: uFL; CONN_3P_0300x0310_RF_HIROSE
CN304: USB_A; CONN_4P_1450x1400_USB_2GND_RA_THRU
CN305, CN801: USB_B_Micro; CONN_5P_0750x0560_USB_5GND_HRS_ZX62RD
CN306: Conn_02x19_Counter_Clockwise; CONN_38P_1820x1150_0080CC_EVERCLEAR
CN307: Conn_02x13_Odd_Even; CONN_26P_3300x0483_0254CC_HEADER_THRU
CN310, CN312: Conn_02x03_Odd_Even; CONN_6P_0760x0510_HEADER_THRU_0254CC
CN400, CN401: Conn_02x05_Odd_Even; CONN_10P_0673x0305_0127CC_SMT
CN500: JP036-RT3B4AB; CONN_6P_1480x0640_AUDIO_JACK_DUAL
CN600: CN600; CONN_25P_1780x1290_0088CC_MICROSDSIM
CN802: Conn_01x02; CONN_2P_0590x0450_0200CC_THRU_HEADER
CN804: Conn_01x03; CONN_3P_0762x0254_VERTICAL_HEADER_SINGLE_ROW_THRU_SAMTEC_TSW
D200, D401, D402: LED_PAD; 12-21SYGC_S530-E2_TR8
D301, D302, D303: 0.05p; LED_0402_1005Metric
D305, D800: TPD4S012DRYR; DFN_6P_0145x0100_0050CC
D400: D_TVS; LED_0402_1005Metric
D410, D801, D803: LED; LED_0603_1608Metric
D600: RCLAMP0503N; DFN_6P_0145x0100_0050CC
D601: TPD6E004RSER; QFN_8P_0150x0150_0050CC
FIL1000: BL1608-05A2450TB; FIL_6P_0160x0080_0050CC_MURATA
J200: CF3-Socket; SIERRA_WP_SNAP-IN_BASE
L300: 47n; L_0402_1005Metric
L500, L501, L504, L505, L506, L507: 0; L_0402_1005Metric
L502, L503: 22n; L_0402_1005Metric
L508, L900, L901, L902, L903, L906, L907, L910, L912: 0; L_0603_1608Metric
L800: TCM1210-900-2P-T000; EXC24C
L801: 3.3u; IND_2P_0400x0400_0237CC_COILCRAFT
L802: 0; L_1812_4532Metric
L904, L905: 2.2u; 2016L
L911: 0; L_0805_2012Metric
L1000: 2.2u; L_0603_1608Metric_Pad1.05x0.95mm_HandSolder
L1001, L1002: 1.2n; L_0201_0603Metric
L1026: 2.2n; L_0201_0603Metric
L1087: 2.4n; L_0201_0603Metric
MT300, MT301: Round_Standoff_M2; STANDOFF_0530_0300H_THRU
OSC700: ENE3687A; Crystal_SMD_SeikoEpson_FA238V-4Pin_3.2x2.5mm
Q312, Q400, Q405: NSBC114YDP6T5G; SOT963_6P_0100x0080_0035CC
Q600: PDTC115EM; DFN_3P_0060x0100_0035CC
R216, R217, R223, R224, R230, R238, R252, R255, R260, R267, R278, R279, R309, R340, R341, R343, R344, R345, R346, R347, R348, R350, R363, R365, R366, R367, R368, R369, R370, R371, R373, R374, R375, R382, R392, R400, R416, R417, R418, R426, R427, R439, R440, R441, R442, R460, R461, R464, R465, R467, R475, R495, R505, R506, R507, R515, R516, R610, R611, R612, R645, R725, R732, R733, R736, R737, R739, R753, R754, R755, R778, R782, R785, R786, R793, R794, R795, R796, R798, R825, R902, R903, R940, R970, R1068, R1078, R1091, R1092: 0; R_0402_1005Metric
R222: 280; R_0402_1005Metric
R251, R291, R402, R432, R632: 100k; R_0402_1005Metric
R286, R301, R306, R312, R313, R372, R376, R377, R379, R388, R404, R411, R422, R425, R433, R436, R450, R451, R462, R463, R508, R509, R520, R671, R672, R692, R700, R701, R702, R703, R704, R705, R706, R708, R712, R713, R714, R715, R716, R717, R718, R722, R724, R726, R727, R731, R740, R744, R777, R781, R802, R803, R804, R805, R806, R807, R808, R809, R810, R811, R812, R904, R1000, R1001, R1002, R1003, R1004, R1005, R1051, R1077, R1079: 10k; R_0402_1005Metric
R287, R410, R445, R459: 100; R_0402_1005Metric
R307: 220; R_0402_1005Metric
R310, R311: 22; R_0402_1005Metric
R314, R401, R403, R455, R456, R457, R476, R601, R602, R603, R606, R607, R1033, R1034: 47k; R_0402_1005Metric
R330, R331: 27; R_0402_1005Metric
R349, R361, R378, R910: 820k; R_0402_1005Metric
R405, R413, R435, R477: 820; R_0402_1005Metric
R409, R458: 330; R_0402_1005Metric
R419, R420, R421, R423, R428, R429, R430, R431, R466: 4.7k; R_0402_1005Metric
R500, R501: 2.2k; R_0402_1005Metric
R504: 20K; R_0402_1005Metric
R600, R1035, R1036: 33; R_0402_1005Metric
R604, R813: 15k; R_0402_1005Metric
R710: 12k; R_0402_1005Metric
R723, R735, R1030, R1031, R1032, R1069: 10K; R_0402_1005Metric
R814: 150; R_0402_1005Metric
R815: 30.1k; R_0402_1005Metric
R816: 5.23k; R_0402_1005Metric
R820, R826, R827, R1006: 0; R_0603_1608Metric
R822, R901: R; R_0402_1005Metric
R828: 68m; R_0805_2012Metric
R900, R906: 33k; R_0402_1005Metric
R905: 220k; R_0402_1005Metric
R911: 360k; R_0402_1005Metric
R912, R913: 180k; R_0402_1005Metric
R1007: 36; R_0402_1005Metric
R1071, R1087: 10k; R_0201_0603Metric
R1098: 2.7p; R_0201_0603Metric
SW200: PTS810; SW_SPST_PTS810
SW400, SW402: SKTDLDE010; SW_5P_0390x0290_0280CC_THRU_2P
SW401: Conn_02x08_Counter_Clockwise; SW_16P_1128x0620_0127CC_DIP_SPST
TP210, TP211, TP212, TP213: TESTPOINT_0650_RND_0350H; Test_Point_Pad_d_0650
TP224, TP225, TP227, TP228, TP230, TP232, TP261, TP300, TP301, TP324, TP325, TP327, TP328, TP802, TP803, TP804, TP805, TP806, TP901, TP902, TP903, TP906, TP907, TP910, TP1000, TP1001, TP1002, TP1003, TP1004, TP1021, TP1022, TP1023, TP1024, TP1025: TestPoint; Test_Point_Pad_d_0100
TP500: TestPoint; Test_Point_Pad_d_0035
TP904, TP905: TestPoint; Test_Point_Pad_d_0200
U301: FT230XQ-R; QFN_16P_0400x0400_SLUG_0210x0210_0065CC
U302, U501: TS3A5018RSVR; QFN_16P_0260x0180_0040CC
U304, U1010, U1020: 74LVC2G126HD4-7; DFN_8P_0200x0100_0050CC
U306, U307, U337: FXMA108BQX; QFN_20P_0250x0450_SLUG_0115x0315_0050CC
U400: NCP303LSN30T1G; SOT23_5P_0300x0160_0095CC
U401, U402, U405: 74AUP1G08GM; DFN_6P_0145x0100_0050CC
U404: TCA9546APWR; TSSOP_16P_0500x0440_0065CC
U500: WM8944BECS_R; BGA_25P_0241x0241_0050CC_0030PD
U600: XC6223H29B9R-G; DFN_4P_0100x0100_SLUG_ROTATED_45DEG_0042x0042_0065CC
U603: ESIM; DFN_8P_0500x0600_SLUG_0420x0340_0127CC_ESIM_MODULE_MFF2
U610: TXS02612ZQSR; BGA_24P_0300x0300_0050CC_0030PD
U701: USB3503A-1-GL-TR; BGA_25P_0200x0200_0040CC_0030PD
U702: MIC2026-1YM; SOIC_8P_0490x0390_0127CC
U704: BMI160; QFN_14P_0250x0300_0050CC
U705: BMP280; DFN_8P_0250x0200_0065CC
U706: PNJ4K01F; DFN_6P_0155x0150_0050CC
U800: BQ24296RGER; QFN_24P_0400x0400_SLUG_0270x0270_0050CC
U801: LTC2942IDCB_TRMPBF; DFN_6P_0200x0300_SLUG_0135x0165_0050CC
U900: TPS7A7300; QFN_20P_0500x0500_SLUG_0320x0320_0065CC
U901: TPS62420DRC; DFN_10P_0300x0300_SLUG_0240x0165_0050CC_TI_POWERPAD
U903: XC6221A182MR; SOT23_5P_0300x0160_0095CC
U1000: MT7697; QFN_68P_0800x0800_SLUG_0550x0550_0040CC
U1001: MX25L3233FM1I-08G_TR; SOIC_8P_0490x0390_0127CC
U1004: SX1509BIULTRT; QFN_28P_0400x0400_SLUG_0265x0265_0040CC
U1005: TPS61253YFFR; BGA_9P_0130x0120_0040CC_0023PD
U1006: CP2130-F01-GM; QFN_24P_0400x0400_SLUG_0270x0270_0050CC
U1007: 24AA32AF-I-MNY; DFN_8P_0200x0300_SLUG_0140x0140_0050CC
Y1000: CT2520DB26000C0FZZA1; XTAL_4P_0250x0200

Connections:
2G_TX_ON: J200.60, Q400.5
/3. RF, USB, IOT connectors/CTS_FTDI: U301.4, U302.10
/3. RF, USB, IOT connectors/RTS_FTDI: U301.16, U302.2
/3. RF, USB, IOT connectors/RX_FTDI: U301.2, U302.5
/3. RF, USB, IOT connectors/TX_FTDI: U301.15, U302.7
/3. RF, USB, IOT connectors/UART2_CTS_3V3: U302.12, U307.12
/3. RF, USB, IOT connectors/UART2_RX_3V3: U302.3, U307.14
/10. WIFI and BT/WF_RF_2G_TRX_N: C1034.2, C1036.1, L1002.2, U1000.63
/10. WIFI and BT/WF_RF_2G_TRX_P: C1034.1, C1035.2, L1001.2, U1000.64
ADC0: CN306.20, R230.1
ADC1: J200.24, R370.1, R379.2
ADC1_WIFI: R374.1, R376.2, U1000.47
ADC2: J200.107, R373.2, R388.2, R798.1
ADC2_WIFI: R375.1, R377.2, U1000.46
ADC3: J200.108, R735.1, R778.1, R798.2
BATT_TS+: R815.2, R816.1, SW401.5, TP802.1, U800.11
BAT_RTC: J200.21, R306.2
BOARD_REV1: R712.2, R716.1, U1004.27
BOARD_REV2: R713.2, R717.1, U1004.28
BOARD_REV3: R714.1, R718.2, U1004.1
BattChrgr_INT_N: R785.1, R802.1, U800.7
CARD1_DETECT: C606.2, J200.64, R632.2
CARD2_DETECT: C250.2, CN312.6, J200.65, R251.2, R291.1
CARD_DETECT_IOT0: CN306.31, J200.105, R314.1
CONS_DIR: R372.1, SW401.6, U302.15, U1004.22
Charger_I2C_CLK: R427.2, U800.5, U801.3
Charger_I2C_DATA: R426.2, U800.6, U801.4
Expansion1_I2C_CLK: R421.2, U404.10, U1004.25
Expansion1_I2C_DATA: R419.2, U404.9, U1004.24
GND: ANT1000.1, C203.2, C204.2, C205.2, C210.2, C211.2, C212.2, C213.2, C216.2, C219.2, C220.2, C221.2, C222.2, C223.2, C225.2, C226.2, C227.2, C228.2, C229.2, C230.2, C231.2, C250.1, C288.2, C302.1, C304.1, C305.1, C306.1, C307.1, C308.1, C309.1, C310.1, C311.1, C312.1, C318.1, C320.1, C321.1, C322.1, C330.1, C331.2, C355.1, C356.2, C360.1, C362.1, C400.2, C401.2, C402.2, C403.2, C404.2, C405.2, C406.2, C450.2, C500.1, C502.1, C505.1, C506.1, C507.1, C508.1, C509.1, C511.1, C512.1, C513.1, C514.1, C515.1, C516.1, C517.1, C518.1, C519.1, C520.1, C600.2, C601.2, C602.2, C604.1, C605.2, C606.1, C610.2, C624.1, C700.1, C701.2, C702.1, C703.1, C704.2, C705.1, C706.2, C707.2, C708.2, C709.2, C710.2, C715.1, C720.2, C721.2, C722.2, C723.2, C725.2, C788.1, C803.2, C807.2, C809.2, C810.1, C900.2, C901.2, C902.2, C903.2, C904.2, C905.2, C906.2, C907.2, C908.2, C909.1, C910.2, C911.2, C912.2, C913.2, C914.2, C915.2, C916.2, C917.2, C918.2, C919.2, C920.2, C921.2, C922.2, C924.2, C927.2, C928.2, C929.2, C930.2, C931.2, C932.2, C933.2, C940.2, C941.2, C943.2, C945.2, C950.2, C951.2, C952.2, C953.2, C954.2, C955.2, C1000.1, C1001.1, C1002.1, C1003.1, C1004.1, C1005.1, C1006.1, C1007.2, C1008.1, C1009.2, C1010.1, C1011.1, C1013.1, C1014.1, C1015.1, C1016.2, C1017.1, C1018.2, C1019.2, C1020.1, C1021.2, C1022.1, C1023.1, C1024.1, C1025.2, C1026.2, C1027.2, C1028.2, C1029.2, C1030.2, C1031.2, C1032.2, C1033.2, C1035.1, C1036.2, C1037.1, C1038.2, C1045.2, C1053.2, C1060.2, C1061.1, C1063.2, C1065.2, C1087.2, C1098.2, C1100.2, CN301.2, CN301.3, CN302.2, CN302.3, CN303.2, CN303.3, CN304.4, CN304.5, CN305.5, CN305.6, CN306.4, CN306.21, CN306.30, CN306.38, CN307.6, CN307.9, CN307.14, CN307.20, CN307.25, CN400.3, CN400.5, CN401.3, CN401.5, CN600.G1, CN600.G2, CN600.G3, CN600.G4, CN600.G5, CN600.G6, CN600.G7, CN600.G8, CN600.S5, CN600.T6, CN801.5, CN801.6, CN802.2, CN1000.2, D301.2, D302.2, D303.2, D305.4, D400.2, D601.8, D800.4, D803.1, FIL1000.5, J200.30, J200.32, J200.37, J200.39, J200.48, J200.50, J200.67, J200.68, J200.69, J200.70, J200.111, J200.113, J200.125, J200.128, J200.136, J200.139, J200.167, J200.168, J200.169, J200.170, J200.171, J200.172, J200.173, J200.174, J200.175, J200.176, J200.177, J200.178, J200.179, J200.180, J200.181, J200.182, J200.183, J200.184, J200.185, J200.186, J200.187, J200.188, J200.189, J200.190, J200.191, J200.192, J200.193, J200.194, J200.195, J200.196, J200.197, J200.198, J200.199, J200.200, J200.201, J200.202, J200.203, J200.204, J200.205, J200.206, J200.207, J200.208, J200.209, J200.210, J200.211, J200.212, J200.213, J200.214, J200.215, J200.216, J200.217, J200.218, J200.219, J200.220, J200.221, J200.222, J200.223, J200.224, J200.225, J200.226, J200.227, J200.228, J200.229, J200.230, J200.231, J200.232, J200.233, J200.234, J200.G1, J200.G2, J200.G3, J200.G4, J200.G5, J200.G6, J200.G7, J200.G8, J200.G9, J200.G10, J200.G11, J200.G12, J200.G13, J200.G14, J200.G15, J200.G16, J200.G17, J200.G18, J200.G19, J200.G20, L1026.2, MT300.1, MT301.1, OSC700.2, Q312.1, Q312.4, Q400.1, Q400.4, Q405.1, Q405.4, Q600.2, R287.1, R291.2, R301.2, R313.2, R372.2, R376.1, R377.1, R379.1, R388.1, R401.2, R402.2, R416.1, R418.1, R422.2, R425.2, R432.2, R433.2, R436.2, R456.2, R501.1, R504.2, R505.2, R506.2, R508.2, R671.2, R703.2, R705.2, R710.2, R714.2, R716.2, R717.2, R722.2, R724.2, R726.2, R735.2, R744.1, R804.1, R806.1, R808.1, R813.1, R814.1, R815.1, R906.2, R912.1, R913.1, R970.1, R1001.1, R1002.1, R1003.1, R1005.1, R1031.2, R1032.1, R1051.2, R1079.2, SW400.1, SW400.3, SW401.16, SW402.2, TP210.1, TP211.1, TP212.1, TP213.1, TP301.1, U301.3, U301.13, U301.17, U302.6, U304.4, U306.10, U306.21, U307.10, U307.21, U337.10, U337.21, U400.3, U401.3, U402.3, U404.8, U405.3, U500.C2, U501.6, U600.2, U600.5, U603.1, U603.9, U610.C3, U610.D3, U701.C3, U702.6, U704.6, U704.7, U705.1, U705.7, U706.2, U706.3, U706.4, U800.25, U801.2, U900.8, U900.18, U900.21, U901.8, U903.2, U1000.41, U1000.42, U1000.69, U1001.4, U1004.3, U1004.10, U1004.17, U1004.26, U1004.29, U1005.C1, U1005.C2, U1005.C3, U1006.2, U1006.25, U1007.4, U1010.4, U1020.4
GPIO1|I2C1_CLK: R345.2, R461.1, R516.2, R795.1, U404.14, U705.4, U1007.6
GPIO5|I2C1_DATA: R346.2, R460.1, R515.2, U404.15, U705.3, U1007.5
GPIOEXP_INT1: J200.104, R700.1, U1004.9
GPIO_0_EXP: CN310.5, U1000.57
GPIO_1_EXP: CN310.2, U1000.56
GPIO_EXP_RPI_1: CN307.16, U1004.2
GPIO_EXP_RPI_2: CN307.18, U1004.5
GPIO_EXP_RPI_3: CN307.22, U1004.8
GPIO_IOT0_RESET: J200.10, R341.1, R401.1, R403.2, R405.1, R411.2, R456.1, R457.2, R467.1, U401.1, U401.2, U402.4, U405.1, U405.2, U701.E3, U1004.23
GPIO_WIFI_RESET: J200.159, R405.2
Generic_Push_Button: R260.1, U1004.21
HL_MODE: R404.1, SW401.4
HSIC_DATA: J200.14, U701.E2
HSIC_STRB: J200.15, U701.E1
Hub_I2C_CLK: R440.2, U701.E5
Hub_I2C_DATA: R439.2, U701.D5
IOT0_GPIO1: C229.1, C231.1, CN306.24, J200.109
IOT0_GPIO2: C203.1, CN306.25, J200.44
IOT0_GPIO3: C210.1, C228.1, CN306.26, CN401.4, J200.40
IOT0_GPIO4: C212.1, CN306.27, CN401.2, J200.41
IOT0_SCL: CN306.23, R423.2, U404.5
IOT0_SDA: CN306.22, R420.2, U404.4
LED_CARD_DETECT_IOT0: Q400.2, R255.2, R786.1
LowPower_RESET: C204.1, J200.46, R402.1, SW401.8
MIC+: C501.2, C504.1, L500.1, R500.2
MIC-: C501.1, C503.1, L501.1, R501.2
MTK_TO_WP_UART_EN: R301.1, R753.1, U302.13, U304.1, U304.7
unnamed: ANT1000.2, C1063.1, R1098.2
unnamed: ANT1000.3, C1100.1
unnamed: C288.1, R260.2, R286.2, SW200.1, SW200.2
unnamed: C301.1, CN303.1, D303.1, L300.2
unnamed: C302.2, R306.1, R307.1
unnamed: C307.2, R312.1, U301.1, U301.8
unnamed: C330.2, CN305.3, R330.2
unnamed: C331.1, CN305.2, R331.1
unnamed: C401.1, U400.5
unnamed: C503.2, U500.B3
unnamed: C504.2, U500.B4
unnamed: C505.2, C510.2, L500.2, L505.1, L506.1
unnamed: C506.2, C510.1, L501.2, L504.1, L507.1
unnamed: C507.2, CN500.4, L502.2
unnamed: C508.2, CN500.1, L503.2
unnamed: C511.2, CN500.5, L504.2, L505.2, R506.1
unnamed: C513.2, U500.A3
unnamed: C514.2, C517.2, L508.1, R507.1, U500.B5
unnamed: C515.2, U500.A4
unnamed: C516.2, CN500.6, L506.2, L507.2, R505.1
unnamed: C518.2, C519.2, R507.2, U500.A1
unnamed: C708.1, C709.1, U701.D3
unnamed: C720.1, C721.1, R740.2, R782.2, U704.5, U704.8, U704.12
unnamed: C725.1, R739.1, U706.1
unnamed: C788.2, U1006.16
unnamed: C803.1, CN801.1, CN804.3
unnamed: C804.2, C805.1, U800.23
unnamed: C806.1, U800.21
unnamed: C806.2, L801.1, U800.19, U800.20
unnamed: C902.1, C903.1, L900.2, R900.2, R902.2, U900.15, U900.16, U900.17
unnamed: C904.1, C906.1, L901.2, R904.1, U901.3
unnamed: C909.2, U900.13
unnamed: C911.1, R901.2, R970.2, U901.7, U901.9, U1005.B3
unnamed: C924.1, C926.1, C929.1, L904.2, L906.1, R911.2, U901.4
unnamed: C925.1, C927.1, C928.1, C931.1, L905.2, L907.1, R910.2
unnamed: C925.2, R910.1, R912.2, U901.1
unnamed: C926.2, R911.1, R913.2, U901.5
unnamed: C951.1, C952.1, L910.2, L911.2, U1005.A3
unnamed: C953.1, L912.1, R940.1, U1005.A1, U1005.A2
unnamed: C1002.2, U1000.4
unnamed: C1012.2, U1000.38
unnamed: C1037.2, C1039.1, FIL1000.3, L1001.1
unnamed: C1038.1, C1039.2, FIL1000.4, L1002.1
unnamed: C1045.1, C1099.2, R1071.2
unnamed: C1053.1, C1088.2, C1099.1, R1087.1
unnamed: C1060.1, FIL1000.1, L1087.2
unnamed: C1065.1, C1087.1, L1087.1, R1087.2
unnamed: C1088.1, L1026.1, R1098.1
unnamed: C1098.1, CN1000.1, R1071.1
unnamed: CN304.2, D305.1, R311.2
unnamed: CN304.3, D305.2, R310.2
unnamed: CN306.28, CN306.29, R348.2, R369.2
unnamed: CN306.32, R344.2, R350.2
unnamed: CN307.2, CN307.4, R371.2, R382.2
unnamed: CN307.3, R366.1, R367.1
unnamed: CN307.5, R365.1, R368.1
unnamed: CN307.12, R363.2
unnamed: CN310.4, R374.2
unnamed: CN310.6, R375.2
unnamed: CN312.4, R370.2
unnamed: CN600.T5, R600.2
unnamed: CN801.2, D800.1, L800.1
unnamed: CN801.3, D800.2, L800.2
unnamed: D200.1, D200.3, J200.106
unnamed: D200.2, R222.2
unnamed: D401.1, D401.3, Q400.6
unnamed: D401.2, R413.1
unnamed: D402.1, D402.3, Q400.3
unnamed: D402.2, R435.1
unnamed: D410.1, Q405.3
unnamed: D410.2, R477.1
unnamed: D801.1, R811.1, U800.4
unnamed: D801.2, R810.1
unnamed: D803.2, R822.1
unnamed: J200.1, R345.1
unnamed: J200.16, R278.2, R279.2
unnamed: J200.22, R217.2
unnamed: J200.23, R216.2
unnamed: J200.25, R230.2
unnamed: J200.45, R238.1
unnamed: J200.66, R346.1
unnamed: J200.91, R252.1
unnamed: J200.98, R224.1
unnamed: J200.99, R223.1
unnamed: J200.110, TP261.1
unnamed: J200.147, R255.1, R267.1
unnamed: J200.152, TP230.1
unnamed: J200.153, TP225.1
unnamed: J200.154, TP228.1
unnamed: J200.155, TP224.1
unnamed: J200.156, TP227.1
unnamed: L904.1, U901.6
unnamed: L905.1, U901.10
unnamed: L911.1, U1005.B1, U1005.B2
unnamed: L1000.1, U1000.40
unnamed: OSC700.3, U701.B3
unnamed: Q312.2, R347.2
unnamed: Q312.3, R378.2, U306.11
unnamed: Q312.5, R340.1, R341.2
unnamed: Q312.6, R361.2, U307.11
unnamed: Q405.2, R343.2
unnamed: Q405.6, R349.2, U337.11
unnamed: R216.1, TP232.1
unnamed: R307.2, TP300.1
unnamed: R312.2, R313.1, U301.9
unnamed: R400.1, U400.2
unnamed: R409.2, U401.4
unnamed: R416.2, U404.2
unnamed: R417.2, U404.1
unnamed: R418.2, U404.13
unnamed: R422.1, R451.2, U1007.7
unnamed: R425.1, SW401.10
unnamed: R426.1, R431.2, R440.1, U404.7
unnamed: R427.1, R429.2, R439.1, U404.6
unnamed: R433.1, SW401.12
unnamed: R436.1, U1007.2, U1007.3
unnamed: R441.1, R442.2, U400.1
unnamed: R450.2, U1007.1
unnamed: R458.2, U405.4
unnamed: R459.2, SW401.15
unnamed: R466.2, R467.2, U404.3
unnamed: R495.2, SW401.13
unnamed: R504.1, U500.C1
unnamed: R508.1, R520.2, U501.13
unnamed: R515.1, U500.C3
unnamed: R516.1, U500.C4
unnamed: R610.2, R612.2, U610.C4
unnamed: R611.2, U603.3
unnamed: R645.1, U603.6
unnamed: R701.2, U701.C5
unnamed: R702.2, R703.1, U701.E4
unnamed: R704.2, R705.1, U701.D4
unnamed: R706.2, R722.1, U701.B5
unnamed: R710.1, U701.A4
unnamed: R723.1, U702.1, U702.4
unnamed: R724.1, R731.2, R781.2, U704.1
unnamed: R725.2, U702.2, U702.3
unnamed: R726.1, R727.2, U705.5
unnamed: R732.2, R737.2, U704.4
unnamed: R733.2, R736.2, U704.9
unnamed: R753.2, U1004.6
unnamed: R754.2, U1004.7
unnamed: R755.2, U1004.14
unnamed: R777.2, U1006.19
unnamed: R778.2, U706.6
unnamed: R785.2, R786.2, U1004.13
unnamed: R793.2, R795.2, U704.13
unnamed: R794.2, R796.2, U704.14
unnamed: R803.1, R804.2, U800.8
unnamed: R805.1, R806.2, U800.9
unnamed: R807.1, R808.2, R825.1, U800.2
unnamed: R809.1, U800.3
unnamed: R812.1, R813.2, U800.12
unnamed: R814.2, U800.10
unnamed: R827.2, TP803.1
unnamed: R900.1, U900.14
unnamed: R903.2, U900.2
unnamed: R904.2, U901.2
unnamed: R905.2, R906.1, U900.3
unnamed: R1005.2, U1000.55
unnamed: R1030.1, R1031.1, U1000.20
unnamed: R1032.2, R1069.2, U1000.33
unnamed: R1035.2, U1006.23
unnamed: R1036.2, U1006.1
unnamed: R1068.2, R1078.2, U1000.45
unnamed: R1091.1, U1000.5
unnamed: R1092.1, U1000.6
unnamed: TP500.1, U500.A2
unnamed: TP806.1, U801.5
unnamed: TP1021.1, U1000.21
unnamed: TP1022.1, U1000.22
unnamed: TP1023.1, U1000.23
unnamed: TP1024.1, U1000.44
unnamed: TP1025.1, U1000.35
OSC_N: R708.2, R725.1, U701.B4
PCM_CLK: C221.1, J200.36, U501.7
PCM_CLK_CODEC: U500.D1, U501.8
PCM_CLK_IOT: CN306.36, U501.9
PCM_EXP1_SEL: R509.2, U501.15, U1004.20
PCM_IN: C220.1, J200.34, U501.10
PCM_IN_CODEC: U500.E4, U501.11
PCM_IN_IOT: CN306.33, U501.12
PCM_OUT: C223.1, J200.33, U501.5
PCM_OUT_CODEC: U500.D3, U501.4
PCM_OUT_IOT: CN306.34, U501.3
PCM_SYNC: C222.1, J200.35, U501.2
PCM_SYNC_Codec: U500.D2, U501.1
PPS: C211.1, CN306.37, J200.42
PWM_OUT: C213.1, J200.43, U306.8
PWM_OUT_3V3: R363.1, U306.13
PWR_GND_BQ: C800.1, C801.1, C802.1, C804.1, C805.2, C808.1, C811.1, C812.2, C818.2, U800.17, U800.18
PWR_ON: J200.59, SW401.1, SW402.1
Power_Fail_Indicator: R442.1, R455.1, U1004.15
RESET_IN: C400.1, D400.1, R410.2, R441.2, R475.1, SW400.2, U402.1
RESET_IN_CF3: CN401.10, J200.11, R344.1, R410.1, R445.2
RESET_IOT0: R350.1, R409.1
RESET_WIFI_1V8: R458.1, R475.2, R476.2, U307.4
RESET_WIFI_3V3: CN400.10, R715.1, R744.2, R1092.2, U307.17, U1000.51, U1006.9
RFU_PIN: CN312.5, J200.19, R373.1
RF_DIV: CN302.1, D302.1, J200.31
RF_GPS: C301.2, J200.38
RF_MAIN: CN301.1, D301.1, J200.49
SCL_EXP: R365.2, R430.2, U404.12
SDA_EXP: R366.2, R428.2, U404.11
SDIO_SEL: Q600.1, R671.1, R672.2, R755.1
SDIO_SEL_LVL: Q600.3, R692.2, U610.A2
SD_CLK: J200.162, U610.D2
SD_CLK_CARD: D601.7, R600.1, U610.A5
SD_CLK_IOT: CN306.5, U610.E5
SD_CMD: J200.161, U610.C1
SD_CMD_CARD: CN600.T3, D601.6, R601.2, U610.A4
SD_CMD_IOT: CN306.6, U610.E4
SD_D0: J200.166, U610.D1
SD_D0_CARD: CN600.T7, D601.1, R607.2, U610.B5
SD_D0_IOT: CN306.10, U610.D5
SD_D1: J200.165, U610.E1
SD_D1_CARD: CN600.T8, D601.2, R606.2, U610.C5
SD_D1_IOT: CN306.9, U610.D4
SD_D2: J200.164, U610.A1
SD_D2_CARD: CN600.T1, D601.3, R603.2, U610.B3
SD_D2_IOT: CN306.8, U610.E2
SD_D3: J200.163, U610.B1
SD_D3_CARD: CN600.T2, D601.5, R602.2, U610.A3
SD_D3_IOT: CN306.7, U610.E3
SENSOR_INT1: R737.1, U1004.16
SENSOR_INT2: R736.1, U1004.19
SPI1_CLK: CN306.16, J200.53
SPI1_MISO: CN306.17, J200.52
SPI1_MOSI: CN306.18, J200.54
SPI1_MRDY: C225.1, CN306.19, J200.51
SPI2_CLK_WIFI_3V3: CN307.23, R1036.1, U1000.25
SPI2_CS1_RPI_3V3: CN307.24, U1006.21
SPI2_CS2_RPI_3V3: CN307.26, U1006.20
SPI2_MISO_WIFI_3V3: CN307.21, R1033.2, U1000.27, U1006.24
SPI2_MOSI_WIFI_3V3: CN307.19, R1034.2, R1035.1, U1000.29
SPI2_MRDY_WIFI_3V3: U1000.24, U1006.22
SPI2_SRDY_WIFI_1V8: R267.2, U306.9
SPI2_SRDY_WIFI_3V3: R777.1, R1068.1, U306.12
SPI_CLK_EXT: U1000.19, U1001.6
SPI_CS_EXT: R1001.2, R1077.1, U1000.12, U1001.1
SPI_DATA0_EXT: U1000.9, U1001.5
SPI_DATA1_EXT: U1000.10, U1001.2
SPI_DATA2_EXT: U1000.15, U1001.3
SPI_DATA3_EXT: R1004.1, U1000.18, U1001.7
SPK+: C502.2, L502.1, U500.B2
SPK-: C500.2, L503.1, U500.B1
SYSTEM_CLK: C216.1, C219.1, R217.1, U500.E1
TP1_BOOT: C205.1, C226.1, J200.47, SW401.7
UART0_RX_EXP: CN307.10, U307.18
UART0_TX_EXP: CN307.8, U307.19
UART1_CTS: J200.4, U337.4
UART1_RTS: CN306.14, CN306.15, J200.3, U337.5
UART1_RX: CN306.13, J200.6, U337.2
UART1_TX: CN306.12, J200.5, U337.3
UART2_CTS: R223.2, U307.9
UART2_RTS: R224.2, U307.8
UART2_RX: J200.97, U307.3, U307.7
UART2_TX: J200.96, U307.2, U307.6
UIM1_CLK: CN600.S3, J200.27
UIM1_DATA: CN600.S7, J200.28, R604.2
UIM1_RESET: CN600.S2, J200.29
UIM2_CLK: J200.58, R645.2
UIM2_DATA: J200.56, R611.1
UIM2_RST: J200.57, U603.7
USB_CONSOLE_D+: R330.1, U301.6
USB_CONSOLE_D-: R331.2, U301.7
USB_D+: J200.13, L800.3
USB_D-: J200.12, L800.4
USB_EXT_D+: R311.1, U701.C1
USB_EXT_D-: R310.1, U701.D1
USB_ID: CN801.4, D800.3, R252.2, R825.2
USB_IOT_D+: CN306.2, R367.2, U701.C2
USB_IOT_D-: CN306.3, R368.2, U701.D2
USB_WIFI_D+: U701.A1, U1006.3
USB_WIFI_D-: U701.B1, U1006.4
VCC: C304.2, C305.2, C306.2, C308.2, C309.2, C310.2, C311.2, C312.2, C318.2, C320.2, C321.2, C322.2, C355.2, C356.1, C360.2, C362.2, C402.1, C403.1, C404.1, C405.1, C406.1, C450.1, C509.2, C512.2, C520.2, C600.1, C601.1, C602.1, C604.2, C605.1, C610.1, C624.2, C700.2, C701.1, C702.2, C703.2, C704.1, C705.2, C706.1, C707.1, C710.1, C715.2, C722.1, C723.1, C800.2, C801.2, C802.2, C807.1, C808.2, C809.1, C810.2, C811.2, C812.1, C818.1, C900.1, C901.1, C905.1, C907.1, C908.1, C910.1, C912.1, C913.1, C914.1, C915.1, C916.1, C917.1, C918.1, C919.1, C920.1, C921.1, C922.1, C930.1, C932.1, C933.1, C945.1, C950.1, C954.1, C955.1, C1000.2, C1001.2, C1003.2, C1004.2, C1005.2, C1006.2, C1007.1, C1008.2, C1009.1, C1010.2, C1011.2, C1012.1, C1013.2, C1014.2, C1015.2, C1016.1, C1017.2, C1018.1, C1019.1, C1020.2, C1021.1, C1022.2, C1023.2, C1024.2, C1025.1, C1026.1, C1027.1, C1028.1, C1029.1, C1030.1, C1031.1, C1032.1, C1033.1, C1061.2, CN304.1, CN305.1, CN306.1, CN306.11, CN307.1, CN307.17, CN312.2, CN400.1, CN401.1, CN600.S1, CN600.T4, CN802.1, CN804.1, CN804.2, D305.6, D601.4, D800.6, FIL1000.2, J200.26, J200.55, J200.61, J200.62, J200.63, J200.157, J200.158, J200.160, L300.1, L508.2, L801.2, L802.1, L802.2, L900.1, L901.1, L902.1, L902.2, L903.1, L903.2, L906.2, L907.2, L910.1, L912.2, L1000.2, OSC700.1, OSC700.4, R222.1, R238.2, R251.1, R278.1, R279.1, R286.1, R309.1, R309.2, R314.2, R340.2, R348.1, R349.1, R361.1, R369.1, R371.1, R378.1, R382.1, R392.1, R392.2, R400.2, R403.1, R411.1, R413.2, R417.1, R419.1, R420.1, R421.1, R423.1, R428.1, R429.1, R430.1, R431.1, R435.2, R450.1, R451.1, R455.2, R457.1, R459.1, R462.2, R463.2, R464.1, R464.2, R465.1, R465.2, R466.1, R476.1, R477.2, R495.1, R500.1, R509.1, R520.1, R601.1, R602.1, R603.1, R604.1, R606.1, R607.1, R610.1, R612.1, R632.1, R672.1, R692.1, R700.2, R701.1, R702.1, R704.1, R706.1, R708.1, R712.1, R713.1, R715.2, R718.1, R723.2, R727.1, R731.1, R739.2, R740.1, R781.1, R782.1, R802.2, R803.2, R805.2, R807.2, R809.2, R810.2, R811.2, R812.2, R816.2, R820.1, R820.2, R822.2, R826.1, R826.2, R827.1, R828.1, R828.2, R901.1, R902.1, R903.1, R905.1, R940.2, R1000.2, R1004.2, R1006.1, R1006.2, R1007.1, R1007.2, R1030.2, R1033.1, R1034.1, R1069.1, R1077.2, SW401.11, SW401.14, TP804.1, TP805.1, TP901.1, TP902.1, TP903.1, TP904.1, TP905.1, TP906.1, TP907.1, TP910.1, TP1000.1, TP1001.1, TP1002.1, TP1003.1, TP1004.1, U301.10, U302.14, U304.8, U306.1, U306.20, U307.1, U307.20, U337.1, U337.20, U401.6, U402.6, U404.16, U405.6, U500.A5, U500.E2, U500.E3, U501.14, U600.1, U600.3, U600.4, U603.8, U610.B4, U610.C2, U701.A2, U701.A3, U701.A5, U701.B2, U702.5, U702.7, U702.8, U705.2, U705.6, U705.8, U800.1, U800.13, U800.14, U800.15, U800.16, U800.22, U800.24, U801.1, U801.6, U900.1, U900.19, U900.20, U903.5, U1000.2, U1000.3, U1000.13, U1000.14, U1000.16, U1000.17, U1000.30, U1000.31, U1000.32, U1000.34, U1000.36, U1000.37, U1000.39, U1000.43, U1000.48, U1000.49, U1000.59, U1000.60, U1000.62, U1000.65, U1001.8, U1004.4, U1004.12, U1004.18, U1006.5, U1006.6, U1006.7, U1006.8, U1007.8, U1010.8, U1020.8
VCC_3V7_ULPM: C940.1, C941.1, C943.1, SW401.3, U903.1, U903.3
WIFI_GPIO00: R343.1, R347.1, R1051.1, R1091.2, U1010.1, U1010.7, U1020.1, U1020.7
WIFI_GPIO6: R1002.2, U1000.11
WIFI_HL_RESET: R1078.1, TP324.1, U337.15
WIFI_HL_RESET_1V8: R445.1, U337.6
WIFI_I2C0_CLK: CN310.3, CN400.4, R461.2, R463.1, R794.1, U1000.26
WIFI_I2C0_DATA: CN310.1, CN400.2, R460.2, R462.1, R793.1, R796.1, U1000.28
WIFI_UART0_RX: U302.8, U304.3, U1000.7
WIFI_UART0_TX: U302.4, U302.9, U304.2, U304.5, U304.6, U307.15, U1000.8
WIFI_UART1_CTS: TP328.1, U337.17, U1020.5
WIFI_UART1_CTS_MTK: U1000.50, U1020.3
WIFI_UART1_RTS: TP327.1, U337.16, U1020.6
WIFI_UART1_RTS_MTK: R1000.1, R1079.1, U1000.52, U1020.2
WIFI_UART1_RX: U337.19, U1010.5
WIFI_UART1_RX_MTK: U1000.54, U1010.3
WIFI_UART1_TX: R754.1, TP325.1, U337.18, U1010.6
WIFI_UART1_TX_MTK: R1003.2, SW401.2, U1000.53, U1010.2
WP_GPIO_1: J200.148, U306.3
WP_GPIO_1_lvl: CN307.11, U306.18
WP_GPIO_2: C227.1, J200.149, U306.4
WP_GPIO_2_lvl: CN307.13, U306.17
WP_GPIO_3: J200.150, U306.2
WP_GPIO_3_lvl: CN307.7, U306.19
WP_GPIO_4_Wakeable: CN312.1, J200.92, R732.1
WP_GPIO_5_Wakeable: CN312.3, J200.102, R733.1
WP_GPIO_7: J200.100, U306.7
WP_GPIO_7_lvl: Q405.5, U306.14
WP_GPIO_8: J200.101, U306.6
WP_GPIO_8_lvl: CN307.15, U306.15
WP_LowPower_Reset: R404.2, R432.1, SW401.9, U402.2
W_DISABLE_N: C230.1, J200.151
