leoheck/mangoh-red/(commit log)

2018-08-01 Add schematics
    [audio.sch, battery_charger_usb_power.sch, cf3_socket.sch, mangoh_red_board.sch, power_supply.sch, reset_ctrl_switch_i2c_hub.sch, rf_usb_iot_connectors.sch, simcard_sdcard_sdio_mux.sch]
2018-08-01 Add symbols/footprints paths
2018-08-01 Add initial layout
    [mangoh_red_board.kicad_pcb]
2018-08-01 Initial board outline
2018-08-01 Fix 3dparts references
    [mangoh_red_board.kicad_pcb]
2018-08-01 Refactor main filenames
    [mangoh-red.kicad_pcb, mangoh-red.sch]
2018-08-01 Removing files with old names
    [mangoh_red_board.kicad_pcb, mangoh_red_board.sch]
2018-08-03 Refactor footprints
    [audio.sch, battery_charger_usb_power.sch, power_supply.sch, reset_ctrl_switch_i2c_hub.sch, rf_usb_iot_connectors.sch, simcard_sdcard_sdio_mux.sch, usb_hub_gpio_expander_ftdi_conv.sch, wifi_bluetooth.sch]
2018-08-03 Refactor footprints and paths
    [mangoh-red.kicad_pcb]
2018-08-03 Add testpoint footprints
2018-08-03 Updating tespoints and other parts
    [audio.sch, battery_charger_usb_power.sch, cf3_socket.sch, power_supply.sch, reset_ctrl_switch_i2c_hub.sch, rf_usb_iot_connectors.sch, simcard_sdcard_sdio_mux.sch, usb_hub_gpio_expander_ftdi_conv.sch]
2018-08-03 Add initial version of missing footprints
2018-08-03 Footprint renamed
2018-08-03 Change custom footprints references
    [audio.sch, battery_charger_usb_power.sch, cf3_socket.sch, power_supply.sch, reset_ctrl_switch_i2c_hub.sch, rf_usb_iot_connectors.sch, simcard_sdcard_sdio_mux.sch, usb_hub_gpio_expander_ftdi_conv.sch]
2018-08-03 Add footprint
    [battery_charger_usb_power.sch, power_supply.sch, rf_usb_iot_connectors.sch]
2018-08-03 Add datasheet
    [simcard_sdcard_sdio_mux.sch]
2019-05-07 Footprint for WP Snap In from SnapEDA
2019-05-07 Remove old (unfinished) footprint
2019-05-07 Update the footprint of the main IC
    [cf3_socket.sch]
2019-05-07 Add gitattributes to filter some kicad noise
2019-05-07 Update file versions
    [audio.sch, battery_charger_usb_power.sch, power_supply.sch, reset_ctrl_switch_i2c_hub.sch, rf_usb_iot_connectors.sch, simcard_sdcard_sdio_mux.sch, usb_hub_gpio_expander_ftdi_conv.sch, wifi_bluetooth.sch]
2019-05-07 Minor placement update
    [mangoh-red.sch]
2019-05-07 Update the main component
    [mangoh-red.kicad_pcb]
2019-05-07 Map its 3d model to the footprint
2019-05-07 Change some pin names to match the schematic and also remove unecessary polygons
2019-05-07 Update footprints
    [battery_charger_usb_power.sch, cf3_socket.sch, power_supply.sch, reset_ctrl_switch_i2c_hub.sch, rf_usb_iot_connectors.sch, simcard_sdcard_sdio_mux.sch]
2019-05-07 Add MPNX field
    [audio.sch, battery_charger_usb_power.sch, cf3_socket.sch, power_supply.sch, reset_ctrl_switch_i2c_hub.sch, rf_usb_iot_connectors.sch, simcard_sdcard_sdio_mux.sch, usb_hub_gpio_expander_ftdi_conv.sch]
2019-05-07 Replace MPNX partnumbers
    [audio.sch, battery_charger_usb_power.sch, cf3_socket.sch, power_supply.sch, reset_ctrl_switch_i2c_hub.sch, rf_usb_iot_connectors.sch, simcard_sdcard_sdio_mux.sch, usb_hub_gpio_expander_ftdi_conv.sch]
2019-05-07 Fix some MPNs
    [battery_charger_usb_power.sch, power_supply.sch, usb_hub_gpio_expander_ftdi_conv.sch]
2019-05-07 Fix some footprints
    [battery_charger_usb_power.sch, power_supply.sch, rf_usb_iot_connectors.sch, wifi_bluetooth.sch]
2019-05-07 Add new footprints files, they still need to inspected
2019-05-07 Update MPNs and footprints
    [audio.sch, battery_charger_usb_power.sch, cf3_socket.sch, power_supply.sch, reset_ctrl_switch_i2c_hub.sch, rf_usb_iot_connectors.sch, simcard_sdcard_sdio_mux.sch, usb_hub_gpio_expander_ftdi_conv.sch]
2019-05-07 Add board to svg plugin
2019-05-07 Create svg board (back and front)
2019-05-07 Add version back
    [audio.sch, battery_charger_usb_power.sch, cf3_socket.sch, mangoh-red.sch, power_supply.sch, reset_ctrl_switch_i2c_hub.sch, rf_usb_iot_connectors.sch, simcard_sdcard_sdio_mux.sch]
2019-05-07 Replace wrl models by step models
    [mangoh-red.kicad_pcb]
2019-05-08 Many updates
    [audio.sch, battery_charger_usb_power.sch, cf3_socket.sch, mangoh-red.sch, power_supply.sch, reset_ctrl_switch_i2c_hub.sch, rf_usb_iot_connectors.sch, simcard_sdcard_sdio_mux.sch]
2019-05-08 Save Edge.cut visible
    [mangoh-red.kicad_pcb]
2019-05-08 Update some footprints
    [audio.sch, battery_charger_usb_power.sch, cf3_socket.sch, mangoh-red.sch, power_supply.sch, reset_ctrl_switch_i2c_hub.sch, rf_usb_iot_connectors.sch, simcard_sdcard_sdio_mux.sch]
2019-05-09 Update models and parts placement
    [mangoh-red.kicad_pcb]
2019-05-09 Add footprint with board outline
2019-05-09 Update footprint
2019-05-09 Add footprints and 3d models
2019-05-09 Add new footprints to fix orientation
2019-05-10 Update usb mini footprint
    [rf_usb_iot_connectors.sch]
2019-05-10 Update antenna footprint
2019-05-18 BOM from Mangoh Board
    [parts_with_price.csv]
2019-05-18 Add docs
    [mangoh-red.kicad_pcb]
2019-05-18 Add URL and the current price
    [audio.sch, battery_charger_usb_power.sch, cf3_socket.sch, power_supply.sch, reset_ctrl_switch_i2c_hub.sch, rf_usb_iot_connectors.sch, simcard_sdcard_sdio_mux.sch, usb_hub_gpio_expander_ftdi_conv.sch]
2019-05-18 Add extra symbols for WP snap in IC and COVER.
    [cf3_socket.sch]
2019-05-18 Add the missing WP7702 module
    [cf3_socket.sch]
2019-05-18 Add extra files
    [mangoh-red.kicad_pcb]
2019-05-20 Update 3d models
    [mangoh-red.kicad_pcb]
